caoguangcheng9-lgtm/begapunk-website/images/applications/laser-tube-cutting/laser-tube-rear-chuck-assembly-lineup.webp

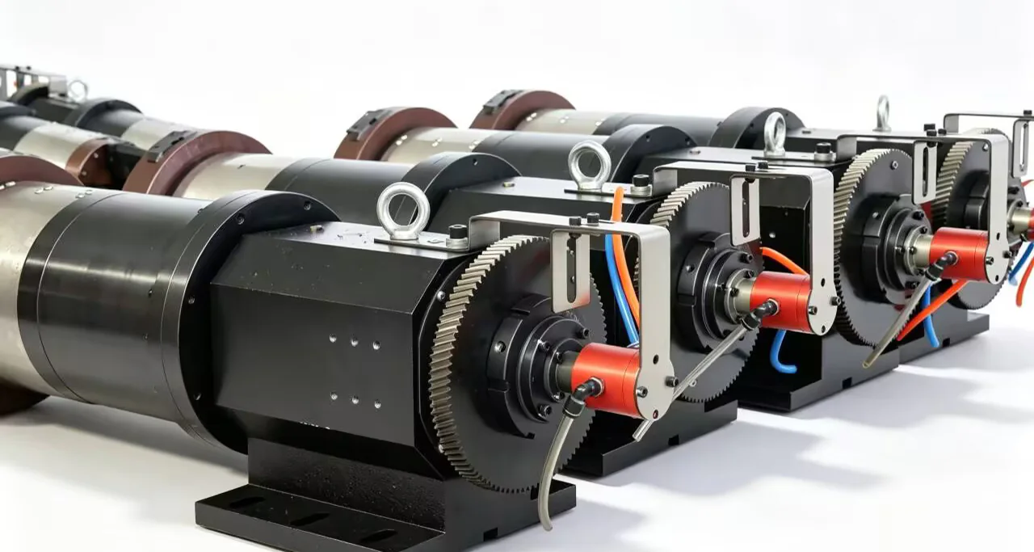
images/applications/laser-tube-cutting/laser-tube-rear-chuck-assembly-lineup.webp
