caoguangcheng9-lgtm/begapunk-website/README.md

# Project: Begapunk Website

Website: https://begapunk.com

Product: Air Rotary Union / Pneumatic Rotary Joint

Goal: Build Begapunk as an air rotary union specialist website for global B2B customers.

## Main Sections

- Home
- Products
- Applications
- Technology
- Knowledge Center
- About
- Contact
