caoguangcheng9-lgtm/begapunk-website/audit/geo-remediation/phase-1c-a2/phase-1c-a2-report.md

# Begapunk GEO Phase 1C-A.2 Report

## Scope

- Starting commit: `10370306e879dcfa0ff9d7f8911efcd6d111674c`
- Branch: `geo-phase-1c-a2-contextual-guidance`
- Formal website pages changed: 5
- Semantic records corrected: 16
- Pages or assets deleted: 0
- Push/deployment: none

## P1B-037 Selection Boundary

**Before:** An integrated pneumatic and electrical solution may be considered when the required air passages and electrical circuits exceed the capacity of a pneumatic-only rotary union.

**After:** A separate pneumatic rotary union and slip ring may be suitable when the pneumatic and electrical functions can be packaged independently and the available installation space supports two components. An integrated pneumatic-electrical solution may be considered when a single compact assembly, coordinated mounting, or a higher combined channel density is required. Final selection depends on the pneumatic passage count, bore requirements, electrical circuits, signal type, speed, installation envelope, and service access.

Result: the independent and integrated solution boundaries are both present without claiming that either is universally better or cheaper.

## Approved Record Changes

| # | Claim | Page | Before | After |
|---:|---|---|---|---|
| 1 | `P1B-037` | `application-automation-rotary-tables.html` | An integrated pneumatic and electrical solution may be considered when the required air passages and electrical circuits exceed the capacity of a pneumatic-only rotary union. | A separate pneumatic rotary union and slip ring may be suitable when the pneumatic and electrical functions can be packaged independently and the available installation space supports two components. An integrated pneumatic-electrical solution may be considered when a single compact assembly, coordinated mounting, or a higher combined channel density is required. Final selection depends on the pneumatic passage count, bore requirements, electrical circuits, signal type, speed, installation envelope, and service access. |
| 2 | `P1B-015` | `application-automation-rotary-tables.html` | <strong>Continuous rotation (PTFE seals):</strong> Set the inspection and replacement interval from actual duty cycle, medium, filtration, temperature, pressure, speed, observed wear, and inspection records. | <strong>Continuous rotation (PTFE seals):</strong> For continuous rotation, establish the inspection and replacement interval from accumulated runtime, operating speed, temperature, medium, leakage trend, operating torque, and seal condition recorded during planned stops. |
| 3 | `P1B-016` | `application-automation-rotary-tables.html` | <strong>Indexing tables (FKM seals):</strong> Set the inspection and replacement interval from actual duty cycle, medium, filtration, temperature, pressure, speed, observed wear, and inspection records. | <strong>Indexing tables (FKM seals):</strong> For indexing service, establish the interval from stop-start cycle count, pressure variation, alignment, temperature, leakage trend, and observed seal wear. |
| 4 | `P1B-017` | `application-automation-rotary-tables.html` | <strong>High-cycle lines (>200 RPM, 24/7):</strong> Set the inspection and replacement interval from actual duty cycle, medium, filtration, temperature, pressure, speed, observed wear, and inspection records. | <strong>High-cycle lines (>200 RPM, 24/7):</strong> For high-speed continuous service, determine inspection frequency from accumulated runtime, actual speed, temperature, leakage trend, torque trend, and planned maintenance records. |
| 5 | `P1B-015` | `application-bottle-filling-capping.html` | <strong>Food-grade PTFE seals:</strong> Set the inspection and replacement interval from actual duty cycle, medium, filtration, temperature, pressure, speed, observed wear, and inspection records. | <strong>Food-grade PTFE seals:</strong> For food-grade PTFE sealing configurations, set the inspection interval from sanitation procedures, medium compatibility, cleaning temperature, operating duty, leakage observations, and documented inspection results. |
| 6 | `P1B-016` | `application-bottle-filling-capping.html` | <strong>Food-grade FKM seals:</strong> Set the inspection and replacement interval from actual duty cycle, medium, filtration, temperature, pressure, speed, observed wear, and inspection records. | <strong>Food-grade FKM seals:</strong> For food-grade FKM sealing configurations, set the interval from the cleaning process, medium, temperature exposure, operating cycles, leakage observations, and documented seal condition. |
| 7 | `P1B-016` | `application-bottle-filling-capping.html` | <strong>Steam sterilization lines:</strong> Set the inspection and replacement interval from actual duty cycle, medium, filtration, temperature, pressure, speed, observed wear, and inspection records. | <strong>Steam sterilization lines:</strong> For steam-sterilized applications, review seal condition in relation to sterilization-cycle count, temperature exposure, medium, pressure, and documented inspection results. |
| 8 | `P1B-015` | `application-packaging-machinery.html` | <strong>PTFE seals:</strong> Set the inspection and replacement interval from actual duty cycle, medium, filtration, temperature, pressure, speed, observed wear, and inspection records. | <strong>PTFE seals:</strong> For PTFE sealing configurations in packaging machinery, determine the interval from machine cycle count, medium, pressure, speed, temperature, leakage trend, and inspection history. |
| 9 | `P1B-016` | `application-packaging-machinery.html` | <strong>FKM seals:</strong> Set the inspection and replacement interval from actual duty cycle, medium, filtration, temperature, pressure, speed, observed wear, and inspection records. | <strong>FKM seals:</strong> For FKM sealing configurations, determine the interval from operating cycles, medium compatibility, temperature, pressure variation, leakage observations, and recorded seal condition. |
| 10 | `P1B-016` | `application-packaging-machinery.html` | <strong>Food-grade lines:</strong> Set the inspection and replacement interval from actual duty cycle, medium, filtration, temperature, pressure, speed, observed wear, and inspection records. | <strong>Food-grade lines:</strong> For food-grade lines, align inspection and replacement decisions with the site's sanitation procedure, operating conditions, contamination-control requirements, and documented inspection results. |
| 11 | `P1B-017` | `application-pneumatic-tools-hose-anti-twist.html` | <strong>High-frequency line (2 shifts, 1,000+ cycles/day):</strong> Set the inspection and replacement interval from actual duty cycle, medium, filtration, temperature, pressure, speed, observed wear, and inspection records. | <strong>High-frequency line (2 shifts, 1,000+ cycles/day):</strong> For high-frequency tool use, base the inspection interval on cycle count, hose movement, side load, swivel torque, contamination, leakage observations, and maintenance records. |
| 12 | `P1B-025` | `application-pneumatic-tools-hose-anti-twist.html` | <strong>8-hour shift, 400–600 cycles/day:</strong> Set the inspection and replacement interval from actual duty cycle, medium, filtration, temperature, pressure, speed, observed wear, and inspection records. | <strong>8-hour shift, 400–600 cycles/day:</strong> For regular shift operation, determine the interval from actual cycle count, task duration, hose routing, side load, swivel movement, leakage observations, and recorded condition. |
| 13 | `P1B-048` | `application-pneumatic-tools-hose-anti-twist.html` | <strong>Maintenance or occasional use:</strong> Set the inspection and replacement interval from actual duty cycle, medium, filtration, temperature, pressure, speed, observed wear, and inspection records. | <strong>Maintenance or occasional use:</strong> For occasional-use tools, inspect the swivel before return to service and determine replacement from storage conditions, contamination, hose load, movement quality, leakage observations, and seal condition. |
| 14 | `P1B-017` | `application-robot-end-of-arm-tooling.html` | <strong>Standard duty (8-hour shift, 30 cycles/min):</strong> Set the inspection and replacement interval from actual duty cycle, medium, filtration, temperature, pressure, speed, observed wear, and inspection records. | <strong>Standard duty (8-hour shift, 30 cycles/min):</strong> For standard robot duty, determine the interval from actual cycle count, wrist motion, hose routing, payload effects, swivel torque, leakage observations, and inspection records. |
| 15 | `P1B-017` | `application-robot-end-of-arm-tooling.html` | <strong>High-cycle lines (24/7, 60 cycles/min):</strong> Set the inspection and replacement interval from actual duty cycle, medium, filtration, temperature, pressure, speed, observed wear, and inspection records. | <strong>High-cycle lines (24/7, 60 cycles/min):</strong> For high-cycle robot duty, determine inspection frequency from accumulated cycles, continuous runtime, wrist motion, temperature, torque trend, leakage trend, and planned maintenance records. |
| 16 | `P1B-039` | `application-robot-end-of-arm-tooling.html` | <strong>Clean assembly (electronics, medical):</strong> Set the inspection and replacement interval from actual duty cycle, medium, filtration, temperature, pressure, speed, observed wear, and inspection records. | <strong>Clean assembly (electronics, medical):</strong> For clean-assembly applications, set the interval from contamination-control procedures, process requirements, operating cycles, leakage observations, and documented inspection results. |

All 15 maintenance entries now retain their application context. No fixed month, hour, service-life guarantee, replacement cycle, or new numeric claim was added. The 15 approved maintenance sentences are unique.

## Browser Rendering Acceptance

- Pages rendered from a server bound only to `127.0.0.1`: 5 / 5.
- Approved changed texts visible: 16 / 16.
- Maintenance lists: three complete and unique entries on each page.
- Horizontal overflow, raw HTML text, and broken images: none.
- FAQ visible/schema mismatches: none.
- Titles, H1 headings, and maintenance sections remained coherent and visible.
- Full-page screenshots rendered successfully for all five pages.

## Unverified Context Labels

- Labels retained but not validated by this phase: 5.
- Numeric fragments include `>200 RPM`, `24/7`, shift counts, cycles/day, and cycles/minute.
- Their retention does not establish accuracy. Each requires engineering records or authoritative industry evidence.
- Details: `unverified-context-labels.csv`.

## Pre-existing JavaScript Errors

- Affected unchanged blog pages: 4.
- Exact error: `SyntaxError: Unexpected token ','` at an orphaned `, 2000);` line in each page's final inline script.
- Visible article content renders, but the affected inline block does not execute; mobile menu and copy-link behavior are impacted, with header scroll styling additionally impacted on three pages.
- These four pages were diagnosed only and were not modified.
- Details: `pre-existing-js-errors.csv`.

## Full-site Protection Validation

- HTML: pass (51 pages).
- JSON-LD: pass (57 blocks).
- Local links, images, and downloads: pass (0 broken).
- FAQ visible content and FAQPage JSON-LD: pass.
- Product Schema: unchanged across all pages.
- Product pressure, speed, temperature, weight, material, and dimensional parameters: unchanged; exact reverse-replacement comparison passed for all five modified pages.
- Company, certification, delivery, and shipment data: unchanged.
- Sitemap: unchanged; 48 URLs.
- Existing fact conflicts: 17, unchanged.
- Formal website files changed outside the approved five pages: 0.
- Deleted pre-task files: 0.

No HTML page, image, PDF, or download file was deleted.
