caoguangcheng9-lgtm/begapunk-website/audit/geo-remediation/phase-1c-a1/phase-1c-a1-report.md

# Begapunk GEO Phase 1C-A.1 Report

## Scope

- Starting commit: `4eaa1e96ea98e54519b1f44b6525b97bcac363bb`
- Branch: `geo-phase-1c-a1-semantic-qa`
- Formal website pages changed: 3
- Pages deleted: 0
- Push/deployment: none

## Three Semantic Corrections

### `BP-2P-30-0001.html` — Product overview

**Phase 1C-A wording:** Pressure and leakage checks are specified by model. Confirm the applicable test pressure, duration, and acceptance criteria with Begapunk before ordering.

**Phase 1C-A.1 wording:** The sealing configuration may be suitable for selected air, water, or coolant applications, subject to medium compatibility, temperature, pressure, speed, and the approved specification for the selected version. Pressure and leakage test conditions should be confirmed before ordering.

Result: restores the medium-compatibility and sealing topic without claiming universal compatibility, zero leakage, or a guarantee.

### `applications.html` — Application guidance

**Phase 1C-A wording:** Pressure and leakage checks are specified by model. Confirm the applicable test pressure, duration, and acceptance criteria with Begapunk before ordering.

**Phase 1C-A.1 wording:** Each channel should be specified with an application-appropriate isolation and allowable cross-port leakage criterion. Confirm the channel-isolation test conditions and acceptance limits for the selected model.

Result: restores channel isolation and cross-port leakage as the engineering topic without inventing a leakage rate.

### `BP-8P-0001.html` — Material FAQ

**Phase 1C-A wording:** Pressure and leakage checks are specified by model. Confirm the applicable test pressure, duration, and acceptance criteria with Begapunk before ordering.

**Phase 1C-A.1 wording:** Seal material, sealing configuration, and pressure-test criteria should be confirmed for the selected version. Test pressure, duration, and acceptance limits may differ by configuration.

Result: restores the version-specific seal/test distinction without reinstating the unsupported common seal, 1.0 MPa, 60-second, or 100% test assertions.

## Real Rendering Acceptance

- Local server binding: `127.0.0.1` only.
- Target pages rendered in the in-app browser: 30 / 30.
- Phase 1C-A records checked in rendered content: 99 / 99.
- Product pages tested through their normal tabs: 16; all expected text became visible and each page retained one active/visible panel.
- FAQ interaction tested: the repair FAQ expanded and its answer was visible.
- Layout/entity/table failures: 0.
- Tab-state failures: 0.
- Lazy-loaded case-study images initially had incomplete state before scrolling; a full-page render loaded all four successfully. No missing image file was found by the source/resource validator.
- Four unchanged blog pages emitted a pre-existing inline JavaScript `SyntaxError: Unexpected token ','` warning during browser QA. Their page content still rendered, and these files are byte-unchanged in this branch; this is recorded for a later JavaScript repair task and was not changed outside scope.

## Visible Content Flag Review

- Phase 1C-A rows marked `visible_content_updated=no`: 12.
- Incorrect flags corrected by this audit: 11.
- Correct schema-only `no` flag retained: 1 (`P1B-059`, FAQPage JSON-LD).
- Detailed evidence: `visible-content-flag-review.csv`.

## Semantic Loss Review

- Records reviewed: 99.
- Approved semantic corrections completed: 3.
- New issue patterns recorded but not modified: 2, affecting 16 records.
- Pattern 1: one combined-utilities record weakens the separate-versus-integrated selection boundary.
- Pattern 2: 15 preventive-maintenance records repeat one generic condition-based sentence and lose entry-specific detail.
- Detailed review: `semantic-loss-review.csv`.

## Source Validation

- HTML: pass (51 pages).
- JSON-LD: pass (57 blocks).
- Local links, images, and downloadable resources: pass (0 broken).
- Product Schema: unchanged on 2 applicable changed product pages.
- Product specification tables: unchanged.
- Sitemap: unchanged; 48 URLs.
- Snapshot deletions: 0.
- Formal page changes outside the three approved pages: 0.

## Protected Facts and Remaining Conflicts

- Product engineering parameters were not changed.
- Certification, company, and delivery-time content was not changed.
- Unsupported absolute zero-leakage/testing promises were not restored.
- The existing 17 fact conflicts remain unresolved and unchanged.
- No HTML page, image, PDF, or download file was deleted.
