caoguangcheng9-lgtm/begapunk-website/audit/geo-remediation/phase-1c-a/phase-1c-a-report.md

# Begapunk GEO Phase 1C-A Report

## Scope Summary

- Modified HTML pages: 30
- Modified allowed claim IDs: 30
- Skipped allowed claim IDs: 0
- Deleted pages: 0
- Detailed replacement records: 99
- Product engineering parameters changed: no
- Certification or company data changed: no
- Delivery-time, return-policy, warranty, sitemap, robots.txt, llms.txt, CSS, JavaScript, PHP, and server configuration changes: none

## Claim-by-Claim Changes

### P1B-004

- Page: `about.html`
- Section: RFQ call to action
- Before: Tell us your requirements and we'll provide a quote within 24 hours.
- After: Begapunk aims to respond promptly to complete technical inquiries. Response time depends on the application complexity and the information provided.
- Visible content updated: yes; FAQ/JSON-LD updated: no

- Page: `case-studies.html`
- Section: RFQ call to action
- Before: Tell us your requirements and we'll provide a quote within 24 hours.
- After: Begapunk aims to respond promptly to complete technical inquiries. Response time depends on the application complexity and the information provided.
- Visible content updated: yes; FAQ/JSON-LD updated: no

- Page: `contact.html`
- Section: RFQ introduction
- Before: Begapunk engineers will check pressure, RPM, media, mounting, passage layout, and reply within 24 hours.
- After: Begapunk aims to respond promptly to complete technical inquiries. Response time depends on the application complexity and the information provided.
- Visible content updated: yes; FAQ/JSON-LD updated: no

- Page: `contact.html`
- Section: Contact method
- Before: Fastest response &mdash; we reply within 24 hours
- After: Begapunk aims to respond promptly to complete technical inquiries. Response time depends on the application complexity and the information provided.
- Visible content updated: no; FAQ/JSON-LD updated: no

- Page: `contact.html`
- Section: RFQ form note
- Before: Typical response time: 24 hours.
- After: Response time depends on the application complexity and the information provided.
- Visible content updated: yes; FAQ/JSON-LD updated: no

- Page: `faq.html`
- Section: Quotation FAQ
- Before: Most quotes are returned within 24 hours.
- After: Begapunk aims to respond promptly to complete technical inquiries. Response time depends on the application complexity and the information provided.
- Visible content updated: yes; FAQ/JSON-LD updated: no

- Page: `faq.html`
- Section: Quotation process
- Before: You send requirements &rarr; We provide a detailed quote within 24 hours
- After: You send complete requirements &rarr; Begapunk reviews the application and responds based on its complexity and the information provided.
- Visible content updated: no; FAQ/JSON-LD updated: no

- Page: `blog-rotary-joint-selection.html`
- Section: Selection guide call to action
- Before: Send us your operating conditions — pressure, RPM, media type, and channel count — and our engineers will return a spec recommendation within 24 hours.
- After: Send us your operating conditions — pressure, RPM, media type, and channel count — for engineering review. Response time depends on the application complexity and the information provided.
- Visible content updated: yes; FAQ/JSON-LD updated: no

### P1B-006

- Page: `BP-1P-0003.html`
- Section: Application fit introduction
- Before: Below are the machine types where this model performs best — and the conditions where you should consider upgrading to a multi-passage joint.
- After: This model may be suitable for the listed applications when its passage count, mounting, medium, pressure, speed, and temperature limits match the machine requirements.
- Visible content updated: yes; FAQ/JSON-LD updated: no

- Page: `BP-1P-0006.html`
- Section: Application fit introduction
- Before: Below are the machine types where this model performs best — and the conditions where you should consider a multi-inlet design.
- After: This model may be suitable for the listed applications when its passage count, mounting, medium, pressure, speed, and temperature limits match the machine requirements.
- Visible content updated: yes; FAQ/JSON-LD updated: no

- Page: `BP-2P-0001.html`
- Section: Application fit introduction
- Before: Below are the machine types where this model performs best — and the conditions where you should consider upgrading to a multi-passage or higher-pressure joint.
- After: This model may be suitable for the listed applications when its passage count, mounting, medium, pressure, speed, and temperature limits match the machine requirements.
- Visible content updated: yes; FAQ/JSON-LD updated: no

- Page: `BP-2P-0002.html`
- Section: Application fit introduction
- Before: Below are the machine types where this model performs best.
- After: This model may be suitable for the listed applications when its passage count, mounting, medium, pressure, speed, and temperature limits match the machine requirements.
- Visible content updated: yes; FAQ/JSON-LD updated: no

- Page: `BP-2P-08-0001.html`
- Section: Application fit introduction
- Before: Below are the machine types where this model performs best.
- After: This model may be suitable for the listed applications when its passage count, mounting, medium, pressure, speed, and temperature limits match the machine requirements.
- Visible content updated: yes; FAQ/JSON-LD updated: no

- Page: `BP-2P-130-0001.html`
- Section: Application fit introduction
- Before: Below are the machine types where this model performs best — and the conditions where you should consider upgrading to a higher-pressure or dust-proof joint.
- After: This model may be suitable for the listed applications when its passage count, mounting, medium, pressure, speed, and temperature limits match the machine requirements.
- Visible content updated: yes; FAQ/JSON-LD updated: no

- Page: `BP-2P-16-0001.html`
- Section: Application fit introduction
- Before: Below are the machine types where this model performs best &mdash; and the conditions where you should consider upgrading to a larger-bore or higher-speed joint.
- After: This model may be suitable for the listed applications when its passage count, mounting, medium, pressure, speed, and temperature limits match the machine requirements.
- Visible content updated: no; FAQ/JSON-LD updated: no

- Page: `BP-2P-30-0001.html`
- Section: Application fit introduction
- Before: Below are the machine types where this model performs best &mdash; and the conditions where you should consider upgrading to a higher-capacity joint.
- After: This model may be suitable for the listed applications when its passage count, mounting, medium, pressure, speed, and temperature limits match the machine requirements.
- Visible content updated: no; FAQ/JSON-LD updated: no

- Page: `BP-2P-50-0001.html`
- Section: Application fit introduction
- Before: Below are the machine types where this model performs best &mdash; and the conditions where you should consider upgrading to a higher-pressure or stainless-steel joint.
- After: This model may be suitable for the listed applications when its passage count, mounting, medium, pressure, speed, and temperature limits match the machine requirements.
- Visible content updated: no; FAQ/JSON-LD updated: no

- Page: `BP-2P-95-0001.html`
- Section: Application fit introduction
- Before: Below are the machine types where this model performs best &mdash; and the conditions where you should consider a custom design.
- After: This model may be suitable for the listed applications when its passage count, mounting, medium, pressure, speed, and temperature limits match the machine requirements.
- Visible content updated: no; FAQ/JSON-LD updated: no

- Page: `BP-3P-0004.html`
- Section: Application fit introduction
- Before: Below are the machine types where this model performs best — and the conditions where you should consider upgrading to a higher-passage or dust-proof joint.
- After: This model may be suitable for the listed applications when its passage count, mounting, medium, pressure, speed, and temperature limits match the machine requirements.
- Visible content updated: yes; FAQ/JSON-LD updated: no

- Page: `BP-3P-0006.html`
- Section: Application fit introduction
- Before: Below are the machine types where this model performs best.
- After: This model may be suitable for the listed applications when its passage count, mounting, medium, pressure, speed, and temperature limits match the machine requirements.
- Visible content updated: yes; FAQ/JSON-LD updated: no

- Page: `BP-3P-0007.html`
- Section: Application fit introduction
- Before: Below are the machine types where this model performs best.
- After: This model may be suitable for the listed applications when its passage count, mounting, medium, pressure, speed, and temperature limits match the machine requirements.
- Visible content updated: yes; FAQ/JSON-LD updated: no

- Page: `BP-4P-30-0001.html`
- Section: Application fit introduction
- Before: Below are the machine types where this model performs best.
- After: This model may be suitable for the listed applications when its passage count, mounting, medium, pressure, speed, and temperature limits match the machine requirements.
- Visible content updated: yes; FAQ/JSON-LD updated: no

- Page: `BP-8P-0001.html`
- Section: Application fit introduction
- Before: Below are the machine types where this model performs best.
- After: This model may be suitable for the listed applications when its passage count, mounting, medium, pressure, speed, and temperature limits match the machine requirements.
- Visible content updated: yes; FAQ/JSON-LD updated: no

### P1B-008

- Page: `BP-1P-0006.html`
- Section: Visible technical specifications
- Before: <tr><th>Leakage</th><td>Zero (100% pressure tested)</td></tr>
- After: <tr><th>Leakage acceptance</th><td>Specified by model; confirm test criteria before ordering.</td></tr>
- Visible content updated: yes; FAQ/JSON-LD updated: no

- Page: `BP-2P-0002.html`
- Section: Visible technical specifications
- Before: <tr><th>Leakage</th><td>Zero (100% pressure tested)</td></tr>
- After: <tr><th>Leakage acceptance</th><td>Specified by model; confirm test criteria before ordering.</td></tr>
- Visible content updated: yes; FAQ/JSON-LD updated: no

- Page: `BP-2P-30-0001.html`
- Section: Visible technical specifications
- Before: <tr><th>Leakage</th><td>Zero (100% pressure tested)</td></tr>
- After: <tr><th>Leakage acceptance</th><td>Specified by model; confirm test criteria before ordering.</td></tr>
- Visible content updated: yes; FAQ/JSON-LD updated: no

- Page: `BP-3P-0007.html`
- Section: Visible technical specifications
- Before: <tr><th>Leakage</th><td>Zero (100% pressure tested)</td></tr>
- After: <tr><th>Leakage acceptance</th><td>Specified by model; confirm test criteria before ordering.</td></tr>
- Visible content updated: yes; FAQ/JSON-LD updated: no

- Page: `BP-3P-S06-0001.html`
- Section: Visible technical specifications
- Before: <tr><th>Leakage</th><td>Zero leakage (100% pressure tested)</td></tr>
- After: <tr><th>Leakage acceptance</th><td>Specified by model; confirm test criteria before ordering.</td></tr>
- Visible content updated: yes; FAQ/JSON-LD updated: no

- Page: `BP-2P-30-0001.html`
- Section: Product overview
- Before: The PTFE composite seal provides chemical resistance across air, water, and coolant media with zero leakage guaranteed from 100% pressure testing.
- After: Pressure and leakage checks are specified by model. Confirm the applicable test pressure, duration, and acceptance criteria with Begapunk before ordering.
- Visible content updated: yes; FAQ/JSON-LD updated: no

- Page: `BP-3P-0007.html`
- Section: Key benefits
- Before: Each unit is 100% pressure tested to zero leakage before shipment, ensuring reliable operation in critical automation cells
- After: Pressure and leakage checks are specified by model. Confirm the applicable test pressure, duration, and acceptance criteria with Begapunk before ordering.
- Visible content updated: yes; FAQ/JSON-LD updated: no

- Page: `BP-3P-0007.html`
- Section: Material FAQ
- Before: Each unit is 100% pressure tested to zero leakage before shipment as part of the custom order process.
- After: Pressure and leakage checks are specified by model. Confirm the applicable test pressure, duration, and acceptance criteria with Begapunk before ordering.
- Visible content updated: yes; FAQ/JSON-LD updated: no

- Page: `applications.html`
- Section: Application guidance
- Before: Each channel must be mechanically isolated with zero leakage tolerance.
- After: Pressure and leakage checks are specified by model. Confirm the applicable test pressure, duration, and acceptance criteria with Begapunk before ordering.
- Visible content updated: yes; FAQ/JSON-LD updated: no

### P1B-009

- Page: `BP-2P-30-0001.html`
- Section: Key benefits
- Before: <strong>Zero leakage from 100% pressure testing:</strong> Every unit is tested at 1.0 MPa before shipment &mdash; no drip, no bubble, no pressure decay
- After: <strong>Model-specific pressure and leakage checks:</strong> Pressure and leakage checks are specified by model. Confirm the applicable test pressure, duration, and acceptance criteria with Begapunk before ordering.
- Visible content updated: no; FAQ/JSON-LD updated: no

- Page: `BP-3P-S06-0001.html`
- Section: Key benefits
- Before: <strong>Zero leakage guarantee:</strong> Every unit is 100% pressure tested before shipment at 1.0 MPa for 60 seconds &mdash; no leaks, no exceptions
- After: <strong>Model-specific pressure and leakage checks:</strong> Pressure and leakage checks are specified by model. Confirm the applicable test pressure, duration, and acceptance criteria with Begapunk before ordering.
- Visible content updated: no; FAQ/JSON-LD updated: no

- Page: `BP-8P-0001.html`
- Section: Material FAQ
- Before: Both versions use the same PTFE composite seal and are 100% pressure tested at 1.0 MPa for 60 seconds before shipment.
- After: Pressure and leakage checks are specified by model. Confirm the applicable test pressure, duration, and acceptance criteria with Begapunk before ordering.
- Visible content updated: yes; FAQ/JSON-LD updated: no

### P1B-011

- Page: `BP-1P-0006.html`
- Section: Installation or misuse example
- Before: Within 48 hours, air leaks at 0.3 MPa from the seal interface.
- After: Incorrect installation or operation outside the specified limits can cause premature leakage. Failure timing depends on alignment, medium, pressure, speed, temperature, and duty cycle.
- Visible content updated: yes; FAQ/JSON-LD updated: no

- Page: `BP-2P-0002.html`
- Section: Installation or misuse example
- Before: Within 48 hours, air leaks at 0.3 MPa from the seal interface.
- After: Incorrect installation or operation outside the specified limits can cause premature leakage. Failure timing depends on alignment, medium, pressure, speed, temperature, and duty cycle.
- Visible content updated: yes; FAQ/JSON-LD updated: no

- Page: `BP-1P-0003.html`
- Section: Installation or misuse example
- Before: Within 48 hours, air leaks at 0.3 MPa.
- After: Incorrect installation or operation outside the specified limits can cause premature leakage. Failure timing depends on alignment, medium, pressure, speed, temperature, and duty cycle.
- Visible content updated: yes; FAQ/JSON-LD updated: no

- Page: `BP-3P-0006.html`
- Section: Installation or misuse example
- Before: Within 48 hours, air leaks at 0.3 MPa.
- After: Incorrect installation or operation outside the specified limits can cause premature leakage. Failure timing depends on alignment, medium, pressure, speed, temperature, and duty cycle.
- Visible content updated: yes; FAQ/JSON-LD updated: no

- Page: `BP-3P-0004.html`
- Section: Installation or misuse example
- Before: The AL6061 flange face warps by 0.08 mm, creating a leak path that sprays air at 0.8 MPa within 48 hours.
- After: Incorrect installation or operation outside the specified limits can cause premature leakage. Failure timing depends on alignment, medium, pressure, speed, temperature, and duty cycle.
- Visible content updated: yes; FAQ/JSON-LD updated: no

- Page: `BP-8P-0001.html`
- Section: Installation or misuse example
- Before: Within 48 hours, air bleeds from passage 3 into passage 5, causing pressure interference and dropped workpieces.
- After: Incorrect installation or operation outside the specified limits can cause premature leakage. Failure timing depends on alignment, medium, pressure, speed, temperature, and duty cycle.
- Visible content updated: yes; FAQ/JSON-LD updated: no

- Page: `BP-4P-30-0001.html`
- Section: Installation or misuse example
- Before: Within 48 hours, air leaks at 0.4 MPa.
- After: Incorrect installation or operation outside the specified limits can cause premature leakage. Failure timing depends on alignment, medium, pressure, speed, temperature, and duty cycle.
- Visible content updated: yes; FAQ/JSON-LD updated: no

- Page: `BP-2P-95-0001.html`
- Section: Installation or misuse example
- Before: Within 48 hours, the seal leaks at 6 MPa.
- After: Incorrect installation or operation outside the specified limits can cause premature leakage. Failure timing depends on alignment, medium, pressure, speed, temperature, and duty cycle.
- Visible content updated: yes; FAQ/JSON-LD updated: no

### P1B-015

- Page: `application-automation-rotary-tables.html`
- Section: Preventive replacement schedule
- Before: <li><strong>Continuous rotation (PTFE seals):</strong> Replace every 10–12 months</li>
- After: <li><strong>Continuous rotation (PTFE seals):</strong> Set the inspection and replacement interval from actual duty cycle, medium, filtration, temperature, pressure, speed, observed wear, and inspection records.</li>
- Visible content updated: yes; FAQ/JSON-LD updated: no

- Page: `application-bottle-filling-capping.html`
- Section: Preventive replacement schedule
- Before: <li><strong>Food-grade PTFE seals:</strong> Replace every 10–12 months on continuous-duty lines</li>
- After: <li><strong>Food-grade PTFE seals:</strong> Set the inspection and replacement interval from actual duty cycle, medium, filtration, temperature, pressure, speed, observed wear, and inspection records.</li>
- Visible content updated: yes; FAQ/JSON-LD updated: no

- Page: `application-packaging-machinery.html`
- Section: Preventive replacement schedule
- Before: <li><strong>PTFE seals:</strong> Replace every 10–12 months on continuous-duty lines</li>
- After: <li><strong>PTFE seals:</strong> Set the inspection and replacement interval from actual duty cycle, medium, filtration, temperature, pressure, speed, observed wear, and inspection records.</li>
- Visible content updated: yes; FAQ/JSON-LD updated: no

### P1B-016

- Page: `application-automation-rotary-tables.html`
- Section: Preventive replacement schedule
- Before: <li><strong>Indexing tables (FKM seals):</strong> Replace every 8–10 months on continuous-duty lines</li>
- After: <li><strong>Indexing tables (FKM seals):</strong> Set the inspection and replacement interval from actual duty cycle, medium, filtration, temperature, pressure, speed, observed wear, and inspection records.</li>
- Visible content updated: yes; FAQ/JSON-LD updated: no

- Page: `application-bottle-filling-capping.html`
- Section: Preventive replacement schedule
- Before: <li><strong>Food-grade FKM seals:</strong> Replace every 6 months (audit requirement)</li>
- After: <li><strong>Food-grade FKM seals:</strong> Set the inspection and replacement interval from actual duty cycle, medium, filtration, temperature, pressure, speed, observed wear, and inspection records.</li>
- Visible content updated: yes; FAQ/JSON-LD updated: no

- Page: `application-bottle-filling-capping.html`
- Section: Preventive replacement schedule
- Before: <li><strong>Steam sterilization lines:</strong> Replace every 6 months regardless of visible wear (thermal fatigue)</li>
- After: <li><strong>Steam sterilization lines:</strong> Set the inspection and replacement interval from actual duty cycle, medium, filtration, temperature, pressure, speed, observed wear, and inspection records.</li>
- Visible content updated: yes; FAQ/JSON-LD updated: no

- Page: `application-packaging-machinery.html`
- Section: Preventive replacement schedule
- Before: <li><strong>FKM seals:</strong> Replace every 6–8 months on continuous-duty lines</li>
- After: <li><strong>FKM seals:</strong> Set the inspection and replacement interval from actual duty cycle, medium, filtration, temperature, pressure, speed, observed wear, and inspection records.</li>
- Visible content updated: yes; FAQ/JSON-LD updated: no

- Page: `application-packaging-machinery.html`
- Section: Preventive replacement schedule
- Before: <li><strong>Food-grade lines:</strong> Replace every 6 months regardless of visible wear (audit requirement)</li>
- After: <li><strong>Food-grade lines:</strong> Set the inspection and replacement interval from actual duty cycle, medium, filtration, temperature, pressure, speed, observed wear, and inspection records.</li>
- Visible content updated: yes; FAQ/JSON-LD updated: no

### P1B-017

- Page: `application-automation-rotary-tables.html`
- Section: Preventive replacement schedule
- Before: <li><strong>High-cycle lines (>200 RPM, 24/7):</strong> Replace every 6–8 months</li>
- After: <li><strong>High-cycle lines (>200 RPM, 24/7):</strong> Set the inspection and replacement interval from actual duty cycle, medium, filtration, temperature, pressure, speed, observed wear, and inspection records.</li>
- Visible content updated: no; FAQ/JSON-LD updated: no

- Page: `application-pneumatic-tools-hose-anti-twist.html`
- Section: Preventive replacement schedule
- Before: <li><strong>High-frequency line (2 shifts, 1,000+ cycles/day):</strong> Replace every 5–6 months</li>
- After: <li><strong>High-frequency line (2 shifts, 1,000+ cycles/day):</strong> Set the inspection and replacement interval from actual duty cycle, medium, filtration, temperature, pressure, speed, observed wear, and inspection records.</li>
- Visible content updated: yes; FAQ/JSON-LD updated: no

- Page: `application-robot-end-of-arm-tooling.html`
- Section: Preventive replacement schedule
- Before: <li><strong>Standard duty (8-hour shift, 30 cycles/min):</strong> Replace every 10–12 months</li>
- After: <li><strong>Standard duty (8-hour shift, 30 cycles/min):</strong> Set the inspection and replacement interval from actual duty cycle, medium, filtration, temperature, pressure, speed, observed wear, and inspection records.</li>
- Visible content updated: yes; FAQ/JSON-LD updated: no

- Page: `application-robot-end-of-arm-tooling.html`
- Section: Preventive replacement schedule
- Before: <li><strong>High-cycle lines (24/7, 60 cycles/min):</strong> Replace every 6–8 months</li>
- After: <li><strong>High-cycle lines (24/7, 60 cycles/min):</strong> Set the inspection and replacement interval from actual duty cycle, medium, filtration, temperature, pressure, speed, observed wear, and inspection records.</li>
- Visible content updated: yes; FAQ/JSON-LD updated: no

### P1B-018

- Page: `application-packaging-machinery.html`
- Section: Cycle-life guidance and FAQ
- Before: Standard duty seals rated for 5,000 hours will fail in 6–8 weeks under this load.
- After: Operating beyond the seal's approved duty conditions can accelerate wear and lead to premature leakage. Actual service life depends on the medium, pressure, speed, temperature, alignment, filtration, and duty cycle.
- Visible content updated: yes; FAQ/JSON-LD updated: yes

- Page: `application-packaging-machinery.html`
- Section: Cycle-life guidance and FAQ
- Before: Standard seals rated for 5,000 hours fail in 6–8 weeks under this load.
- After: Operating beyond the seal's approved duty conditions can accelerate wear and lead to premature leakage. Actual service life depends on the medium, pressure, speed, temperature, alignment, filtration, and duty cycle.
- Visible content updated: yes; FAQ/JSON-LD updated: no

- Page: `application-packaging-machinery.html`
- Section: Cycle-life guidance and FAQ
- Before: Standard FKM seals rated for 5,000 hours will fail in 6–8 weeks.
- After: Operating beyond the seal's approved duty conditions can accelerate wear and lead to premature leakage. Actual service life depends on the medium, pressure, speed, temperature, alignment, filtration, and duty cycle.
- Visible content updated: yes; FAQ/JSON-LD updated: no

- Page: `application-packaging-machinery.html`
- Section: Cycle-life guidance and FAQ
- Before: Standard FKM seals rated for 5,000 hours fail in 6–8 weeks.
- After: Operating beyond the seal's approved duty conditions can accelerate wear and lead to premature leakage. Actual service life depends on the medium, pressure, speed, temperature, alignment, filtration, and duty cycle.
- Visible content updated: yes; FAQ/JSON-LD updated: no

### P1B-020

- Page: `BP-1P-0003.html`
- Section: 3D file FAQ
- Before: We do not post 3D files publicly to protect our designs, but every qualified inquiry receives the file within 24 hours.
- After: 3D files may be provided for qualified projects after the application requirements are reviewed. File availability and response time depend on the model and the project information provided.
- Visible content updated: yes; FAQ/JSON-LD updated: no

- Page: `BP-1P-0006.html`
- Section: 3D file FAQ
- Before: We do not post 3D files publicly to protect our designs, but every qualified inquiry receives the file within 24 hours.
- After: 3D files may be provided for qualified projects after the application requirements are reviewed. File availability and response time depend on the model and the project information provided.
- Visible content updated: yes; FAQ/JSON-LD updated: no

- Page: `BP-2P-0001.html`
- Section: 3D file FAQ
- Before: We do not post 3D files publicly to protect our designs, but every qualified inquiry receives the file within 24 hours.
- After: 3D files may be provided for qualified projects after the application requirements are reviewed. File availability and response time depend on the model and the project information provided.
- Visible content updated: yes; FAQ/JSON-LD updated: no

- Page: `BP-2P-0002.html`
- Section: 3D file FAQ
- Before: We do not post 3D files publicly to protect our designs, but every qualified inquiry receives the file within 24 hours.
- After: 3D files may be provided for qualified projects after the application requirements are reviewed. File availability and response time depend on the model and the project information provided.
- Visible content updated: yes; FAQ/JSON-LD updated: no

- Page: `BP-2P-08-0001.html`
- Section: 3D file FAQ
- Before: We do not post 3D files publicly to protect our designs, but every qualified inquiry receives the file within 24 hours.
- After: 3D files may be provided for qualified projects after the application requirements are reviewed. File availability and response time depend on the model and the project information provided.
- Visible content updated: yes; FAQ/JSON-LD updated: no

- Page: `BP-2P-130-0001.html`
- Section: 3D file FAQ
- Before: We do not post 3D files publicly to protect our designs, but every qualified inquiry receives the file within 24 hours.
- After: 3D files may be provided for qualified projects after the application requirements are reviewed. File availability and response time depend on the model and the project information provided.
- Visible content updated: yes; FAQ/JSON-LD updated: no

- Page: `BP-2P-16-0001.html`
- Section: 3D file FAQ
- Before: We do not post 3D files publicly to protect our designs, but every qualified inquiry receives the file within 24 hours.
- After: 3D files may be provided for qualified projects after the application requirements are reviewed. File availability and response time depend on the model and the project information provided.
- Visible content updated: yes; FAQ/JSON-LD updated: no

- Page: `BP-2P-30-0001.html`
- Section: 3D file FAQ
- Before: We do not post 3D files publicly to protect our designs, but every qualified inquiry receives the file within 24 hours.
- After: 3D files may be provided for qualified projects after the application requirements are reviewed. File availability and response time depend on the model and the project information provided.
- Visible content updated: yes; FAQ/JSON-LD updated: no

- Page: `BP-2P-50-0001.html`
- Section: 3D file FAQ
- Before: We do not post 3D files publicly to protect our designs, but every qualified inquiry receives the file within 24 hours.
- After: 3D files may be provided for qualified projects after the application requirements are reviewed. File availability and response time depend on the model and the project information provided.
- Visible content updated: yes; FAQ/JSON-LD updated: no

- Page: `BP-2P-95-0001.html`
- Section: 3D file FAQ
- Before: We do not post 3D files publicly to protect our designs, but every qualified inquiry receives the file within 24 hours.
- After: 3D files may be provided for qualified projects after the application requirements are reviewed. File availability and response time depend on the model and the project information provided.
- Visible content updated: yes; FAQ/JSON-LD updated: no

- Page: `BP-3P-0004.html`
- Section: 3D file FAQ
- Before: We do not post 3D files publicly to protect our designs, but every qualified inquiry receives the file within 24 hours.
- After: 3D files may be provided for qualified projects after the application requirements are reviewed. File availability and response time depend on the model and the project information provided.
- Visible content updated: yes; FAQ/JSON-LD updated: no

- Page: `BP-3P-0006.html`
- Section: 3D file FAQ
- Before: We do not post 3D files publicly to protect our designs, but every qualified inquiry receives the file within 24 hours.
- After: 3D files may be provided for qualified projects after the application requirements are reviewed. File availability and response time depend on the model and the project information provided.
- Visible content updated: yes; FAQ/JSON-LD updated: no

- Page: `BP-3P-0007.html`
- Section: 3D file FAQ
- Before: We do not post 3D files publicly to protect our designs, but every qualified inquiry receives the file within 24 hours.
- After: 3D files may be provided for qualified projects after the application requirements are reviewed. File availability and response time depend on the model and the project information provided.
- Visible content updated: yes; FAQ/JSON-LD updated: no

- Page: `BP-3P-S06-0001.html`
- Section: 3D file FAQ
- Before: We do not post 3D files publicly to protect our designs, but every qualified inquiry receives the file within 24 hours.
- After: 3D files may be provided for qualified projects after the application requirements are reviewed. File availability and response time depend on the model and the project information provided.
- Visible content updated: yes; FAQ/JSON-LD updated: no

- Page: `BP-4P-30-0001.html`
- Section: 3D file FAQ
- Before: We do not post 3D files publicly to protect our designs, but every qualified inquiry receives the file within 24 hours.
- After: 3D files may be provided for qualified projects after the application requirements are reviewed. File availability and response time depend on the model and the project information provided.
- Visible content updated: yes; FAQ/JSON-LD updated: no

- Page: `BP-8P-0001.html`
- Section: 3D file FAQ
- Before: We do not post 3D files publicly to protect our designs, but every qualified inquiry receives the file within 24 hours.
- After: 3D files may be provided for qualified projects after the application requirements are reviewed. File availability and response time depend on the model and the project information provided.
- Visible content updated: yes; FAQ/JSON-LD updated: no

- Page: `BP-2P-130-0001.html`
- Section: 3D file FAQ
- Before: Custom configurations are modeled on request with the same 24-hour turnaround.
- After: Custom configuration file timing depends on the project review.
- Visible content updated: yes; FAQ/JSON-LD updated: no

- Page: `BP-3P-0004.html`
- Section: 3D file FAQ
- Before: Custom configurations are modeled on request with the same 24-hour turnaround.
- After: Custom configuration file timing depends on the project review.
- Visible content updated: yes; FAQ/JSON-LD updated: no

### P1B-023

- Page: `about.html`
- Section: Quality control
- Before: 1.5× rated pressure, 30 minutes, zero leakage pass.
- After: Pressure and leakage checks are specified by model. Confirm the applicable test pressure, duration, and acceptance criteria with Begapunk before ordering.
- Visible content updated: yes; FAQ/JSON-LD updated: no

### P1B-025

- Page: `application-pneumatic-tools-hose-anti-twist.html`
- Section: Preventive replacement schedule
- Before: <li><strong>8-hour shift, 400–600 cycles/day:</strong> Replace every 8–10 months</li>
- After: <li><strong>8-hour shift, 400–600 cycles/day:</strong> Set the inspection and replacement interval from actual duty cycle, medium, filtration, temperature, pressure, speed, observed wear, and inspection records.</li>
- Visible content updated: yes; FAQ/JSON-LD updated: no

### P1B-026

- Page: `BP-2P-30-0001.html`
- Section: Anti-rotation guidance
- Before: A rigid anti-rotation bracket that clamps the body tightly will transfer vibration to the bearing, reducing bearing life from 8,000 hours to 4,000 hours.
- After: A rigid anti-rotation arrangement that transfers vibration or side load into the housing can increase bearing load and may shorten service life.
- Visible content updated: yes; FAQ/JSON-LD updated: no

### P1B-035

- Page: `application-robot-end-of-arm-tooling.html`
- Section: Compact mounting and cable management
- Before: <strong>Best practice:</strong> Use a flange mount with the air ports facing away from the wrist servo.
- After: A flange mount with ports oriented away from the wrist servo may simplify hose routing and reduce interference. Confirm the final orientation against the robot wrist envelope and motion path.
- Visible content updated: yes; FAQ/JSON-LD updated: no

### P1B-036

- Page: `application-pneumatic-tools-hose-anti-twist.html`
- Section: Tool inlet mounting position
- Before: Mount the swivel as close to the tool body as possible — within 20–30 mm of the grip.
- After: Mount the swivel as close to the tool body as the fitting geometry and operating motion allow.
- Visible content updated: yes; FAQ/JSON-LD updated: no

- Page: `application-pneumatic-tools-hose-anti-twist.html`
- Section: Tool inlet mounting position
- Before: <strong>Best practice:</strong> Use a short, rigid nipple (20–30 mm) between the tool inlet and the swivel.
- After: Use the shortest suitable connection that avoids side load and hose interference. The required nipple length depends on the tool inlet, fitting geometry, and operating motion.
- Visible content updated: yes; FAQ/JSON-LD updated: no

### P1B-037

- Page: `application-automation-rotary-tables.html`
- Section: Combined utilities
- Before: Best when high channel counts (8+ air + 12+ electrical) are needed.
- After: An integrated pneumatic and electrical solution may be considered when the required air passages and electrical circuits exceed the capacity of a pneumatic-only rotary union.
- Visible content updated: yes; FAQ/JSON-LD updated: no

### P1B-038

- Page: `application-automation-rotary-tables.html`
- Section: Combined utilities
- Before: Best when space is limited and channel count is moderate.
- After: A compact integrated design may be suitable where installation space is limited and the required channel count fits the available configuration.
- Visible content updated: yes; FAQ/JSON-LD updated: no

### P1B-039

- Page: `application-robot-end-of-arm-tooling.html`
- Section: Preventive replacement schedule
- Before: <li><strong>Clean assembly (electronics, medical):</strong> Replace every 8–10 months regardless of visible wear</li>
- After: <li><strong>Clean assembly (electronics, medical):</strong> Set the inspection and replacement interval from actual duty cycle, medium, filtration, temperature, pressure, speed, observed wear, and inspection records.</li>
- Visible content updated: yes; FAQ/JSON-LD updated: no

### P1B-040

- Page: `BP-3P-0007.html`
- Section: Product overview
- Before: Designed for compact automation and robot EOAT applications where low idle torque and zero leakage are critical.
- After: Intended for compact automation and robot EOAT applications where low idle torque and leakage control are important.
- Visible content updated: yes; FAQ/JSON-LD updated: no

### P1B-042

- Page: `blog-rotary-joint-materials.html`
- Section: Material selection summary
- Before: <li><strong>Dry air, clean coolant, normal factory</strong> → AL6061, lowest cost, best performance</li>
- After: <li><strong>Dry air, clean non-corrosive media, normal factory:</strong> AL6061 can be a practical body material when pressure, temperature, and corrosion requirements are within the approved limits.</li>
- Visible content updated: yes; FAQ/JSON-LD updated: no

### P1B-043

- Page: `BP-4P-30-0001.html`
- Section: Flange alignment guidance
- Before: <strong>Eccentric mounting &gt;0.2 mm</strong> creates cyclic side load on the seal, causing leak paths within 200 hours of operation.
- After: Excessive eccentricity can create cyclic side load on the seal and increase leakage risk. Confirm the allowable alignment tolerance for the selected model.
- Visible content updated: yes; FAQ/JSON-LD updated: no

### P1B-044

- Page: `blog-threaded-vs-flange.html`
- Section: Common installation errors table
- Before: <tr>
<td>Flange bolt sequence wrong</td>
<td>O-ring extruded on one side, dry on other</td>
<td>1–48 hours</td>
</tr>
- After: <tr>
<td>Incorrect or uneven flange bolt tightening</td>
<td>Seal distortion and uneven sealing load</td>
<td>Premature leakage risk; timing depends on operating conditions</td>
</tr>
- Visible content updated: no; FAQ/JSON-LD updated: no

### P1B-045

- Page: `application-pneumatic-tools-hose-anti-twist.html`
- Section: Handheld tool weight FAQ
- Before: For handheld tools used 8 hours per shift, the swivel should weigh under 0.15 kg to minimize operator fatigue and repetitive strain.
- After: For handheld tools, lower swivel mass can help reduce operator fatigue, but acceptable weight depends on tool balance, hose routing, task duration, and ergonomic assessment.
- Visible content updated: yes; FAQ/JSON-LD updated: yes

### P1B-048

- Page: `application-pneumatic-tools-hose-anti-twist.html`
- Section: Preventive replacement schedule
- Before: <li><strong>Maintenance or occasional use:</strong> Inspect every 12 months, replace every 18–24 months</li>
- After: <li><strong>Maintenance or occasional use:</strong> Set the inspection and replacement interval from actual duty cycle, medium, filtration, temperature, pressure, speed, observed wear, and inspection records.</li>
- Visible content updated: yes; FAQ/JSON-LD updated: no

### P1B-050

- Page: `application-packaging-machinery.html`
- Section: Application fit
- Before: Packaging machinery runs at 60–200 RPM for 16–24 hours per shift.
- After: Packaging machinery duty cycles vary widely. Confirm the actual continuous and intermittent speed, operating hours, and stop-start profile before selecting a rotary union.
- Visible content updated: yes; FAQ/JSON-LD updated: no

### P1B-054

- Page: `BP-2P-95-0001.html`
- Section: Filtration guidance
- Before: The cost of a $40 filter element is negligible compared to a $200 seal kit and 4 hours of downtime.
- After: Appropriate filtration can reduce contamination-related seal wear and help avoid unplanned maintenance. Actual cost impact depends on the application.
- Visible content updated: yes; FAQ/JSON-LD updated: no

### P1B-055

- Page: `BP-3P-0004.html`
- Section: Leakage consequence example
- Before: The oil contaminates the work area and the machine stops for 4 hours.
- After: Oil leakage can contaminate the work area and cause unplanned downtime. The actual impact depends on the machine layout, leak rate, and maintenance response.
- Visible content updated: yes; FAQ/JSON-LD updated: no

### P1B-056

- Page: `BP-3P-0004.html`
- Section: Over-pressure example
- Before: The PTFE seal extrudes under the over-pressure within 72 hours, causing catastrophic leakage across all three passages.
- After: Over-pressure can damage or extrude the seal and may cause cross-port or external leakage. Failure timing depends on the actual pressure, medium, temperature, speed, and duty cycle.
- Visible content updated: yes; FAQ/JSON-LD updated: no

### P1B-058

- Page: `blog-rotary-union-seal-types.html`
- Section: Seal selection conclusion
- Before: The right seal makes the joint disappear into the background of the machine — reliable, quiet, and maintenance-free for years.
- After: An appropriate seal design can support reliable, quiet operation and reduce routine maintenance when used within the specified operating limits.
- Visible content updated: yes; FAQ/JSON-LD updated: no

### P1B-059

- Page: `faq.html`
- Section: Seal replacement FAQPage JSON-LD
- Before: We recommend using only Begapunk seals &mdash; third-party seals may have incorrect material or hardness.
- After: Use replacement seals that match the specified material, hardness, geometry, and surface requirements. Non-equivalent seals may cause premature wear or leakage.
- Visible content updated: no; FAQ/JSON-LD updated: yes

- Page: `faq.html`
- Section: Seal replacement FAQ
- Before: We strongly recommend using only Begapunk seals &mdash; third-party seals may have incorrect durometer (hardness) or material, leading to premature leakage.
- After: Use replacement seals that match the specified material, hardness, geometry, and surface requirements. Non-equivalent seals may cause premature wear or leakage.
- Visible content updated: no; FAQ/JSON-LD updated: no

## Rejected Phase 1B Drafts

### P1B-035

- Original claim: Best practice: Use a flange mount with the air ports facing away from the wrist servo.
- Rejected Phase 1B draft: Draft: This model is a potential starting point for the listed applications when its passage count, mounting, medium, pressure, speed, and temperature limits match the machine requirements.
- Reason: The Phase 1B model-fit template was unrelated to robot wrist port orientation and removed the routing and interference meaning.
- Phase 1C-A disposition: A flange mount with ports oriented away from the wrist servo may simplify hose routing and reduce interference. Confirm the final orientation against the robot wrist envelope and motion path.

### P1B-036

- Original claim: Best practice: Use a short, rigid nipple (20–30 mm) between the tool inlet and the swivel.
- Rejected Phase 1B draft: Draft: This model is a potential starting point for the listed applications when its passage count, mounting, medium, pressure, speed, and temperature limits match the machine requirements.
- Reason: The Phase 1B model-fit template was unrelated to connection length and did not remove the unsupported fixed 20-30 mm rule.
- Phase 1C-A disposition: Use the shortest suitable connection that avoids side load and hose interference. The required nipple length depends on the tool inlet, fitting geometry, and operating motion.

### P1B-040

- Original claim: Designed for compact automation and robot EOAT applications where low idle torque and zero leakage are critical.
- Rejected Phase 1B draft: Draft: Each unit is checked before shipment using Begapunk's documented test procedure. Acceptance criteria and test conditions are available for the applicable model on request.
- Reason: The Phase 1B test-procedure template removed the compact automation, robot EOAT, and low-idle-torque engineering meaning.
- Phase 1C-A disposition: Intended for compact automation and robot EOAT applications where low idle torque and leakage control are important.

### P1B-042

- Original claim: Dry air, clean coolant, normal factory → AL6061, lowest cost, best performance
- Rejected Phase 1B draft: Draft: This model is a potential starting point for the listed applications when its passage count, mounting, medium, pressure, speed, and temperature limits match the machine requirements.
- Reason: The Phase 1B model-fit template was unrelated to material selection and operating-media limits.
- Phase 1C-A disposition: AL6061 can be a practical body material for dry air and some clean, non-corrosive media when pressure, temperature, and corrosion requirements are within the approved limits.

### P1B-046

- Original claim: High-pressure coolant delivery 0.5–2.0 MPa BP-2P-130-0001 (5.0 MPa rated)
- Rejected Phase 1B draft: Draft: Lead time is confirmed with each quotation and depends on model, quantity, customization, and destination.
- Reason: The Phase 1B lead-time template was unrelated to high-pressure coolant suitability. This K4 claim is outside Phase 1C-A.
- Phase 1C-A disposition: Not modified in Phase 1C-A; requires separate engineering evidence and approval.

### P1B-050

- Original claim: Packaging machinery runs at 60–200 RPM for 16–24 hours per shift.
- Rejected Phase 1B draft: Draft: Begapunk aims to respond to complete technical inquiries promptly; response time depends on application complexity and the information provided.
- Reason: The Phase 1B inquiry-response template was unrelated to packaging-machine duty cycle.
- Phase 1C-A disposition: Packaging machinery duty cycles vary widely. Confirm the actual continuous and intermittent speed, operating hours, and stop-start profile before selecting a rotary union.

### P1B-052

- Original claim: Standard models: Return within 30 days of delivery for a full refund, provided the product is unused and in original packaging.
- Rejected Phase 1B draft: Draft: Lead time is confirmed with each quotation and depends on model, quantity, customization, and destination.
- Reason: The Phase 1B lead-time template was unrelated to the returns policy. This K4 claim is outside Phase 1C-A.
- Phase 1C-A disposition: Not modified in Phase 1C-A; requires a separate returns-policy decision.

### P1B-054

- Original claim: The cost of a $40 filter element is negligible compared to a $200 seal kit and 4 hours of downtime.
- Rejected Phase 1B draft: Draft: Remove the exact loss, percentage, or guaranteed outcome until a dated and reviewable case record supports it.
- Reason: The Phase 1B draft was an internal removal instruction rather than publication-ready engineering copy.
- Phase 1C-A disposition: Appropriate filtration can reduce contamination-related seal wear and help avoid unplanned maintenance. Actual cost impact depends on the application.

### P1B-059

- Original claim: We strongly recommend using only Begapunk seals — third-party seals may have incorrect durometer (hardness) or material, leading to premature leakage.
- Rejected Phase 1B draft: Draft: This outcome may occur under the stated conditions, but actual performance depends on the model, installation, medium, pressure, speed, temperature, and duty cycle.
- Reason: The Phase 1B generic outcome template omitted the material, hardness, geometry, and surface-equivalence criteria.
- Phase 1C-A disposition: Use replacement seals that match the specified material, hardness, geometry, and surface requirements. Non-equivalent seals may cause premature wear or leakage.

## Unresolved Protected Claims

- K4 claims left unchanged: 25 (P1B-001, P1B-002, P1B-003, P1B-005, P1B-007, P1B-010, P1B-012, P1B-013, P1B-014, P1B-021, P1B-022, P1B-024, P1B-027, P1B-028, P1B-029, P1B-030, P1B-031, P1B-032, P1B-033, P1B-034, P1B-046, P1B-049, P1B-051, P1B-052, P1B-057)
- K6 claims left unchanged: 4 (P1B-019, P1B-041, P1B-047, P1B-053)
- Exact K4/K6 source-variant counts were compared before and after; no changes were detected.

## Unresolved Cross-Page Fact Conflicts

All 17 Phase 1B conflicts remain unresolved and unchanged:

1. company_name — Company/brand identity: Ningbo Begapunk Pneumatic Components Co., Ltd. vs. Begapunk Precision Machinery
2. certification_scope — ISO 9001: Company quality-management system certified vs. All versions/products are ISO9001 certified
3. certification_scope — CE and RoHS: Blanket CE and RoHS certification vs. No declaration/report file found
4. delivery_time — Standard models: Ships in 7 days vs. 7-14 day delivery worldwide
5. delivery_time — Custom designs: Typical custom lead time 10-14 days vs. 14-21 days or 3 weeks plus shipping
6. test_method — General pre-shipment pressure test: 1.5x rated pressure; one page states 30 minutes vs. 1.0 MPa for 60 seconds
7. test_pressure — BP-2P-95-0001: 12 MPa pre-shipment test; rated 10 MPa vs. 1.5x rated pressure would equal 15 MPa
8. temperature — BP-1P-0003: -20°C to +120°C vs. -20°C to +80°C
9. weight — BP-2P-0001: 0.85 kg vs. 390 g = 0.39 kg
10. model_identity — BP-2P-30-0001: Model BP-2P-30-0001 vs. Internal title BP-3P-30-0001
11. model_identity — BP-2P-95-0001: Model BP-2P-95-0001 vs. Internal title BP-2P-95-0005
12. pressure — BP-2P-95 family: 10 MPa vs. 1 MPa for internally titled BP-2P-95-0005
13. speed — BP-4P-30-0001: 80 RPM vs. 200 RPM
14. weight — BP-2P-50-0001: 4.26 kg vs. 2300 g = 2.30 kg
15. weight — BP-3P-0004: 0.45 kg vs. 490 g = 0.49 kg
16. material — BP-2P-0001: AL6061 body plus 45# steel shaft vs. Material field lists Aluminum Alloy 6061
17. surface_treatment — BP-1P-0003: 45# steel standard; nickel plating recommended/optional vs. Material 45# steel but surface treatment says Anodized (Aluminum)

## Validation

- HTML parse: pass (51 pages)
- JSON-LD parse: pass (57 blocks)
- Product JSON-LD unchanged: true (16 product pages checked)
- FAQ visible content and FAQPage JSON-LD synchronized: true
- Broken local links: 0
- Sitemap unchanged: true; URL count: 48
- K4/K6 unchanged: true
- Targeted unsupported 48-hour, 72-hour, 6-8-week, fixed-maintenance, zero-leakage, and unconditional-response wording was removed from the approved locations.
- No HTML page, product page, image, PDF, or download file was deleted.

## Deployment Status

This phase creates local source changes and audit records only. It has not been pushed, deployed, merged to main, or applied to any server.
