caoguangcheng9-lgtm/begapunk-website/audit/localization/2026-11-08-final-consolidated-editorial-review.md

# Final consolidated localized-content review

reviewedAt: 2026-11-08T08:20:15.055Z
reviewedByRole: AI-assisted technical and target-market semantic reviewer
reviewMethod: Read the complete trusted-baseline-to-final-candidate semantic and LF-normalized diff across DE, FR, JA and RU. The review covers product-fact corrections, installation and lead-time wording, company-identity and registered-address updates, removal of comparative marketing claims, customer-application boundaries, and the final LinkedIn and Facebook company-profile references. Shared footer and structured-data changes were checked once per language and then verified across every affected page. This remains AI-assisted review and does not claim native-speaker or human sign-off.
reviewType: ai-assisted-target-market-semantic-review
semanticReviewPerformed: true
nativeSpeakerReviewPerformed: false
page: all 59 localized pages in each of DE, FR, JA and RU
language: de, fr, ja, ru
referenceUrls: ["https://www.linkedin.com/company/144021127/","https://www.facebook.com/profile.php?id=61595481363231"]
referenceAccessDates: ["2026-11-08","2026-11-08"]
terminologyDecisions: ["Technical product terminology remains aligned with the English source and drawing-backed facts; no unsupported certification, rating, price, availability or service-life claim was introduced.","Company identity, registered address, USCC and registration number remain consistent across all five languages and are presented as legal identity rather than factory-location evidence.","Footer company profiles use the Begapunk LinkedIn company page and Facebook company profile in every language; the founder Person schema retains the founder personal LinkedIn profile.","Lead-time and commercial wording keeps production timing separate from shipping and leaves deposit, balance and payment timing to the formal quotation and accepted order."]
searchIntentDecisions: ["Product, application and technical-support terminology targets the buyer intent represented by each page without adding keyword stuffing or competitor claims.","Social navigation now identifies the company accounts, while page titles and structured data continue to describe the actual products and applications shown."]
unresolvedIssues: []
blockingIssues: []
reviewedArtifactPaths: ["de/index.html","de/about.html","de/manufacturing-quality.html","de/production-inspection-testing.html","de/products.html","de/product-comparison.html","de/BP-1P-0003.html","de/BP-1P-0006.html","de/BP-2P-0001.html","de/BP-2P-0002.html","de/BP-2P-08-0001.html","de/BP-2P-130-0001.html","de/BP-2P-16-0001.html","de/BP-2P-30-0001.html","de/BP-2P-50-0001.html","de/BP-2P-95-0005.html","de/BP-3P-0004.html","de/BP-3P-0006.html","de/BP-3P-0007.html","de/BP-3P-S06-0001.html","de/BP-4P-30-0001.html","de/BP-8P-0001.html","de/applications.html","de/application-automation-rotary-tables.html","de/application-bottle-filling-capping.html","de/application-cnc-pneumatic-clamping.html","de/application-electronics-battery-test-fixtures.html","de/application-laser-tube-cutting.html","de/application-packaging-machinery.html","de/application-pneumatic-tools-hose-anti-twist.html","de/application-robot-end-of-arm-tooling.html","de/application-steel-dusty-environments.html","de/application-textile-printing-converting.html","de/application-vacuum-packaging-machines.html","de/application-welding-positioners.html","de/custom-hydraulic-rotary-unions.html","de/installation.html","de/blog.html","de/blog-ptfe-coated-o-rings.html","de/blog-non-contact-clearance-seal-rotary-union.html","de/blog-rotary-joint-installation-mistakes.html","de/blog-rotary-joint-leaking.html","de/blog-rotary-joint-materials.html","de/blog-rotary-joint-selection.html","de/blog-rotary-union-seal-types.html","de/blog-seal-replacement.html","de/blog-threaded-vs-flange.html","de/case-studies.html","de/case-bp-2p-95-pneumatic-chuck-integration.html","de/case-bp-3p-s06-sensor-monitored-chuck.html","de/faq.html","de/contact.html","de/search.html","de/privacy.html","de/terms.html","de/thank-you.html","de/404.html","de/BP-10P-0001.html","de/blog-prevent-air-hose-twisting.html","fr/index.html","fr/about.html","fr/manufacturing-quality.html","fr/production-inspection-testing.html","fr/products.html","fr/product-comparison.html","fr/BP-1P-0003.html","fr/BP-1P-0006.html","fr/BP-2P-0001.html","fr/BP-2P-0002.html","fr/BP-2P-08-0001.html","fr/BP-2P-130-0001.html","fr/BP-2P-16-0001.html","fr/BP-2P-30-0001.html","fr/BP-2P-50-0001.html","fr/BP-2P-95-0005.html","fr/BP-3P-0004.html","fr/BP-3P-0006.html","fr/BP-3P-0007.html","fr/BP-3P-S06-0001.html","fr/BP-4P-30-0001.html","fr/BP-8P-0001.html","fr/applications.html","fr/application-automation-rotary-tables.html","fr/application-bottle-filling-capping.html","fr/application-cnc-pneumatic-clamping.html","fr/application-electronics-battery-test-fixtures.html","fr/application-laser-tube-cutting.html","fr/application-packaging-machinery.html","fr/application-pneumatic-tools-hose-anti-twist.html","fr/application-robot-end-of-arm-tooling.html","fr/application-steel-dusty-environments.html","fr/application-textile-printing-converting.html","fr/application-vacuum-packaging-machines.html","fr/application-welding-positioners.html","fr/custom-hydraulic-rotary-unions.html","fr/installation.html","fr/blog.html","fr/blog-ptfe-coated-o-rings.html","fr/blog-non-contact-clearance-seal-rotary-union.html","fr/blog-rotary-joint-installation-mistakes.html","fr/blog-rotary-joint-leaking.html","fr/blog-rotary-joint-materials.html","fr/blog-rotary-joint-selection.html","fr/blog-rotary-union-seal-types.html","fr/blog-seal-replacement.html","fr/blog-threaded-vs-flange.html","fr/case-studies.html","fr/case-bp-2p-95-pneumatic-chuck-integration.html","fr/case-bp-3p-s06-sensor-monitored-chuck.html","fr/faq.html","fr/contact.html","fr/search.html","fr/privacy.html","fr/terms.html","fr/thank-you.html","fr/404.html","fr/BP-10P-0001.html","fr/blog-prevent-air-hose-twisting.html","ja/index.html","ja/about.html","ja/manufacturing-quality.html","ja/production-inspection-testing.html","ja/products.html","ja/product-comparison.html","ja/BP-1P-0003.html","ja/BP-1P-0006.html","ja/BP-2P-0001.html","ja/BP-2P-0002.html","ja/BP-2P-08-0001.html","ja/BP-2P-130-0001.html","ja/BP-2P-16-0001.html","ja/BP-2P-30-0001.html","ja/BP-2P-50-0001.html","ja/BP-2P-95-0005.html","ja/BP-3P-0004.html","ja/BP-3P-0006.html","ja/BP-3P-0007.html","ja/BP-3P-S06-0001.html","ja/BP-4P-30-0001.html","ja/BP-8P-0001.html","ja/applications.html","ja/application-automation-rotary-tables.html","ja/application-bottle-filling-capping.html","ja/application-cnc-pneumatic-clamping.html","ja/application-electronics-battery-test-fixtures.html","ja/application-laser-tube-cutting.html","ja/application-packaging-machinery.html","ja/application-pneumatic-tools-hose-anti-twist.html","ja/application-robot-end-of-arm-tooling.html","ja/application-steel-dusty-environments.html","ja/application-textile-printing-converting.html","ja/application-vacuum-packaging-machines.html","ja/application-welding-positioners.html","ja/custom-hydraulic-rotary-unions.html","ja/installation.html","ja/blog.html","ja/blog-ptfe-coated-o-rings.html","ja/blog-non-contact-clearance-seal-rotary-union.html","ja/blog-rotary-joint-installation-mistakes.html","ja/blog-rotary-joint-leaking.html","ja/blog-rotary-joint-materials.html","ja/blog-rotary-joint-selection.html","ja/blog-rotary-union-seal-types.html","ja/blog-seal-replacement.html","ja/blog-threaded-vs-flange.html","ja/case-studies.html","ja/case-bp-2p-95-pneumatic-chuck-integration.html","ja/case-bp-3p-s06-sensor-monitored-chuck.html","ja/faq.html","ja/contact.html","ja/search.html","ja/privacy.html","ja/terms.html","ja/thank-you.html","ja/404.html","ja/BP-10P-0001.html","ja/blog-prevent-air-hose-twisting.html","ru/index.html","ru/about.html","ru/manufacturing-quality.html","ru/production-inspection-testing.html","ru/products.html","ru/product-comparison.html","ru/BP-1P-0003.html","ru/BP-1P-0006.html","ru/BP-2P-0001.html","ru/BP-2P-0002.html","ru/BP-2P-08-0001.html","ru/BP-2P-130-0001.html","ru/BP-2P-16-0001.html","ru/BP-2P-30-0001.html","ru/BP-2P-50-0001.html","ru/BP-2P-95-0005.html","ru/BP-3P-0004.html","ru/BP-3P-0006.html","ru/BP-3P-0007.html","ru/BP-3P-S06-0001.html","ru/BP-4P-30-0001.html","ru/BP-8P-0001.html","ru/applications.html","ru/application-automation-rotary-tables.html","ru/application-bottle-filling-capping.html","ru/application-cnc-pneumatic-clamping.html","ru/application-electronics-battery-test-fixtures.html","ru/application-laser-tube-cutting.html","ru/application-packaging-machinery.html","ru/application-pneumatic-tools-hose-anti-twist.html","ru/application-robot-end-of-arm-tooling.html","ru/application-steel-dusty-environments.html","ru/application-textile-printing-converting.html","ru/application-vacuum-packaging-machines.html","ru/application-welding-positioners.html","ru/custom-hydraulic-rotary-unions.html","ru/installation.html","ru/blog.html","ru/blog-ptfe-coated-o-rings.html","ru/blog-non-contact-clearance-seal-rotary-union.html","ru/blog-rotary-joint-installation-mistakes.html","ru/blog-rotary-joint-leaking.html","ru/blog-rotary-joint-materials.html","ru/blog-rotary-joint-selection.html","ru/blog-rotary-union-seal-types.html","ru/blog-seal-replacement.html","ru/blog-threaded-vs-flange.html","ru/case-studies.html","ru/case-bp-2p-95-pneumatic-chuck-integration.html","ru/case-bp-3p-s06-sensor-monitored-chuck.html","ru/faq.html","ru/contact.html","ru/search.html","ru/privacy.html","ru/terms.html","ru/thank-you.html","ru/404.html","ru/BP-10P-0001.html","ru/blog-prevent-air-hose-twisting.html"]
reviewedArtifactTransitions: [{"path":"de/index.html","beforeSemanticSha256":"27aaa9a245feee6e021f0a3c20d10721e4ad55019002f97c95a87a665fbbc54b","afterSemanticSha256":"473cede81d1f6b8aa86ee1ee5b3e9ad47b5de48c4297bd46452a3bc311f92a96","beforeMechanicalSha256":"6f8c7864a42205af4b19e8e3492fbb5a27d15fb703d74716c421da2a861593f9","afterMechanicalSha256":"6a48335ebfd10a2c06bfb9a28744ec16366eeb66b2dec664f993f00fc69a5c47"},{"path":"de/about.html","beforeSemanticSha256":"0a515cd6fff08930bb1afe3b81729de4b798b5abd2fd6e8d8ec7ec3374dd9651","afterSemanticSha256":"e84190293cecc22ac9c7bca9525d35d975a39bf1e2d6c02dd58ed9dfe65cb309","beforeMechanicalSha256":"56915e662a30789f310dfe1634f308b0c3ba107a72f986207ed3d6c0116b1a82","afterMechanicalSha256":"5f3fc7492a058b1fd2b0bc330e74653c61dcadcfc0c350e9b6d169d08765fbee"},{"path":"de/manufacturing-quality.html","beforeSemanticSha256":"5d4aac9e9de5ef09b724beb869b1accc790c0967a080e4897da44f26cf1915b3","afterSemanticSha256":"f71bdd6e043aef83808255f63336e76b8c7cf349bd214d4d057ae03975e60a64","beforeMechanicalSha256":"8d68eec7d0ee975d86076d9be32a62accc398c61681c805ae0dc0f52255989b2","afterMechanicalSha256":"818c9b619bd4cf632ba5405221e70c22de280b1a57b16d3e46314af908949378"},{"path":"de/production-inspection-testing.html","beforeSemanticSha256":"2bfec4440c07e523150bc3190525e4f33a27bb3593cfbe5f17f4a6b803603619","afterSemanticSha256":"ffa1987e92f47704cb9428fcc188c970c72d023810a8978afb885b07a2265c62","beforeMechanicalSha256":"cd78aeb160301cbed8f36274082ad6b71c7f99b3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

## Result

No blocking semantic issue was identified. Known product-fact items explicitly deferred by the site owner remain unchanged and are not represented as resolved by this review.
