caoguangcheng9-lgtm/begapunk-website/audit/localization/2026-11-08-sitewide-consistency-release-review.md

# Sitewide consistency and release-copy semantic review

reviewedAt: 2026-11-08T06:48:52.734Z
reviewedByRole: AI-assisted technical and target-market semantic reviewer
reviewMethod: Compared the complete governed baseline-to-candidate semantic and LF-normalized diff for every changed DE/FR/JA/RU page. Read every changed title, metadata field, visible heading, body sentence, button, footer/address/company-identity statement, FAQ answer, technical summary and structured-data text; checked the corresponding English source and drawing-backed facts; preserved review of untouched content. The review is AI-assisted and does not claim native-speaker or human sign-off.
reviewType: ai-assisted-target-market-semantic-review
semanticReviewPerformed: true
nativeSpeakerReviewPerformed: false
reviewBaselineRef: 0d3cbe35bdff2d10c8096a456fabd70c006f5872
referenceUrls: ["https://schunk.com/de/de/automatisierungstechnik/drehdurchfuehrungen/ddf-2/ddf-2-125-p4-e10/p/000000000000323137","https://www.festo.com/de/de/c/produkte/druckluftaufbereitung-id_pim31/","https://schunk.com/fr/fr/technologie-d-automatisation/joint-tournant/c/PUB_8326","https://www.festo.com/fr/fr/e/blog/in-practice/comment-fonctionne-une-unite-de-traitement-d-air-id_4074291","https://www.iso.org/fr/standard/67985.html","https://www.ckd.co.jp/kiki/jp/product/detail/424/RJF","https://www.smcworld.com/webcatalog/ja-jp/air-preparation-equipment/","https://www.iso.org/ru/standard/67985.html"]
referenceAccessDates: ["2026-11-04","2026-11-04","2026-11-04","2026-11-04","2026-11-04","2026-11-04","2026-11-04","2026-11-04"]
terminologyDecisions: ["DE retains Drehdurchführung, Fertigungszeit, Eingetragene Geschäftsadresse and localized legal labels consistently across all affected pages.","FR retains raccord tournant, délai de production, Adresse du siège social, and natural commercial terminology; product and interface terms remain explicit.","JA retains ロータリージョイント, 製作期間, 登記上の所在地, 流路 and 取付 terminology consistently without adding capability claims.","RU retains вращающееся соединение, срок производства, Юридический адрес, каналы and проходы terminology consistently.","Shared port-thread, mounting-interface, pressure, speed, temperature, material, seal, weight and ordering language remains aligned with the existing product pages and drawing-backed facts; no unsupported certification, rating or service-life claim was added.","Company identity, registered address, USCC and registration number were reviewed as legal identity text only; the address is not described as a factory location."]
searchIntentDecisions: ["Homepage application cards now describe customer installation and use instead of a vague verified-photo claim, while retaining the requirement to confirm circuit count and interfaces.","Product comparison and product-detail copy distinguishes media-port threads from mounting interfaces so buyers can evaluate both independently.","Lead-time and payment wording retains the same 20/30-day policy and shifts final commercial terms to the quotation and accepted order.","The catalog count is consistently 17, while drawing-backed statements about 16 reviewed drawings remain scoped to drawing coverage rather than total catalog size.","No keyword stuffing, competitor comparison, ranking claim or unverified buyer outcome was introduced."]
unresolvedIssues: []
blockingIssues: []
reviewedArtifactPaths: ["de/index.html","de/about.html","de/manufacturing-quality.html","de/production-inspection-testing.html","de/products.html","de/product-comparison.html","de/BP-1P-0003.html","de/BP-1P-0006.html","de/BP-2P-0001.html","de/BP-2P-0002.html","de/BP-2P-08-0001.html","de/BP-2P-130-0001.html","de/BP-2P-16-0001.html","de/BP-2P-30-0001.html","de/BP-2P-50-0001.html","de/BP-2P-95-0005.html","de/BP-3P-0004.html","de/BP-3P-0006.html","de/BP-3P-0007.html","de/BP-3P-S06-0001.html","de/BP-4P-30-0001.html","de/BP-8P-0001.html","de/applications.html","de/application-automation-rotary-tables.html","de/application-bottle-filling-capping.html","de/application-cnc-pneumatic-clamping.html","de/application-electronics-battery-test-fixtures.html","de/application-laser-tube-cutting.html","de/application-packaging-machinery.html","de/application-pneumatic-tools-hose-anti-twist.html","de/application-robot-end-of-arm-tooling.html","de/application-steel-dusty-environments.html","de/application-textile-printing-converting.html","de/application-vacuum-packaging-machines.html","de/application-welding-positioners.html","de/custom-hydraulic-rotary-unions.html","de/installation.html","de/blog.html","de/blog-ptfe-coated-o-rings.html","de/blog-non-contact-clearance-seal-rotary-union.html","de/blog-rotary-joint-installation-mistakes.html","de/blog-rotary-joint-leaking.html","de/blog-rotary-joint-materials.html","de/blog-rotary-joint-selection.html","de/blog-rotary-union-seal-types.html","de/blog-seal-replacement.html","de/blog-threaded-vs-flange.html","de/case-studies.html","de/case-bp-2p-95-pneumatic-chuck-integration.html","de/case-bp-3p-s06-sensor-monitored-chuck.html","de/faq.html","de/contact.html","de/search.html","de/privacy.html","de/terms.html","de/thank-you.html","de/404.html","de/BP-10P-0001.html","de/blog-prevent-air-hose-twisting.html","fr/index.html","fr/about.html","fr/manufacturing-quality.html","fr/production-inspection-testing.html","fr/products.html","fr/product-comparison.html","fr/BP-1P-0003.html","fr/BP-1P-0006.html","fr/BP-2P-0001.html","fr/BP-2P-0002.html","fr/BP-2P-08-0001.html","fr/BP-2P-130-0001.html","fr/BP-2P-16-0001.html","fr/BP-2P-30-0001.html","fr/BP-2P-50-0001.html","fr/BP-2P-95-0005.html","fr/BP-3P-0004.html","fr/BP-3P-0006.html","fr/BP-3P-0007.html","fr/BP-3P-S06-0001.html","fr/BP-4P-30-0001.html","fr/BP-8P-0001.html","fr/applications.html","fr/application-automation-rotary-tables.html","fr/application-bottle-filling-capping.html","fr/application-cnc-pneumatic-clamping.html","fr/application-electronics-battery-test-fixtures.html","fr/application-laser-tube-cutting.html","fr/application-packaging-machinery.html","fr/application-pneumatic-tools-hose-anti-twist.html","fr/application-robot-end-of-arm-tooling.html","fr/application-steel-dusty-environments.html","fr/application-textile-printing-converting.html","fr/application-vacuum-packaging-machines.html","fr/application-welding-positioners.html","fr/custom-hydraulic-rotary-unions.html","fr/installation.html","fr/blog.html","fr/blog-ptfe-coated-o-rings.html","fr/blog-non-contact-clearance-seal-rotary-union.html","fr/blog-rotary-joint-installation-mistakes.html","fr/blog-rotary-joint-leaking.html","fr/blog-rotary-joint-materials.html","fr/blog-rotary-joint-selection.html","fr/blog-rotary-union-seal-types.html","fr/blog-seal-replacement.html","fr/blog-threaded-vs-flange.html","fr/case-studies.html","fr/case-bp-2p-95-pneumatic-chuck-integration.html","fr/case-bp-3p-s06-sensor-monitored-chuck.html","fr/faq.html","fr/contact.html","fr/search.html","fr/privacy.html","fr/terms.html","fr/thank-you.html","fr/404.html","fr/BP-10P-0001.html","fr/blog-prevent-air-hose-twisting.html","ja/index.html","ja/about.html","ja/manufacturing-quality.html","ja/production-inspection-testing.html","ja/products.html","ja/product-comparison.html","ja/BP-1P-0003.html","ja/BP-1P-0006.html","ja/BP-2P-0001.html","ja/BP-2P-0002.html","ja/BP-2P-08-0001.html","ja/BP-2P-130-0001.html","ja/BP-2P-16-0001.html","ja/BP-2P-30-0001.html","ja/BP-2P-50-0001.html","ja/BP-2P-95-0005.html","ja/BP-3P-0004.html","ja/BP-3P-0006.html","ja/BP-3P-0007.html","ja/BP-3P-S06-0001.html","ja/BP-4P-30-0001.html","ja/BP-8P-0001.html","ja/applications.html","ja/application-automation-rotary-tables.html","ja/application-bottle-filling-capping.html","ja/application-cnc-pneumatic-clamping.html","ja/application-electronics-battery-test-fixtures.html","ja/application-laser-tube-cutting.html","ja/application-packaging-machinery.html","ja/application-pneumatic-tools-hose-anti-twist.html","ja/application-robot-end-of-arm-tooling.html","ja/application-steel-dusty-environments.html","ja/application-textile-printing-converting.html","ja/application-vacuum-packaging-machines.html","ja/application-welding-positioners.html","ja/custom-hydraulic-rotary-unions.html","ja/installation.html","ja/blog.html","ja/blog-ptfe-coated-o-rings.html","ja/blog-non-contact-clearance-seal-rotary-union.html","ja/blog-rotary-joint-installation-mistakes.html","ja/blog-rotary-joint-leaking.html","ja/blog-rotary-joint-materials.html","ja/blog-rotary-joint-selection.html","ja/blog-rotary-union-seal-types.html","ja/blog-seal-replacement.html","ja/blog-threaded-vs-flange.html","ja/case-studies.html","ja/case-bp-2p-95-pneumatic-chuck-integration.html","ja/case-bp-3p-s06-sensor-monitored-chuck.html","ja/faq.html","ja/contact.html","ja/search.html","ja/privacy.html","ja/terms.html","ja/thank-you.html","ja/404.html","ja/BP-10P-0001.html","ja/blog-prevent-air-hose-twisting.html","ru/index.html","ru/about.html","ru/manufacturing-quality.html","ru/production-inspection-testing.html","ru/products.html","ru/product-comparison.html","ru/BP-1P-0003.html","ru/BP-1P-0006.html","ru/BP-2P-0001.html","ru/BP-2P-0002.html","ru/BP-2P-08-0001.html","ru/BP-2P-130-0001.html","ru/BP-2P-16-0001.html","ru/BP-2P-30-0001.html","ru/BP-2P-50-0001.html","ru/BP-2P-95-0005.html","ru/BP-3P-0004.html","ru/BP-3P-0006.html","ru/BP-3P-0007.html","ru/BP-3P-S06-0001.html","ru/BP-4P-30-0001.html","ru/BP-8P-0001.html","ru/applications.html","ru/application-automation-rotary-tables.html","ru/application-bottle-filling-capping.html","ru/application-cnc-pneumatic-clamping.html","ru/application-electronics-battery-test-fixtures.html","ru/application-laser-tube-cutting.html","ru/application-packaging-machinery.html","ru/application-pneumatic-tools-hose-anti-twist.html","ru/application-robot-end-of-arm-tooling.html","ru/application-steel-dusty-environments.html","ru/application-textile-printing-converting.html","ru/application-vacuum-packaging-machines.html","ru/application-welding-positioners.html","ru/custom-hydraulic-rotary-unions.html","ru/installation.html","ru/blog.html","ru/blog-ptfe-coated-o-rings.html","ru/blog-non-contact-clearance-seal-rotary-union.html","ru/blog-rotary-joint-installation-mistakes.html","ru/blog-rotary-joint-leaking.html","ru/blog-rotary-joint-materials.html","ru/blog-rotary-joint-selection.html","ru/blog-rotary-union-seal-types.html","ru/blog-seal-replacement.html","ru/blog-threaded-vs-flange.html","ru/case-studies.html","ru/case-bp-2p-95-pneumatic-chuck-integration.html","ru/case-bp-3p-s06-sensor-monitored-chuck.html","ru/faq.html","ru/contact.html","ru/search.html","ru/privacy.html","ru/terms.html","ru/thank-you.html","ru/404.html","ru/BP-10P-0001.html","ru/blog-prevent-air-hose-twisting.html"]
reviewedArtifactTransitions: [{"path":"de/index.html","beforeSemanticSha256":"27aaa9a245feee6e021f0a3c20d10721e4ad55019002f97c95a87a665fbbc54b","beforeMechanicalSha256":"6f8c7864a42205af4b19e8e3492fbb5a27d15fb703d74716c421da2a861593f9","afterSemanticSha256":"ec7a1e17e2d7dd9482dd4b89e1e386aa68c69dd2200323b54b33fb0e1b770ffd","afterMechanicalSha256":"84c45533ab386f0bd08a773058eef3fa7d3ae530d655c884cb5aa378f1738030"},{"path":"de/about.html","beforeSemanticSha256":"0a515cd6fff08930bb1afe3b81729de4b798b5abd2fd6e8d8ec7ec3374dd9651","beforeMechanicalSha256":"56915e662a30789f310dfe1634f308b0c3ba107a72f986207ed3d6c0116b1a82","afterSemanticSha256":"740b2728593f3c6c103ddb6b9822c61f0560209695e412fd757d4b30d8e7b861","afterMechanicalSha256":"83eb3ae0a9eadd873f3bca4d12796cc0d17eeb9a87da283ad03b22bd12d9ec50"},{"path":"de/manufacturing-quality.html","beforeSemanticSha256":"5d4aac9e9de5ef09b724beb869b1accc790c0967a080e4897da44f26cf1915b3","beforeMechanicalSha256":"8d68eec7d0ee975d86076d9be32a62accc398c61681c805ae0dc0f52255989b2","afterSemanticSha256":"30bd6ea8f4bd5727d1fc8117caa35616b93ed1bad8f2ce8239bdadbbe2dc069d","afterMechanicalSha256":"a42277c6cfc093d6f73cf18b3ff61b8e9f89fc52889e7a927b4f30c89a327344"},{"path":"de/production-inspection-testing.html","beforeSemanticSha256":"2bfec4440c07e523150bc3190525e4f33a27bb3593cfbe5f17f4a6b803603619","beforeMechanicalSha256":"cd78aeb160301cbed8f36274082ad6b71c7f99b3ecefd2dcabe734ef6fb2fc3b","afterSemanticSha256":"587043d514cae2942943414d9ead5f2964310f7e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

## Result

No blocking semantic issue was identified in the reviewed changes. Known product fact items explicitly deferred by the site owner remain separately documented and are not reclassified as resolved by this review.
