caoguangcheng9-lgtm/begapunk-website/audit/localization/2026-09-18-consolidated-footer-selection-review.md

# Consolidated localized delta review - 2026-09-18

reviewedAt: 2026-09-18T12:04:13+00:00
reviewedByRole: Codex AI technical-localization reviewer
reviewMethod: Bounded semantic-delta review against deployed Git baseline, footer variants and existing scoped title/catalog evidence; exact per-artifact transitions
reviewType: ai-assisted-target-market-semantic-review
semanticReviewPerformed: true
nativeSpeakerReviewPerformed: false
referenceUrls: ["https://rotarysystems.com/rotary-unionsmultiple-passage/","https://www.deublin.eu/tl_files/pdf/catalog/multipassage_union/D.pdf","https://www.deublin.com/fr/produits/unions-rotatives/multimedia","https://www.smcworld.com/assets/manual/ja-jp/files/MQR-OML0001.pdf","https://www.precise-rotation.ru/Deublin/obshhij_obzor-rotacionnye_soedinenija_deublin-rus.pdf","https://www.moog.com/products/fluid-rotary-union/","https://developers.google.com/search/docs/fundamentals/creating-helpful-content"]
referenceAccessDates: ["2026-09-18","2026-09-18","2026-09-18","2026-09-18","2026-09-18","2026-09-18","2026-09-18"]
terminologyDecisions: ["Retain industrial DE Drehdurchfuehrungen, FR raccords tournants, JA rotary-joint terminology and RU rotating-connection terminology in unified footer.","Catalog terminology decisions and 14 reviewed strings per locale are documented in 2026-09-18-catalog-selection-review.md; terminology references do not establish Begapunk product ratings.","Keep legal company name and contact destinations unchanged; contact-page footer intentionally omits redundant quote CTA."]
searchIntentDecisions: ["Use catalog selection paths for multi-passage, through-bore and pneumatic-electric requirements; link to existing matching product and application pages.","Five-step leaking-guide title matches actual article structure; related-link labels match corrected title.","Four footer groups expose products, applications, production quality and support consistently; no keyword stuffing or invented specifications."]
unresolvedIssues: []
blockingIssues: []
reviewedArtifactPaths: ["de/index.html","de/about.html","de/manufacturing-quality.html","de/production-inspection-testing.html","de/products.html","de/product-comparison.html","de/BP-1P-0003.html","de/BP-1P-0006.html","de/BP-2P-0001.html","de/BP-2P-0002.html","de/BP-2P-08-0001.html","de/BP-2P-130-0001.html","de/BP-2P-16-0001.html","de/BP-2P-30-0001.html","de/BP-2P-50-0001.html","de/BP-2P-95-0005.html","de/BP-3P-0004.html","de/BP-3P-0006.html","de/BP-3P-0007.html","de/BP-3P-S06-0001.html","de/BP-4P-30-0001.html","de/BP-8P-0001.html","de/applications.html","de/application-automation-rotary-tables.html","de/application-bottle-filling-capping.html","de/application-cnc-pneumatic-clamping.html","de/application-electronics-battery-test-fixtures.html","de/application-laser-tube-cutting.html","de/application-packaging-machinery.html","de/application-pneumatic-tools-hose-anti-twist.html","de/application-robot-end-of-arm-tooling.html","de/application-steel-dusty-environments.html","de/application-textile-printing-converting.html","de/application-vacuum-packaging-machines.html","de/application-welding-positioners.html","de/custom-hydraulic-rotary-unions.html","de/installation.html","de/blog.html","de/blog-ptfe-coated-o-rings.html","de/blog-non-contact-clearance-seal-rotary-union.html","de/blog-rotary-joint-installation-mistakes.html","de/blog-rotary-joint-leaking.html","de/blog-rotary-joint-materials.html","de/blog-rotary-joint-selection.html","de/blog-rotary-union-seal-types.html","de/blog-seal-replacement.html","de/blog-threaded-vs-flange.html","de/case-studies.html","de/case-bp-2p-95-pneumatic-chuck-integration.html","de/case-bp-3p-s06-sensor-monitored-chuck.html","de/faq.html","de/contact.html","de/search.html","de/privacy.html","de/terms.html","de/thank-you.html","de/404.html","fr/index.html","fr/about.html","fr/manufacturing-quality.html","fr/production-inspection-testing.html","fr/products.html","fr/product-comparison.html","fr/BP-1P-0003.html","fr/BP-1P-0006.html","fr/BP-2P-0001.html","fr/BP-2P-0002.html","fr/BP-2P-08-0001.html","fr/BP-2P-130-0001.html","fr/BP-2P-16-0001.html","fr/BP-2P-30-0001.html","fr/BP-2P-50-0001.html","fr/BP-2P-95-0005.html","fr/BP-3P-0004.html","fr/BP-3P-0006.html","fr/BP-3P-0007.html","fr/BP-3P-S06-0001.html","fr/BP-4P-30-0001.html","fr/BP-8P-0001.html","fr/applications.html","fr/application-automation-rotary-tables.html","fr/application-bottle-filling-capping.html","fr/application-cnc-pneumatic-clamping.html","fr/application-electronics-battery-test-fixtures.html","fr/application-laser-tube-cutting.html","fr/application-packaging-machinery.html","fr/application-pneumatic-tools-hose-anti-twist.html","fr/application-robot-end-of-arm-tooling.html","fr/application-steel-dusty-environments.html","fr/application-textile-printing-converting.html","fr/application-vacuum-packaging-machines.html","fr/application-welding-positioners.html","fr/custom-hydraulic-rotary-unions.html","fr/installation.html","fr/blog.html","fr/blog-ptfe-coated-o-rings.html","fr/blog-non-contact-clearance-seal-rotary-union.html","fr/blog-rotary-joint-installation-mistakes.html","fr/blog-rotary-joint-leaking.html","fr/blog-rotary-joint-materials.html","fr/blog-rotary-joint-selection.html","fr/blog-rotary-union-seal-types.html","fr/blog-seal-replacement.html","fr/blog-threaded-vs-flange.html","fr/case-studies.html","fr/case-bp-2p-95-pneumatic-chuck-integration.html","fr/case-bp-3p-s06-sensor-monitored-chuck.html","fr/faq.html","fr/contact.html","fr/search.html","fr/privacy.html","fr/terms.html","fr/thank-you.html","fr/404.html","ja/index.html","ja/about.html","ja/manufacturing-quality.html","ja/production-inspection-testing.html","ja/products.html","ja/product-comparison.html","ja/BP-1P-0003.html","ja/BP-1P-0006.html","ja/BP-2P-0001.html","ja/BP-2P-0002.html","ja/BP-2P-08-0001.html","ja/BP-2P-130-0001.html","ja/BP-2P-16-0001.html","ja/BP-2P-30-0001.html","ja/BP-2P-50-0001.html","ja/BP-2P-95-0005.html","ja/BP-3P-0004.html","ja/BP-3P-0006.html","ja/BP-3P-0007.html","ja/BP-3P-S06-0001.html","ja/BP-4P-30-0001.html","ja/BP-8P-0001.html","ja/applications.html","ja/application-automation-rotary-tables.html","ja/application-bottle-filling-capping.html","ja/application-cnc-pneumatic-clamping.html","ja/application-electronics-battery-test-fixtures.html","ja/application-laser-tube-cutting.html","ja/application-packaging-machinery.html","ja/application-pneumatic-tools-hose-anti-twist.html","ja/application-robot-end-of-arm-tooling.html","ja/application-steel-dusty-environments.html","ja/application-textile-printing-converting.html","ja/application-vacuum-packaging-machines.html","ja/application-welding-positioners.html","ja/custom-hydraulic-rotary-unions.html","ja/installation.html","ja/blog.html","ja/blog-ptfe-coated-o-rings.html","ja/blog-non-contact-clearance-seal-rotary-union.html","ja/blog-rotary-joint-installation-mistakes.html","ja/blog-rotary-joint-leaking.html","ja/blog-rotary-joint-materials.html","ja/blog-rotary-joint-selection.html","ja/blog-rotary-union-seal-types.html","ja/blog-seal-replacement.html","ja/blog-threaded-vs-flange.html","ja/case-studies.html","ja/case-bp-2p-95-pneumatic-chuck-integration.html","ja/case-bp-3p-s06-sensor-monitored-chuck.html","ja/faq.html","ja/contact.html","ja/search.html","ja/privacy.html","ja/terms.html","ja/thank-you.html","ja/404.html","ru/index.html","ru/about.html","ru/manufacturing-quality.html","ru/production-inspection-testing.html","ru/products.html","ru/product-comparison.html","ru/BP-1P-0003.html","ru/BP-1P-0006.html","ru/BP-2P-0001.html","ru/BP-2P-0002.html","ru/BP-2P-08-0001.html","ru/BP-2P-130-0001.html","ru/BP-2P-16-0001.html","ru/BP-2P-30-0001.html","ru/BP-2P-50-0001.html","ru/BP-2P-95-0005.html","ru/BP-3P-0004.html","ru/BP-3P-0006.html","ru/BP-3P-0007.html","ru/BP-3P-S06-0001.html","ru/BP-4P-30-0001.html","ru/BP-8P-0001.html","ru/applications.html","ru/application-automation-rotary-tables.html","ru/application-bottle-filling-capping.html","ru/application-cnc-pneumatic-clamping.html","ru/application-electronics-battery-test-fixtures.html","ru/application-laser-tube-cutting.html","ru/application-packaging-machinery.html","ru/application-pneumatic-tools-hose-anti-twist.html","ru/application-robot-end-of-arm-tooling.html","ru/application-steel-dusty-environments.html","ru/application-textile-printing-converting.html","ru/application-vacuum-packaging-machines.html","ru/application-welding-positioners.html","ru/custom-hydraulic-rotary-unions.html","ru/installation.html","ru/blog.html","ru/blog-ptfe-coated-o-rings.html","ru/blog-non-contact-clearance-seal-rotary-union.html","ru/blog-rotary-joint-installation-mistakes.html","ru/blog-rotary-joint-leaking.html","ru/blog-rotary-joint-materials.html","ru/blog-rotary-joint-selection.html","ru/blog-rotary-union-seal-types.html","ru/blog-seal-replacement.html","ru/blog-threaded-vs-flange.html","ru/case-studies.html","ru/case-bp-2p-95-pneumatic-chuck-integration.html","ru/case-bp-3p-s06-sensor-monitored-chuck.html","ru/faq.html","ru/contact.html","ru/search.html","ru/privacy.html","ru/terms.html","ru/thank-you.html","ru/404.html"]
reviewedArtifactTransitions: [{"path":"de/index.html","beforeSemanticSha256":"f45fc6bd1b8f9be2c50ca9770ef4dccdd3b1b1860df1a9cbaba0457cdd76b811","beforeMechanicalSha256":"fdc8ada37ef9b86fbdac54d67337598ab43f04e9059fedc56d82bccfc9d22abc","afterSemanticSha256":"755d3b5fc56665079650383b55213a6ce98fb709f567a72895b1a6cc98e5f18a","afterMechanicalSha256":"2389deec61ee7ed87f3949898723daf3a960da7f0d36e6c8cd498975382b1631"},{"path":"de/about.html","beforeSemanticSha256":"3a22f652efce56c3a07286f8c46b7f8050fcf412a2e1cf3ef570dee113f155bd","beforeMechanicalSha256":"a45ef69c2d7bfcdc3a49a7992c312f062312ea646b5ca68db941245e89edf282","afterSemanticSha256":"4717e5b6fd7b7f231bf3bb3799934bb674802cf6d13c9e58b701476043335e9b","afterMechanicalSha256":"88ef7836dcae30581f6472807c48deb818b0160ee1746e680fa1009ffd8e4153"},{"path":"de/manufacturing-quality.html","beforeSemanticSha256":"208a20b0c7eaaa96bf4c5f2795d0d9f6cdadd89cdfef100c8c34015e2b4bedd2","beforeMechanicalSha256":"3d9cf316819c0a0acf721f881d520bcd3bb347a24acdeab596825c33420784cd","afterSemanticSha256":"5d4aac9e9de5ef09b724beb869b1accc790c0967a080e4897da44f26cf1915b3","afterMechanicalSha256":"8d68eec7d0ee975d86076d9be32a62accc398c61681c805ae0dc0f52255989b2"},{"path":"de/production-inspection-testing.html","beforeSemanticSha256":"f779911689957e833bf70e7f96c353f124d6913d2a706f8ae139f67dbf78ef49","beforeMechanicalSha256":"40ac04a0c2bf88269f668bf043789ad4cafff3da635a272e5b7b6f47aa8ccf34","afterSemanticSha256":"2bfec4440c07e523150bc3190525e4f33a27bb35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
emanticSha256":"f28a3a90f112ea5ce21ea5df2cb960db649010b72f78890f26ac243a89579ecd","afterMechanicalSha256":"c34c68110a554373d0197a72019b4f44c25b05357b6caa4ff8af41cace05f466"},{"path":"ru/privacy.html","beforeSemanticSha256":"c855924b74a8e9cd89fc5a0621ffd0ab8d3d28837839a77c79cb5c947b718c0f","beforeMechanicalSha256":"532ef89c6a058cb182d926b4bb7ad2aca559b677ed7a2196185a2e5f11a5d4af","afterSemanticSha256":"ff641b4a42cf13d8e3922dacc08285251994c7f200bf4e48f13f08af343c7d7c","afterMechanicalSha256":"b3c690903325c970f521a24cf0432dc0ea072619b2c72c04d31832a6ef559ca1"},{"path":"ru/terms.html","beforeSemanticSha256":"cf0c0a73f3754e463a6c42b8954c43909fb1a10eca2e57572baebfe095a13299","beforeMechanicalSha256":"0a287a64cfe15989aaba7720f7e23a09ea8b3749d31498a8003dcb44bb8a477a","afterSemanticSha256":"9b8b8a3b19552c162e97fa5f615a393f7d6cee070889d9a83c3741012e1e64a2","afterMechanicalSha256":"f5e1ab8188af06f981b4a3f9bd06bbe1c1a204f44eac3dc6e95a2d79042d9605"},{"path":"ru/thank-you.html","beforeSemanticSha256":"2f04dfd7cdf4bfc2a5155490abe26e358999a6ac15da8eb0272b58d87abf080c","beforeMechanicalSha256":"fcefabc56b49206dfc5693924b23fbd8411517dc38dc290d2b4ed8aa2b6c6863","afterSemanticSha256":"e9a39b25f572534e112a638fbc0f0b4373d6c41a091cfbc1eb3d9e8218d4fe7b","afterMechanicalSha256":"f19014f1d02617971c6aeca59b5f57ba2d4aff6f2986a1b6d26fa4e0170b7e22"},{"path":"ru/404.html","beforeSemanticSha256":"896e37f596ef1e8a7f5884b1bb55faac0743e932eef38652bfd11508107894b7","beforeMechanicalSha256":"9e060e04da68b735c9ce574b5a673217a60dc7ecceee129a4716924dd4247ef4","afterSemanticSha256":"11d3c7f1de7e89706c23c6b1924229e2532dd3bbb4b0cca15ba1be896f3a5228","afterMechanicalSha256":"de415ce6d39b7f5c4b2bc3ba0f6451651e993c2b7abf05c3b7c28d9459d735b5"}]

## Scope and baseline

Trusted baseline: 75f86dc7b7e2faea78f6814496208e67fc00ee85, matching origin/main after fetch and the latest successful production workflow observed on 2026-09-18. Main source is E:/begapunk-site-v2. No new commit, push or deployment is authorized by this record.

This is an AI-assisted review of changed content, not a claim of fresh native-speaker review of every complete page. All 228 localized artifacts changed through the shared footer. There are two intentional footer variants per locale: normal and contact-page without a duplicate quote CTA. Footer text, link meaning, legal identity and mobile disclosure labels were reviewed. Removing the footer and normalizing only approved navigation/style cache versions reproduces the baseline semantic projection for 212 pages. The remaining 16 pages are the four named page types per locale below. Existing production facts outside these deltas remain covered by baseline evidence.

## Non-footer changes

- index.html: related leaking-guide link label.
- blog-rotary-joint-installation-mistakes.html: related leaking-guide link label.
- blog-rotary-joint-leaking.html: title, metadata, H1 and JSON-LD five-step alignment.
- products.html: three selection cards, same-language navigation and scoped presentation styles.

Exact delta classification and before/after semantic/mechanical digests were computed against the trusted manifest. All 228 before-semantic hashes match the baseline manifest. No parameter changes were inferred from terminology sources.

## Supporting review evidence

- audit/footer/2026-09-16-mobile/README.md: original 40-case responsive/footer review.
- audit/localization/2026-09-15-leak-guide-title-review.md: five-step title and link correction.
- audit/localization/2026-09-18-catalog-selection-review.md: terminology references accessed September 18, all five catalogs at mobile/desktop sizes and selection-link checks.
- audit/seo/2026-09-18-exposure-repair.md: English source improvements and discovery work.

The 56/57 historical registration mismatch described by the earlier catalog report is now resolved through baseline reconciliation, not by manually increasing a count. Five-language verification (285 pages) and metadata verification pass after deduplicating the merged PTFE search/AI-index records. English mobile footer starts collapsed, expands only the clicked group, and the mobile menu opens and closes after the navigation merge. Remaining complete release gates are tracked separately.

## Release boundaries

Semantic unresolved/blocking arrays describe this bounded review only. They do not certify server configuration, real email delivery or production release readiness. Existing unrelated legacy-PDF redirect edits in .htaccess and two ops scripts are preserved locally and must be kept out of this SEO/footer candidate unless separately reviewed and authorized. No emails or inquiry forms were sent.
