caoguangcheng9-lgtm/begapunk-website/audit/localization/2026-09-12-cls-consolidated-review.md

# Consolidated production-to-CLS-release semantic review

reviewedAt: 2026-09-12T03:20:41Z
reviewedByRole: Codex AI technical-localization reviewer
reviewMethod: AI-assisted scoped review of navigation wording, behavior and consolidated prior title/share changes; exact sealed production-to-candidate transition
reviewType: ai-assisted-target-market-semantic-review
semanticReviewPerformed: true
nativeSpeakerReviewPerformed: false
referenceUrls: ["https://www.w3.org/WAI/ARIA/apg/patterns/disclosure/","https://developer.mozilla.org/en-US/docs/Web/CSS/Reference/Selectors/:target"]
referenceAccessDates: ["2026-09-12","2026-09-12"]
terminologyDecisions: ["Close-menu labels reviewed: Menü schließen; Fermer le menu; メニューを閉じる; Закрыть меню. Each refers only to closing navigation, not submitting an inquiry.","Retain product models, passage counts, pressure qualifiers and pneumatic/electrical distinctions in the previously reviewed Bing title and Japanese sharing changes. See 2026-09-09-bing-final-combined-review.md."]
searchIntentDecisions: ["Preserve all article/product body content, H1, descriptions and canonical URLs from the reviewed September 9 content commit; the read-only diff check passed all 224 localized pages.","Use an actual fragment link without scripting and enhance it to a keyboard-operable disclosure with accurate expanded state when scripting is available.","Do not add AI-specific features or alter facts for Lighthouse scoring."]
unresolvedIssues: []
blockingIssues: []
reviewedArtifactPaths: ["de/index.html","de/about.html","de/manufacturing-quality.html","de/production-inspection-testing.html","de/products.html","de/product-comparison.html","de/BP-1P-0003.html","de/BP-1P-0006.html","de/BP-2P-0001.html","de/BP-2P-0002.html","de/BP-2P-08-0001.html","de/BP-2P-130-0001.html","de/BP-2P-16-0001.html","de/BP-2P-30-0001.html","de/BP-2P-50-0001.html","de/BP-2P-95-0005.html","de/BP-3P-0004.html","de/BP-3P-0006.html","de/BP-3P-0007.html","de/BP-3P-S06-0001.html","de/BP-4P-30-0001.html","de/BP-8P-0001.html","de/applications.html","de/application-automation-rotary-tables.html","de/application-bottle-filling-capping.html","de/application-cnc-pneumatic-clamping.html","de/application-electronics-battery-test-fixtures.html","de/application-laser-tube-cutting.html","de/application-packaging-machinery.html","de/application-pneumatic-tools-hose-anti-twist.html","de/application-robot-end-of-arm-tooling.html","de/application-steel-dusty-environments.html","de/application-textile-printing-converting.html","de/application-vacuum-packaging-machines.html","de/application-welding-positioners.html","de/custom-hydraulic-rotary-unions.html","de/installation.html","de/blog.html","de/blog-non-contact-clearance-seal-rotary-union.html","de/blog-rotary-joint-installation-mistakes.html","de/blog-rotary-joint-leaking.html","de/blog-rotary-joint-materials.html","de/blog-rotary-joint-selection.html","de/blog-rotary-union-seal-types.html","de/blog-seal-replacement.html","de/blog-threaded-vs-flange.html","de/case-studies.html","de/case-bp-2p-95-pneumatic-chuck-integration.html","de/case-bp-3p-s06-sensor-monitored-chuck.html","de/faq.html","de/contact.html","de/search.html","de/privacy.html","de/terms.html","de/thank-you.html","de/404.html","fr/index.html","fr/about.html","fr/manufacturing-quality.html","fr/production-inspection-testing.html","fr/products.html","fr/product-comparison.html","fr/BP-1P-0003.html","fr/BP-1P-0006.html","fr/BP-2P-0001.html","fr/BP-2P-0002.html","fr/BP-2P-08-0001.html","fr/BP-2P-130-0001.html","fr/BP-2P-16-0001.html","fr/BP-2P-30-0001.html","fr/BP-2P-50-0001.html","fr/BP-2P-95-0005.html","fr/BP-3P-0004.html","fr/BP-3P-0006.html","fr/BP-3P-0007.html","fr/BP-3P-S06-0001.html","fr/BP-4P-30-0001.html","fr/BP-8P-0001.html","fr/applications.html","fr/application-automation-rotary-tables.html","fr/application-bottle-filling-capping.html","fr/application-cnc-pneumatic-clamping.html","fr/application-electronics-battery-test-fixtures.html","fr/application-laser-tube-cutting.html","fr/application-packaging-machinery.html","fr/application-pneumatic-tools-hose-anti-twist.html","fr/application-robot-end-of-arm-tooling.html","fr/application-steel-dusty-environments.html","fr/application-textile-printing-converting.html","fr/application-vacuum-packaging-machines.html","fr/application-welding-positioners.html","fr/custom-hydraulic-rotary-unions.html","fr/installation.html","fr/blog.html","fr/blog-non-contact-clearance-seal-rotary-union.html","fr/blog-rotary-joint-installation-mistakes.html","fr/blog-rotary-joint-leaking.html","fr/blog-rotary-joint-materials.html","fr/blog-rotary-joint-selection.html","fr/blog-rotary-union-seal-types.html","fr/blog-seal-replacement.html","fr/blog-threaded-vs-flange.html","fr/case-studies.html","fr/case-bp-2p-95-pneumatic-chuck-integration.html","fr/case-bp-3p-s06-sensor-monitored-chuck.html","fr/faq.html","fr/contact.html","fr/search.html","fr/privacy.html","fr/terms.html","fr/thank-you.html","fr/404.html","ja/index.html","ja/about.html","ja/manufacturing-quality.html","ja/production-inspection-testing.html","ja/products.html","ja/product-comparison.html","ja/BP-1P-0003.html","ja/BP-1P-0006.html","ja/BP-2P-0001.html","ja/BP-2P-0002.html","ja/BP-2P-08-0001.html","ja/BP-2P-130-0001.html","ja/BP-2P-16-0001.html","ja/BP-2P-30-0001.html","ja/BP-2P-50-0001.html","ja/BP-2P-95-0005.html","ja/BP-3P-0004.html","ja/BP-3P-0006.html","ja/BP-3P-0007.html","ja/BP-3P-S06-0001.html","ja/BP-4P-30-0001.html","ja/BP-8P-0001.html","ja/applications.html","ja/application-automation-rotary-tables.html","ja/application-bottle-filling-capping.html","ja/application-cnc-pneumatic-clamping.html","ja/application-electronics-battery-test-fixtures.html","ja/application-laser-tube-cutting.html","ja/application-packaging-machinery.html","ja/application-pneumatic-tools-hose-anti-twist.html","ja/application-robot-end-of-arm-tooling.html","ja/application-steel-dusty-environments.html","ja/application-textile-printing-converting.html","ja/application-vacuum-packaging-machines.html","ja/application-welding-positioners.html","ja/custom-hydraulic-rotary-unions.html","ja/installation.html","ja/blog.html","ja/blog-non-contact-clearance-seal-rotary-union.html","ja/blog-rotary-joint-installation-mistakes.html","ja/blog-rotary-joint-leaking.html","ja/blog-rotary-joint-materials.html","ja/blog-rotary-joint-selection.html","ja/blog-rotary-union-seal-types.html","ja/blog-seal-replacement.html","ja/blog-threaded-vs-flange.html","ja/case-studies.html","ja/case-bp-2p-95-pneumatic-chuck-integration.html","ja/case-bp-3p-s06-sensor-monitored-chuck.html","ja/faq.html","ja/contact.html","ja/search.html","ja/privacy.html","ja/terms.html","ja/thank-you.html","ja/404.html","ru/index.html","ru/about.html","ru/manufacturing-quality.html","ru/production-inspection-testing.html","ru/products.html","ru/product-comparison.html","ru/BP-1P-0003.html","ru/BP-1P-0006.html","ru/BP-2P-0001.html","ru/BP-2P-0002.html","ru/BP-2P-08-0001.html","ru/BP-2P-130-0001.html","ru/BP-2P-16-0001.html","ru/BP-2P-30-0001.html","ru/BP-2P-50-0001.html","ru/BP-2P-95-0005.html","ru/BP-3P-0004.html","ru/BP-3P-0006.html","ru/BP-3P-0007.html","ru/BP-3P-S06-0001.html","ru/BP-4P-30-0001.html","ru/BP-8P-0001.html","ru/applications.html","ru/application-automation-rotary-tables.html","ru/application-bottle-filling-capping.html","ru/application-cnc-pneumatic-clamping.html","ru/application-electronics-battery-test-fixtures.html","ru/application-laser-tube-cutting.html","ru/application-packaging-machinery.html","ru/application-pneumatic-tools-hose-anti-twist.html","ru/application-robot-end-of-arm-tooling.html","ru/application-steel-dusty-environments.html","ru/application-textile-printing-converting.html","ru/application-vacuum-packaging-machines.html","ru/application-welding-positioners.html","ru/custom-hydraulic-rotary-unions.html","ru/installation.html","ru/blog.html","ru/blog-non-contact-clearance-seal-rotary-union.html","ru/blog-rotary-joint-installation-mistakes.html","ru/blog-rotary-joint-leaking.html","ru/blog-rotary-joint-materials.html","ru/blog-rotary-joint-selection.html","ru/blog-rotary-union-seal-types.html","ru/blog-seal-replacement.html","ru/blog-threaded-vs-flange.html","ru/case-studies.html","ru/case-bp-2p-95-pneumatic-chuck-integration.html","ru/case-bp-3p-s06-sensor-monitored-chuck.html","ru/faq.html","ru/contact.html","ru/search.html","ru/privacy.html","ru/terms.html","ru/thank-you.html","ru/404.html"]
reviewedArtifactTransitions: [{"path":"de/index.html","beforeSemanticSha256":"0883a7492935e7d31e305b48b6e838ac7a027100095e5afd645d9b952d1ab79b","afterSemanticSha256":"f45fc6bd1b8f9be2c50ca9770ef4dccdd3b1b1860df1a9cbaba0457cdd76b811","beforeMechanicalSha256":"be5cd99eed5af725c863f074ccfc7f3563a8d2ba3338cf1a31134caf0c4be2ac","afterMechanicalSha256":"fdc8ada37ef9b86fbdac54d67337598ab43f04e9059fedc56d82bccfc9d22abc"},{"path":"de/about.html","beforeSemanticSha256":"bc828c68cecdcfae16ccff719e97ada64834e03c772e40b26fe858cc6ecd010a","afterSemanticSha256":"3a22f652efce56c3a07286f8c46b7f8050fcf412a2e1cf3ef570dee113f155bd","beforeMechanicalSha256":"bbdf8b5ebddbb504a3d8918810fcbb3de68ad8414c1ae8a896064e54c968903b","afterMechanicalSha256":"a45ef69c2d7bfcdc3a49a7992c312f062312ea646b5ca68db941245e89edf282"},{"path":"de/manufacturing-quality.html","beforeSemanticSha256":"71ba87f0e1c5ef4fcba28db3789bc8ee5014c9935edefd5cb5799efc197c4988","afterSemanticSha256":"208a20b0c7eaaa96bf4c5f2795d0d9f6cdadd89cdfef100c8c34015e2b4bedd2","beforeMechanicalSha256":"158dd4df271dd64aa5b0024136e47c092d60d7aad3cb6195803ea38a48fb01f2","afterMechanicalSha256":"3d9cf316819c0a0acf721f881d520bcd3bb347a24acdeab596825c33420784cd"},{"path":"de/production-inspection-testing.html","beforeSemanticSha256":"c880c21485b4f088d54bf6783c8b9b2f9370c529010179559b634b8dceecb114","afterSemanticSha256":"f779911689957e833bf70e7f96c353f124d6913d2a706f8ae139f67dbf78ef49","beforeMechanicalSha256":"8c0f1f4c743a510cf19be165d391db2899a93144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
f703a9a3","afterMechanicalSha256":"9e060e04da68b735c9ce574b5a673217a60dc7ecceee129a4716924dd4247ef4"}]

## Scope and evidence

Production baseline: 1df9f815143055992dcdf32850206b080831069a. All legacy seals were first checked against actual Git bytes before deriving semantic snapshots. This is a scoped AI-assisted review, not native-speaker certification or a new full factual review of unchanged articles.

The September 9 consolidated title/share review is retained as content evidence. The current reviewer rechecked the before/after title list, unchanged H1 and descriptions, and all 224 localized main bodies against that reviewed commit. Added menu close labels and fragment targets were checked on every localized page. The prior 125-case isolated layout report and full original 1400-case report remain artifact-specific; CI must validate the final newly built artifact.

## Release boundary

This record approves the declared semantic delta only. It does not authorize bypassing CI, promote source HEAD to the production baseline, change editorial readiness debt, or claim mail/server health. The site owner's separate September 12 authorization covers committing, pushing, workflow integration repair and deployment after validation. Runtime and artifact checks remain mandatory.
