caoguangcheng9-lgtm/begapunk-website/audit/localization/2026-08-31-ai-assisted-marketing-and-legal-review.md

# Localized artifact snapshot review

reviewedAt: `2026-08-31T12:00:00+09:00`
reviewedByRole: `AI-assisted Codex review`
reviewMethod: `AI-assisted line-by-line comparison against the English master and current project standards`
unresolvedIssues: `none`

目标市场参考来源:

- 英文母版页面
- `data/product-drawing-facts.json`
- `i18n/manual/product-detail-ui.json`
- 德文、日文、俄文当前页面

术语决定:

- `BP-2P-95-0005` 保留“2-Passage / 2流路 / 2-канальное”，并增加“2-in / 4-out / 2入力4出力 / 2/4 выхода”的用途说明。
- 日语法律页中的“legal obligations”统一译为“義務”，不再使用“使用条件”。
- 产品页交期改为明确承诺口径：英文“20 calendar days after payment / within 30 calendar days after payment”，德日俄同步对应表达。
- 产品页质保改为“发货日起 1 年”，英文为“1 year from shipment”，德日俄同步对应表达。

搜索意图决定:

- 保留型号和“Pneumatic Rotary Union”等品类词。
- 增加“clamp / release”等具体用途信号，但不写入未证实的能力。
