caoguangcheng9-lgtm/begapunk-website/audit/localization/2026-08-28-laser-application-metadata-sync-review.md

# 2026-08-28 激光应用页三语元数据同步审核

日期：2026-08-28（Asia/Tokyo）

- reviewedAt: `2026-08-28T15:50:40+09:00`
- reviewedByRole: `Codex AI-assisted industrial buyer and technical-localization reviewer`
- reviewMethod: `line-by-line DE/JA/RU review against the already approved visible laser-application copy and governed SEO source`
- independentNativeSpeakerReview: `not performed`
- humanEditorialSignOff: `the site owner previously accepted the low-barrier inquiry direction; this record only synchronizes metadata and AI-index wording with that approved page meaning`
- unresolvedIssues: `no known factual, localization, or inquiry-meaning blocker in the synchronized metadata scope`

## 审核范围

- localized pages: `de/application-laser-tube-cutting.html`, `ja/application-laser-tube-cutting.html`, `ru/application-laser-tube-cutting.html`
- synchronized surfaces: Open Graph description, Twitter description, WebPage JSON-LD description
- AI indexes: `de/llms.txt`, `ja/llms.txt`, `ru/llms.txt`
- governed sources: `i18n/seo/de.json`, `i18n/seo/ja.json`, `i18n/seo/ru.json`

本次没有重写页面正文，也没有新增产品参数、性能、认证、测试或交期承诺。三语社交摘要和 JSON-LD 统一采用各自已经确认的页面描述；三份 AI 索引只同步当前受控 SEO 描述，不扩大产品适用范围。

## 目标市场参考来源

- 以项目内已经审核的英文激光后卡盘应用页、三语可见正文和既有三语 SEO 数据为唯一内容来源。
- 继续面向工业设备采购与工程人员，先说明可比较独立两流路和三流路的压缩空气方案，再说明型号、照片或图纸即可开始。
- 不把外部竞争对手文案或未经确认的技术事实写入 Begapunk 页面。

## 术语决定

- 德语保留 `Zwei- und Dreikanal-Drehdurchführungen` 与 `Druckluft am hinteren Spannfutter`，明确产品类别和介质。
- 日语保留 `レーザー管切断機の後方チャック`、`独立2流路・3流路` 和 `空圧ロータリジョイント`，不缩写为含义模糊的“仕様”。
- 俄语保留 `двух- и трёхканальные ротационные соединения` 与 `подачи сжатого воздуха к заднему патрону`，明确这是旋转接头而不是泛化结构。
- 三语均维持低门槛含义：型号、照片或图纸中的任一项即可开始，不要求客户先完成工况清单。

## 搜索意图决定

- Open Graph、Twitter 和 WebPage JSON-LD 使用与各语种 meta description 相同的核心信息，避免搜索、分享和 AI 读取不同版本。
- `llms.txt` 使用当前受控 SEO 描述，帮助搜索与 AI 正确识别后卡盘压缩空气用途及两流路/三流路选择方向。
- 本次同步不改变 canonical、hreflang、索引状态、页面标题或可见 CTA。

## 审核边界

本记录证明的是项目证据范围内的 AI 辅助逐句商业文案与本地化复核，不构成独立母语审校、第三方认证或产品测试。本轮未提交真实询盘，也未证明邮件送达；提交、推送和生产部署仍由单独授权控制。
