caoguangcheng9-lgtm/begapunk-website/audit/product-drawings/2026-08-20-drawing-conflict-register.md

# 产品图纸冲突与待补资料修订清单

日期：2026-08-20
用途：供产品负责人和制图人员核对、修订图纸。本文只记录已发现的问题，不推断任何未确认的技术值。

## 2026-08-20 复核结论

- `BP-1P-0006`：**原冲突已关闭**。产品负责人确认正确结构为 1 个 G1/8 入口、8 个 G1/8 出口；现有网站仓库 PDF 的视图和标注也显示 `G1/8 IN` 与 `8-G1/8 OUT`。网页可按 1 进 8 出同步。
- `BP-2P-30-0001`：**型号身份已改正，但新版 PDF 暂不发布**。桌面新版标题栏已为 `BP-2P-30-0001`，同时重量由旧图的 390 g 变为 1230 g、总长由 69.97 mm 变为 70 mm、文件控制号和日期也发生变化。新版 PDF 的页面边界错误，页眉和标题栏被裁切；需从 CAD 重新按完整图框导出后再替换网站下载文件并解除网页隔离。
- `BP-2P-95-0005`：**型号与压力冲突已关闭**。2026-08-20 新版文件名和图纸标题栏均为 `BP-2P-95-0005`，图纸参数表为 `1 MPa`。网站正式型号、下载文件和四语产品资料已迁移到 `0005`；旧 `0001` 地址仅保留无索引兼容跳转。PDF 文档属性中的 Title 仍为 `BP-2P-95-005`，属于非图面元数据残留，后续重导出时建议一并统一，但不覆盖标题栏事实。
- `BP-3P-0006`：**螺纹事实已改正，但新版 PDF 暂不发布**。桌面新版清楚标注 `3 × G1/4 (Ø6 THRU) - FLOW IN` 与 `3 × G1/4 (Ø6 THRU) - FLOW OUT`，原 `G4/1` 异常已解决；但新版 PDF 的页眉和标题栏仍被页面边界裁切，需完整重导出后再替换公开下载文件和解除网页端口隔离。
- `BP-3P-S06-0001`：按产品负责人决定继续保守发布，只说明图纸显示 6 根电引线，不推断回路分配或额定值。

### 参数表新增证据冲突

此前参数表包含图纸没有证明的强声明，包括多种液体介质、零泄漏、额定条件下至少 8,000 小时、CE/RoHS、扭矩等。新版 `BP-2P-95-0005` 图纸参数表已经统一为 `1 MPa`；网站继续执行“图纸优先”，未获图纸、测试记录、证书或正式批准规格支持的其他声明仍不进入网页、结构化数据、站内搜索或 AI 索引。

## 1. BP-1P-0006：出口数量冲突（重大）

**状态：已关闭。** 2026-08-20 产品负责人确认正确值为 1 进 8 出；网页事实合同已获准改为图纸值。

- **证据**：型号资料及原网页描述为“6 个出口”；对应图纸标注为 `8-G1/8 OUT`。
- **当前网页隔离处理**：暂不把“6 个”或“8 个”作为已确认参数发布；出口数量标记为待工程确认。
- **建议图纸修改**：先用实物、已批准的三维模型或正式产品规格核定出口数量，再修正错误的一方。若图纸错误，修订 `8-G1/8 OUT`；若型号或网页资料错误，则保留图纸标注并统一型号资料和产品命名体系。
- **用户需确认**：正确产品到底是 6 出口还是 8 出口？错误发生在型号/网页资料，还是图纸标注？
- **修订后验收点**：图纸视图中的实际孔位数、出口标注、BOM/规格表、型号名称及网页参数完全一致；修订栏注明变更原因、日期和版本。

> 不应根据型号名称或现有图形自行猜测正确数量，必须由产品负责人确认。
老曹回答：就是8个孔：E:\360MoveData\Users\cao19\Desktop\04_报告资料\制作网站\BP-1P-0006

## 2. BP-2P-30-0001：文件名与标题栏型号不一致（重大）

**状态：事实修订已确认，公开 PDF 仍待重新导出。** 不再需要确认型号；需要修复页面边界裁切，并以完整图框输出正式 PDF。

- **证据**：PDF 文件名为 `BP-2P-30-0001`，图纸标题栏为 `BP-3P-30-0001`。
- **当前网页隔离处理**：该页按“图纸身份待确认”处理，不引用这份图纸发布压力、转速、接口、材料、尺寸等技术参数。
- **建议图纸修改**：依据正式料号、BOM、三维模型和实际通道结构确认产品身份；随后统一文件名、标题栏、图号、修订记录及关联资料。
- **用户需确认**：正确型号是 `BP-2P-30-0001` 还是 `BP-3P-30-0001`？该图纸是否放入了错误的产品资料包？
- **修订后验收点**：文件名、标题栏型号、图号、通道数量、结构视图、BOM及网页 SKU 一致；新版本可唯一对应目标产品。
老曹回答：图纸已经修改：E:\360MoveData\Users\cao19\Desktop\04_报告资料\制作网站\BP-2P-30-0001

## 3. BP-2P-95-0005：文件名尾号与标题栏尾号不一致（重大）

**状态：已关闭。** 产品负责人确认正式型号为 `BP-2P-95-0005`；新版 PDF 文件名、图纸标题栏和图纸参数表已分别统一为 `BP-2P-95-0005`、`BP-2P-95-0005` 和 `1 MPa`。

- **证据**：新版源文件 `BP-2P-95-0005.pdf` 的图纸标题栏为 `BP-2P-95-0005`，文件控制号为 `QC-2025-0512-003`，图纸表列最大压力 `1 MPa`。
- **当前网页处理**：四语正式产品页、PDF 下载、站内搜索、LLMS/AI 摘要、站点地图和相关案例均使用 `BP-2P-95-0005`。旧 `BP-2P-95-0001` 页面不再发布产品参数，只做 `noindex,follow` 的同语言跳转；旧矛盾 PDF 已退出公开下载路径。
- **仍需注意**：PDF 文档属性 Title 仍写 `BP-2P-95-005`。该字段不改变图纸标题栏和网站正式型号，但下一次从 CAD 导出时建议改为 `BP-2P-95-0005`，避免文件管理系统按元数据产生第三种编号。
- **已发布的图纸事实边界**：空气、2 流路、`1 MPa`、`200 RPM`、6061 铝合金、`4260 g`、`−20～80°C`、PTFE + O 型圈、最大外径 `Ø162`、总长 `86 mm`、两处 `G1/8` 夹紧/松开功能口及图纸明确的安装孔组。
- **未采用的旧声明**：2 进 4 出、多种液体介质、45#钢转子、扭矩、零泄漏、8,000 小时寿命及 ISO/CE/RoHS 等没有获得本图纸支持的内容。

## 4. BP-3P-0006：接口螺纹标注异常（重大）

**状态：螺纹事实已关闭，公开 PDF 仍待重新导出。** 修订图已明确 G1/4，但页面边界仍裁切页眉和标题栏。

- **证据**：图纸出现 `3-G4/1 IN/OUT`，该写法异常，无法据此确认真实螺纹规格。
- **当前网页隔离处理**：不发布 `G4/1`，也不猜测为 `G1/4`；接口螺纹规格保持待工程确认，其他互不冲突且清晰的图纸参数可独立使用。
- **建议图纸修改**：使用实物测量、已批准三维模型或正式设计记录核定螺纹规格，再按统一制图规范重写数量、螺纹代号及 IN/OUT 功能标注。
- **用户需确认**：真实规格是否为 `G1/4`，或为其他规格？IN 与 OUT 是否采用相同螺纹和相同数量？
- **修订后验收点**：孔表、局部视图、尺寸标注和技术要求中的螺纹规格一致；数量、入口/出口含义明确；网页只采用修订后的正式值。
老曹答复：图纸已经修改：E:\360MoveData\Users\cao19\Desktop\04_报告资料\制作网站\BP-3P-0006

## 5. S06：电气资料缺失（非矛盾，但影响发布完整性）

- **证据**：现有图纸只能确认 6 根电引线；未给出回路分配、电压、电流、绝缘等级或其他电气额定值。
- **当前网页隔离处理**：仅说明图纸显示 6 根电引线；不发布回路用途、额定电压、电流、绝缘等级，也不根据引线数量推断电路数量。
- **建议图纸修改**：如该产品对外销售需要电气选型，应补充接线图或受控电气规格表，明确每根引线的编号/颜色、回路分配、额定电压与电流、绝缘要求及适用工况。
- **用户需确认**：6 根引线分别对应哪些回路？正式额定电压、电流和绝缘要求是什么？这些信息应写入机械图、电气附图，还是单独的规格书？
- **修订后验收点**：机械图、接线图、规格书与实物线色/端子标识一致；额定值具有明确测试或设计依据；网页不超出正式资料范围。
老曹答复：该型号不是主要销售对象，相关参数可以做模糊处理。

## 修订优先级与回传资料

下一步优先级：第一，重新导出未裁切的 `BP-2P-30-0001` 与 `BP-3P-0006` 正式 PDF；第二，按证据修订或降级参数表中的介质、零泄漏、寿命、认证和扭矩声明；第三，下次重导 `BP-2P-95-0005` 时同步修正 PDF 文档属性 Title。收到可完整显示图框的 PDF 后，再替换对应公开下载文件并解除仍存在的网页隔离。
