caoguangcheng9-lgtm/begapunk-website/audit/product-truth-decisions/BP-2P-50-0001-conservative-public-update.md

# BP-2P-50-0001 Conservative Public Update

Date: 2026-07-31

Issue: [#12 — Apply conservative public facts for BP-2P-50-0001](https://github.com/caoguangcheng9-lgtm/begapunk-website/issues/12)

Baseline: `81b50b8c3158297d1190830f4ff852667baec5da`

Decision owner: laocao

Decision type: `conservative-public-policy`
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
