caoguangcheng9-lgtm/begapunk-website/audit/fact-resolution/phase-1e-a/evidence-images/01-BP-1P-0003-temperature-pdf-page-1.png

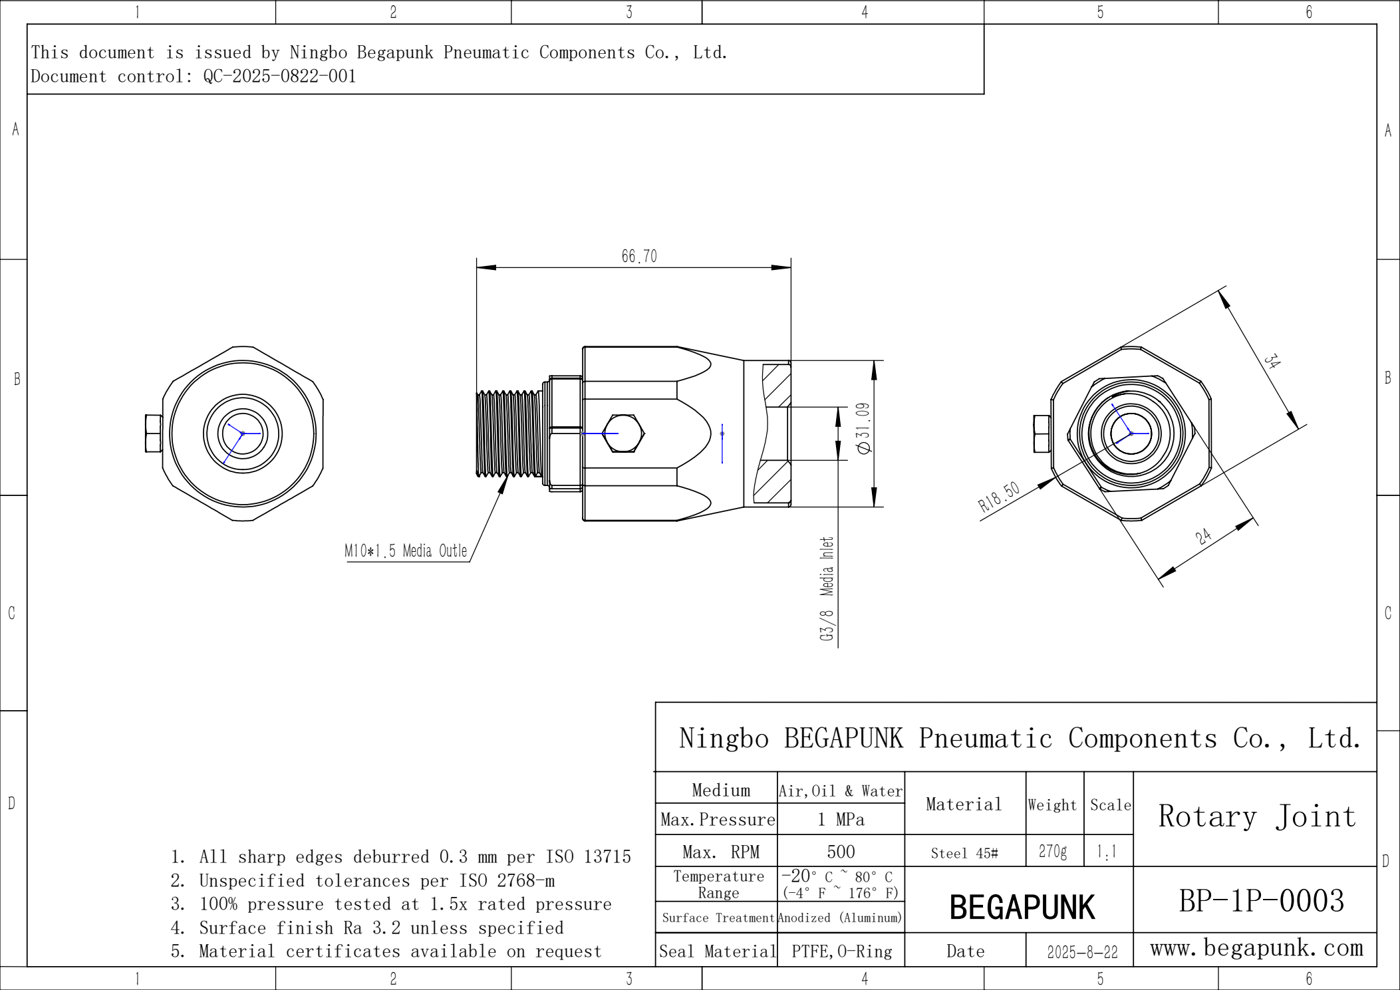
audit/fact-resolution/phase-1e-a/evidence-images/01-BP-1P-0003-temperature-pdf-page-1.png
