caoguangcheng9-lgtm/begapunk-website/audit/fact-resolution/phase-1e-a/evidence-images/06-BP-2P-95-0001-model-pdf-page-1.png

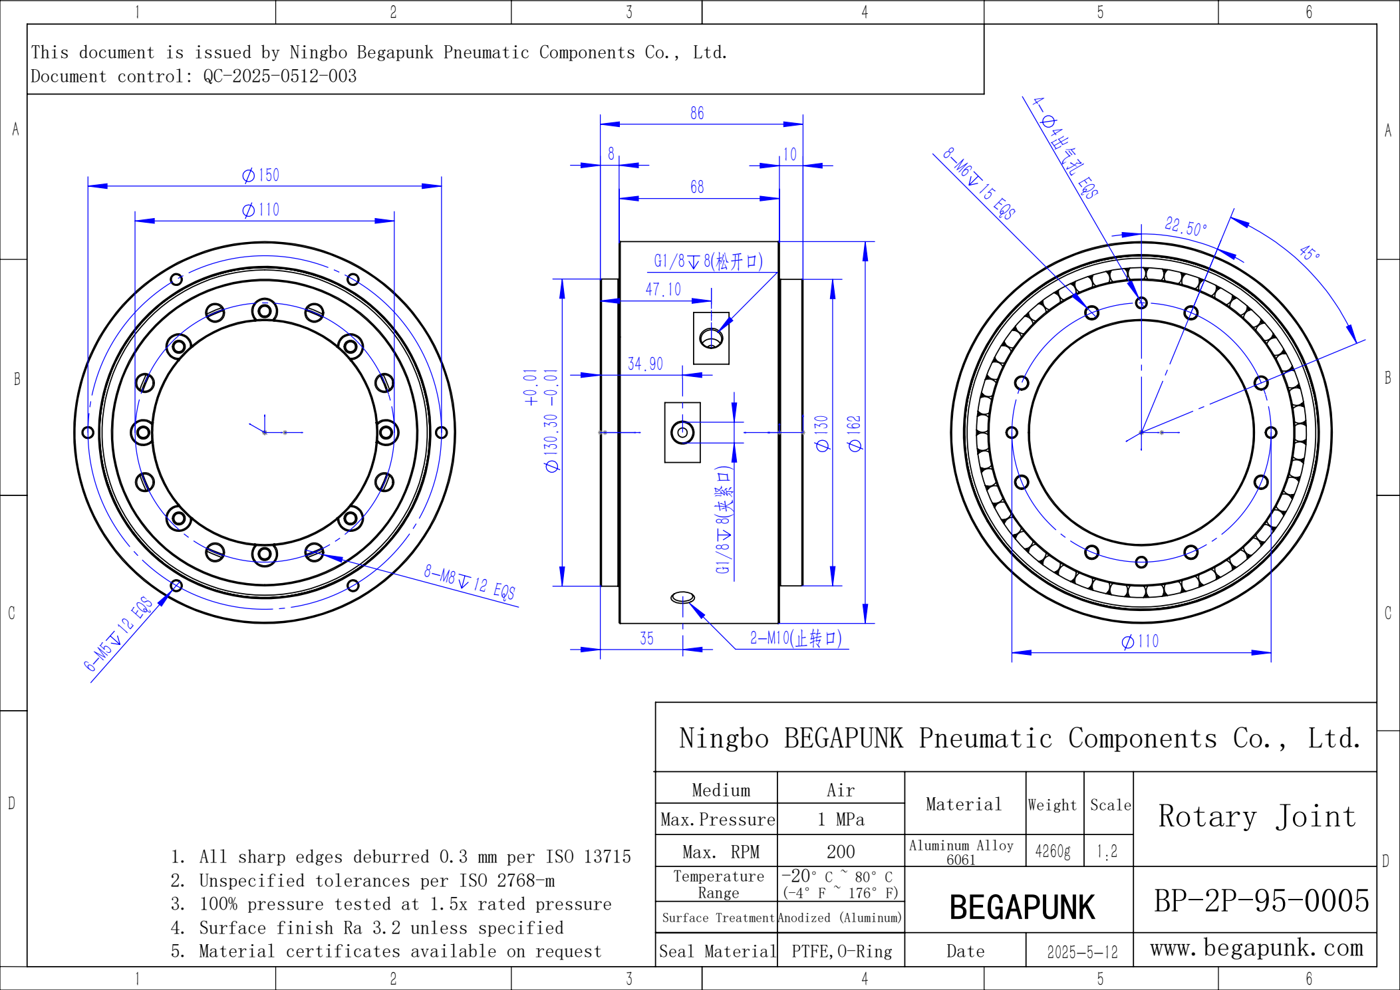
audit/fact-resolution/phase-1e-a/evidence-images/06-BP-2P-95-0001-model-pdf-page-1.png
