caoguangcheng9-lgtm/begapunk-website/audit/fact-resolution/phase-1e-a/evidence-images/08-BP-4P-30-0001-speed-pdf-page-1.png

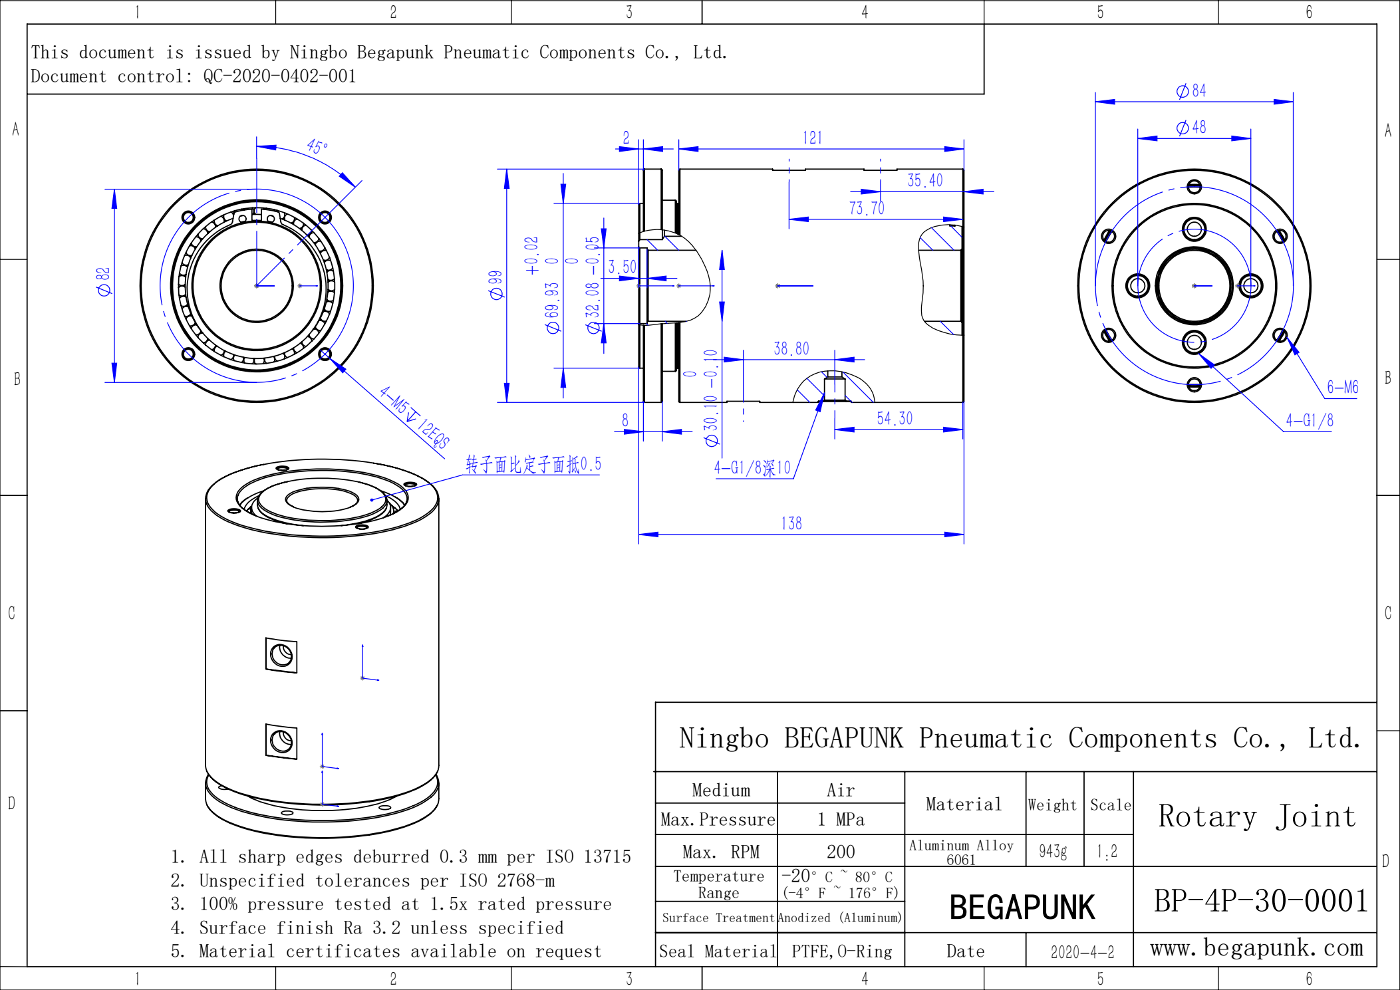
audit/fact-resolution/phase-1e-a/evidence-images/08-BP-4P-30-0001-speed-pdf-page-1.png
