caoguangcheng9-lgtm/begapunk-website/audit/fact-resolution/phase-1e-a/evidence-images/09-BP-2P-50-0001-weight-pdf-page-1.png

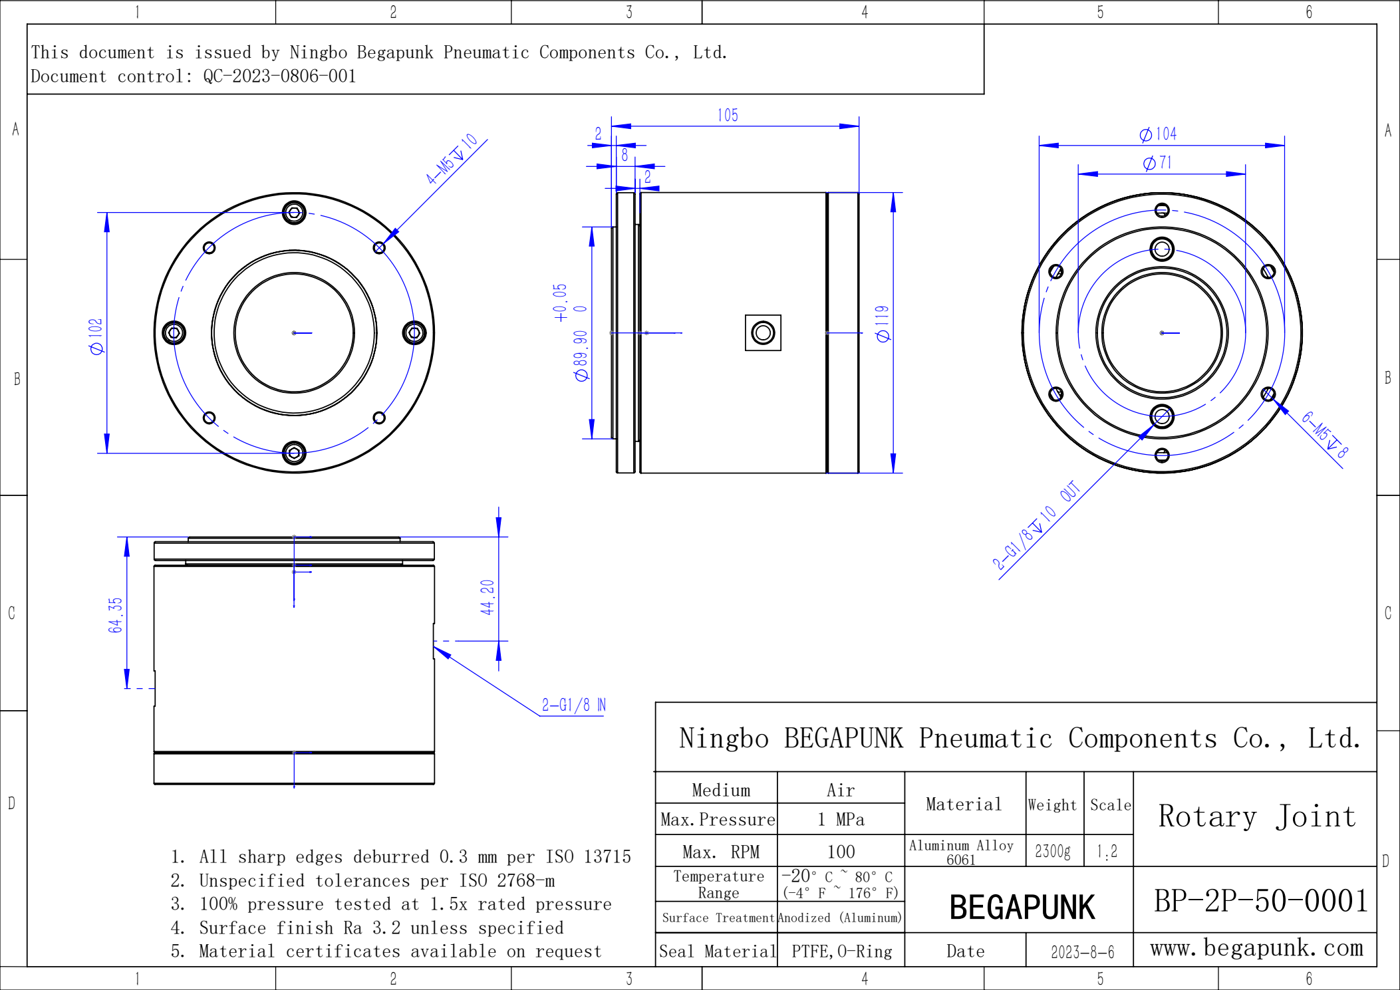
audit/fact-resolution/phase-1e-a/evidence-images/09-BP-2P-50-0001-weight-pdf-page-1.png
