caoguangcheng9-lgtm/begapunk-website/audit/fact-resolution/phase-1e-a/evidence-images/10-BP-3P-0004-weight-pdf-page-1.png

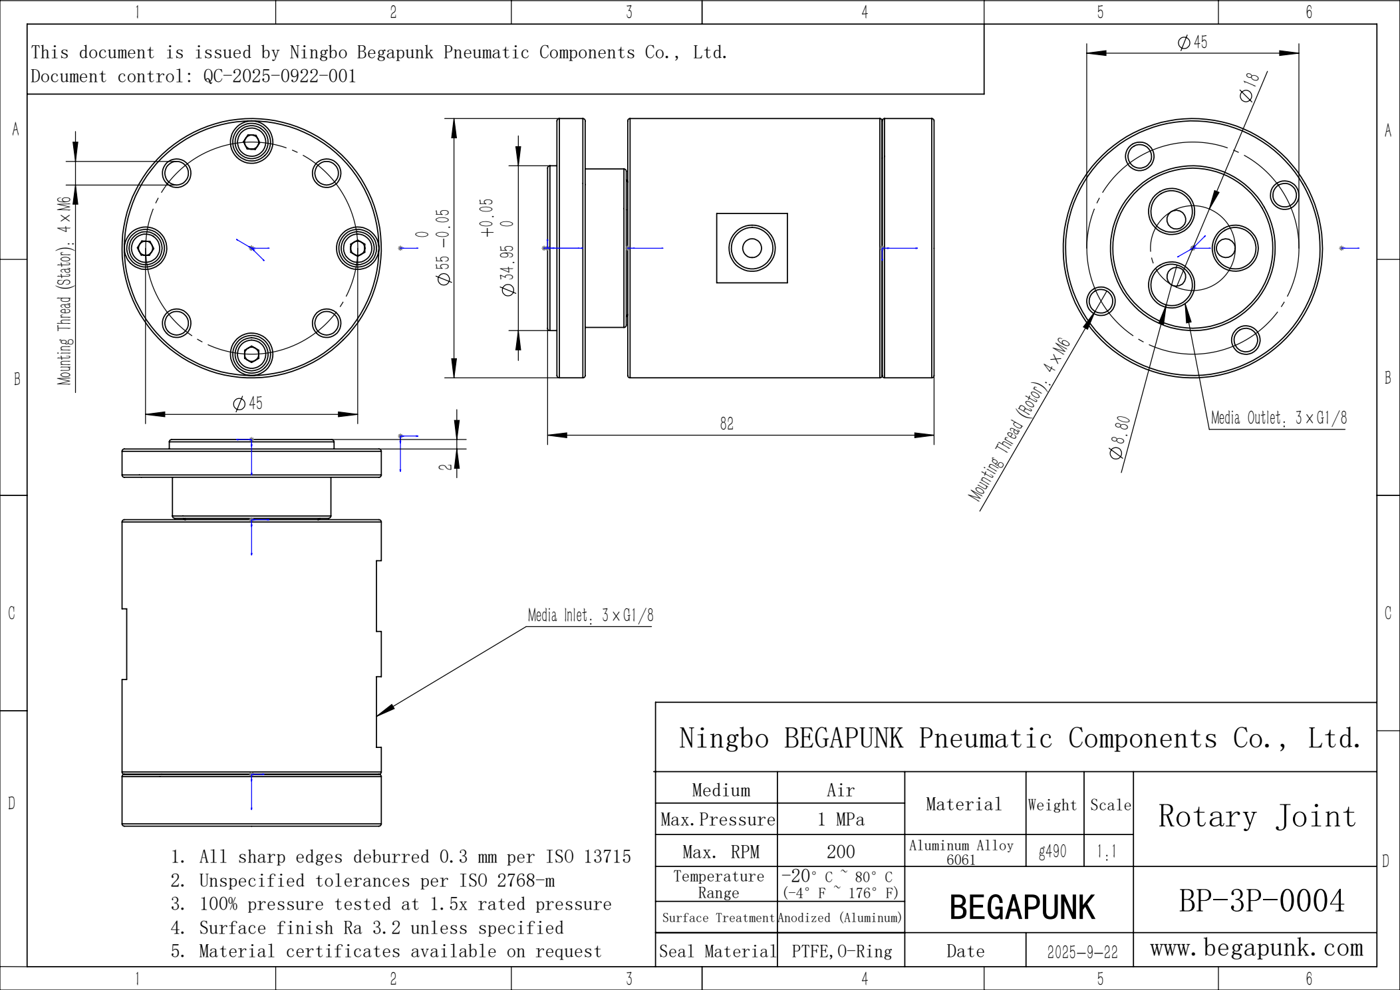
audit/fact-resolution/phase-1e-a/evidence-images/10-BP-3P-0004-weight-pdf-page-1.png
