caoguangcheng9-lgtm/begapunk-website/audit/footer/2026-09-16-mobile/en-390.png

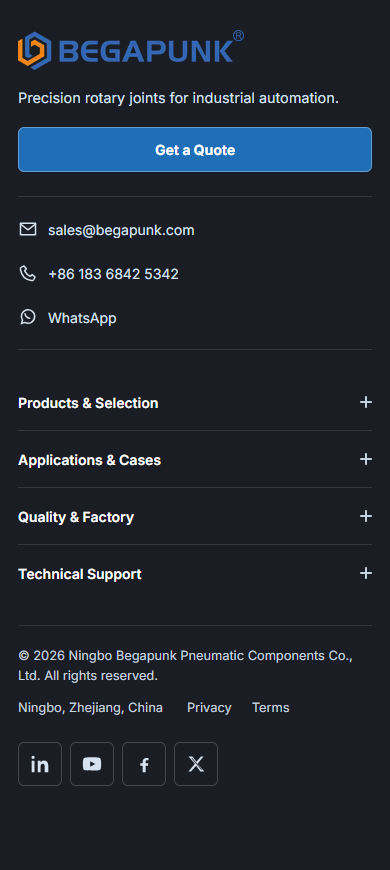
audit/footer/2026-09-16-mobile/en-390.png
