caoguangcheng9-lgtm/begapunk-website/audit/footer/screenshots-layout-r2/en-home-footer-768-top.png

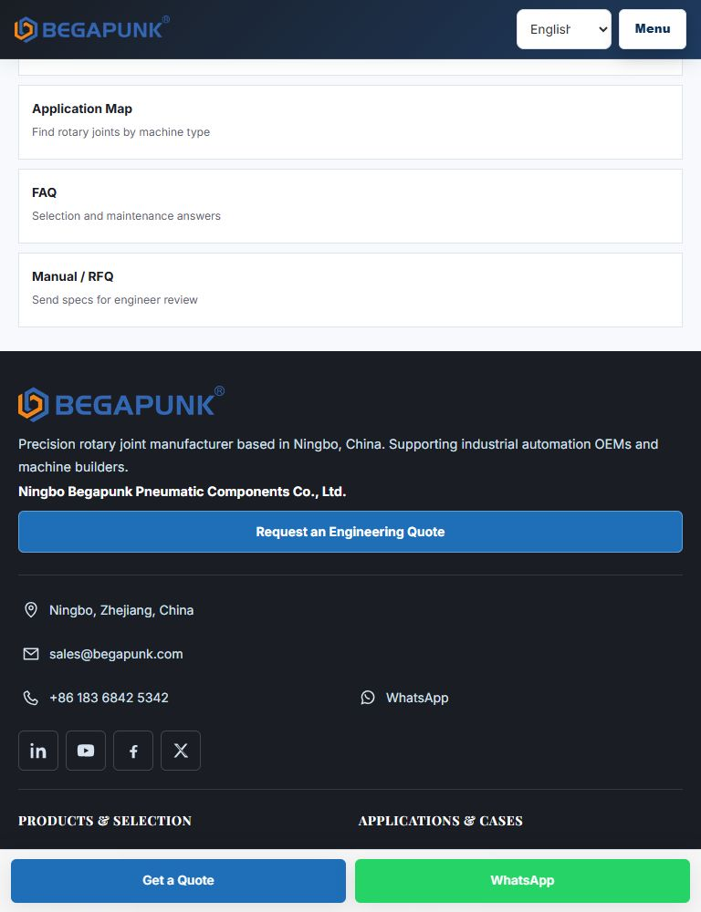
audit/footer/screenshots-layout-r2/en-home-footer-768-top.png
