caoguangcheng9-lgtm/begapunk-website/audit/footer/screenshots-layout-r2/en-home-footer-900-top.png

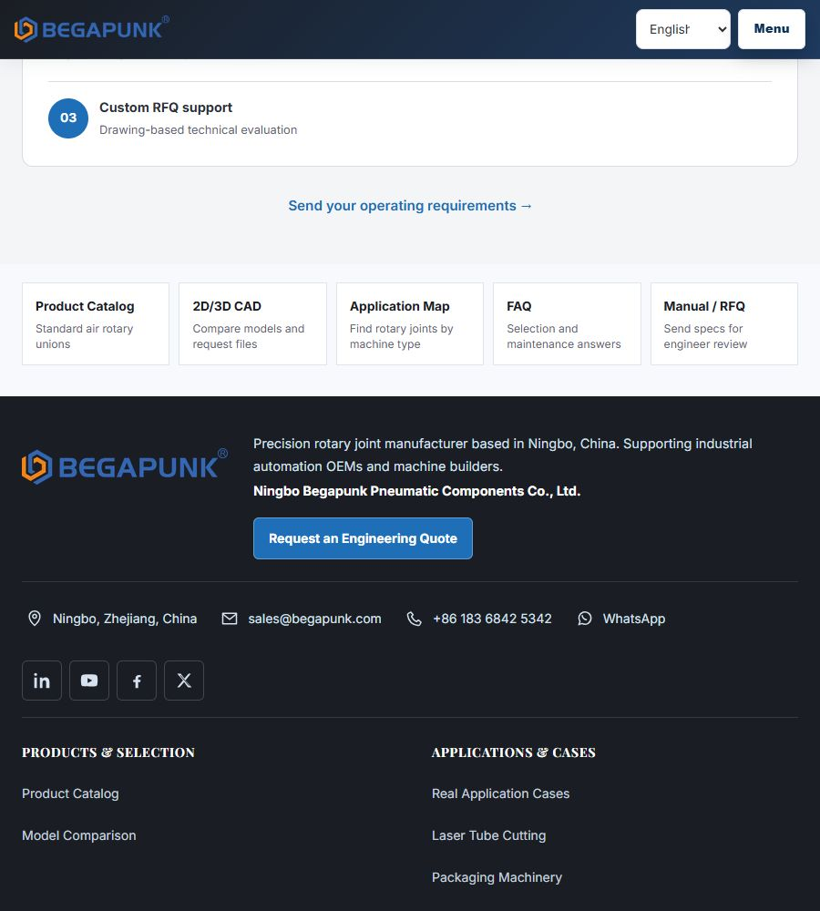
audit/footer/screenshots-layout-r2/en-home-footer-900-top.png
