caoguangcheng9-lgtm/begapunk-website/audit/footer/screenshots-layout-r2/en-search-footer-1440-top.png

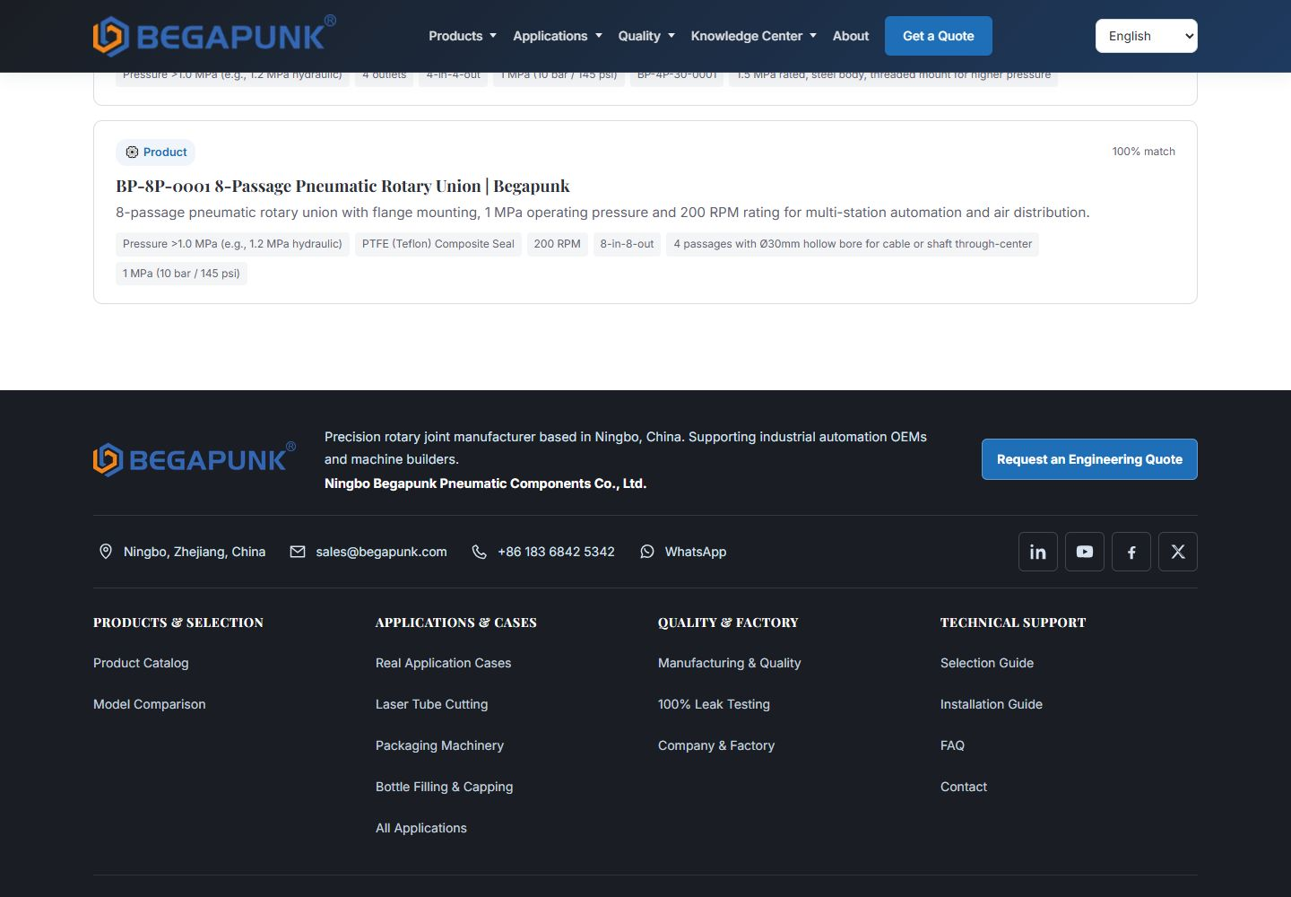
audit/footer/screenshots-layout-r2/en-search-footer-1440-top.png
