caoguangcheng9-lgtm/begapunk-website/audit/footer/screenshots-layout-r2/ja-home-footer-390-bottom.png

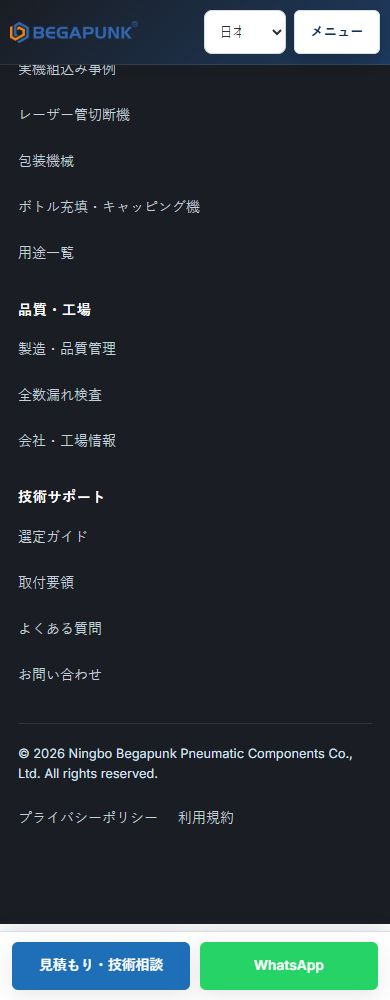
audit/footer/screenshots-layout-r2/ja-home-footer-390-bottom.png
