caoguangcheng9-lgtm/begapunk-website/audit/footer/screenshots-layout-r2/ru-home-footer-390-top.png

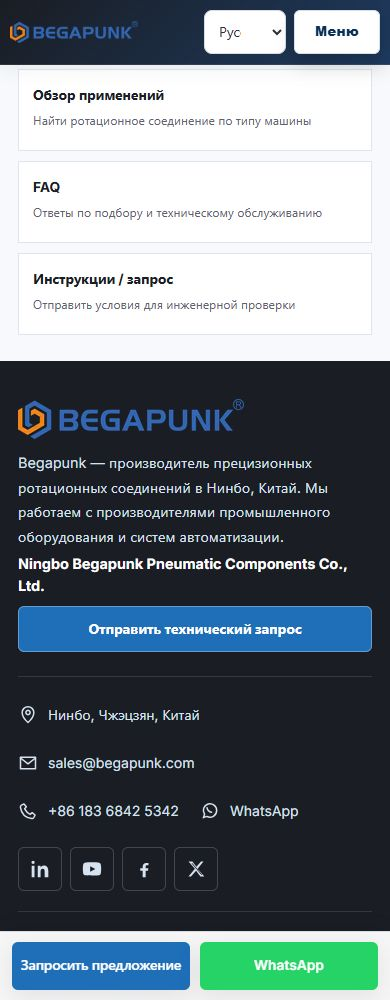
audit/footer/screenshots-layout-r2/ru-home-footer-390-top.png
