caoguangcheng9-lgtm/begapunk-website/images/applications/bottle-filling-capping/bp-2p-16-bottle-capping-three-jaw-gripper.jpg

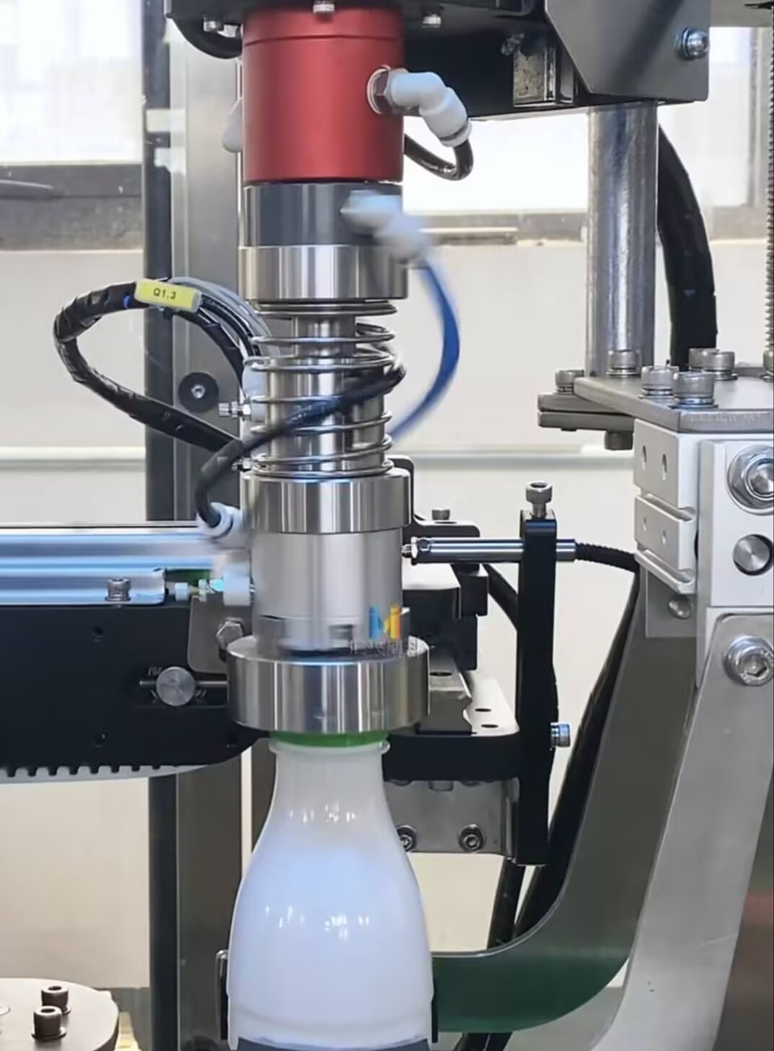
images/applications/bottle-filling-capping/bp-2p-16-bottle-capping-three-jaw-gripper.jpg
