caoguangcheng9-lgtm/begapunk-website/images/applications/cnc-pneumatic-clamping/bp-2p-130-custom-cnc-circular-saw-fixture-rear-view.jpg

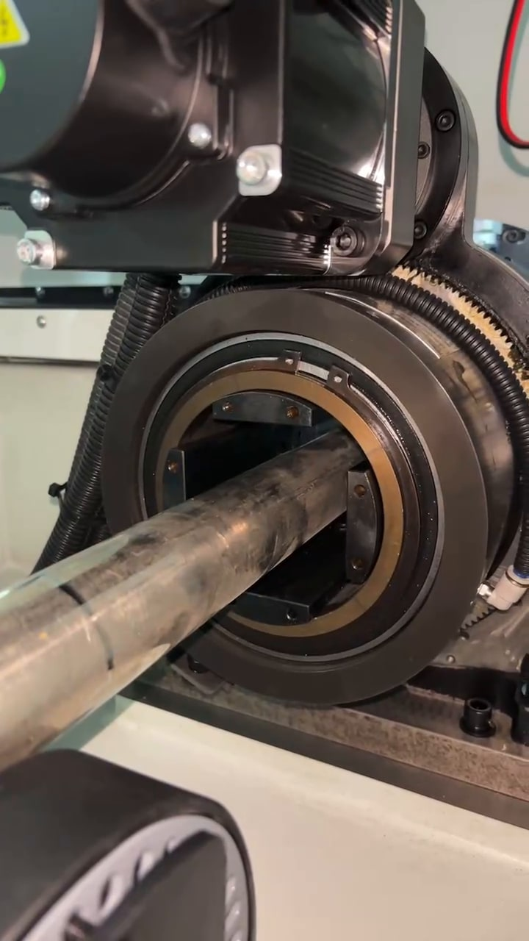
images/applications/cnc-pneumatic-clamping/bp-2p-130-custom-cnc-circular-saw-fixture-rear-view.jpg
