caoguangcheng9-lgtm/begapunk-website/images/cases/bp-2p-95-pneumatic-chuck/bp-2p-95-pneumatic-chuck-social.jpg

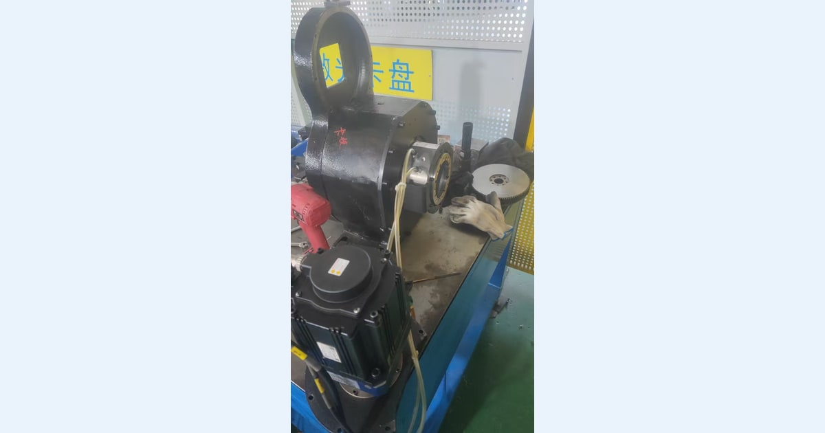
images/cases/bp-2p-95-pneumatic-chuck/bp-2p-95-pneumatic-chuck-social.jpg
