caoguangcheng9-lgtm/begapunk-website/images/cases/bp-2p-95-pneumatic-chuck/bp-2p-95-pneumatic-connection-detail.jpg

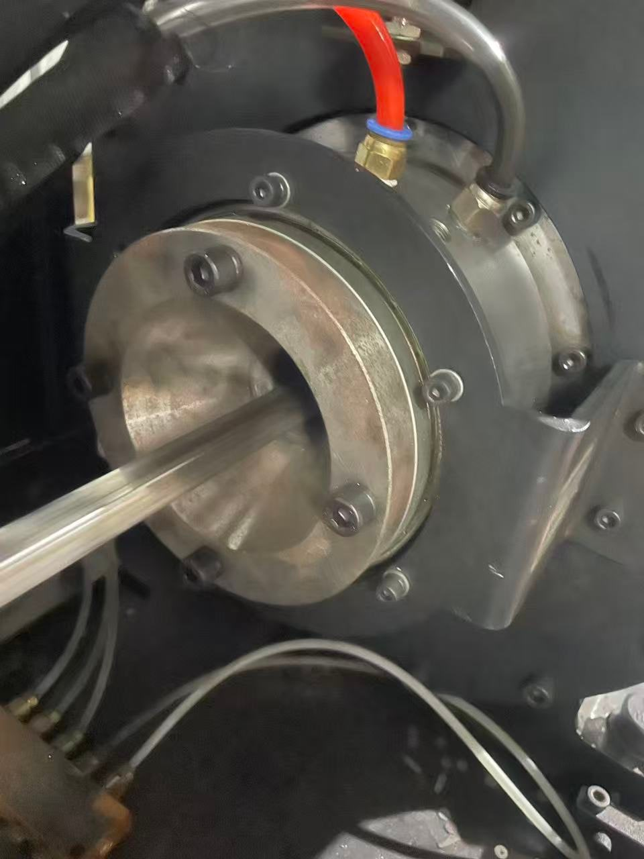
images/cases/bp-2p-95-pneumatic-chuck/bp-2p-95-pneumatic-connection-detail.jpg
