caoguangcheng9-lgtm/begapunk-website/images/cases/bp-3p-s06-sensor-monitored-chuck/bp-3p-s06-sensor-monitored-chuck-social.jpg

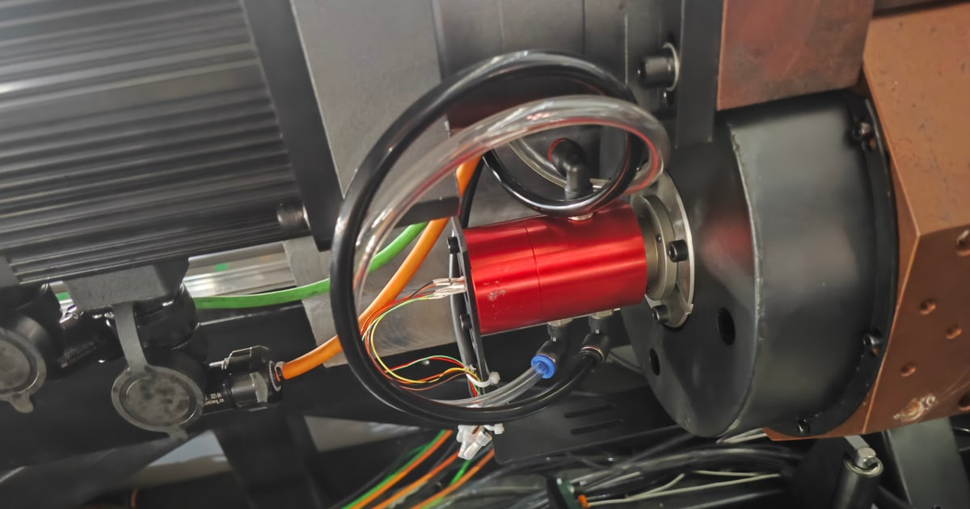
images/cases/bp-3p-s06-sensor-monitored-chuck/bp-3p-s06-sensor-monitored-chuck-social.jpg
