caoguangcheng9-lgtm/begapunk-website/images/cases/laser-tube-rear-chuck/laser-tube-rear-chuck-rotary-union-mounting-detail.webp

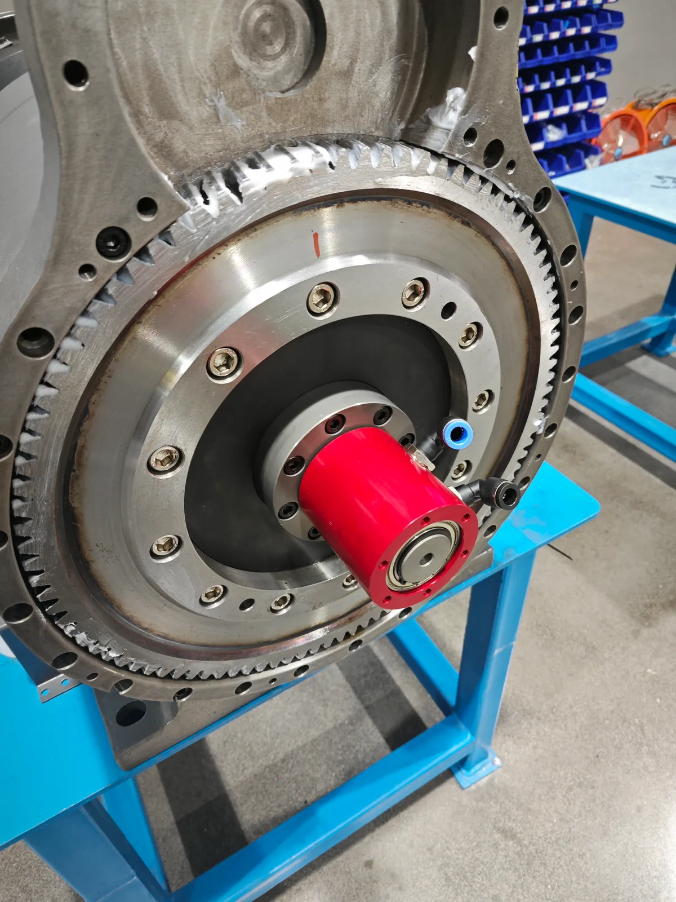
images/cases/laser-tube-rear-chuck/laser-tube-rear-chuck-rotary-union-mounting-detail.webp
