caoguangcheng9-lgtm/begapunk-website/images/cases/laser-tube-rear-chuck/laser-tube-rear-chuck-rotary-union-overview.webp

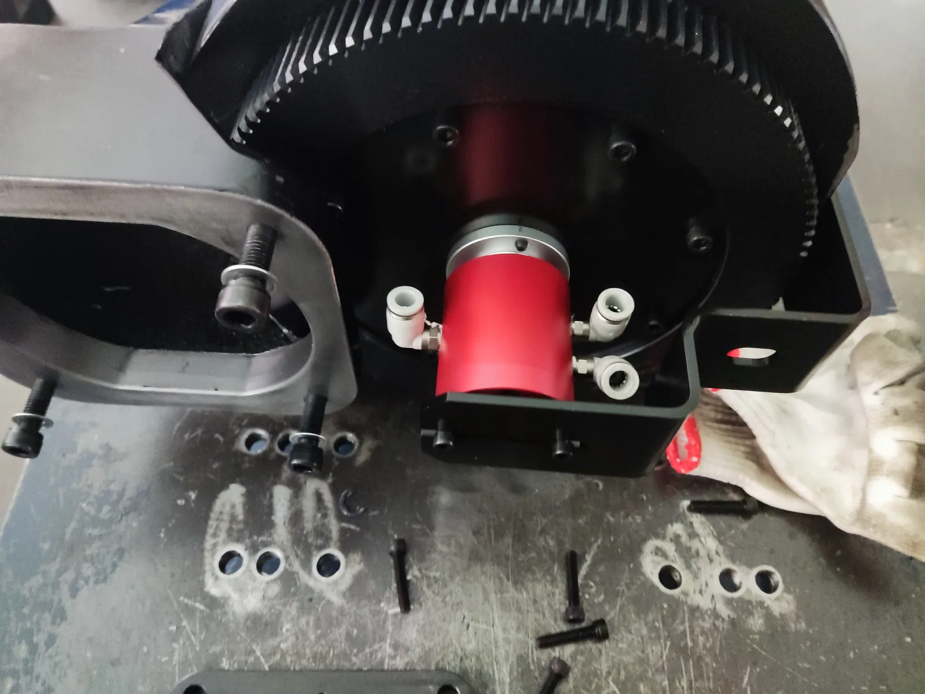
images/cases/laser-tube-rear-chuck/laser-tube-rear-chuck-rotary-union-overview.webp
