caoguangcheng9-lgtm/begapunk-website/images/knowledge/clearance-seal/rotary-union-clearance-seal-explainer-en.png

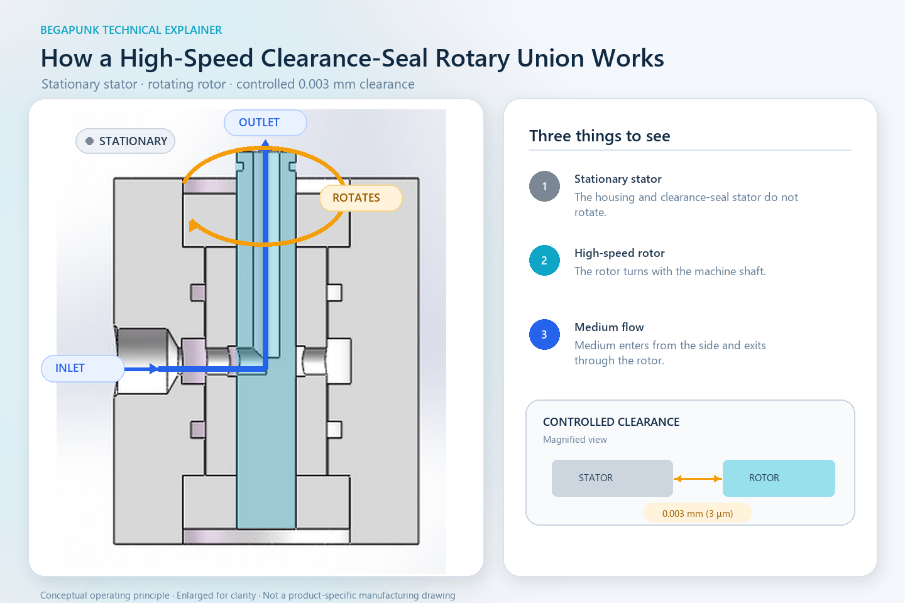
images/knowledge/clearance-seal/rotary-union-clearance-seal-explainer-en.png
