caoguangcheng9-lgtm/begapunk-website/images/knowledge/clearance-seal/rotary-union-clearance-seal-explainer-fr.png

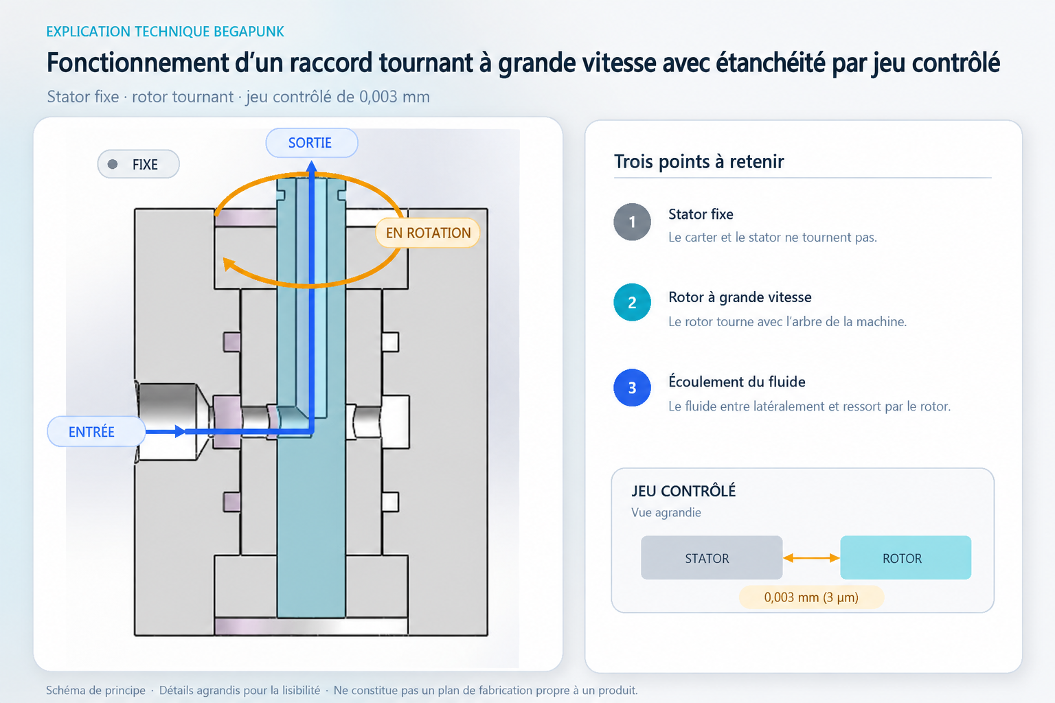
images/knowledge/clearance-seal/rotary-union-clearance-seal-explainer-fr.png
