caoguangcheng9-lgtm/begapunk-website/images/knowledge/ptfe-o-rings/coated-480.webp

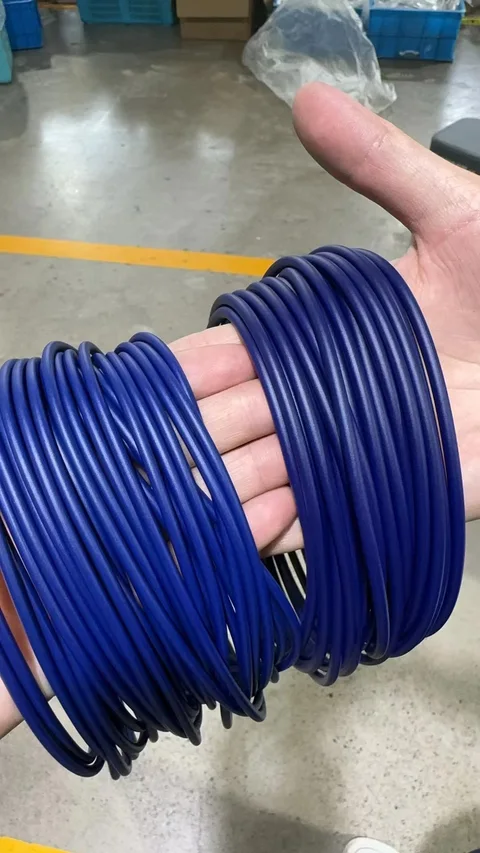
images/knowledge/ptfe-o-rings/coated-480.webp
