caoguangcheng9-lgtm/begapunk-website/images/knowledge/ptfe-o-rings/drying-480.webp

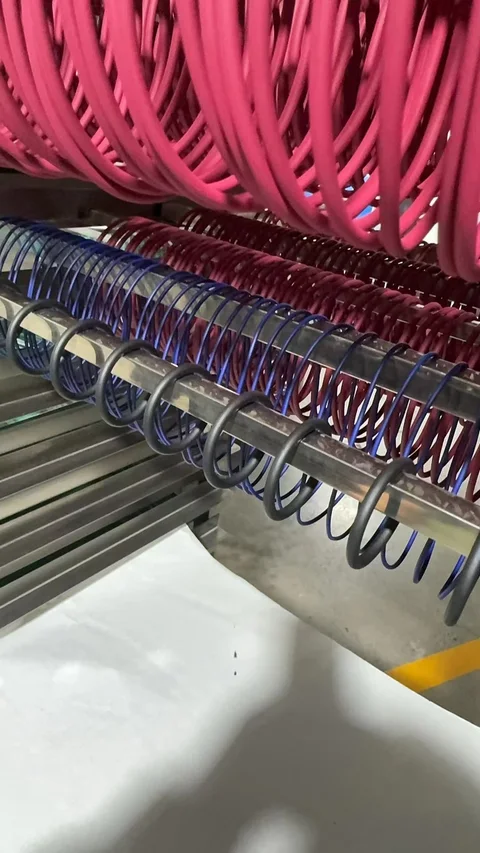
images/knowledge/ptfe-o-rings/drying-480.webp
