caoguangcheng9-lgtm/begapunk-website/images/knowledge/ptfe-o-rings/uncoated-480.webp

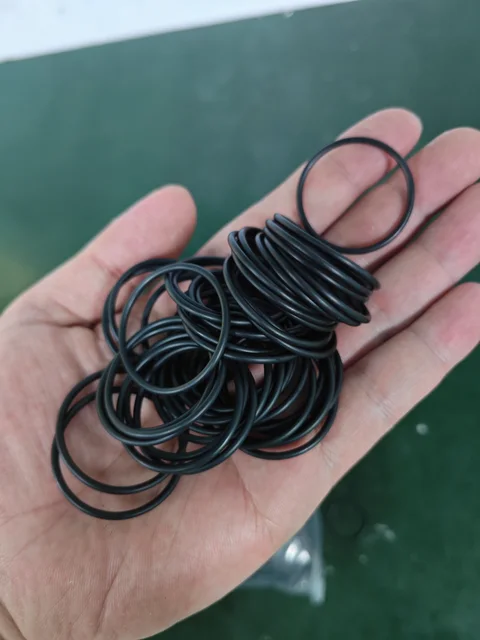
images/knowledge/ptfe-o-rings/uncoated-480.webp
