caoguangcheng9-lgtm/begapunk-website/images/optimized/2-in-2-out-Rotary-joint.webp

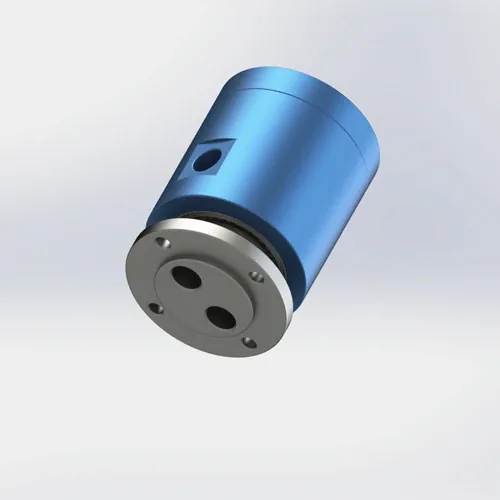
images/optimized/2-in-2-out-Rotary-joint.webp
