caoguangcheng9-lgtm/begapunk-website/images/optimized/3-in-3-out-M8-rotary-joint-3.webp

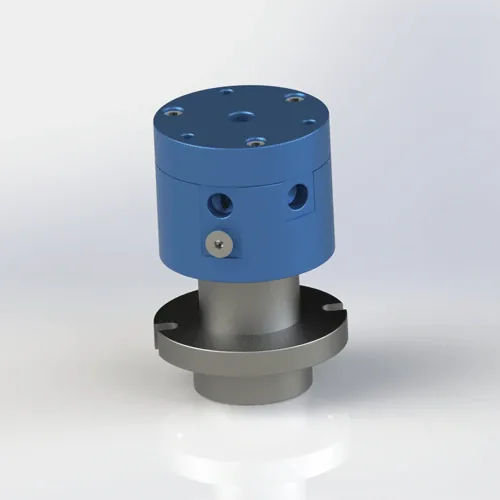
images/optimized/3-in-3-out-M8-rotary-joint-3.webp
