caoguangcheng9-lgtm/begapunk-website/images/optimized/4Jin-4Chu-1.webp

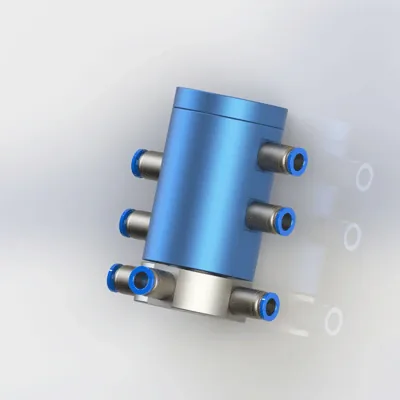
images/optimized/4Jin-4Chu-1.webp
