caoguangcheng9-lgtm/begapunk-website/images/optimized/Application-of-one-in-one-out-rotary-joint-packaging-machine.webp

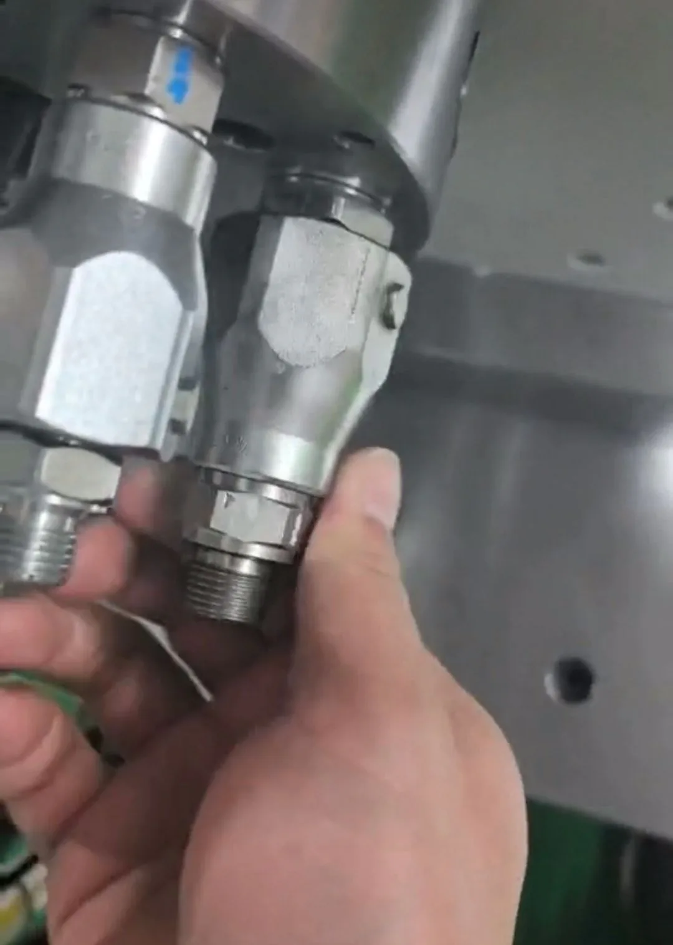
images/optimized/Application-of-one-in-one-out-rotary-joint-packaging-machine.webp
