caoguangcheng9-lgtm/begapunk-website/images/optimized/BEGAPUNK-factory-2.webp

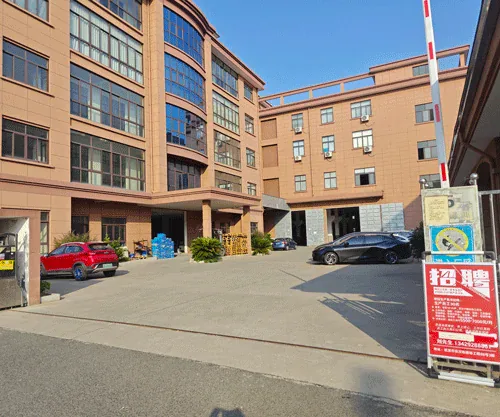
images/optimized/BEGAPUNK-factory-2.webp
