caoguangcheng9-lgtm/begapunk-website/images/optimized/BEGAPUNK-rotary-joint-employee-production-2.webp

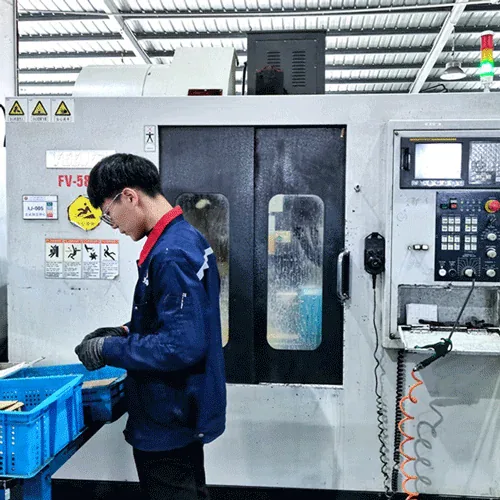
images/optimized/BEGAPUNK-rotary-joint-employee-production-2.webp
