caoguangcheng9-lgtm/begapunk-website/images/optimized/Dust-proof-rotary-joint-4.webp

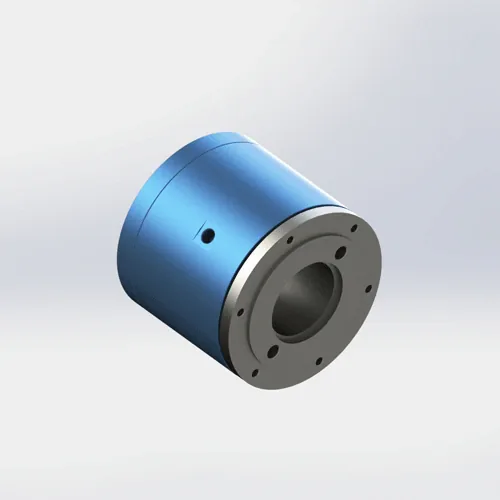
images/optimized/Dust-proof-rotary-joint-4.webp
