caoguangcheng9-lgtm/begapunk-website/images/optimized/hero-products-clean-640.webp

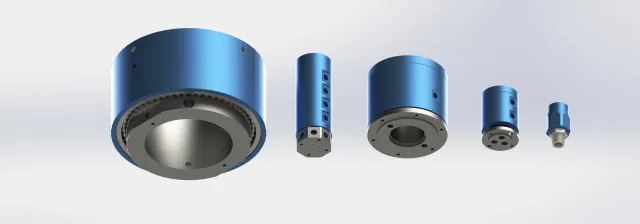
images/optimized/hero-products-clean-640.webp
