caoguangcheng9-lgtm/begapunk-website/images/optimized/products/BP-1P-0003-3.webp

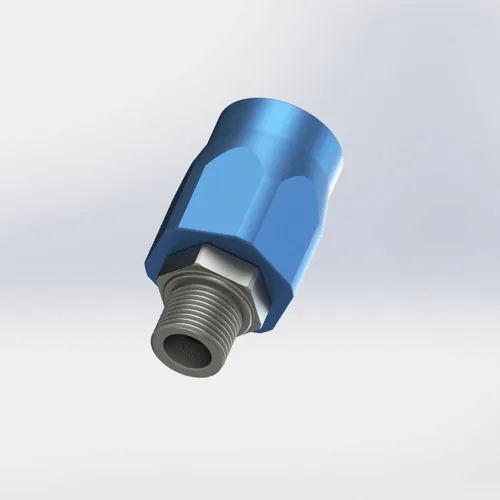
images/optimized/products/BP-1P-0003-3.webp
