caoguangcheng9-lgtm/begapunk-website/images/optimized/products/BP-1P-0006-1.webp

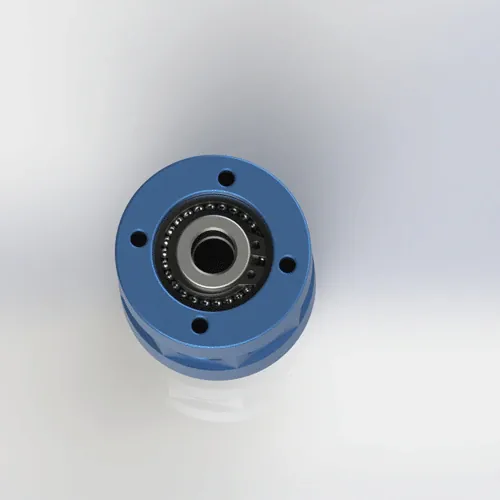
images/optimized/products/BP-1P-0006-1.webp
