caoguangcheng9-lgtm/begapunk-website/images/optimized/products/BP-1P-0006.webp

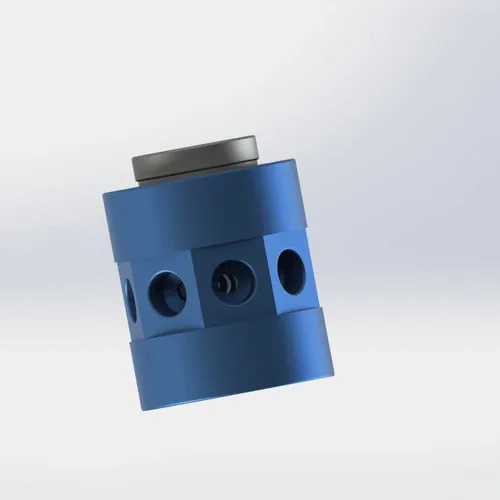
images/optimized/products/BP-1P-0006.webp
