caoguangcheng9-lgtm/begapunk-website/images/optimized/products/BP-2P-0001-2.webp

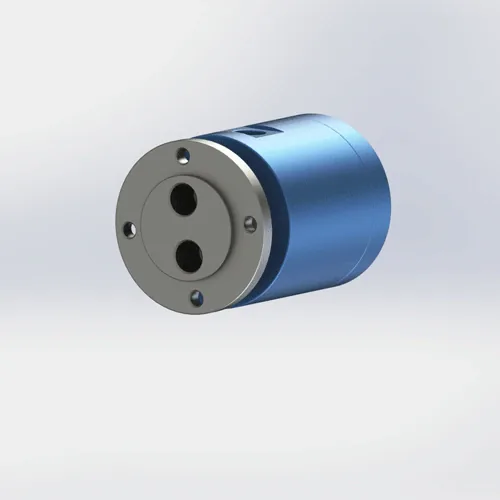
images/optimized/products/BP-2P-0001-2.webp
