caoguangcheng9-lgtm/begapunk-website/images/optimized/products/BP-2P-0002-1.webp

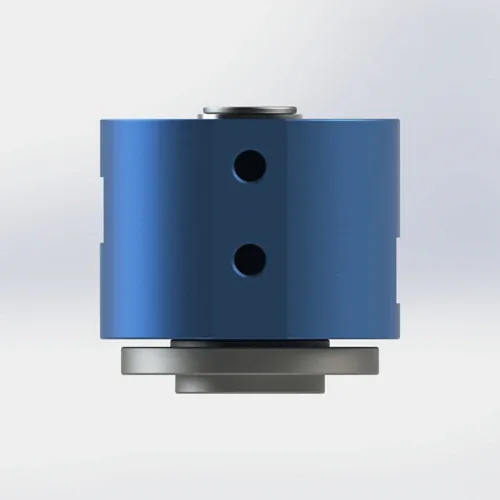
images/optimized/products/BP-2P-0002-1.webp
