caoguangcheng9-lgtm/begapunk-website/images/optimized/products/BP-2P-30-0001.webp

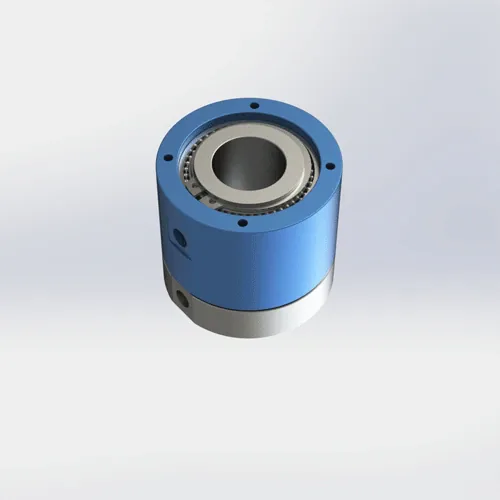
images/optimized/products/BP-2P-30-0001.webp
