caoguangcheng9-lgtm/begapunk-website/images/optimized/products/BP-2P-95-0005-3.webp

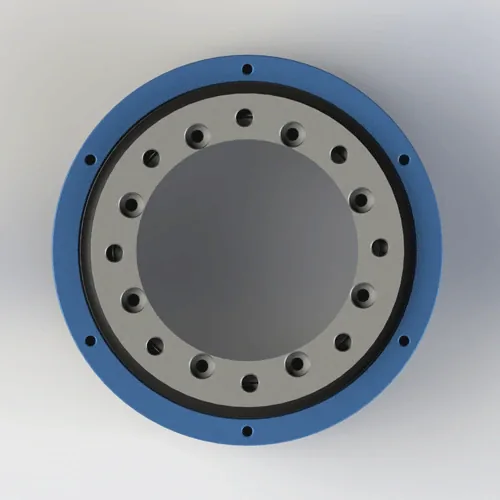
images/optimized/products/BP-2P-95-0005-3.webp
