caoguangcheng9-lgtm/begapunk-website/images/optimized/products/BP-2P-130-0001-1.webp

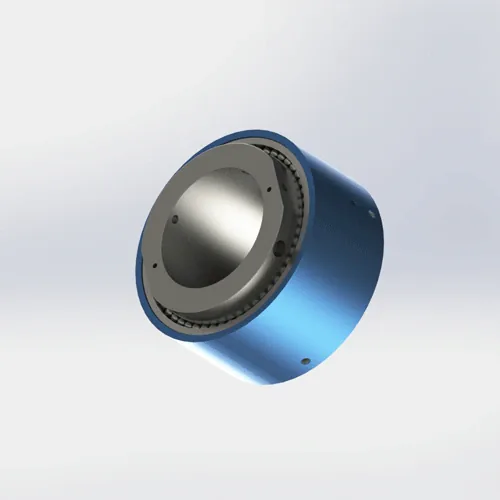
images/optimized/products/BP-2P-130-0001-1.webp
