caoguangcheng9-lgtm/begapunk-website/images/optimized/products/BP-3P-0004-3.webp

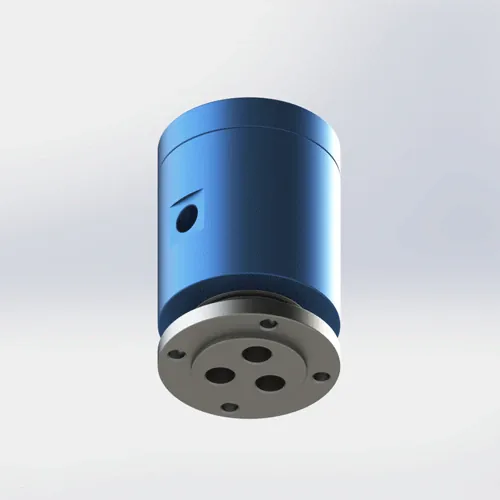
images/optimized/products/BP-3P-0004-3.webp
