caoguangcheng9-lgtm/begapunk-website/images/optimized/products/BP-3P-0006.webp

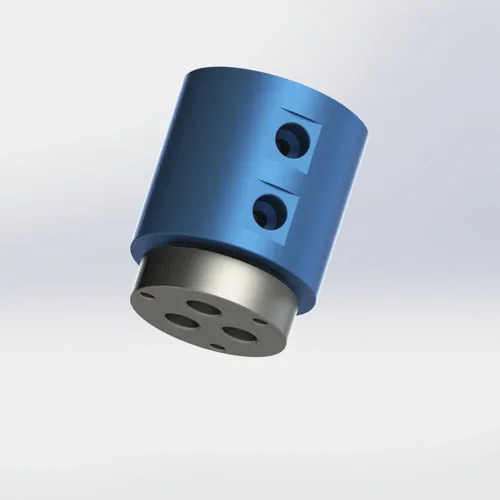
images/optimized/products/BP-3P-0006.webp
