caoguangcheng9-lgtm/begapunk-website/images/optimized/products/BP-3P-S06-0001/BP-3P-S06-0001-2.webp

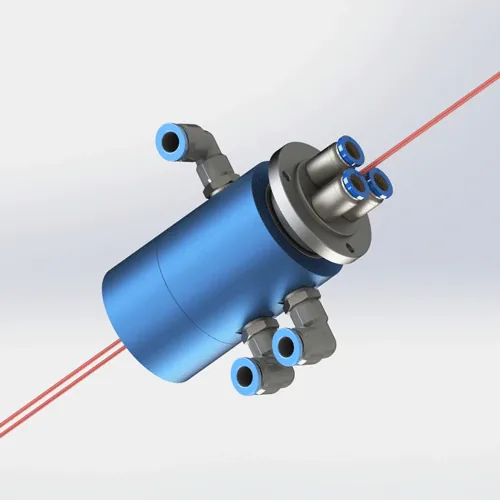
images/optimized/products/BP-3P-S06-0001/BP-3P-S06-0001-2.webp
