caoguangcheng9-lgtm/begapunk-website/images/optimized/products/BP-4P-30-0001/BP-4P-30-0001.webp

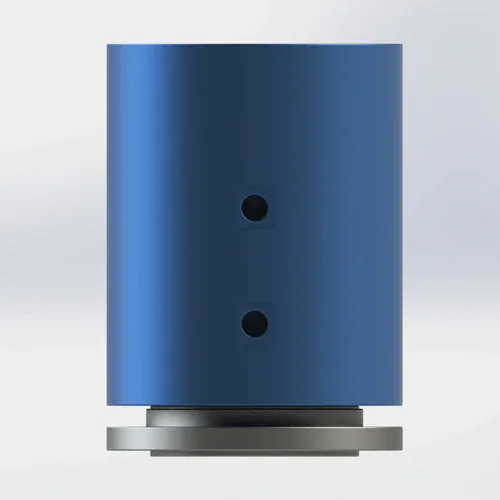
images/optimized/products/BP-4P-30-0001/BP-4P-30-0001.webp
