caoguangcheng9-lgtm/begapunk-website/images/optimized/products/BP-8P-0001-3.webp

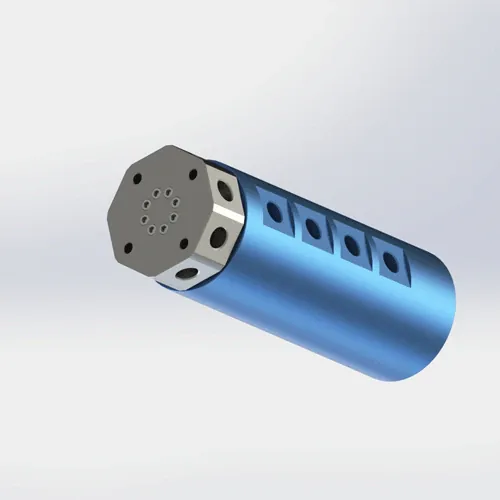
images/optimized/products/BP-8P-0001-3.webp
