caoguangcheng9-lgtm/begapunk-website/images/optimized/products/bp-10p-0001-detail.webp

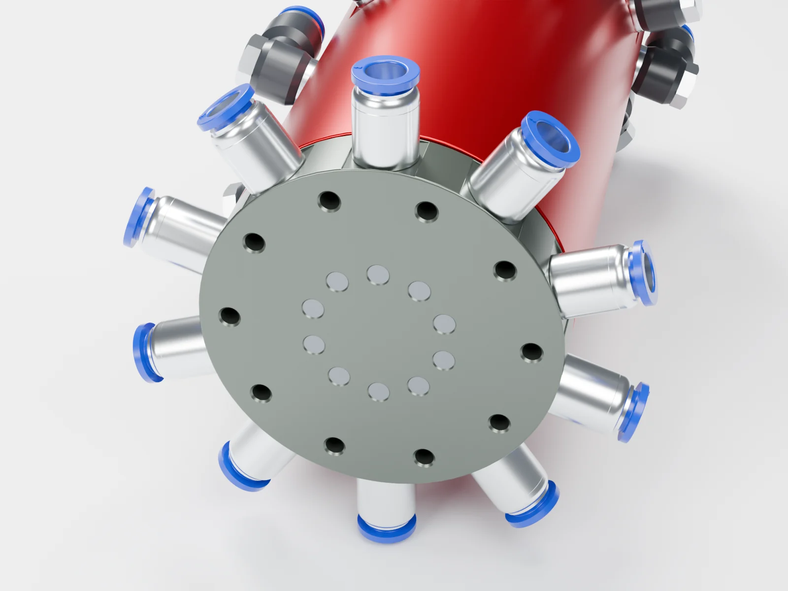
images/optimized/products/bp-10p-0001-detail.webp
