caoguangcheng9-lgtm/begapunk-website/images/optimized/products/BP-10P-0001-drawing.png

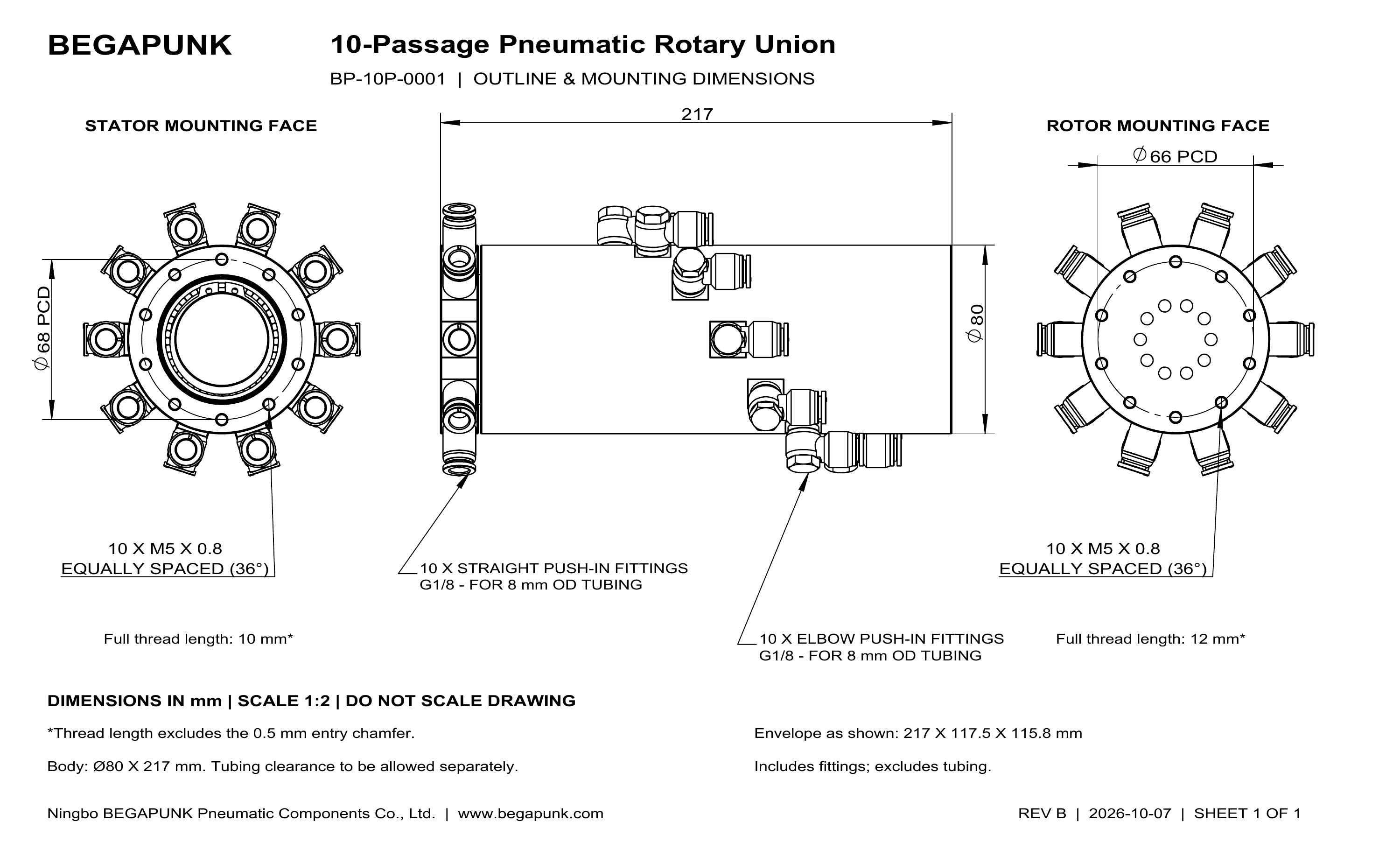
images/optimized/products/BP-10P-0001-drawing.png
