caoguangcheng9-lgtm/begapunk-website/images/optimized/products/bp-10p-0001-rear.webp

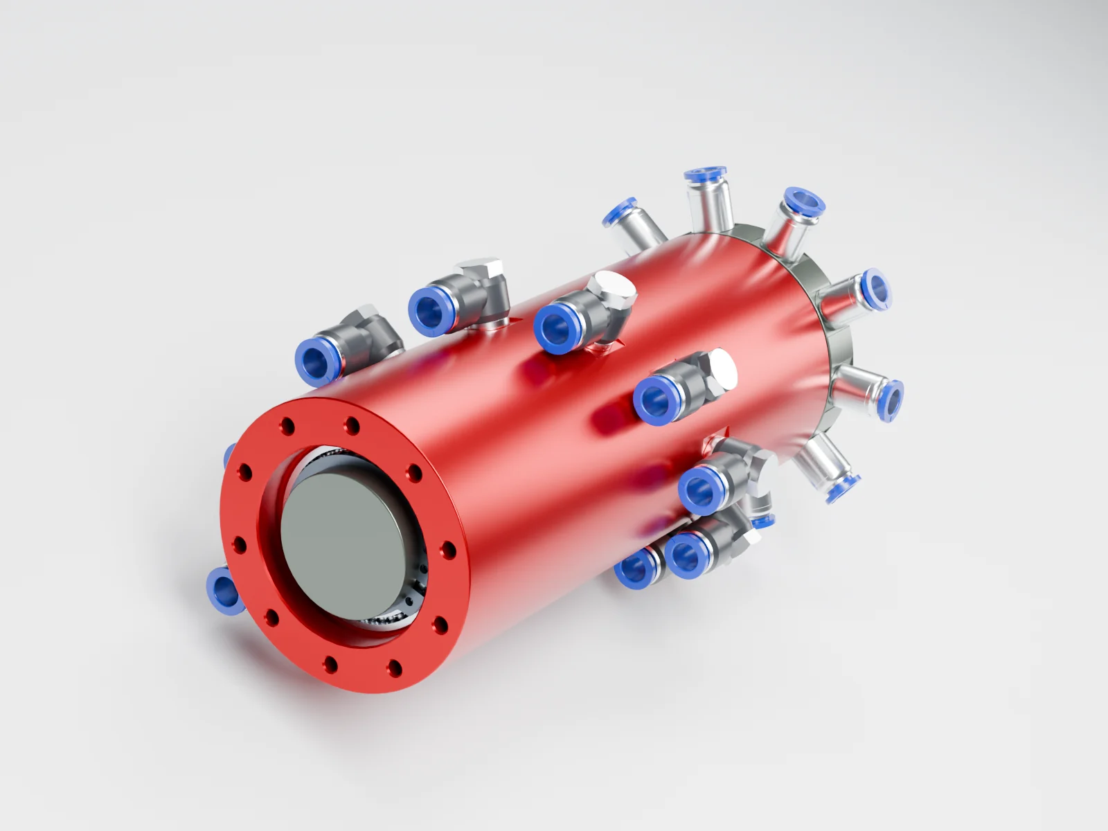
images/optimized/products/bp-10p-0001-rear.webp
