caoguangcheng9-lgtm/begapunk-website/images/optimized/products/BP-10P-0001-video-cover.jpg

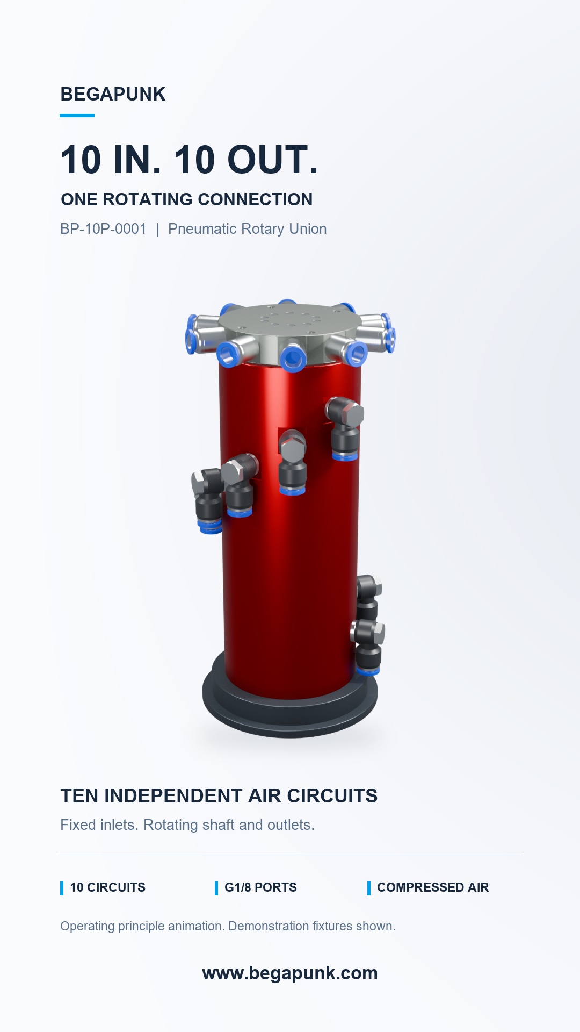
images/optimized/products/BP-10P-0001-video-cover.jpg
