caoguangcheng9-lgtm/begapunk-website/images/optimized/Rotary-joint-structure-diagram.webp

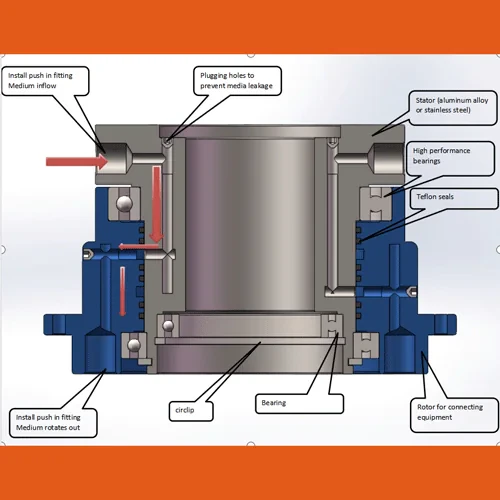
images/optimized/Rotary-joint-structure-diagram.webp
