caoguangcheng9-lgtm/begapunk-website/images/optimized/She-Bei-Zhao-Pian-2.webp

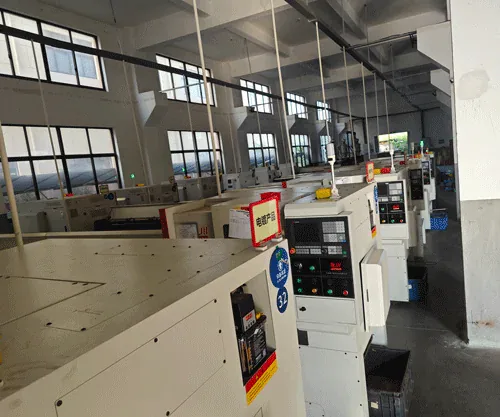
images/optimized/She-Bei-Zhao-Pian-2.webp
