caoguangcheng9-lgtm/begapunk-website/images/optimized/Working-principle-of-rotary-joint.webp

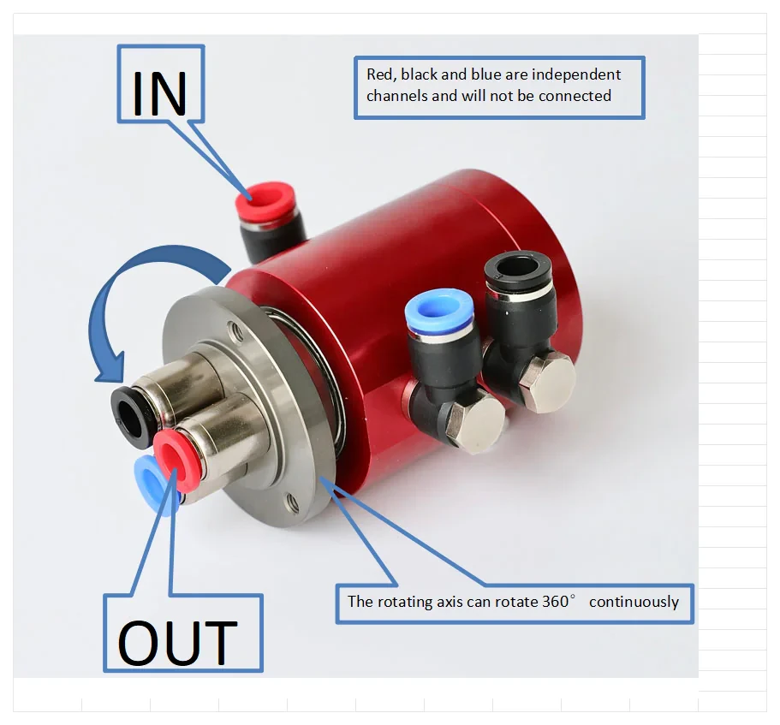
images/optimized/Working-principle-of-rotary-joint.webp
