caoguangcheng9-lgtm/begapunk-website/images/products/BP-1P-0003-2.png

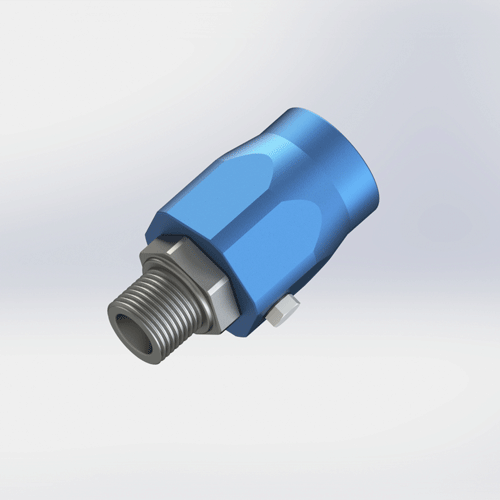
images/products/BP-1P-0003-2.png
