caoguangcheng9-lgtm/begapunk-website/images/products/BP-2P-08-0001-2.png

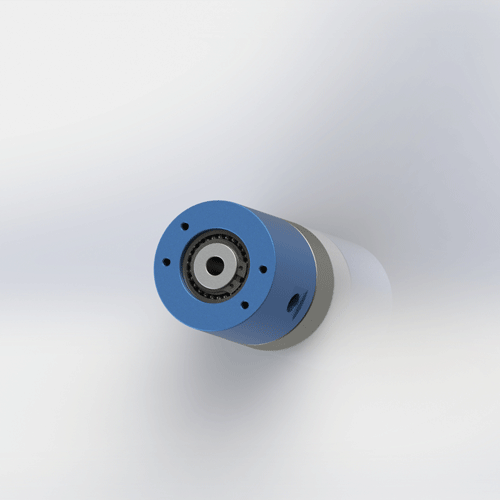
images/products/BP-2P-08-0001-2.png
