caoguangcheng9-lgtm/begapunk-website/images/products/BP-2P-16-0001-2.png

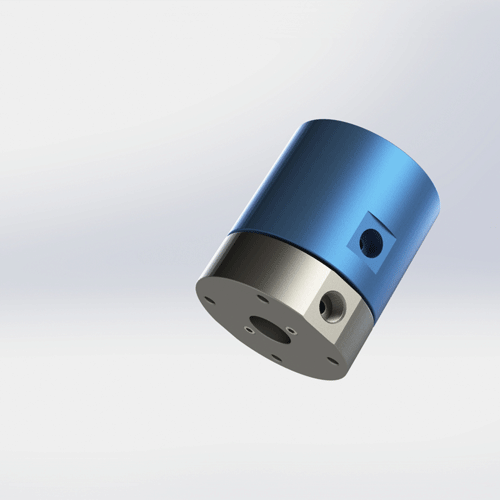
images/products/BP-2P-16-0001-2.png
