caoguangcheng9-lgtm/begapunk-website/images/products/BP-2P-95-0005-2.png

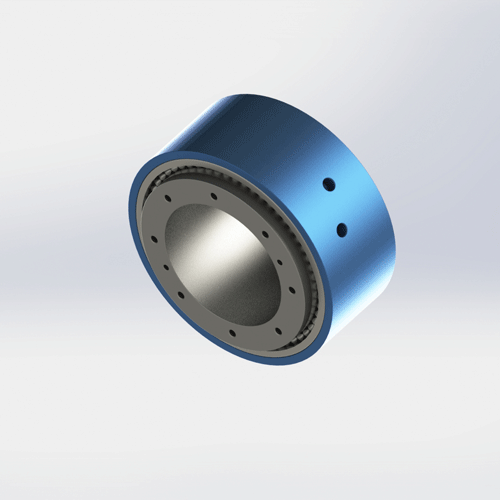
images/products/BP-2P-95-0005-2.png
