caoguangcheng9-lgtm/begapunk-website/images/products/BP-3P-0004-2.png

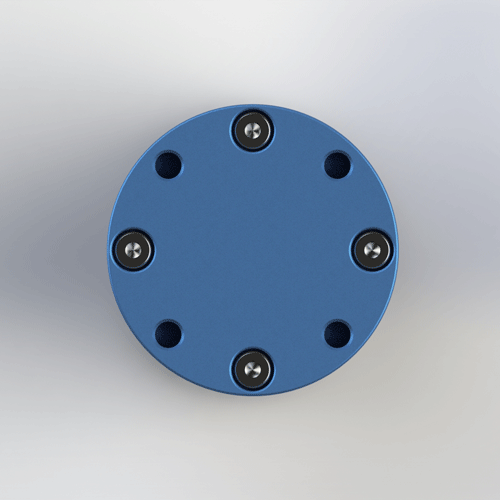
images/products/BP-3P-0004-2.png
