caoguangcheng9-lgtm/begapunk-website/images/products/BP-3P-0006-1.png

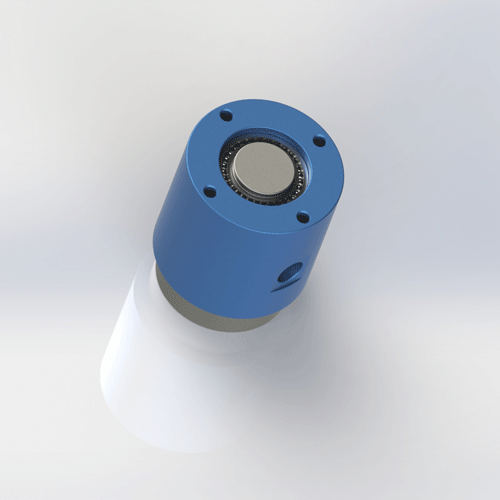
images/products/BP-3P-0006-1.png
