caoguangcheng9-lgtm/begapunk-website/images/products/BP-8P-0001-2.png

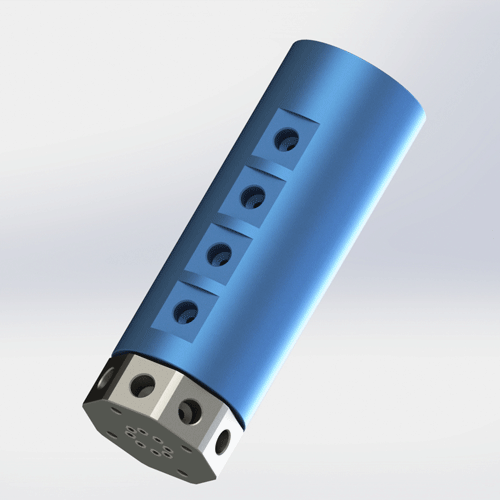
images/products/BP-8P-0001-2.png
