caoguangcheng9-lgtm/begapunk-website/images/social/BP-1P-0003-social.jpg

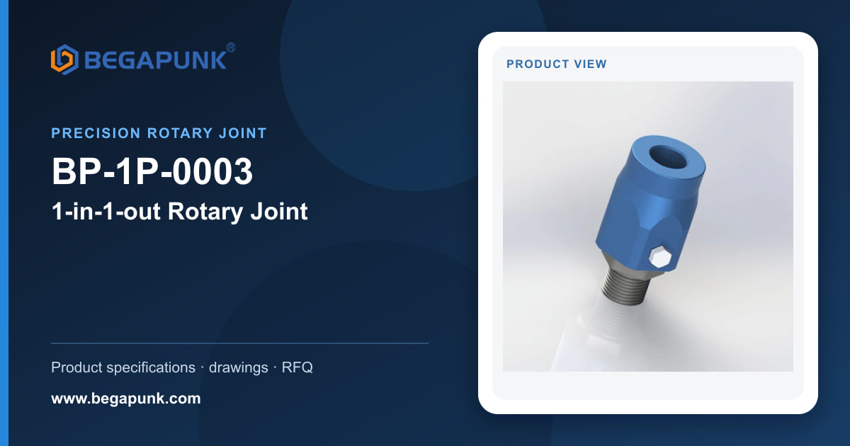
images/social/BP-1P-0003-social.jpg
