caoguangcheng9-lgtm/begapunk-website/images/social/BP-2P-0002-social.jpg

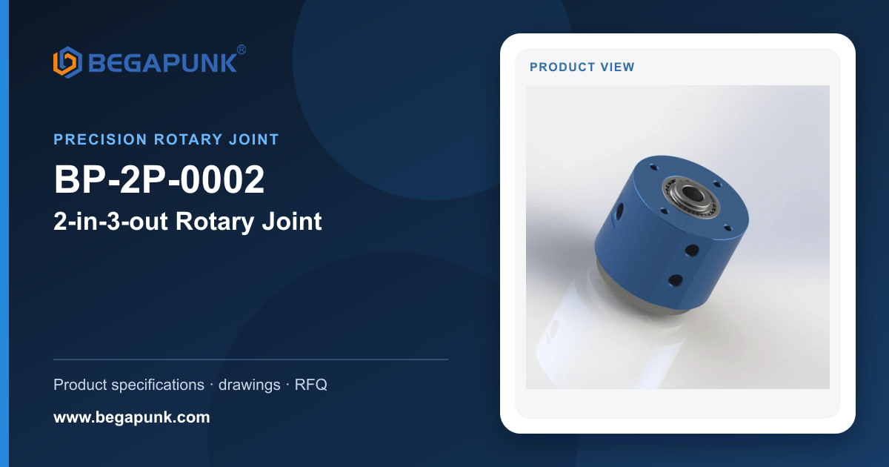
images/social/BP-2P-0002-social.jpg
