caoguangcheng9-lgtm/begapunk-website/images/social/BP-2P-30-0001-social.jpg

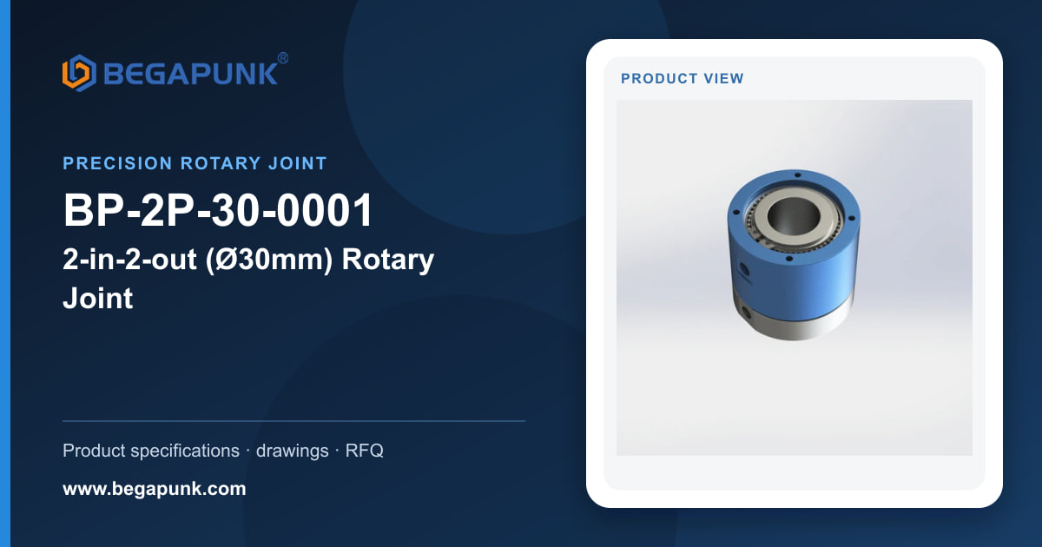
images/social/BP-2P-30-0001-social.jpg
