caoguangcheng9-lgtm/begapunk-website/images/social/BP-3P-0004-social.jpg

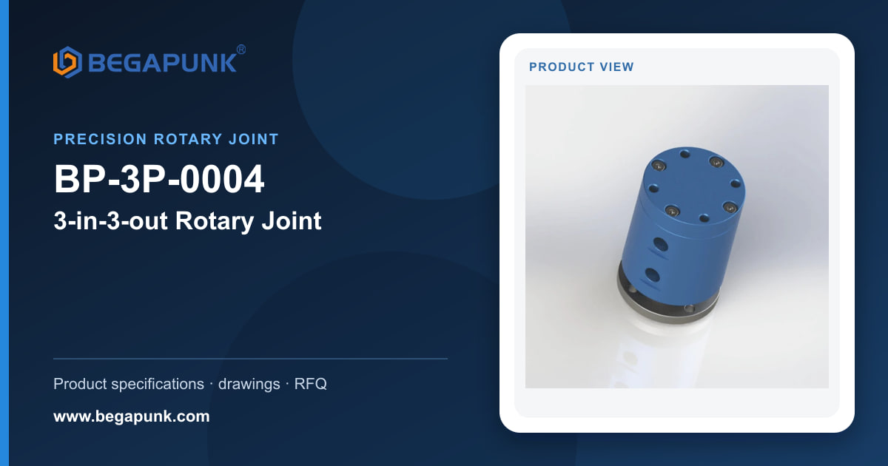
images/social/BP-3P-0004-social.jpg
