caoguangcheng9-lgtm/begapunk-website/images/social/BP-3P-S06-0001-social.jpg

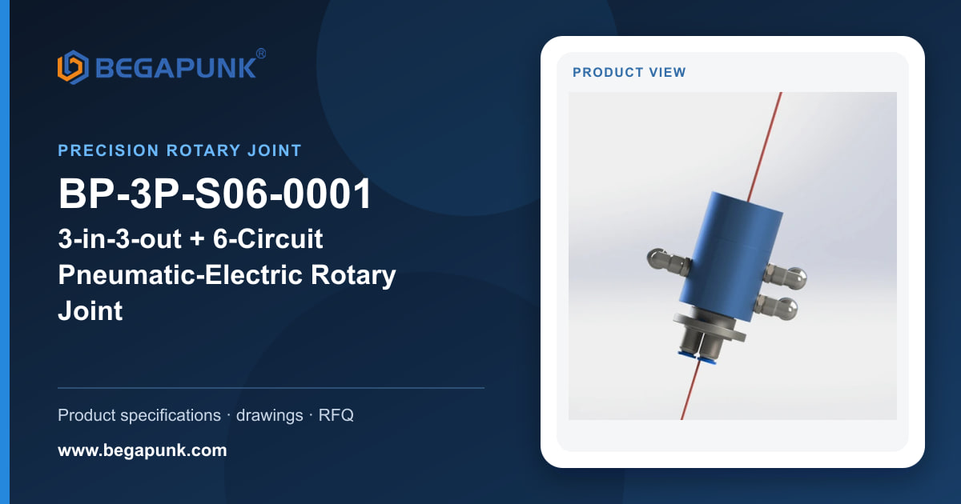
images/social/BP-3P-S06-0001-social.jpg
