caoguangcheng9-lgtm/begapunk-website/images/social/BP-8P-0001-social.jpg

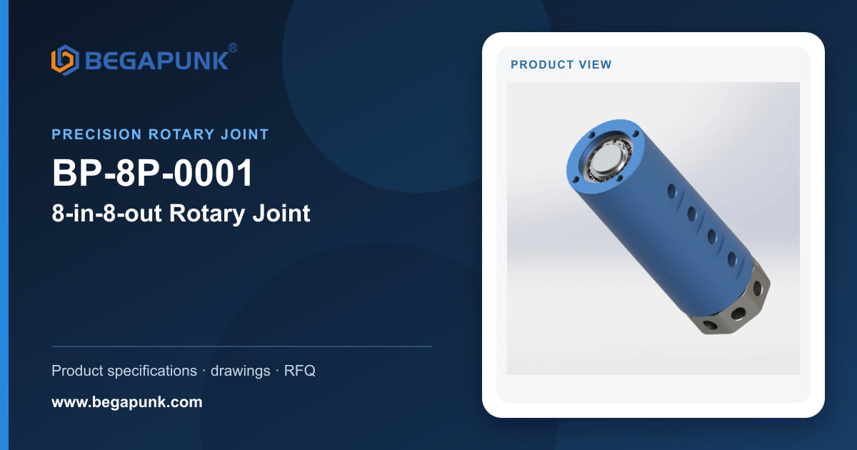
images/social/BP-8P-0001-social.jpg
