caoguangcheng9-lgtm/begapunk-website/audit/fact-resolution/phase-1e-a/evidence-cards/02-BP-1P-0003-material-surface.md

# 冲突名称

BP-1P-0003 材料与表面处理矛盾

## 涉及型号

BP-1P-0003

## 网页当前值

* 数值：45#钢为标准主体；6061-T6铝为轻量选项
* 页面：`BP-1P-0003.html`
* 具体章节：Product JSON-LD；Specifications / Body Material；Material & Seal Selection Notes
* 原文：`45# steel (domestic standard) / aluminum optional`；`45# steel (standard) / 6061-T6 aluminum (lightweight option)`
* 定位：HTML 第57行、第251行、第263行

## PDF当前值

* 数值：材料为 Steel 45#；表面处理为 Anodized (Aluminum)
* 文件路径：`downloads/BP-1P-0003.pdf`
* PDF内部标题：BP-1P-0003 Rotary Joint
* PDF页码：第1页
* 原文或参数表字段：`Material Steel 45#`；`Surface Treatment Anodized (Aluminum)`
* 图纸编号/文控号：QC-2025-0822-001
* 修订号：未标注
* 日期：2025-08-22（PDF元数据创建时间为2026-05-11）
* 可视证据：[02-BP-1P-0003-material-surface-pdf-page-1.png](../evidence-images/02-BP-1P-0003-material-surface-pdf-page-1.png)

## 参数表当前值

* 数值：壳体材料 45#钢；未列表面处理
* 文件路径：`downloads/BP-1P-0003_参数表.xlsx`
* 工作表名称：`Sheet1`
* 单元格：`A9`（字段“壳体材料”）、`B9`（值）
* 原始字段：`45#钢`

## 其他证据

产品图片未显示可清晰识别的铭牌材料或表面处理标识，不能用于裁决。既有 Phase 1B 冲突表认为PDF可能混入模板字段或不同选项。

## 冲突说明

同一PDF同时写45#钢和“铝阳极氧化”，材料与处理工艺无法直接对应。客户可能因此误判防腐能力、采购版本和材料证书范围。

## Codex不能确定的内容

不能确定哪个零件为铝材，也不能确定标准钢制版本采用镀镍、发黑、无处理或其他工艺。

## 需要Begapunk确认的问题

请按零件/版本确认主体、轴及外壳材料，并确认每个版本的标准表面处理；材料和表面处理应作为关联问题一并确认。

## 选择项

* [ ] 网页值正确
* [ ] PDF值正确
* [ ] 参数表值正确
* [ ] 各自适用于不同版本
* [ ] 全部不正确
* [ ] 暂时无法确认

## 正确值或说明

## 正确资料文件名

## 是否允许修改网站

* [ ] 允许
* [ ] 暂不允许
