caoguangcheng9-lgtm/begapunk-website/audit/fact-resolution/phase-1e-a/evidence-cards/04-BP-2P-0001-material.md

# 冲突名称

BP-2P-0001 材料范围冲突

## 涉及型号

BP-2P-0001

## 网页当前值

* 数值：AL6061铝壳体 + 45#钢轴
* 页面：`BP-2P-0001.html`
* 具体章节：Product JSON-LD；Specifications / Body Material；Material & Seal Selection Notes
* 原文：`AL6061 aluminum + 45# steel`；`AL6061 + 45# Steel`
* 定位：HTML 第62行、第186行、第254行、第262行、第273行

## PDF当前值

* 数值：Material = Aluminum Alloy 6061；未在材料栏列出45#钢轴
* 文件路径：`downloads/BP-2P-0001.pdf`
* PDF内部标题：BP-2P-0001 Rotary Joint
* PDF页码：第1页
* 原文或参数表字段：`Material Aluminum Alloy 6061`
* 图纸编号/文控号：QC-2025-0512-003
* 修订号：未标注
* 日期：2025-05-12（PDF元数据创建时间为2026-05-11）
* 可视证据：[04-BP-2P-0001-material-pdf-page-1.png](../evidence-images/04-BP-2P-0001-material-pdf-page-1.png)

## 参数表当前值

未找到该型号独立XLS/XLSX参数表。

## 其他证据

`downloads/BP-2P-0001_draft.pdf` 第1页同样仅写 Aluminum Alloy 6061。产品图片没有可清晰读取的材料铭牌。PDF材料栏也可能只描述主壳体，不能据此排除钢制零件。

## 冲突说明

网页按零件描述混合材料，PDF只给单一材料字段。客户可能无法判断45#钢是否真实存在、用于哪个零件，以及材料证书应覆盖哪些部件。

## Codex不能确定的内容

不能从总装图材料栏确认轴的实际材料，也不能确认网页所述45#钢是否来自当前BOM。

## 需要Begapunk确认的问题

请依据当前BOM确认壳体、轴、法兰等主要零件材料，并说明PDF材料栏是否仅代表壳体。

## 选择项

* [ ] 网页值正确
* [ ] PDF值正确
* [ ] 参数表值正确
* [ ] 各自适用于不同版本
* [ ] 全部不正确
* [ ] 暂时无法确认

## 正确值或说明

## 正确资料文件名

## 是否允许修改网站

* [ ] 允许
* [ ] 暂不允许
