caoguangcheng9-lgtm/begapunk-website/audit/technical-repairs/phase-1d/phase-1d-js-changes.csv

page | original_script_location | original_error | root_cause | reference_page | before | after | mobile_menu_test | copy_link_test | header_scroll_test | console_error_test | validation_status
blog-rotary-joint-selection.html | inline script at end of body, original lines 600-635; error line 619 | SyntaxError: Unexpected token ',' | A copy-link/copy-feedback block was partially removed, leaving the orphaned ', 2000);' callback tail, unmatched closings, and references to undefined btn/url variables. | blog-rotary-joint-leaking.html, inline script lines 595-636 | Valid menu/header prefix followed by an orphaned ', 2000);' and the incomplete tail of the copyLink fallback/feedback block. | Complete null-guarded menu handler; synchronized active/aria-expanded state; guarded header scroll where applicable; complete copyLink with Clipboard API, explicit fallback/error reporting, rapid-click-safe Copied feedback, and two-second restoration. | pass: three open/close cycles; final closed; button state synchronized | pass: function-level real-click harness copied current URL, survived rapid repeat, and restored feedback after about two seconds | pass | pass: zero new syntax or runtime errors | pass
blog-rotary-joint-materials.html | inline script at end of body, original lines 593-628; error line 612 | SyntaxError: Unexpected token ',' | A copy-link/copy-feedback block was partially removed, leaving the orphaned ', 2000);' callback tail, unmatched closings, and references to undefined btn/url variables. | blog-rotary-joint-leaking.html, inline script lines 595-636 | Valid menu/header prefix followed by an orphaned ', 2000);' and the incomplete tail of the copyLink fallback/feedback block. | Complete null-guarded menu handler; synchronized active/aria-expanded state; guarded header scroll where applicable; complete copyLink with Clipboard API, explicit fallback/error reporting, rapid-click-safe Copied feedback, and two-second restoration. | pass: three open/close cycles; final closed; button state synchronized | pass: function-level real-click harness copied current URL, survived rapid repeat, and restored feedback after about two seconds | pass | pass: zero new syntax or runtime errors | pass
blog-threaded-vs-flange.html | inline script at end of body, original lines 580-615; error line 599 | SyntaxError: Unexpected token ',' | A copy-link/copy-feedback block was partially removed, leaving the orphaned ', 2000);' callback tail, unmatched closings, and references to undefined btn/url variables. | blog-rotary-joint-leaking.html, inline script lines 595-636 | Valid menu/header prefix followed by an orphaned ', 2000);' and the incomplete tail of the copyLink fallback/feedback block. | Complete null-guarded menu handler; synchronized active/aria-expanded state; guarded header scroll where applicable; complete copyLink with Clipboard API, explicit fallback/error reporting, rapid-click-safe Copied feedback, and two-second restoration. | pass: three open/close cycles; final closed; button state synchronized | pass: function-level real-click harness copied current URL, survived rapid repeat, and restored feedback after about two seconds | pass | pass: zero new syntax or runtime errors | pass
blog-rotary-union-seal-types.html | inline script at end of body, original lines 661-683; error line 667 | SyntaxError: Unexpected token ',' | A copy-link/copy-feedback block was partially removed, leaving the orphaned ', 2000);' callback tail, unmatched closings, and references to undefined btn/url variables. | blog-rotary-joint-leaking.html, inline script lines 595-636 | Valid menu/header prefix followed by an orphaned ', 2000);' and the incomplete tail of the copyLink fallback/feedback block. | Complete null-guarded menu handler; synchronized active/aria-expanded state; guarded header scroll where applicable; complete copyLink with Clipboard API, explicit fallback/error reporting, rapid-click-safe Copied feedback, and two-second restoration. | pass: three open/close cycles; final closed; button state synchronized | pass: function-level real-click harness copied current URL, survived rapid repeat, and restored feedback after about two seconds | not applicable: no header-scroll handler existed in the original page script | pass: zero new syntax or runtime errors | pass
