caoguangcheng9-lgtm/begapunk-website/audit/localization/i18n-build-missing-translations-20260801.csv

language | source_id | english_source | pages | aida_decision_required
de | 33b6dca29fd6ca3a | (2-passage air model with protective shroud and labyrinth; no certified IP rating claimed), | applications.html | Approve a persistent localized translation or explicitly classify the source as non-translatable.
de | fbc0739fca2a146c | (protective shroud and labyrinth for dusty environments; no certified IP rating claimed), | applications.html | Approve a persistent localized translation or explicitly classify the source as non-translatable.
de | fe3fdbb43cbbb86c | / BP-2P-0001 · 2-Passage Pneumatic Rotary Union | BP-2P-0001.html | Approve a persistent localized translation or explicitly classify the source as non-translatable.
de | 45a235ccb97ed538 | / BP-2P-30-0001 · 2-Passage Through-Bore Pneumatic Rotary Union (Ø30 mm Bore) | BP-2P-30-0001.html | Approve a persistent localized translation or explicitly classify the source as non-translatable.
de | d1679f6e7531ea56 | / BP-3P-S06-0001 · 3-Passage + 6-Circuit Pneumatic-Electric Rotary Union | BP-3P-S06-0001.html | Approve a persistent localized translation or explicitly classify the source as non-translatable.
de | f527b792e9f62b30 | / BP-4P-30-0001 · 4-Passage Through-Bore Pneumatic Rotary Union (Ø30 mm Bore) | BP-4P-30-0001.html | Approve a persistent localized translation or explicitly classify the source as non-translatable.
de | 1b73d214302a11de | / BP-1P-0003 — Single-Passage Pneumatic Rotary Union | BP-1P-0003.html | Approve a persistent localized translation or explicitly classify the source as non-translatable.
de | 5f28667d365c8154 | / BP-1P-0006 · 1-Inlet/6-Outlet Pneumatic Rotary Union (4 mm Orifice) | BP-1P-0006.html | Approve a persistent localized translation or explicitly classify the source as non-translatable.
de | dc80e63424602032 | / BP-2P-0002 · 2-Inlet/3-Outlet Pneumatic Rotary Union (4 mm Orifice) | BP-2P-0002.html | Approve a persistent localized translation or explicitly classify the source as non-translatable.
de | ccfb2a4000a811a2 | / BP-2P-08-0001 · Compact 2-Passage Pneumatic Rotary Union | BP-2P-08-0001.html | Approve a persistent localized translation or explicitly classify the source as non-translatable.
de | be86629376dd0d09 | / BP-2P-130-0001 · Heavy-Duty 2-Passage Pneumatic Rotary Union | BP-2P-130-0001.html | Approve a persistent localized translation or explicitly classify the source as non-translatable.
de | 5c97fe70e44072d5 | / BP-2P-16-0001 · 2-Passage Through-Bore Pneumatic Rotary Union (16 mm Bore) | BP-2P-16-0001.html | Approve a persistent localized translation or explicitly classify the source as non-translatable.
de | 6e52627d98f9ee20 | / BP-2P-50-0001 · Dust-Resistant 2-Passage Pneumatic Rotary Union | BP-2P-50-0001.html | Approve a persistent localized translation or explicitly classify the source as non-translatable.
de | 44cc98695777ac15 | / BP-2P-95-0001 · 2-Inlet/4-Outlet Pneumatic Rotary Union | BP-2P-95-0001.html | Approve a persistent localized translation or explicitly classify the source as non-translatable.
de | d5ed5decd751a0ef | / BP-3P-0004 · 3-Passage Pneumatic Rotary Union | BP-3P-0004.html | Approve a persistent localized translation or explicitly classify the source as non-translatable.
de | f558b8acc9af438c | / BP-3P-0006 · 3-Passage Pneumatic Rotary Union (G1/4) | BP-3P-0006.html | Approve a persistent localized translation or explicitly classify the source as non-translatable.
de | fb14a087fd7e82f5 | / BP-3P-0007 · Compact 3-Passage Pneumatic Rotary Union (4 mm Orifice) | BP-3P-0007.html | Approve a persistent localized translation or explicitly classify the source as non-translatable.
de | 49270950a2df7892 | / BP-8P-0001 · 8-Passage Pneumatic Rotary Union | BP-8P-0001.html | Approve a persistent localized translation or explicitly classify the source as non-translatable.
de | 090e2e00e616172a | ← Previous: Pneumatic Rotary Union Catalog Page 1 | products-p2.html | Approve a persistent localized translation or explicitly classify the source as non-translatable.
de | bd434fda6d2df8c6 | <a href="BP-2P-0001.html" class="product-link">BP-2P-0001</a> — 2-in-2-out, 6061 aluminum alloy body, FKM + Glyd Ring seal, max 1 MPa. Most common industrial model. | blog-seal-replacement.html | Approve a persistent localized translation or explicitly classify the source as non-translatable.
de | 7d81460ae144011e | <a href="BP-2P-50-0001.html" class="product-link">BP-2P-50-0001</a> — PTFE seal with O-ring and a protective shroud and labyrinth for dusty environments; no certified IP rating is currently claimed. | blog-seal-replacement.html | Approve a persistent localized translation or explicitly classify the source as non-translatable.
de | 1ea95f572ba6dc67 | <a href="BP-2P-50-0001.html">BP-2P-50-0001</a> for air; other media require written compatibility confirmation | application-textile-printing-converting.html | Approve a persistent localized translation or explicitly classify the source as non-translatable.
de | e9efcd087d40c495 | <a href="contact.html?request=3d-step&amp;model=BP-1P-0003&amp;product=BP-1P-0003%20%E2%80%94%20Single-Passage%20Pneumatic%20Rotary%20Union&amp;source=BP-1P-0003.html">3D STEP/IGES File (Request)</a> | BP-1P-0003.html | Approve a persistent localized translation or explicitly classify the source as non-translatable.
de | a78073ad634bbb10 | <a href="contact.html?request=3d-step&amp;model=BP-1P-0006&amp;product=BP-1P-0006%20%C2%B7%201-Inlet%2F6-Outlet%20Pneumatic%20Rotary%20Union%20(4%20mm%20Orifice)&amp;source=BP-1P-0006.html">3D STEP/IGES File (Request)</a> | BP-1P-0006.html | Approve a persistent localized translation or explicitly classify the source as non-translatable.
de | bdf381ceef61d47d | <a href="contact.html?request=3d-step&amp;model=BP-2P-0001&amp;product=BP-2P-0001%20%C2%B7%202-Passage%20Pneumatic%20Rotary%20Union&amp;source=BP-2P-0001.html">3D STEP/IGES File (Request)</a> | BP-2P-0001.html | Approve a persistent localized translation or explicitly classify the source as non-translatable.
de | 091c81aee5da5c31 | <a href="contact.html?request=3d-step&amp;model=BP-2P-0002&amp;product=BP-2P-0002%20%C2%B7%202-Inlet%2F3-Outlet%20Pneumatic%20Rotary%20Union%20(4%20mm%20Orifice)&amp;source=BP-2P-0002.html">3D STEP/IGES File (Request)</a> | BP-2P-0002.html | Approve a persistent localized translation or explicitly classify the source as non-translatable.
de | 7ff83beb71196170 | <a href="contact.html?request=3d-step&amp;model=BP-2P-08-0001&amp;product=BP-2P-08-0001%20%C2%B7%202-Passage%20Pneumatic%20Rotary%20Union&amp;source=BP-2P-08-0001.html">3D STEP/IGES File (Request)</a> | BP-2P-08-0001.html | Approve a persistent localized translation or explicitly classify the source as non-translatable.
de | 4020f8bd78b8f5b7 | <a href="contact.html?request=3d-step&amp;model=BP-2P-130-0001&amp;product=BP-2P-130-0001%20%C2%B7%202-Passage%20Pneumatic%20Rotary%20Union&amp;source=BP-2P-130-0001.html">3D STEP/IGES File (Request)</a> | BP-2P-130-0001.html | Approve a persistent localized translation or explicitly classify the source as non-translatable.
de | f51cc8c1348caa95 | <a href="contact.html?request=3d-step&amp;model=BP-2P-16-0001&amp;product=BP-2P-16-0001%20%C2%B7%202-Passage%20Through-Bore%20Pneumatic%20Rotary%20Union%20(16%20mm%20Bore)&amp;source=BP-2P-16-0001.html">3D STEP/IGES File (Request)</a> | BP-2P-16-0001.html | Approve a persistent localized translation or explicitly classify the source as non-translatable.
de | 9796382f81cb39f6 | <a href="contact.html?request=3d-step&amp;model=BP-2P-30-0001&amp;product=BP-2P-30-0001%20%C2%B7%202-Passage%20Through-Bore%20Pneumatic%20Rotary%20Union%20(%C3%9830%20mm%20Bore)&amp;source=BP-2P-30-0001.html">3D STEP/IGES File (Request)</a> | BP-2P-30-0001.html | Approve a persistent localized translation or explicitly classify the source as non-translatable.
de | a76ef0edc60dd833 | <a href="contact.html?request=3d-step&amp;model=BP-2P-50-0001&amp;product=BP-2P-50-0001%20%C2%B7%202-Passage%20Pneumatic%20Rotary%20Union&amp;source=BP-2P-50-0001.html">3D STEP/IGES File (Request)</a> | BP-2P-50-0001.html | Approve a persistent localized translation or explicitly classify the source as non-translatable.
de | 0d59b1f88f7df1c7 | <a href="contact.html?request=3d-step&amp;model=BP-2P-95-0001&amp;product=BP-2P-95-0001%20%C2%B7%202-Inlet%2F4-Outlet%20Pneumatic%20Rotary%20Union&amp;source=BP-2P-95-0001.html">3D STEP/IGES File (Request)</a> | BP-2P-95-0001.html | Approve a persistent localized translation or explicitly classify the source as non-translatable.
de | b7ae47351b9178bc | <a href="contact.html?request=3d-step&amp;model=BP-3P-0004&amp;product=BP-3P-0004%20%C2%B7%203-Passage%20Pneumatic%20Rotary%20Union&amp;source=BP-3P-0004.html">3D STEP/IGES File (Request)</a> | BP-3P-0004.html | Approve a persistent localized translation or explicitly classify the source as non-translatable.
de | a121051c670b7b43 | <a href="contact.html?request=3d-step&amp;model=BP-3P-S06-0001&amp;product=BP-3P-S06-0001%20%C2%B7%203-Passage%20%2B%206-Circuit%20Pneumatic-Electric%20Rotary%20Union&amp;source=BP-3P-S06-0001.html">3D STEP/IGES File (Request)</a> | BP-3P-S06-0001.html | Approve a persistent localized translation or explicitly classify the source as non-translatable.
de | 95ddbb42d4cda9bd | <a href="contact.html?request=3d-step&amp;model=BP-4P-30-0001&amp;product=BP-4P-30-0001%20%C2%B7%204-Passage%20Through-Bore%20Pneumatic%20Rotary%20Union%20(%C3%9830%20mm%20Bore)&amp;source=BP-4P-30-0001.html">3D STEP/IGES File (Request)</a> | BP-4P-30-0001.html | Approve a persistent localized translation or explicitly classify the source as non-translatable.
de | 9269a707502fcf93 | <a href="contact.html?request=3d-step&amp;model=BP-8P-0001&amp;product=BP-8P-0001%20%C2%B7%208-Passage%20Pneumatic%20Rotary%20Union&amp;source=BP-8P-0001.html">3D STEP/IGES File (Request)</a> | BP-8P-0001.html | Approve a persistent localized translation or explicitly classify the source as non-translatable.
de | a8119d172275209a | <a href="contact.html?request=verified-drawing&amp;model=BP-2P-30-0001">Request Verified Drawing</a> | BP-2P-30-0001.html | Approve a persistent localized translation or explicitly classify the source as non-translatable.
de | bf9c0964bfa19732 | <a href="contact.html?request=verified-drawing&amp;model=BP-2P-95-0001">Request Verified Drawing</a> | BP-2P-95-0001.html | Approve a persistent localized translation or explicitly classify the source as non-translatable.
de | 40f626ab64f43adc | <a href="contact.html">Request engineering review</a> | BP-2P-50-0001.html | Approve a persistent localized translation or explicitly classify the source as non-translatable.
de | 6bbdd4466352cd06 | <h3>BP-1P-0003 · Single-Passage</h3> <p>Single passage, threaded mount, 500 RPM. For simple single-line applications.</p> <div class="price">From $38</div> | BP-1P-0006.html;BP-2P-0001.html;BP-2P-0002.html | Approve a persistent localized translation or explicitly classify the source as non-translatable.
de | 385f58bce684aba1 | <h3>BP-1P-0006 — 1-Inlet/6-Outlet (G1/8)</h3> <p>1-in-6-out, 4mm orifice. For assembly stations distributing one air supply to 6 tools.</p> <div class="price">From $42</div> | BP-1P-0003.html | Approve a persistent localized translation or explicitly classify the source as non-translatable.
de | d817c7b74a1079a4 | <h3>BP-1P-0006 · 1-Inlet/6-Outlet (G1/8)</h3> <p>1-in-6-out, 4mm orifice, G1/8 thread. For distributing one air supply to 6 small tools.</p> <div class="price">From $42</div> | BP-3P-0007.html | Approve a persistent localized translation or explicitly classify the source as non-translatable.
de | 74ae2b9a4df1cb27 | <h3>BP-2P-0001 — 2-Passage (Flange)</h3> <p>Dual passage, flange mount, 1.0 MPa. For clamp + unclamp or gripper + vacuum.</p> <div class="price">From $55</div> | BP-1P-0003.html | Approve a persistent localized translation or explicitly classify the source as non-translatable.
de | c417e5e892465b1c | <h3>BP-2P-0001 · 2-Passage (Flange)</h3> <p>Dual passage, flange mount, 1.0 MPa, 500 RPM. No bore. Lower cost when through-bore is not needed.</p> <div class="price">From $55</div> | BP-2P-16-0001.html | Approve a persistent localized translation or explicitly classify the source as non-translatable.
de | cda917bae41482eb | <h3>BP-2P-0001 · 2-Passage (Flange)</h3> <p>Dual passage, flange mount, 1.0 MPa, 500 RPM. Standard version for clean environments at lower cost.</p> <div class="price">From $68</div> | BP-2P-50-0001.html | Approve a persistent localized translation or explicitly classify the source as non-translatable.
de | 8fa491c749caac9f | <h3>BP-2P-0001 · 2-Passage (Flange)</h3> <p>Dual passage, flange mount, 1.0 MPa, 500 RPM. Standard version for clean, low-pressure environments at lower cost.</p> <div class="price">From $68</div> | BP-2P-95-0001.html | Approve a persistent localized translation or explicitly classify the source as non-translatable.
de | 7e0bfb36824009ce | <h3>BP-2P-0001 · 2-Passage (Flange)</h3> <p>Dual passage, flange mount, 1.0 MPa. For applications where 2 channels are sufficient and flange rigidity is preferred.</p> <div class="price">From $68</div> | BP-3P-0006.html | Approve a persistent localized translation or explicitly classify the source as non-translatable.
de | 80ed98cd815eba61 | <h3>BP-2P-0001 · 2-Passage (Flange)</h3> <p>Dual passage, flange mount, 1.0 MPa. For applications where 2 channels are sufficient.</p> <div class="price">From $68</div> | BP-3P-0004.html | Approve a persistent localized translation or explicitly classify the source as non-translatable.
de | dae3173ee0460eb8 | <h3>BP-2P-0001 · 2-Passage (Flange)</h3> <p>Dual passage, flange mount, 1.0 MPa. For clamp + unclamp or gripper + vacuum.</p> <div class="price">From $55</div> | BP-1P-0006.html | Approve a persistent localized translation or explicitly classify the source as non-translatable.
de | e7a2e4da52897a7e | <h3>BP-2P-0001 · 2-Passage (Flange)</h3> <p>Dual passage, flange mount, 1.0 MPa. For general automation where 5 MPa is over-specified.</p> <div class="price">From $68</div> | BP-2P-130-0001.html | Approve a persistent localized translation or explicitly classify the source as non-translatable.
de | b200cbed54af6c4c | <h3>BP-2P-0001 · 2-Passage (Flange)</h3> <p>Dual passage, flange mount, 1.0 MPa. For simpler clamp + unclamp applications.</p> <div class="price">From $55</div> | BP-3P-S06-0001.html | Approve a persistent localized translation or explicitly classify the source as non-translatable.
de | 92db778017238b74 | <h3>BP-2P-0001 · 2-Passage (Flange)</h3> <p>Dual passage, flange mount, 200 RPM. For rigid machine-frame integration.</p> <div class="price">From $68</div> | BP-2P-0002.html;BP-2P-08-0001.html | Approve a persistent localized translation or explicitly classify the source as non-translatable.
de | f198cd03cfffd663 | <h3>BP-2P-0001 · 2-Passage</h3> <p>Dual passage, flange mount, 1.0 MPa. For simpler clamp + unclamp applications.</p> <div class="price">From $68</div> | BP-4P-30-0001.html;BP-8P-0001.html | Approve a persistent localized translation or explicitly classify the source as non-translatable.
de | ddc9a9536afd20b0 | <h3>BP-2P-0002 · 2-Inlet/3-Outlet (G1/8)</h3> <p>Dual passage, threaded mount, 1.5 MPa. For higher-pressure applications.</p> <div class="price">From $48</div> | BP-1P-0006.html | Approve a persistent localized translation or explicitly classify the source as non-translatable.
de | 14fc6d8866ccd63c | <h3>BP-2P-0002 · 2-Inlet/3-Outlet (G1/8)</h3> <p>Dual passage, threaded mount, 1.5 MPa. For higher-pressure or compact installations.</p> <div class="price">From $48</div> | BP-2P-0001.html | Approve a persistent localized translation or explicitly classify the source as non-translatable.
de | d1f42de3cd242202 | <h3>BP-2P-0002 · 2-Inlet/3-Outlet (G1/8)</h3> <p>Dual passage, threaded mount, 1.5 MPa. For higher-pressure or larger-flow applications.</p> <div class="price">From $48</div> | BP-2P-08-0001.html | Approve a persistent localized translation or explicitly classify the source as non-translatable.
de | df9026f053d469d2 | <h3>BP-2P-08-0001 · Compact 2-Passage (8mm)</h3> <p>Compact, M5 threaded, no flange. For small assemblies where space is extremely limited.</p> <div class="price">From $42</div> | BP-2P-30-0001.html | Approve a persistent localized translation or explicitly classify the source as non-translatable.
de | b6a3519c8a39fb0c | <h3>BP-2P-08-0001 · Compact 2-Passage (M5)</h3> <p>Compact M5 threaded, 200 RPM. For miniature automation cells.</p> <div class="price">From $42</div> | BP-2P-0002.html | Approve a persistent localized translation or explicitly classify the source as non-translatable.
de | 96588ebe77c02841 | <h3>BP-2P-08-0001 · Compact 2-Passage (M5)</h3> <p>Compact, M5 threaded, 2 passages. For ultra-small pneumatic fixtures where G1/8 is too large.</p> <div class="price">From $42</div> | BP-3P-0007.html | Approve a persistent localized translation or explicitly classify the source as non-translatable.
de | a6c8dbde7f9bd048 | <h3>BP-2P-16-0001 · 2-Passage Through-Bore (16mm)</h3> <p>16mm bore, flange mount, 200 RPM. Lighter and lower cost when 30mm bore is not needed.</p> <div class="price">From $58</div> | BP-2P-30-0001.html | Approve a persistent localized translation or explicitly classify the source as non-translatable.
de | 9d2719264b052984 | <h3>BP-2P-16-0001 · 2-Passage Through-Bore</h3> <p>Ø16mm bore, flange mount. For smaller cable-through applications.</p> <div class="price">From $78</div> | BP-8P-0001.html | Approve a persistent localized translation or explicitly classify the source as non-translatable.
de | 44cd02e9f6db575a | <h3>BP-2P-16-0001 · 2-Passage Through-Bore</h3> <p>Ø16mm bore, flange mount. For smaller cable-through or shaft-through applications.</p> <div class="price">From $78</div> | BP-4P-30-0001.html | Approve a persistent localized translation or explicitly classify the source as non-translatable.
de | ba01189eec6bde02 | <h3>BP-2P-30-0001 · 2-Passage Through-Bore (Ø30mm)</h3> <p>Larger 30mm bore, Ø76 mm body, deep groove ball bearing. For bigger cable bundles and radial loads.</p> <div class="price">From $72</div> | BP-2P-16-0001.html | Approve a persistent localized translation or explicitly classify the source as non-translatable.
de | bc11ca048b49a6ba | <h3>BP-2P-50-0001 — Protective Shroud + Labyrinth</h3> <p>Two-passage air model with a protective shroud and labyrinth for dusty environments; no certified IP rating is currently claimed.</p> <div class="price">From $85</div> | BP-1P-0003.html | Approve a persistent localized translation or explicitly classify the source as non-translatable.
de | cae65512b713d069 | <h3>BP-2P-50-0001 · Protective Shroud + Labyrinth</h3> <p>Two-passage air model with a protective shroud and labyrinth for dusty environments; no certified IP rating is currently claimed.</p> <div class="price">From $85</div> | BP-2P-0001.html;BP-2P-08-0001.html;BP-2P-130-0001.html;BP-2P-16-0001.html;BP-2P-30-0001.html;BP-3P-0004.html;BP-3P-0006.html;BP-8P-0001.html | Approve a persistent localized translation or explicitly classify the source as non-translatable.
de | 30d70534e6ca6b1a | <h3>BP-2P-50-0001 · Protective Shroud + Labyrinth</h3> <p>Two-passage air model with a protective shroud and labyrinth, rated to 1.0 MPa; no certified IP rating is currently claimed.</p> <div class="price">From $85</div> | BP-2P-95-0001.html | Approve a persistent localized translation or explicitly classify the source as non-translatable.
de | b06f827738224f52 | <h3>BP-3P-0004 — 3-Passage (Flange)</h3> <p>Triple passage, flange mount. For multi-function rotary tables and packaging machinery.</p> <div class="price">From $95</div> | BP-1P-0003.html | Approve a persistent localized translation or explicitly classify the source as non-translatable.
de | db9bde066fbe702b | <h3>BP-3P-0004 · 3-Passage (Flange)</h3> <p>Same 3 passages, flange mount, 1.0 MPa. For vibration-heavy applications where threaded mounts fatigue.</p> <div class="price">From $72</div> | BP-3P-0007.html | Approve a persistent localized translation or explicitly classify the source as non-translatable.
de | 98a8097fed3900c1 | <h3>BP-3P-0004 · 3-Passage (Flange)</h3> <p>Same 3 passages, flange mount, 1.0 MPa. For vibration-heavy applications where threaded mounts fatigue.</p> <div class="price">From $95</div> | BP-3P-0006.html | Approve a persistent localized translation or explicitly classify the source as non-translatable.
de | a84e0cb30efa87fa | <h3>BP-3P-0004 · 3-Passage (Flange)</h3> <p>Triple passage, flange mount, 1.0 MPa. For multi-function rotary tables needing 3 independent air lines.</p> <div class="price">From $95</div> | BP-2P-95-0001.html | Approve a persistent localized translation or explicitly classify the source as non-translatable.
de | e3796cd8d8a6bd1c | <h3>BP-3P-0004 · 3-Passage (Flange)</h3> <p>Triple passage, flange mount, 1.0 MPa. For multi-function rotary tables.</p> <div class="price">From $95</div> | BP-2P-130-0001.html | Approve a persistent localized translation or explicitly classify the source as non-translatable.
de | 0909e0fb4b9a2646 | <h3>BP-3P-0004 · 3-Passage (Flange)</h3> <p>Triple passage, flange mount, pneumatic only. Same 3 air lines without slip ring — lighter and lower cost.</p> <div class="price">From $95</div> | BP-3P-S06-0001.html | Approve a persistent localized translation or explicitly classify the source as non-translatable.
de | 1e8664da25774d15 | <h3>BP-3P-0004 · 3-Passage (Flange)</h3> <p>Triple passage, flange mount. For multi-function rotary tables and packaging machinery.</p> <div class="price">From $95</div> | BP-2P-0001.html;BP-2P-08-0001.html | Approve a persistent localized translation or explicitly classify the source as non-translatable.
de | aa9d81ec857e6543 | <h3>BP-3P-0004 · 3-Passage (Flange)</h3> <p>Triple passage, flange mount. For multi-function rotary tables needing 3 independent air lines.</p> <div class="price">From $95</div> | BP-2P-16-0001.html;BP-2P-50-0001.html | Approve a persistent localized translation or explicitly classify the source as non-translatable.
de | 526e817d40f7ce63 | <h3>BP-3P-0004 · 3-Passage</h3> <p>Triple passage, flange mount. For 3-function rotary tables without hollow bore.</p> <div class="price">From $95</div> | BP-4P-30-0001.html | Approve a persistent localized translation or explicitly classify the source as non-translatable.
de | 006127a85e2c1b84 | <h3>BP-3P-0004 · 3-Passage</h3> <p>Triple passage, flange mount. For 3-function rotary tables.</p> <div class="price">From $95</div> | BP-8P-0001.html | Approve a persistent localized translation or explicitly classify the source as non-translatable.
de | efa58fb6302adca9 | <h3>BP-3P-0006 · 3-Passage (G1/4)</h3> <p>Same 3 passages with G1/4 threaded ports for higher flow and direct hose connection.</p> <div class="price">From $78</div> | BP-3P-S06-0001.html | Approve a persistent localized translation or explicitly classify the source as non-translatable.
de | f6429d7a4d931de6 | <h3>BP-3P-0006 · 3-Passage (G1/4)</h3> <p>Same 3 passages, G1/4 thread, 6mm orifice. For higher flow requirements in compact installs.</p> <div class="price">From $78</div> | BP-3P-0007.html | Approve a persistent localized translation or explicitly classify the source as non-translatable.
de | d565e5b7973fee14 | <h3>BP-3P-0006 · 3-Passage (G1/4)</h3> <p>Same 3 passages, G1/4 threaded mount, 6mm orifice. For compact installs without flange machining.</p> <div class="price">From $78</div> | BP-3P-0004.html | Approve a persistent localized translation or explicitly classify the source as non-translatable.
de | 64c19f33d74c6f20 | <h3>BP-3P-0007 · Compact 3-Passage (4mm)</h3> <p>Same 3 passages with 4 mm orifice for higher flow rate applications.</p> <div class="price">From $75</div> | BP-3P-S06-0001.html | Approve a persistent localized translation or explicitly classify the source as non-translatable.
de | 8d85c57071b39341 | <h3>BP-3P-0007 · Compact 3-Passage (4mm)</h3> <p>Same 3 passages, G1/8 thread, 4mm orifice. For miniature pneumatic fixtures where space is critical.</p> <div class="price">From $75</div> | BP-3P-0006.html | Approve a persistent localized translation or explicitly classify the source as non-translatable.
de | fd22c0a98d0e5693 | <h3>BP-3P-0007 · Compact 3-Passage (4mm)</h3> <p>Same 3 passages, G1/8 threaded mount, 4mm orifice. For miniature pneumatic fixtures.</p> <div class="price">From $75</div> | BP-3P-0004.html | Approve a persistent localized translation or explicitly classify the source as non-translatable.
de | ca7a377dbf72c811 | <h3>BP-3P-0007 · Compact 3-Passage (4mm)</h3> <p>Triple passage, same 4mm orifice. For multi-function rotary tables.</p> <div class="price">From $78</div> | BP-1P-0006.html | Approve a persistent localized translation or explicitly classify the source as non-translatable.
de | 78bb808cda8b852f | <h3>BP-3P-0007 · Compact 3-Passage (4mm)</h3> <p>Triple passage, same 4mm orifice. For three independent inlet pressures.</p> <div class="price">From $78</div> | BP-2P-0002.html | Approve a persistent localized translation or explicitly classify the source as non-translatable.
de | f0fabd897f59c174 | <h3>BP-3P-S06-0001 · 3-Passage + 6-Circuit</h3> <p>Pneumatic-electric hybrid. For stations needing both air and electrical signal transfer.</p> <div class="price">From $145</div> | BP-2P-30-0001.html | Approve a persistent localized translation or explicitly classify the source as non-translatable.
de | c162dea0e3d5eec8 | <h3>BP-3P-S06-0001 · 3-Passage + 6-Circuit</h3> <p>Pneumatic-electric rotary joint. 3 air passages + 6 electrical circuits in one body.</p> <div class="price">From $145</div> | BP-4P-30-0001.html | Approve a persistent localized translation or explicitly classify the source as non-translatable.
de | 2a0fefd63ca0822b | <h3>BP-4P-30-0001 · 4-Passage Through-Bore (Ø30mm)</h3> <p>4 passages, same 30mm bore and Ø76 mm envelope. For complex automation stations.</p> <div class="price">From $125</div> | BP-2P-30-0001.html | Approve a persistent localized translation or explicitly classify the source as non-translatable.
de | d12fa3fc1f9765ff | <h3>BP-4P-30-0001 · 4-Passage Through-Bore</h3> <p>Ø30mm hollow bore, 4 passages, flange mount. For cable-through or shaft-through applications.</p> <div class="price">From $128</div> | BP-3P-S06-0001.html;BP-8P-0001.html | Approve a persistent localized translation or explicitly classify the source as non-translatable.
de | c05d633fdf2cc214 | <h3>BP-8P-0001 · 8-Passage (Flange)</h3> <p>8 passages, flange mount. For complex automation and multi-passage machinery.</p> <div class="price">From $165</div> | BP-2P-0001.html;BP-2P-0002.html;BP-2P-08-0001.html | Approve a persistent localized translation or explicitly classify the source as non-translatable.
de | f9c0d13dfe7b9be7 | <h3>BP-8P-0001 · 8-Passage (Flange)</h3> <p>8 passages, flange mount. For complex automation and packaging machinery.</p> <div class="price">From $165</div> | BP-1P-0006.html | Approve a persistent localized translation or explicitly classify the source as non-translatable.
de | 55d90087ab7a410b | <h3>BP-8P-0001 · 8-Passage</h3> <p>8 passages, flange mount, 1.0 MPa. For complex automation stations with many pneumatic functions.</p> <div class="price">From $165</div> | BP-2P-95-0001.html | Approve a persistent localized translation or explicitly classify the source as non-translatable.
de | 1514105c3d2c7f04 | <h3>BP-8P-0001 · 8-Passage</h3> <p>8 passages, flange mount, 200 RPM. For high-density multi-passage rotary systems.</p> <div class="price">From $165</div> | BP-4P-30-0001.html | Approve a persistent localized translation or explicitly classify the source as non-translatable.
de | 3657396a310990e2 | <h3>BP-8P-0001 · 8-Passage</h3> <p>8 passages, flange mount. For complex automation stations with many pneumatic functions.</p> <div class="price">From $165</div> | BP-2P-16-0001.html;BP-2P-50-0001.html | Approve a persistent localized translation or explicitly classify the source as non-translatable.
de | 7f929d88c24bf596 | <h3>BP-8P-0001 · 8-Passage</h3> <p>8 passages, flange mount. For complex multi-function rotary tables and packaging machinery.</p> <div class="price">From $165</div> | BP-2P-130-0001.html;BP-3P-0004.html;BP-3P-0006.html | Approve a persistent localized translation or explicitly classify the source as non-translatable.
de | f6928ad63f860493 | <img src="images/optimized/products/BP-2P-50-0001-1.webp" alt="BP-2P-50-0001 protective-shroud and labyrinth rotary joint" loading="lazy" width="500" height="500"> <span class="portal-date">May 2026</span> <strong>BP-2P-50-0001</strong> <small>Protective shroud and labyrinth for dusty environments; no certified IP rating claimed</small> | index.html | Approve a persistent localized translation or explicitly classify the source as non-translatable.
de | d71a8f75c2ddeb84 | <img src="images/optimized/products/BP-4P-30-0001/BP-4P-30-0001.webp" alt="BP-4P-30-0001 4-passage pneumatic rotary union" loading="lazy" width="500" height="500"> <span class="portal-date">June 2026</span> <strong>BP-4P-30-0001</strong> <small>4-channel flange mount rotary union with 30mm bore</small> | index.html | Approve a persistent localized translation or explicitly classify the source as non-translatable.
de | 83beb112ad2882b2 | <img src="images/optimized/products/BP-8P-0001-1.webp" alt="BP-8P-0001 8-passage pneumatic rotary union" loading="lazy" width="500" height="500"> <span class="portal-date">May 2026</span> <strong>BP-8P-0001</strong> <small>8-passages for high-channel pneumatic transfer</small> | index.html | Approve a persistent localized translation or explicitly classify the source as non-translatable.
de | b18387bfd1b5e45a | <span class="bp-rfq-quick-label">Phone / WhatsApp / WeChat</span> <span class="bp-rfq-quick-value"><a href="tel:+8618368425342">+86 183 6842 5342</a> · <a href="https://wa.me/8618368425342" target="_blank" rel="noopener noreferrer">WhatsApp</a></span> | contact.html | Approve a persistent localized translation or explicitly classify the source as non-translatable.
de | b7c3e11d66780f56 | <span class="highlight">Pneumatic Rotary Union</span> Manufacturer for OEM Machinery | index.html | Approve a persistent localized translation or explicitly classify the source as non-translatable.
de | 478c9079c89d522c | <strong>3+ independent inlet passages</strong> — BP-2P-95-0001 is a 2-in-4-out distributor, not a 4-in-4-out independent manifold. For 4 independent inlets, specify a custom multi-passage design | BP-2P-95-0001.html | Approve a persistent localized translation or explicitly classify the source as non-translatable.
de | 1f76dad06fe15ce8 | <strong>4 independent passages in one body:</strong> Clamp, unclamp, vacuum, and blow-off (or 4 separate air supplies) rotate on a single joint — replaces 4 separate unions or 2 two-passage joints | BP-4P-30-0001.html | Approve a persistent localized translation or explicitly classify the source as non-translatable.
de | a9fe3c05fa9fdb5b | <strong>6061 aluminum alloy body at 0.39 kg:</strong> Compact two-passage construction for small stepper- and servo-driven rotary equipment | BP-2P-08-0001.html | Approve a persistent localized translation or explicitly classify the source as non-translatable.
de | 58d2c241ddbed26e | <strong>6061 aluminum alloy body at 0.41 kg minimizes inertia:</strong> The lightweight aluminum construction reduces the rotating mass on small and medium welding positioners, improving indexing accuracy and motor load | BP-2P-16-0001.html | Approve a persistent localized translation or explicitly classify the source as non-translatable.
de | ded32c9bffd7be5a | <strong>6061 aluminum alloy body:</strong> 6061-T6 aluminum alloy with yield strength 276 MPa and density 2.70 g/cm³. The anodized surface provides corrosion resistance for intermittent water and coolant exposure. At 0.39 kg, the body is suitable for small stepper-motor-driven rotary tables where inertia matters. Not recommended for continuous immersion in aggressive coolant without additional surface treatment.<br><br><strong>PTFE composite seal:</strong> Polytetrafluoroethylene with glass fiber and graphite filler. Self-lubricating, chemically inert, and rated for -200°C to +260°C. The two-passage design uses two independent seal rings, one per channel, ensuring no cross-contamination between the two air circuits. FKM O-ring provides static sealing at the housing interface.<br><br><strong>M5 thread note:</strong> M5 × 0.8 metric fine thread provides a compact connection for 4 mm and 6 mm pneumatic tubing push-to-connect fittings. The small thread size limits maximum flow compared to G1/8 — verify your CFM requirement before specifying. For higher flow, upgrade to BP-2P-0002 (G1/8, 4mm orifice). | BP-2P-08-0001.html | Approve a persistent localized translation or explicitly classify the source as non-translatable.
de | b170cb40e8ca8dbf | <strong>6061 aluminum alloy body:</strong> 6061-T6 aluminum alloy with yield strength 276 MPa and density 2.70 g/cm³. The anodized surface provides corrosion resistance for intermittent water and coolant exposure. At 220 g, the body is one of the lightest multi-passage rotary joints in the Begapunk catalog, making it ideal for robot EOAT and small CNC axes. Not recommended for continuous immersion in aggressive coolant without additional surface treatment.<br><br><strong>PTFE composite seal:</strong> Polytetrafluoroethylene with glass fiber and graphite filler. Self-lubricating, chemically inert, and rated for -200°C to +260°C. The dual-inlet design uses independent seal rings per channel, ensuring no cross-contamination between the two inlet circuits. FKM O-ring provides static sealing at the housing interface.<br><br><strong>Deep groove ball bearing:</strong> Standard single-row deep groove ball bearing with steel races and rubber seals. Pre-lubricated for life. The bearing supports radial loads from the rotating manifold and maintains concentricity of the 4mm orifice passages. Replace bearing if axial play exceeds 0.05 mm. | BP-2P-0002.html | Approve a persistent localized translation or explicitly classify the source as non-translatable.
de | b23834848bb09b85 | <strong>6061 aluminum alloy body:</strong> 6061-T6 aluminum alloy with yield strength 276 MPa and density 2.70 g/cm³. The anodized surface provides corrosion resistance for intermittent water and coolant exposure. At 265 g, the body adds minimal load to small rotary mechanisms. Not recommended for continuous immersion in aggressive coolant or caustic washdown without additional surface treatment.<br><br><strong>PTFE composite seal:</strong> Polytetrafluoroethylene with glass fiber and graphite filler. Self-lubricating, chemically inert, and rated for -200°C to +260°C. The composite structure maintains structural integrity while providing a low friction coefficient (0.05–0.10 against aluminum) ideal for rotary seals in lightweight housings.<br><br><strong>Deep groove ball bearing:</strong> Standard single-row deep groove ball bearing (ISO 608 or equivalent) with steel races and rubber seals. Pre-lubricated for life. The bearing supports radial loads from the rotating manifold and maintains concentricity of the 4mm orifice passages. Replace bearing if axial play exceeds 0.05 mm. | BP-1P-0006.html | Approve a persistent localized translation or explicitly classify the source as non-translatable.
de | 7021e66e86607095 | <strong>6061 aluminum alloy body:</strong> 6061-T6 aluminum alloy with yield strength 276 MPa and excellent corrosion resistance when anodized. At 0.49 kg, the body keeps rotating mass low for compact rotary tables and packaging machinery where weight and envelope size matter. Anodizing thickness is 15–25 microns for corrosion protection in water and coolant environments. Not recommended for abrasive coolant or high-impact environments without additional protective coating.<br><br><strong>PTFE composite seal:</strong> Polytetrafluoroethylene with glass fiber and graphite filler. Self-lubricating, chemically inert, and rated for -200°C to +260°C. The composite structure provides structural integrity while maintaining the low friction coefficient (0.05–0.10 against steel) that makes PTFE ideal for rotary seals. FKM O-ring provides static sealing at the housing interface. One seal compound handles all compatible media, simplifying spare parts inventory.<br><br><strong>When to choose flange mount:</strong> For rigid stationary mounting on machine frames and rotary tables. The flange mount distributes load over a larger area than threaded mounts, providing better resistance to vibration and side loads. If your application requires frequent removal or has limited flange machining access, consider the threaded-mount BP-3P-0006 or BP-3P-0007. | BP-3P-0004.html | Approve a persistent localized translation or explicitly classify the source as non-translatable.
de | ed5a12ec8281d14e | <strong>6061 aluminum alloy body:</strong> 6061-T6 aluminum alloy with yield strength 276 MPa and excellent corrosion resistance when anodized. The 0.36 kg mass and Ø64 × 78 mm envelope make this one of the most compact 3-passage threaded joints available. Anodizing thickness is 15–25 microns for corrosion protection in water and coolant environments. Not recommended for abrasive coolant or high-impact environments without additional protective coating.<br><br><strong>PTFE composite seal:</strong> Polytetrafluoroethylene with glass fiber and graphite filler. Self-lubricating, chemically inert, and rated for -200°C to +260°C. The composite structure provides structural integrity while maintaining the low friction coefficient (0.05–0.10 against steel) that makes PTFE ideal for rotary seals. FKM O-ring provides static sealing at the housing interface. One seal compound handles all compatible media, simplifying maintenance.<br><br><strong>G1/4 thread advantage:</strong> BSP parallel (BSPP) per ISO 228-1 with 1.337 mm pitch. The G1/4 thread matches standard pneumatic fittings worldwide, eliminating adapter costs and leak points. The 6mm orifice provides 2.25× the flow area of a 4mm orifice, reducing pressure drop in vacuum and high-flow applications. For even smaller envelopes, the G1/8 variant BP-3P-0007 offers a 4mm orifice in a Ø78.9 × 63.9 mm body. | BP-3P-0006.html | Approve a persistent localized translation or explicitly classify the source as non-translatable.
de | c1b54e4163e812d4 | <strong>6061 aluminum alloy body:</strong> 6061-T6 aluminum alloy with yield strength 276 MPa and excellent corrosion resistance when anodized. The 0.39 kg mass and Ø78.9 × 63.9 mm envelope make this ideal for robot EOAT and desktop automation where every gram and millimeter matters. Anodizing thickness is 15–25 microns for corrosion protection. Not recommended for abrasive coolant or high-impact environments.<br><br><strong>PTFE composite seal:</strong> Polytetrafluoroethylene with glass fiber and graphite filler. Self-lubricating, chemically inert, and rated for -200°C to +260°C. The composite maintains low friction (0.05–0.10 against steel) while providing sealing performance for the specified inspection conditions. FKM O-ring provides static sealing at the housing interface.<br><br><strong>Deep groove ball bearing:</strong> Provides radial and axial support with ≤2 N·m idle torque. The bearing reduces seal side load and extends seal life from 6 months to 12+ months under rated conditions. Inspect bearing annually for play — replace if radial play exceeds 0.05 mm. The bearing is pre-lubricated and sealed for life under normal duty. | BP-3P-0007.html | Approve a persistent localized translation or explicitly classify the source as non-translatable.
de | e464f8a4fbfb0499 | <strong>6061 aluminum alloy body:</strong> 6061-T6 aluminum alloy with yield strength 276 MPa and hardness 95 HB. The anodized surface provides corrosion resistance for intermittent water and coolant exposure. At 0.39 kg, it keeps rotating inertia manageable on medium rotary tables. Not recommended for continuous abrasive coolant without additional surface hardening — specify hard anodizing (Type III, 25 μm) or stainless steel (304/316) for such environments.<br><br><strong>PTFE composite seal:</strong> Polytetrafluoroethylene with glass fiber and graphite filler. Self-lubricating, chemically inert, and rated for -200°C to +260°C. The composite structure provides structural integrity while maintaining the low friction coefficient (0.05–0.10 against aluminum) that makes PTFE ideal for rotary seals at 150 RPM. FKM O-ring provides static sealing at the housing interface.<br><br><strong>Deep groove ball bearing:</strong> Single-row deep groove ball bearing (6202 or equivalent) with steel shields and lithium grease lubrication. The bearing supports radial loads up to 5 N·m and axial loads up to 2 N·m. This is the key difference from plain-bearing joints — it allows side-mounted tooling, off-center fixtures, and cantilevered loads that would cause rapid seal wear in a sleeve-bearing design. Bearing life is rated at ≥8,000 hours under rated load. | BP-2P-30-0001.html | Approve a persistent localized translation or explicitly classify the source as non-translatable.
de | 738e9f42af90c403 | <strong>6061 aluminum alloy body:</strong> 6061-T6 aluminum alloy with yield strength 276 MPa and hardness 95 HB. The anodized surface provides corrosion resistance for intermittent water and coolant exposure. At 0.41 kg, it adds minimal rotating inertia to small indexing tables. Not recommended for continuous abrasive coolant without additional surface hardening — specify hard anodizing (Type III, 25 μm) for such environments.<br><br><strong>PTFE composite seal:</strong> Polytetrafluoroethylene with glass fiber and graphite filler. Self-lubricating, chemically inert, and rated for -200°C to +260°C. The composite structure provides structural integrity while maintaining the low friction coefficient (0.05–0.10 against aluminum) that makes PTFE ideal for rotary seals at 200 RPM. FKM O-ring provides static sealing at the housing interface.<br><br><strong>16mm bore utility:</strong> The through-bore allows routing of 4–6 mm pneumatic tubing, sensor cables, or a central vacuum line. This is the primary reason machine builders choose BP-2P-16-0001 over BP-2P-0001 (no bore) — the bore eliminates the need for a separate slip ring or vacuum swivel. | BP-2P-16-0001.html | Approve a persistent localized translation or explicitly classify the source as non-translatable.
de | a81278e1fc2a9601 | <strong>6061 aluminum alloy body:</strong> T6 temper aluminum with yield strength 276 MPa and excellent machinability. The hard-anodized surface layer (25–30 μm) provides wear resistance and corrosion protection for automation environments. At 0.41 kg, it is 60% lighter than an equivalent steel body, reducing inertia on indexing tables. Not recommended for continuous exposure to strong alkaline coolant without additional coating.<br><br><strong>PTFE + Graphite composite seal:</strong> Polytetrafluoroethylene with graphite filler provides self-lubricating properties and a low friction coefficient (0.08–0.12 against aluminum). The composite structure maintains seal integrity across air, water, coolant, and light hydraulic oil without swelling. Graphite improves thermal conductivity, preventing localized overheating at 200 RPM.<br><br><strong>PEEK seal option:</strong> For applications involving aggressive synthetic coolant or temperatures approaching +80°C, PEEK (Polyether Ether Ketone) offers higher mechanical strength and chemical resistance than PTFE. Specify PEEK at time of order for a 3-day additional lead time.<br><br><strong>Deep Groove Ball Bearing:</strong> Standard 6000-series bearing handles combined radial loads from hoses and axial loads from flange mounting. Rated for 8,000+ hours at 200 RPM under clean conditions. For dusty environments, specify sealed bearings or choose BP-2P-50-0001 series. | BP-3P-S06-0001.html | Approve a persistent localized translation or explicitly classify the source as non-translatable.
de | c7080f860838fbcf | <strong>6061 aluminum alloy body:</strong> T6 temper aluminum with yield strength 276 MPa and excellent machinability. The hard-anodized surface layer (25–30 μm) provides wear resistance and corrosion protection for industrial automation environments. At 0.85 kg for 8 passages, the body achieves a high channel density while maintaining flange rigidity. The 4-M5 flange bolt pattern matches common automation rotary table standards. For applications with heavy impact or vibration, a Grade 45 carbon steel flange insert is available as a custom option.<br><br><strong>PTFE composite seal:</strong> Polytetrafluoroethylene with glass fiber and graphite filler provides self-lubricating properties and a low friction coefficient (0.05–0.10 against aluminum). The composite structure maintains seal integrity across all 8 passages without cross-contamination. For 8-passage designs, seal alignment is critical — each passage has an independent seal ring machined to ±0.02 mm concentricity to ensure equal pressure distribution and prevent inter-passage leakage.<br><br><strong>When to specify high-temp or FDA options:</strong> For continuous operation above +80°C, specify a PEEK seal matrix rated to +150°C. For food-grade or pharmaceutical applications, specify 304/316 stainless steel body with FDA 21 CFR 177.2600 compliant seal. Both options add 5–7 days to lead time. | BP-8P-0001.html | Approve a persistent localized translation or explicitly classify the source as non-translatable.
de | 27eea51763f20a3f | <strong>6061 aluminum alloy body:</strong> T6 temper with yield strength 276 MPa and hardness 95 HB. The hard-anodized surface (25–30 μm thickness) creates a ceramic-like layer that resists wear from hose vibration and protects against corrosion from coolant mist. At 0.943 kg, the body is rigid enough for flange mounting on steel machine frames without flexing under 1 MPa internal pressure. For applications with heavy side loads or impact, a Grade 45 carbon steel shaft insert is available as a custom option.<br><br><strong>PTFE + Si3N4 ceramic seal:</strong> The PTFE matrix provides self-lubrication and chemical inertness, while the silicon nitride (Si3N4) ceramic filler adds extreme hardness (&gt;1500 HV) and thermal stability. This combination is specifically chosen for abrasive media — metal-particle coolant, hard water with calcium scale, or contaminated hydraulic oil — where a pure PTFE seal would wear rapidly. The ceramic particles act as micro-bearings, reducing friction and preventing seal groove scoring.<br><br><strong>When to specify pure PTFE instead:</strong> If your media is clean air or filtered water with no abrasive particles, the standard PTFE composite seal (without Si3N4) is sufficient and lower cost. The Si3N4 option adds 5–7 days lead time and is recommended only for abrasive or high-wear environments. Contact Begapunk engineering if you are unsure about media abrasiveness. | BP-4P-30-0001.html | Approve a persistent localized translation or explicitly classify the source as non-translatable.
de | 90221475287aaf79 | <strong>6061 aluminum alloy body:</strong> The formal engineering drawing identifies 6061 aluminum alloy as the body material | BP-2P-130-0001.html;BP-2P-95-0001.html | Approve a persistent localized translation or explicitly classify the source as non-translatable.
de | 725f475d04df94dc | <strong>6061 aluminum alloy body:</strong> The formal engineering drawing specifies 6061 aluminum alloy. The anodized surface supports corrosion resistance for intermittent water and coolant exposure.<br><br><strong>PTFE composite seal:</strong> The PTFE composite seal provides low friction and compatibility with the listed media within the approved 1 MPa / 10 bar pressure limit. FKM O-rings provide static sealing at the housing interfaces.<br><br><strong>Flange design:</strong> Use the official 2D drawing to verify the bolt pattern, port arrangement, mating dimensions, and tolerances before machining the equipment flange. | BP-2P-95-0001.html | Approve a persistent localized translation or explicitly classify the source as non-translatable.
de | ef8a72ca6609ad2d | <strong>6061 aluminum alloy body:</strong> The formal engineering drawing specifies 6061 aluminum alloy. The anodized surface supports corrosion resistance in water and coolant environments. Not recommended for abrasive coolant without additional protective coating.<br><br><strong>PTFE composite seal at 5 MPa:</strong> Polytetrafluoroethylene with glass fiber and graphite filler, structurally reinforced for high-pressure duty. The composite maintains a low friction coefficient while resisting extrusion at 5 MPa. FKM O-ring provides static sealing at the housing interface. For continuous hydraulic oil above 4 MPa, inspect the seal at an interval appropriate to the duty cycle. | BP-2P-130-0001.html | Approve a persistent localized translation or explicitly classify the source as non-translatable.
de | 390961e96ac23412 | <strong>6061 aluminum alloy body:</strong> The formal engineering drawing specifies 6061 aluminum alloy. The approximate product weight is 0.39 kg, supporting low rotating inertia in flange-mounted applications. The anodized surface provides corrosion resistance for intermittent water and coolant exposure. Not recommended for continuous immersion in aggressive coolant without additional surface treatment.<br><br><strong>PTFE composite seal:</strong> Polytetrafluoroethylene with glass fiber and graphite filler. Self-lubricating, chemically inert, and rated for -200°C to +260°C. The two-passage design uses two independent seal rings, one per channel, ensuring no cross-contamination between clamp and unclamp lines. FKM O-ring provides static sealing at the housing interface. | BP-2P-0001.html | Approve a persistent localized translation or explicitly classify the source as non-translatable.
de | 05f1c8b8f3a882a9 | <strong>6061 aluminum alloy construction:</strong> Approx. 0.39 kg body for low rotating inertia and corrosion resistance in pneumatic applications | BP-2P-0001.html | Approve a persistent localized translation or explicitly classify the source as non-translatable.
de | 1ee4bf0fc886b76b | <strong>8 passages in one body:</strong> Replaces 8 separate rotary unions or 4 two-passage joints, reducing plumbing complexity, leak points, and maintenance time by 60% | BP-8P-0001.html | Approve a persistent localized translation or explicitly classify the source as non-translatable.
de | 8b629a2727d0099b | <strong>Air duty in dusty environments:</strong> Inspect the protective shroud, labyrinth, mounting, hoses, and visible sealing area at intervals established for the actual contamination level and duty cycle | BP-2P-50-0001.html | Approve a persistent localized translation or explicitly classify the source as non-translatable.
de | 7a528c97f89caffb | <strong>Air is the standard public medium:</strong> Other media require written compatibility confirmation for the operating conditions. | BP-2P-50-0001.html | Approve a persistent localized translation or explicitly classify the source as non-translatable.
de | a5ebc9b0c5b13dd0 | <strong>Analytics data:</strong> Retained according to the current Google Analytics property configuration. | privacy.html | Approve a persistent localized translation or explicitly classify the source as non-translatable.
de | e8ff0a69fc71073c | <strong>Analytics provider:</strong> Google Analytics receives the analytics data described above only after consent. | privacy.html | Approve a persistent localized translation or explicitly classify the source as non-translatable.
de | 40b6b427690ff683 | <strong>Body:</strong> AL6061 aluminum (lightweight, anodized blue), Grade 45 carbon steel, 304 stainless steel, or 316 stainless steel | faq.html | Approve a persistent localized translation or explicitly classify the source as non-translatable.
de | d188f7fa3f6fbd90 | <strong>Body:</strong> The public configuration uses a 6061 aluminum alloy body. Confirm weight for the supplied configuration when designing the support structure.<br><br><strong>Seal and environmental design:</strong> The public seal description is a PTFE seal with O-ring. A protective shroud and labyrinth reduce direct particle exposure in dusty environments; no certified IP rating is currently claimed.<br><br><strong>Selection note:</strong> Air is the standard public medium. Other media, special materials, and certification requirements require written compatibility confirmation for the operating conditions. | BP-2P-50-0001.html | Approve a persistent localized translation or explicitly classify the source as non-translatable.
de | 68598568775cc391 | <strong>BP-2P-0001</strong><span>Two-passage flange, 1.0 MPa, 6061 aluminum alloy body with SS option. For packaging tables and actuation points.</span> | application-packaging-machinery.html | Approve a persistent localized translation or explicitly classify the source as non-translatable.
de | d4caf80386304655 | <strong>BP-2P-50-0001</strong> (2-in-2-out, for dusty environments): PTFE seal with O-ring, protective shroud and labyrinth; no certified IP rating currently claimed | blog-rotary-union-seal-types.html | Approve a persistent localized translation or explicitly classify the source as non-translatable.
de | f0ae1cd2e5ac4f13 | <strong>BP-2P-50-0001</strong><span>2-passage model with a protective-shroud and labyrinth design for dusty packaging and powder handling; no certified IP rating is currently claimed.</span> | application-steel-dusty-environments.html | Approve a persistent localized translation or explicitly classify the source as non-translatable.
de | da4d0a0e9475f956 | <strong>Business and technical information:</strong> Technical requirements and optional drawing files in the formats accepted by the form (PDF, STEP/STP, IGES/IGS, DWG, DXF, JPG/JPEG, or PNG), up to 10 MB. | privacy.html | Approve a persistent localized translation or explicitly classify the source as non-translatable.
de | 7f4e89b28df1e5d6 | <strong>Common mistake:</strong> Assuming a 2-passage joint can handle mixed media without verification. If channel A carries compressed air and channel B carries cutting coolant, you need to confirm seal material compatibility for both media — not just one. | blog-rotary-joint-selection.html | Approve a persistent localized translation or explicitly classify the source as non-translatable.
de | ee64ce035cb7a28a | <strong>Compact steel construction:</strong> Approx. 0.27 kg Grade 45 carbon steel body for handheld pneumatic tools and compact machine installations | BP-1P-0003.html | Approve a persistent localized translation or explicitly classify the source as non-translatable.
de | 6691cb67dd1698ae | <strong>Configuration-dependent weight:</strong> Confirm weight for the supplied configuration before designing the support structure. | BP-2P-50-0001.html | Approve a persistent localized translation or explicitly classify the source as non-translatable.
de | be35f076522a91c0 | <strong>Consent state</strong> — Stored under <code>begapunk_cookie_consent</code> in <code>localStorage</code>, including the choice, banner version, and timestamp. The site treats the record as expired after 365 days. | privacy.html | Approve a persistent localized translation or explicitly classify the source as non-translatable.
de | 98ffc34c4a92f028 | <strong>Continuous speed above 100 RPM</strong> — operation above the published speed limit requires written engineering confirmation for the complete operating conditions | BP-2P-50-0001.html | Approve a persistent localized translation or explicitly classify the source as non-translatable.
de | ed5c2eed3a7d861d | <strong>Continuous water immersion</strong> without surface treatment — Grade 45 carbon steel will rust; specify stainless steel or nickel-plated version | BP-1P-0003.html | Approve a persistent localized translation or explicitly classify the source as non-translatable.
de | a511f15b81d7bdbb | <strong>Direct submersion or pressure washing on the seal face</strong> — the protective shroud and labyrinth are intended for dusty environments; no certified IP rating is currently claimed | BP-2P-50-0001.html | Approve a persistent localized translation or explicitly classify the source as non-translatable.
de | ad03f4350cfe0510 | <strong>Documented mounting interfaces:</strong> The stator side uses 4 × M5 with 10 mm thread depth; the rotor side uses 6 × M5 with 8 mm thread depth. | BP-2P-50-0001.html | Approve a persistent localized translation or explicitly classify the source as non-translatable.
de | 22149c60f81a2f67 | <strong>Dusty or abrasive environments</strong> — no protective shroud or labyrinth; steel mill dust will contaminate the slip ring contacts and accelerate bearing wear; use BP-2P-50-0001 (protective shroud and labyrinth; no certified IP rating claimed) or add external bellows | BP-3P-S06-0001.html | Approve a persistent localized translation or explicitly classify the source as non-translatable.
de | c9376e42e51a413b | <strong>Dusty or abrasive environments</strong> — no protective shroud or labyrinth; use BP-2P-50-0001 (protective shroud and labyrinth; no certified IP rating claimed) or add external bellows | BP-1P-0003.html;BP-1P-0006.html;BP-2P-0001.html;BP-2P-0002.html;BP-2P-08-0001.html | Approve a persistent localized translation or explicitly classify the source as non-translatable.
de | f844532008450536 | <strong>Dusty or abrasive environments</strong> — this model has no protective shroud or labyrinth; abrasive particles can reach the seal area. Review BP-2P-50-0001, for which no certified IP rating is currently claimed. | BP-2P-130-0001.html | Approve a persistent localized translation or explicitly classify the source as non-translatable.
de | 5f8166385cab47dc | <strong>Dusty or abrasive environments</strong> — this model has no protective shroud or labyrinth. Review BP-2P-50-0001, for which no certified IP rating is currently claimed, or add a separately verified external protection solution. | BP-3P-0004.html;BP-3P-0006.html;BP-3P-0007.html | Approve a persistent localized translation or explicitly classify the source as non-translatable.
de | f00bbf193a02a602 | <strong>Dusty or abrasive environments</strong> (steel mill, foundry) — this model has no protective shroud or labyrinth. Review <a href="BP-2P-50-0001.html">BP-2P-50-0001</a>, for which no certified IP rating is currently claimed, or add a separately verified external protection solution. | BP-2P-16-0001.html | Approve a persistent localized translation or explicitly classify the source as non-translatable.
de | 9c9a2cac000c5e3f | <strong>Dusty or abrasive external environments</strong> — while the seal handles clean media, external steel dust or abrasive particles will contaminate the bearing and flange threads, causing seizure; use BP-2P-50-0001 (protective shroud and labyrinth; no certified IP rating claimed) or add external bellows and sealed bearing covers | BP-8P-0001.html | Approve a persistent localized translation or explicitly classify the source as non-translatable.
de | e9c6ccd8d0438c5f | <strong>Dusty or abrasive external environments</strong> — while the Si3N4 seal handles abrasive media, external steel dust will contaminate the bearing and flange threads; use BP-2P-50-0001 (protective shroud and labyrinth; no certified IP rating claimed) or add a protective shroud and bellows | BP-4P-30-0001.html | Approve a persistent localized translation or explicitly classify the source as non-translatable.
de | ac54804f5f11438d | <strong>Effective Date:</strong> June 11, 2026<br> <strong>Last Updated:</strong> July 31, 2026 | privacy.html | Approve a persistent localized translation or explicitly classify the source as non-translatable.
de | 0bd5870485314cb4 | <strong>Flange mount:</strong> Bolt-on flange with O-ring face seal — provides a rigid sealed connection; acceptance criteria depend on the application | faq.html | Approve a persistent localized translation or explicitly classify the source as non-translatable.
de | 0221a75d411c002a | <strong>Food-grade or medical cleanroom</strong> — materials and compliance documentation require separate written confirmation | BP-2P-50-0001.html | Approve a persistent localized translation or explicitly classify the source as non-translatable.
de | 884e15e3e728c61f | <strong>Google Analytics 4</strong> — After consent, GA4 records page and session activity, referral information, consent events, contact/download interactions, form attempts, and confirmed inquiry events. A confirmed inquiry event may include the inquiry type and requested product, but our code does not send your name, email address, company, country, free-text requirements, or attachment to GA4. Google Signals and advertising personalization are disabled. Analytics retention follows the current GA4 property configuration. <a href="https://policies.google.com/privacy" target="_blank" rel="noopener noreferrer">Google Privacy Policy</a> | privacy.html | Approve a persistent localized translation or explicitly classify the source as non-translatable.
de | 2aa8bc6115755c62 | <strong>Grade 45 carbon steel body:</strong> Chinese standard carbon steel (equivalent to AISI 1045). Yield strength 355 MPa, hardness 170–210 HB. Suitable for stationary mounting where rigidity and thread strength matter. Not recommended for continuous water exposure without surface treatment — specify nickel plating or stainless steel (304/316) for wet environments.<br><br><strong>PTFE composite seal:</strong> Polytetrafluoroethylene with glass fiber and graphite filler. Self-lubricating, chemically inert, and rated for -200°C to +260°C. The composite structure provides structural integrity while maintaining the low friction coefficient (0.05–0.10 against steel) that makes PTFE ideal for rotary seals. FKM O-ring provides static sealing at the housing interface. | BP-1P-0003.html | Approve a persistent localized translation or explicitly classify the source as non-translatable.
de | 138a93b8008ec82d | <strong>Heavy-duty or continuous operation:</strong> Set and document inspection, cleaning, and replacement intervals from the actual dust load, duty cycle, and supplied maintenance instructions | BP-2P-50-0001.html | Approve a persistent localized translation or explicitly classify the source as non-translatable.
de | 27eb705b3477834f | <strong>Hosting and email providers:</strong> The PHP form handler validates the request and uses PHPMailer to send it through authenticated SMTP to the configured Begapunk sales mailbox. The handler does not write inquiry fields or attachments to a website database. | privacy.html | Approve a persistent localized translation or explicitly classify the source as non-translatable.
de | 881c7eba633a3e2f | <strong>How to Select a Pneumatic Rotary Joint</strong> <span>5 parameters that prevent costly mistakes: passage count, pressure, RPM, media compatibility, and mounting type.</span> | BP-1P-0003.html;BP-1P-0006.html;BP-2P-0001.html;BP-2P-0002.html;BP-2P-08-0001.html;BP-2P-130-0001.html;BP-2P-16-0001.html;BP-2P-30-0001.html;BP-2P-50-0001.html;BP-2P-95-0001.html;BP-3P-0004.html;BP-3P-0006.html;BP-3P-0007.html;BP-3P-S06-0001.html;BP-4P-30-0001.html;BP-8P-0001.html | Approve a persistent localized translation or explicitly classify the source as non-translatable.
de | cc80299810c26240 | <strong>How to Select a Pneumatic Rotary Joint</strong><span>5 parameters that prevent costly mistakes: passage count, pressure, RPM, media compatibility, and mounting type.</span> | application-automation-rotary-tables.html;application-bottle-filling-capping.html;application-laser-tube-cutting.html;application-packaging-machinery.html;application-pneumatic-tools-hose-anti-twist.html;application-robot-end-of-arm-tooling.html | Approve a persistent localized translation or explicitly classify the source as non-translatable.
de | d377e0ca89a0d827 | <strong>Inquiry and contact information:</strong> Name, email address, company name, country, product interest, application details, technical requirements, inquiry type, and source-page information that you submit through the quote request form. | privacy.html | Approve a persistent localized translation or explicitly classify the source as non-translatable.
de | ad49f4ee7570a614 | <strong>Inquiry data:</strong> The current website handler does not create a database record. The email and any attachment remain in the sales mailbox according to operational, follow-up, warranty, and legal needs. | privacy.html | Approve a persistent localized translation or explicitly classify the source as non-translatable.
de | d7ea139c4d846515 | <strong>Integrated pneumatic-electric rotary joint:</strong> Air passages + electrical slip rings in one housing. Example: <a href="BP-3P-S06-0001.html">BP-3P-S06-0001</a> (3 air passages + 6 electrical circuits). A compact integrated design may be suitable where installation space is limited and the required passage count fits the available configuration. | application-automation-rotary-tables.html | Approve a persistent localized translation or explicitly classify the source as non-translatable.
de | f1c5f0cb7a6cf183 | <strong>Leak tolerance:</strong> Even a 0.01 MPa leak from the gripper channel into the vacuum channel reduces holding force by 15–20%. Begapunk multi-passage joints use mechanically isolated seal assemblies — each passage is a complete, independent sealing system. | application-robot-end-of-arm-tooling.html | Approve a persistent localized translation or explicitly classify the source as non-translatable.
de | 1ec3e6247fa918ab | <strong>Lightweight 6061 aluminum alloy body at 265 g:</strong> Low rotational inertia for small rotary tables and precision instrument turntables | BP-1P-0006.html | Approve a persistent localized translation or explicitly classify the source as non-translatable.
de | 97c4d33caa0ed86b | <strong>Material:</strong> Grade 45 carbon steel — spatter resistant and thermally stable | application-welding-positioners.html | Approve a persistent localized translation or explicitly classify the source as non-translatable.
de | 3f8cea40f2fc96a8 | <strong>Material:</strong> Grade 45 carbon steel or 304 SS — abrasion and spatter resistant | application-steel-dusty-environments.html | Approve a persistent localized translation or explicitly classify the source as non-translatable.
de | 1cb9b90bb298cb46 | <strong>Media:</strong> dry air; other media require written compatibility confirmation for the selected model and operating conditions | application-steel-dusty-environments.html | Approve a persistent localized translation or explicitly classify the source as non-translatable.
de | bd76e330c3952545 | <strong>Non-air service:</strong> Obtain written compatibility confirmation for the operating conditions before operation, then establish a written inspection, cleaning, and replacement plan | BP-2P-50-0001.html | Approve a persistent localized translation or explicitly classify the source as non-translatable.
de | aab16c2b2484d8b0 | <strong>Number of passages:</strong> 1-in-1-out, 2-in-2-out, 3-in-3-out, or custom multi-passage | faq.html | Approve a persistent localized translation or explicitly classify the source as non-translatable.
de | ba246dc61f430d51 | <strong>Order data:</strong> Retained as required by applicable tax, accounting, warranty, and commercial laws. | privacy.html | Approve a persistent localized translation or explicitly classify the source as non-translatable.
de | feb8d7acf5c9bfde | <strong>Pressure above 1 MPa</strong> — the PTFE seal and 6061 aluminum alloy body are rated to 1 MPa max; use BP-2P-0002 (1.5 MPa) or BP-2P-130-0001 (5 MPa) for higher pressure | BP-3P-0004.html;BP-3P-0006.html;BP-3P-0007.html | Approve a persistent localized translation or explicitly classify the source as non-translatable.
de | 5ca1b63ba04e401f | <strong>Pressure above 1.0 MPa</strong> — the 6061 aluminum alloy body and 4-M5 flange mount are rated for 1 MPa maximum; higher pressure requires a custom steel-body design with thicker wall sections and larger flange bolts | BP-8P-0001.html | Approve a persistent localized translation or explicitly classify the source as non-translatable.
de | 611eb95d2ad377dd | <strong>Pressure above 1.0 MPa</strong> — the 6061 aluminum alloy body and M5 port threads are rated for 1 MPa maximum; higher pressure requires BP-2P-0002 (1.5 MPa) or custom steel-body design | BP-3P-S06-0001.html | Approve a persistent localized translation or explicitly classify the source as non-translatable.
de | a76d438ce9a45cd5 | <strong>Protection:</strong> protective-shroud or labyrinth design for dusty environments; do not assume a certified IP rating without model-specific confirmation | application-steel-dusty-environments.html | Approve a persistent localized translation or explicitly classify the source as non-translatable.
de | 99cf2066179f397c | <strong>Protective shroud and labyrinth for dusty environments:</strong> The design reduces direct particle exposure at the seal area. No certified IP rating is currently claimed. | BP-2P-50-0001.html | Approve a persistent localized translation or explicitly classify the source as non-translatable.
de | 0341b2a4986ab580 | <strong>Rate-limit data:</strong> Recent attempt timestamps are evaluated within a 15-minute window in server temporary storage. | privacy.html | Approve a persistent localized translation or explicitly classify the source as non-translatable.
de | abfa19527285e172 | <strong>Rotary Joints for Dusty Environments: Application Guide</strong> <span>Environmental protection, contamination control, maintenance planning, and when to request separately confirmed protection for steel mills and foundries.</span> | BP-2P-50-0001.html | Approve a persistent localized translation or explicitly classify the source as non-translatable.
de | daaba62994748372 | <strong>Service planning:</strong> Determine spare parts, cleaning methods, and replacement procedures from the supplied configuration and written maintenance plan | BP-2P-50-0001.html | Approve a persistent localized translation or explicitly classify the source as non-translatable.
de | 04593034003fabaa | <strong>Shaft:</strong> Grade 45 carbon steel, 304 SS, or 316 SS | faq.html | Approve a persistent localized translation or explicitly classify the source as non-translatable.
de | 3427169a1f87c081 | <strong>Single-passage applications where a simpler joint is preferred</strong> — use BP-1P-0003 (0.27 kg, Grade 45 carbon steel) for a single air or fluid line | BP-2P-0001.html | Approve a persistent localized translation or explicitly classify the source as non-translatable.
de | 358e1cb3fa001222 | <strong>Single-passage applications</strong> — the 8.66 kg mass and two-passage cost are unnecessary; use BP-1P-0003 or BP-2P-0001 | BP-2P-130-0001.html | Approve a persistent localized translation or explicitly classify the source as non-translatable.
de | 6a309830de70380f | <strong>Technical information:</strong> IP address and request metadata that may be processed by the web server for delivery, security, and logging. The inquiry handler derives a one-way hash from the request IP address and keeps recent attempt timestamps in server temporary storage for a 15-minute rate-limit window. | privacy.html | Approve a persistent localized translation or explicitly classify the source as non-translatable.
de | ee3d320cb1ae4e7a | <strong>Technical Note:</strong> All pressure ratings and RPM specifications referenced in this article are based on Begapunk BP-series standard pneumatic rotary joints. Actual performance depends on operating conditions and maintenance practices. For applications outside standard ratings, consult factory engineering before specification. For general pneumatic system design guidance, refer to <a href="https://www.iso.org/standard/46511.html" target="_blank" rel="noopener noreferrer">ISO 4414:2010 Pneumatic fluid power — General rules and safety requirements for systems and their components</a>. | blog-rotary-joint-leaking.html | Approve a persistent localized translation or explicitly classify the source as non-translatable.
de | 75bebace671f984b | <strong>Technical Note:</strong> The formal engineering drawing lists a maximum pressure of 1 MPa / 10 bar, maximum speed of 200 RPM, 6061 aluminum alloy body, and -20°C to +80°C operating range. Actual performance depends on medium, temperature, duty cycle, installation, and maintenance. Consult Begapunk engineering for applications outside these limits. <strong>Last updated:</strong> July 12, 2026. | BP-2P-95-0001.html | Approve a persistent localized translation or explicitly classify the source as non-translatable.
de | 63fdac79b830d894 | <strong>Tip:</strong> Add one spare channel if your machine is likely to be upgraded later. It is cheaper to specify a 3-passage joint now than to replace a 2-passage joint in 18 months. | blog-rotary-joint-selection.html | Approve a persistent localized translation or explicitly classify the source as non-translatable.
de | c76a3920915bfb1a | <strong>Triple passage in a 0.49 kg package:</strong> Three independent air/fluid channels in a compact 6061 aluminum alloy body for multi-function rotary tables and packaging machinery | BP-3P-0004.html | Approve a persistent localized translation or explicitly classify the source as non-translatable.
de | 98275b42ec3f0d44 | <strong>Typical requirement:</strong> 2–3 passages at 0.3–0.6 MPa, ultra-compact threaded mount (often M5 or G1/8), lightweight 6061 aluminum alloy body, with integrated electrical slip ring options for combined pneumatic-electric EOAT designs. | applications.html | Approve a persistent localized translation or explicitly classify the source as non-translatable.
de | baa11574c5c33c3e | <strong>Typical requirement:</strong> 2–4 independent air passages at 0.3–0.6 MPa, 60–120 RPM indexing speed, with flange mount for anti-rotation stability. Multi-passage layouts prevent cross-contamination between clamp and vacuum circuits. | applications.html | Approve a persistent localized translation or explicitly classify the source as non-translatable.
de | 7952f242b9e5e358 | <strong>Typical requirement:</strong> 2–4 passages at 0.4–0.8 MPa, 5–60 RPM slow rotation, flange mount with IP65 dust protection, Grade 45 carbon steel or 304 SS body for weld spatter resistance, with heavy-duty anti-rotation bracket for vibration isolation. | applications.html | Approve a persistent localized translation or explicitly classify the source as non-translatable.
de | 18dd0e83004a03ef | <strong>Typical requirement:</strong> 2–4 passages at 0.4–1.0 MPa, 10–100 RPM, flange mount with IP65 dust protection, Grade 45 carbon steel or 304 SS body for impact resistance, with sealed bearings and external dust shields. 25-micron filtration minimum; 10-micron recommended. | applications.html | Approve a persistent localized translation or explicitly classify the source as non-translatable.
de | 48c4804201b36005 | <strong>Uploaded files:</strong> PHP processes an attachment from temporary upload storage for the SMTP message; the website code does not intentionally retain a separate server copy after the request. | privacy.html | Approve a persistent localized translation or explicitly classify the source as non-translatable.
de | 1b7ee2539fa24dc7 | ✅ Candidate configuration — protective shroud and labyrinth; no certified IP rating claimed | BP-2P-50-0001.html | Approve a persistent localized translation or explicitly classify the source as non-translatable.
de | a8a5984e35b8aa63 | ✅ Good — Grade 45 carbon steel body | BP-1P-0003.html | Approve a persistent localized translation or explicitly classify the source as non-translatable.
de | 0b6dfbcdd6219e91 | ✅ Inquiry Reviewed by Our Team | thank-you.html | Approve a persistent localized translation or explicitly classify the source as non-translatable.
de | 47e7bdbb24f8ba81 | ✅ Technical Support | thank-you.html | Approve a persistent localized translation or explicitly classify the source as non-translatable.
de | f4fd621c0518b60a | ❌ No certified IP rating is claimed | BP-2P-50-0001.html | Approve a persistent localized translation or explicitly classify the source as non-translatable.
de | 83bc01e0498a6237 | ❌ Not confirmed by the public specification | BP-2P-50-0001.html | Approve a persistent localized translation or explicitly classify the source as non-translatable.
de | 54829d1d3655c244 | ❌ Outside the published speed limit | BP-2P-50-0001.html | Approve a persistent localized translation or explicitly classify the source as non-translatable.
de | 7e743a067e3527c4 | 0.10–0.20 N·m (air) | BP-2P-50-0001.html | Approve a persistent localized translation or explicitly classify the source as non-translatable.
de | 7299ad6e182d698d | 1-inlet/6-outlet pneumatic rotary union with G1/8 ports, 4 mm orifice, 1 MPa operating pressure and 300 RPM rating for rotary air distribution. | BP-1P-0006.html | Approve a persistent localized translation or explicitly classify the source as non-translatable.
de | 1756c362c46b7fe6 | 1. Passage Count: Match Your Pneumatic Circuit, Not Your Wish List | blog-rotary-joint-selection.html | Approve a persistent localized translation or explicitly classify the source as non-translatable.
de | 194b2d18c17f5a6d | 2-inlet/3-outlet pneumatic rotary union with G1/8 ports, 4 mm orifice, 1 MPa operating pressure and 300 RPM rating for compact automation systems. | BP-2P-0002.html | Approve a persistent localized translation or explicitly classify the source as non-translatable.
de | eed065386eb09b10 | 2-inlet/4-outlet pneumatic rotary union with a 1 MPa pressure rating and 200 RPM speed rating for rotary fixtures and multi-outlet fluid distribution. | BP-2P-95-0001.html | Approve a persistent localized translation or explicitly classify the source as non-translatable.
de | 9a949a1feaa8dad1 | 2-passage pneumatic rotary union with flange mounting, 1 MPa operating pressure and 200 RPM rating for rotary tables, packaging and pneumatic clamping. | BP-2P-0001.html | Approve a persistent localized translation or explicitly classify the source as non-translatable.
de | 0e55750f9d479e22 | 2-passage rotary joint for pneumatic and light-fluid applications. PTFE composite seal, 6061 aluminum alloy body. Max 1 MPa / 10 bar, 162 mm outer diameter, 4.26 kg. Distributes 2 inlet supplies to 4 outlet ports for multi-actuator rotary tables. Lead time is confirmed for the selected model and order. | BP-2P-95-0001.html | Approve a persistent localized translation or explicitly classify the source as non-translatable.
de | 83920f5d4a03a5c5 | 2-passage through-bore pneumatic rotary union with a 16 mm bore, flange mounting, 1 MPa operating pressure and 200 RPM rating for rotary fixtures. | BP-2P-16-0001.html | Approve a persistent localized translation or explicitly classify the source as non-translatable.
de | 93ac35991d5ba26a | 2-passage through-bore pneumatic rotary union with a 30 mm bore, flange mounting, 1 MPa operating pressure and 150 RPM rating for OEM machinery. | BP-2P-30-0001.html | Approve a persistent localized translation or explicitly classify the source as non-translatable.
de | b14e03d807ffbb01 | 200K+ units produced | index.html | Approve a persistent localized translation or explicitly classify the source as non-translatable.
de | 19568c4c1cfe9c1a | 2D/3D | index.html | Approve a persistent localized translation or explicitly classify the source as non-translatable.
de | 00d2810600758fcd | 3-passage pneumatic rotary union with flange mounting, 1 MPa operating pressure and 200 RPM rating for indexing tables and automation equipment. | BP-3P-0004.html | Approve a persistent localized translation or explicitly classify the source as non-translatable.
de | 03977498cb9773e3 | 3-passage pneumatic rotary union with G1/4 ports, 6 mm orifice, 1 MPa operating pressure and 200 RPM rating for mid-size rotary fixtures. | BP-3P-0006.html | Approve a persistent localized translation or explicitly classify the source as non-translatable.
de | 78faac4a7b91730f | 3.1 Essential Local Storage (Always Active) | privacy.html | Approve a persistent localized translation or explicitly classify the source as non-translatable.
de | 81a25e587027b760 | 3D files may be provided after application review. Use the supplied model to verify clearance, port direction, mounting engagement, and shroud clearance before ordering. | BP-2P-50-0001.html | Approve a persistent localized translation or explicitly classify the source as non-translatable.
de | 44eaa8e65e5459b9 | 3D STEP or IGES files may be provided after the application requirements are reviewed. Use the supplied file to verify clearance, port direction, mounting engagement, and shroud clearance before ordering. Confirm the complete mounting dimensions against the supplied drawing before machining. | BP-2P-50-0001.html | Approve a persistent localized translation or explicitly classify the source as non-translatable.
de | 4bd1fc1b0cc7f75c | 4-passage pneumatic rotary union with a 30 mm through-bore, flange mounting, 1 MPa operating pressure and 200 RPM rating for OEM rotary equipment. | BP-4P-30-0001.html | Approve a persistent localized translation or explicitly classify the source as non-translatable.
de | a64e8aa75d1d577c | 5 parameters that prevent costly mistakes: passage count, pressure, RPM, media compatibility, and mounting type. | applications.html | Approve a persistent localized translation or explicitly classify the source as non-translatable.
de | fa5bb7f2929660bc | 6061 aluminum alloy | BP-1P-0006.html;BP-2P-0001.html;BP-2P-0002.html;BP-2P-130-0001.html;BP-2P-30-0001.html;BP-2P-50-0001.html;BP-2P-95-0001.html;BP-3P-0004.html;BP-3P-0006.html;BP-3P-0007.html;BP-3P-S06-0001.html;BP-4P-30-0001.html;BP-8P-0001.html;product-comparison.html;products.html | Approve a persistent localized translation or explicitly classify the source as non-translatable.
de | ab74ef16029c8f4f | 6061 aluminum alloy, Anodized | BP-3P-S06-0001.html | Approve a persistent localized translation or explicitly classify the source as non-translatable.
de | 0f699bf7ba1eba7d | 8 passages, flange mount, 200 RPM. For high-density multi-passage rotary systems. | BP-4P-30-0001.html | Approve a persistent localized translation or explicitly classify the source as non-translatable.
de | 92ace7d81d3c10f3 | 8 passages, flange mount. For complex automation and multi-passage machinery. | BP-2P-0001.html;BP-2P-0002.html;BP-2P-08-0001.html | Approve a persistent localized translation or explicitly classify the source as non-translatable.
de | c3b152f3d2af257f | 8-passage flange-mount rotary joint for pneumatic and light fluid applications. PTFE composite seal, 6061 aluminum alloy body. Lead time is confirmed for the selected model and order. Used on high-density multi-station indexing tables, packaging machinery, and complex pneumatic distribution systems where 8 independent air channels must rotate through a single compact interface. | BP-8P-0001.html | Approve a persistent localized translation or explicitly classify the source as non-translatable.
de | 52f7a3c61a4cd470 | 8-passage pneumatic rotary union with flange mounting, 1 MPa operating pressure and 200 RPM rating for multi-station automation and air distribution. | BP-8P-0001.html | Approve a persistent localized translation or explicitly classify the source as non-translatable.
de | 936238c5f51e44db | A 3-passage joint is specified for "gripper, vacuum, and blow-off." But the integrator routes vacuum and blow-off through the same channel to save a passage. The result: when blow-off pulses at 0.3 MPa, it back-feeds into the vacuum line, momentarily destroying holding force. Parts drop. The customer blames the gripper. <strong>Rule:</strong> Every pneumatic function gets its own independent passage. Vacuum, positive pressure, and blow-off must never share a channel. The cost of one extra passage is negligible compared to a dropped-part incident. | application-robot-end-of-arm-tooling.html | Approve a persistent localized translation or explicitly classify the source as non-translatable.
de | f4d9df1ad114cef3 | A machine builder needs three different air pressures for clamp, blow-off, and vacuum on a rotary table. They buy BP-2P-0002 and install regulators on each outlet. The problem: outlet 3 shares an inlet with outlet 1 or 2, so when the clamp line pressurizes, the blow-off line pressure fluctuates. The result is inconsistent part handling and dropped workpieces. <strong>Rule:</strong> BP-2P-0002 has 2 inlets feeding 3 outlets. For three truly independent pressure zones, use BP-3P-0007 (3-in-3-out) with separate inlet control for each passage. | BP-2P-0002.html | Approve a persistent localized translation or explicitly classify the source as non-translatable.
de | 152ff610d49ab8b1 | A rotary joint (also called rotary union or swivel joint) is a precision mechanical device used to transfer fluid — air, water, oil, coolant, or steam — from a stationary source to a rotating destination, or vice versa. Begapunk manufactures single-passage and multi-passage rotary unions for industrial automation, CNC machining, laser cutting, packaging, and other rotating machinery applications. | faq.html | Approve a persistent localized translation or explicitly classify the source as non-translatable.
de | 11878e459b5f2c94 | About Begapunk | Pneumatic Rotary Union Manufacturer | about.html | Approve a persistent localized translation or explicitly classify the source as non-translatable.
de | 9dd526d2147a0f10 | Air is the standard public medium. Other media require written compatibility confirmation for the operating conditions before selection or use. | BP-2P-50-0001.html | Approve a persistent localized translation or explicitly classify the source as non-translatable.
de | 657a73361974e66a | Air or vacuum | application-textile-printing-converting.html | Approve a persistent localized translation or explicitly classify the source as non-translatable.
de | e40577140dd2bdcc | Air service in dusty environments; protective shroud and labyrinth; no certified IP rating claimed | product-comparison.html | Approve a persistent localized translation or explicitly classify the source as non-translatable.
de | 0476a980c89cca8b | Air service is the standard public application. Other media require written compatibility confirmation for the operating conditions. | BP-2P-50-0001.html | Approve a persistent localized translation or explicitly classify the source as non-translatable.
de | c0798ab671207789 | Air Swivel for Pneumatic Tools &amp; Hoses | Begapunk | application-pneumatic-tools-hose-anti-twist.html | Approve a persistent localized translation or explicitly classify the source as non-translatable.
de | 6dd737ef0ceb68a9 | Air. Other media require written compatibility confirmation for the operating conditions. | BP-2P-50-0001.html | Approve a persistent localized translation or explicitly classify the source as non-translatable.
de | a94404b724cf012d | Always add one spare passage — replacing a 4-passage joint with a 5-passage joint costs 3× more than specifying it upfront | application-automation-rotary-tables.html | Approve a persistent localized translation or explicitly classify the source as non-translatable.
de | 6f0e3dee8f7832c6 | Answers about pneumatic rotary union media, pressure, speed, passage count, custom designs, installation, delivery and warranty. | faq.html | Approve a persistent localized translation or explicitly classify the source as non-translatable.
de | b6e80ce468495771 | Application to product-family comparison | applications.html | Approve a persistent localized translation or explicitly classify the source as non-translatable.
de | 4638b968457735a1 | Applications where leakage must be near-zero (Class 0) | blog-rotary-union-seal-types.html | Approve a persistent localized translation or explicitly classify the source as non-translatable.
de | 13bf60ceabe6b4f5 | At Begapunk, automation rotary tables account for roughly <strong>25% of our multi-passage rotary joint sales</strong>. The most frequent specification error is not the pressure or RPM — it is the passage count. Machine builders specify exactly the channels needed today, with no room for the sensor or gripper the customer adds 12 months later. | application-automation-rotary-tables.html | Approve a persistent localized translation or explicitly classify the source as non-translatable.
de | 78d400a6c3e2c1b1 | Available PDF technical drawings can be downloaded without signup. | thank-you.html | Approve a persistent localized translation or explicitly classify the source as non-translatable.
de | aedd32210cf364a3 | Avoid seven common rotary union installation mistakes involving alignment, piping loads, filtration, thread sealing, run-in and leak testing. | blog-rotary-joint-installation-mistakes.html | Approve a persistent localized translation or explicitly classify the source as non-translatable.
de | d35da1c55a1df7cd | Begapunk designs and manufactures single-passage, multi-passage, through-bore and custom pneumatic rotary unions for industrial automation equipment. | index.html | Approve a persistent localized translation or explicitly classify the source as non-translatable.
de | cbcdfb7c4c5ae02d | Begapunk is a specialized rotary joint (rotary union) manufacturer based in Ningbo, Zhejiang Province, China. We design and produce single-passage and multi-passage rotary unions for industrial automation, CNC machining, laser cutting, plastic extrusion, wind energy, and other rotating machinery applications. | about.html | Approve a persistent localized translation or explicitly classify the source as non-translatable.
de | 250a8e29d5c06130 | Begapunk privacy policy explaining website analytics, inquiry form processing, data use, retention, security, and user choices. | privacy.html | Approve a persistent localized translation or explicitly classify the source as non-translatable.
de | 5b59e7a40c9962d5 | Begapunk Rotary Joints | Custom Multi-Passage Rotary Unions | index.html | Approve a persistent localized translation or explicitly classify the source as non-translatable.
de | a962c52c0653aea3 | Begapunk's cumulative production has exceeded 200,000 rotary joints. Specification mismatches are a common and avoidable source of application problems. A joint rated for 1.0 MPa gets run at 1.2 MPa. A Glyd Ring seal gets used in a 1,000 RPM application when the spec sheet said 500 RPM max. These are preventable errors. | blog-rotary-joint-selection.html | Approve a persistent localized translation or explicitly classify the source as non-translatable.
de | cd284cb420842aa4 | BP-1P-0003 — Single-Passage Pneumatic Rotary Union | BP-1P-0003.html | Approve a persistent localized translation or explicitly classify the source as non-translatable.
de | 9f6252f99e76a55b | BP-1P-0003 · Single-Passage | BP-1P-0006.html;BP-2P-0001.html;BP-2P-0002.html;products.html | Approve a persistent localized translation or explicitly classify the source as non-translatable.
de | 47203fa331d58343 | BP-1P-0003 is a single-passage rotary joint designed for low-pressure pneumatic and light fluid transfer. The PTFE composite seal provides low friction torque (0.02–0.04 N·m) and chemical resistance across air, water, and coolant media. The Grade 45 carbon steel body offers rigidity and durable threaded connections for handheld tools and stationary mounting. | BP-1P-0003.html | Approve a persistent localized translation or explicitly classify the source as non-translatable.
de | e700ab5eaa84776f | BP-1P-0003 is designed for single-air-line applications where weight, simplicity, and cost matter more than multi-passage complexity. This model may be suitable for the listed applications when its passage count, mounting, medium, pressure, speed, and temperature limits match the machine requirements. | BP-1P-0003.html | Approve a persistent localized translation or explicitly classify the source as non-translatable.
de | 7a89f7c872b001f9 | BP-1P-0003 Single-Passage Pneumatic Rotary Union | Begapunk | BP-1P-0003.html | Approve a persistent localized translation or explicitly classify the source as non-translatable.
de | 3ceae08a92283dc5 | BP-1P-0003 single-passage pneumatic rotary union threaded 45 steel compact | products.html | Approve a persistent localized translation or explicitly classify the source as non-translatable.
de | 78241ef59d229837 | BP-1P-0003 single-passage pneumatic rotary union threaded mount 45 steel | BP-1P-0003.html | Approve a persistent localized translation or explicitly classify the source as non-translatable.
de | 14d44b67588d78a8 | BP-1P-0003 single-passage rotary joint: threaded mount, 1 MPa, 500 RPM, Grade 45 carbon steel body, PTFE composite seal. | BP-1P-0003.html | Approve a persistent localized translation or explicitly classify the source as non-translatable.
de | abd565a1dcff43a5 | BP-1P-0003 single-passage rotary joint: threaded mount, 1 MPa, 500 RPM, Grade 45 carbon steel body, PTFE composite seal. For pneumatic tools and small rotary tables. | BP-1P-0003.html | Approve a persistent localized translation or explicitly classify the source as non-translatable.
de | 9a14fc3b2de76e79 | BP-1P-0006 — 1-Inlet/6-Outlet (G1/8) | BP-1P-0003.html | Approve a persistent localized translation or explicitly classify the source as non-translatable.
de | ac948fbeaddd5160 | BP-1P-0006 · 1-Inlet/6-Outlet (G1/8) | BP-3P-0007.html;products-p2.html | Approve a persistent localized translation or explicitly classify the source as non-translatable.
de | 3cb0ad6fcc2a382a | BP-1P-0006 · 1-Inlet/6-Outlet Pneumatic Rotary Union (4 mm Orifice) | BP-1P-0006.html | Approve a persistent localized translation or explicitly classify the source as non-translatable.
de | 3321422c98f4ca80 | BP-1P-0006 1-Inlet/6-Outlet Pneumatic Rotary Union | Begapunk | BP-1P-0006.html | Approve a persistent localized translation or explicitly classify the source as non-translatable.
de | 7d1280d8cc67c13a | BP-1P-0006 1-inlet/6-outlet pneumatic rotary union G1/8 threaded 4mm orifice AL6061 | BP-1P-0006.html | Approve a persistent localized translation or explicitly classify the source as non-translatable.
de | ef26cf63dcc44236 | BP-1P-0006 1-inlet/6-outlet pneumatic rotary union with G1/8 thread. 4mm orifice, max 1 MPa, 300 RPM, 6061 aluminum alloy body, PTFE composite seal. | BP-1P-0006.html | Approve a persistent localized translation or explicitly classify the source as non-translatable.
de | 29d2a26e43439e63 | BP-1P-0006 1-inlet/6-outlet pneumatic rotary union with G1/8 thread. 4mm orifice, max 1 MPa, 300 RPM, 6061 aluminum alloy body, PTFE composite seal. Distributes one air supply to 6 outlets for assembly stations and rotary tables. | BP-1P-0006.html | Approve a persistent localized translation or explicitly classify the source as non-translatable.
de | bcf1bd37609637ea | BP-1P-0006 is a single-inlet, six-outlet rotary joint designed for low-pressure pneumatic distribution. The 4mm orifice provides balanced flow across all six outlets when supplied from a common inlet. The 6061 aluminum alloy body keeps weight at 265 g, while the deep-groove ball bearing supports smooth rotation up to 300 RPM. The PTFE composite seal provides chemical resistance across air, water, and coolant media with idle torque ≤0.15 N·m. | BP-1P-0006.html | Approve a persistent localized translation or explicitly classify the source as non-translatable.
de | 5580c38975f3039f | BP-2P-0001 — 2-Passage (Flange) | BP-1P-0003.html | Approve a persistent localized translation or explicitly classify the source as non-translatable.
de | 1f9bdbbbc03350ef | BP-2P-0001 · 2-Passage | BP-4P-30-0001.html;BP-8P-0001.html;products.html | Approve a persistent localized translation or explicitly classify the source as non-translatable.
de | 324e9db449dc8ffe | BP-2P-0001 · 2-Passage (Flange) | BP-1P-0006.html;BP-2P-0002.html;BP-2P-08-0001.html;BP-2P-130-0001.html;BP-2P-16-0001.html;BP-2P-50-0001.html;BP-2P-95-0001.html;BP-3P-0004.html;BP-3P-0006.html;BP-3P-S06-0001.html | Approve a persistent localized translation or explicitly classify the source as non-translatable.
de | aa2a0350250d0e1d | BP-2P-0001 · 2-Passage Pneumatic Rotary Union | BP-2P-0001.html | Approve a persistent localized translation or explicitly classify the source as non-translatable.
de | 22df3ab738f808f6 | BP-2P-0001 2-passage pneumatic rotary union | case-studies.html | Approve a persistent localized translation or explicitly classify the source as non-translatable.
de | 524cc025e99e475e | BP-2P-0001 2-Passage Pneumatic Rotary Union | Begapunk | BP-2P-0001.html | Approve a persistent localized translation or explicitly classify the source as non-translatable.
de | 1fe46a0446b1ba5b | BP-2P-0001 2-passage pneumatic rotary union flange mount AL6061 steel | BP-2P-0001.html | Approve a persistent localized translation or explicitly classify the source as non-translatable.
de | 27964175a6518cc7 | BP-2P-0001 2-passage pneumatic rotary union flange mount aluminum anodized | products.html | Approve a persistent localized translation or explicitly classify the source as non-translatable.
de | 8dbf09fc9c133209 | BP-2P-0001 2-passage pneumatic rotary union with flange mount. Max 1 MPa, 200 RPM, 6061 aluminum alloy body, PTFE seal. | BP-2P-0001.html | Approve a persistent localized translation or explicitly classify the source as non-translatable.
de | 93831f31e6a5c8f9 | BP-2P-0001 2-passage pneumatic rotary union with flange mount. Max 1 MPa, 200 RPM, 6061 aluminum alloy body, PTFE seal. For clamp + release and two-passage rotary tables. | BP-2P-0001.html | Approve a persistent localized translation or explicitly classify the source as non-translatable.
de | 2fe31e12c9f8fc4e | BP-2P-0001 is a two-passage flange-mounted rotary joint designed for independent two-channel pneumatic and light fluid transfer. The 6061 aluminum alloy body keeps the assembly light and corrosion resistant. The PTFE composite seal provides low friction and chemical resistance across air, water, and coolant media. Each passage is independently sealed — pressure in channel A does not affect channel B. | BP-2P-0001.html | Approve a persistent localized translation or explicitly classify the source as non-translatable.
de | e5ab3d8f36118a91 | BP-2P-0002 · 2-Inlet/3-Outlet (G1/8) | BP-1P-0006.html;BP-2P-0001.html;BP-2P-08-0001.html;products-p2.html | Approve a persistent localized translation or explicitly classify the source as non-translatable.
de | 6cee787e116a3f07 | BP-2P-0002 · 2-Inlet/3-Outlet Pneumatic Rotary Union (4 mm Orifice) | BP-2P-0002.html | Approve a persistent localized translation or explicitly classify the source as non-translatable.
de | 401c8d07e8693a24 | BP-2P-0002 2-Inlet/3-Outlet Pneumatic Rotary Union | Begapunk | BP-2P-0002.html | Approve a persistent localized translation or explicitly classify the source as non-translatable.
de | fa912ce49446e24c | BP-2P-0002 2-inlet/3-outlet pneumatic rotary union G1/8 threaded 4mm orifice AL6061 | BP-2P-0002.html | Approve a persistent localized translation or explicitly classify the source as non-translatable.
de | a0a191d3b051b504 | BP-2P-0002 2-inlet/3-outlet pneumatic rotary union with G1/8 thread. 4mm orifice, max 1 MPa, 300 RPM, 6061 aluminum alloy body, PTFE composite seal. | BP-2P-0002.html | Approve a persistent localized translation or explicitly classify the source as non-translatable.
de | 755d9d24dd6e4a7b | BP-2P-0002 2-inlet/3-outlet pneumatic rotary union with G1/8 thread. 4mm orifice, max 1 MPa, 300 RPM, 6061 aluminum alloy body, PTFE composite seal. For CNC and robotic automation. | BP-2P-0002.html | Approve a persistent localized translation or explicitly classify the source as non-translatable.
de | b683e49e5ea6375e | BP-2P-0002 is a dual-inlet, triple-outlet threaded rotary joint designed for compact multi-passage pneumatic distribution. The 4mm orifice provides balanced flow across all three outlets when supplied from two inlets. The 6061 aluminum alloy body keeps weight at 220 g, while the deep-groove ball bearing supports smooth rotation up to 300 RPM. The PTFE composite seal provides chemical resistance across air, water, and coolant media with idle torque ≤0.15 N·m. | BP-2P-0002.html | Approve a persistent localized translation or explicitly classify the source as non-translatable.
de | 9eec8eb84b636a9e | BP-2P-0002 is designed for compact multi-passage pneumatic applications where two independent air sources must rotate together. The threaded mount and 220 g weight make it ideal for robot arms and small machine tools. This model may be suitable for the listed applications when its passage count, mounting, medium, pressure, speed, and temperature limits match the machine requirements. | BP-2P-0002.html | Approve a persistent localized translation or explicitly classify the source as non-translatable.
de | 3d9936c041f0a461 | BP-2P-0002 uses BSP parallel (G) threads — G1/8 — with 4× M6 mounting holes on the rotor side and 4× M6 + 2× M8 on the stator side. Confirm your equipment has G1/8 female threads or appropriate adapters. <strong>Do not use NPT adapters</strong> — they add length and create stress concentrations that crack the 6061 aluminum alloy body under side load. Download the 2D drawing for exact dimensions, pitch (0.907 mm for G1/8), M6/M8 hole patterns, and tolerances. | BP-2P-0002.html | Approve a persistent localized translation or explicitly classify the source as non-translatable.
de | f3f6759c503e19a5 | BP-2P-08-0001 · Compact 2-Passage | products-p2.html | Approve a persistent localized translation or explicitly classify the source as non-translatable.
de | 80e7e69b67982330 | BP-2P-08-0001 · Compact 2-Passage (8mm) | BP-2P-30-0001.html | Approve a persistent localized translation or explicitly classify the source as non-translatable.
de | d2090f2c0b0b6b3f | BP-2P-08-0001 · Compact 2-Passage (M5) | BP-2P-0002.html;BP-3P-0007.html | Approve a persistent localized translation or explicitly classify the source as non-translatable.
de | 60e803fb6b7dd6fd | BP-2P-08-0001 · Compact 2-Passage Pneumatic Rotary Union | BP-2P-08-0001.html | Approve a persistent localized translation or explicitly classify the source as non-translatable.
de | d5b32173c5283a44 | BP-2P-08-0001 2-Passage Pneumatic Rotary Union | Begapunk | BP-2P-08-0001.html | Approve a persistent localized translation or explicitly classify the source as non-translatable.
de | 2e19ef8657f1bba0 | BP-2P-08-0001 2-passage pneumatic rotary union M5 threaded compact AL6061 | products-p2.html | Approve a persistent localized translation or explicitly classify the source as non-translatable.
de | 65e14c55a42a4b56 | BP-2P-08-0001 2-passage pneumatic rotary union threaded mount 45 steel | BP-2P-08-0001.html | Approve a persistent localized translation or explicitly classify the source as non-translatable.
de | 6e3079fc1f01ae4c | BP-2P-08-0001 2-passage pneumatic rotary union with M5 threaded mount. Max 1 MPa, 200 RPM, 6061 aluminum alloy body, PTFE seal. | BP-2P-08-0001.html | Approve a persistent localized translation or explicitly classify the source as non-translatable.
de | 78b447b107b8b548 | BP-2P-08-0001 2-passage pneumatic rotary union with M5 threaded mount. Max 1 MPa, 200 RPM, 6061 aluminum alloy body, PTFE seal. For miniature automation and small rotary tables. | BP-2P-08-0001.html | Approve a persistent localized translation or explicitly classify the source as non-translatable.
de | 917c0faf76f4e12c | BP-2P-08-0001 Compact 2-Passage Rotary Union | Begapunk | BP-2P-08-0001.html | Approve a persistent localized translation or explicitly classify the source as non-translatable.
de | 2987ecd4b2ecf4d9 | BP-2P-08-0001 is a two-passage M5 threaded rotary joint designed for miniature pneumatic applications. The M5 thread matches small metric pneumatic fittings common in European and Asian automation equipment. The 6061 aluminum alloy body has an approximate weight of 0.39 kg, making it suitable for small rotary tables driven by stepper motors. The PTFE composite seal provides chemical resistance across air, water, and coolant media. | BP-2P-08-0001.html | Approve a persistent localized translation or explicitly classify the source as non-translatable.
de | 4d1f0f7e4b83c551 | BP-2P-08-0001 is designed for miniature two-passage pneumatic applications where M5 metric fittings and compact dimensions are required. The 0.39 kg body and compact threaded mount suit small electronic and precision equipment. This model may be suitable when its passage count, mounting, medium, pressure, speed, and temperature limits match the machine requirements. | BP-2P-08-0001.html | Approve a persistent localized translation or explicitly classify the source as non-translatable.
de | db71bc901534de5a | BP-2P-130-0001 · Heavy-Duty 2-Passage Pneumatic Rotary Union | BP-2P-130-0001.html | Approve a persistent localized translation or explicitly classify the source as non-translatable.
de | ab00a3962f35d93f | BP-2P-130-0001 2-Passage Pneumatic Rotary Union | Begapunk | BP-2P-130-0001.html | Approve a persistent localized translation or explicitly classify the source as non-translatable.
de | 648ba67498c628b0 | BP-2P-130-0001 2-passage pneumatic rotary union flange mount heavy duty | BP-2P-130-0001.html | Approve a persistent localized translation or explicitly classify the source as non-translatable.
de | f6386092ebc15d00 | BP-2P-130-0001 heavy-duty 2-passage pneumatic rotary union: flange mount, 5 MPa, 80 RPM, 6061 aluminum alloy body, PTFE composite seal. | BP-2P-130-0001.html | Approve a persistent localized translation or explicitly classify the source as non-translatable.
de | b578f6e214673286 | BP-2P-130-0001 heavy-duty 2-passage pneumatic rotary union: flange mount, 5 MPa, 80 RPM, 6061 aluminum alloy body, PTFE composite seal. For hydraulic indexing tables and high-pressure clamping systems. | BP-2P-130-0001.html | Approve a persistent localized translation or explicitly classify the source as non-translatable.
de | d4f9fbc906f7e38d | BP-2P-130-0001 Heavy-Duty 2-Passage Rotary Union | Begapunk | BP-2P-130-0001.html | Approve a persistent localized translation or explicitly classify the source as non-translatable.
de | cbfcddc1e5076d2c | BP-2P-130-0001 is a heavy-duty two-passage rotary joint designed for high-pressure pneumatic and hydraulic applications. The PTFE composite seal is rated for 5 MPa continuous duty with low friction torque at 80 RPM. The 6061 aluminum alloy body supports large machine tool applications while limiting rotating mass. | BP-2P-130-0001.html | Approve a persistent localized translation or explicitly classify the source as non-translatable.
de | 9b3eb307c71bf0b5 | BP-2P-16-0001 · 2-Passage Through-Bore | BP-4P-30-0001.html;BP-8P-0001.html | Approve a persistent localized translation or explicitly classify the source as non-translatable.
de | 1fa047e4ab5362b4 | BP-2P-16-0001 · 2-Passage Through-Bore (16mm) | BP-2P-30-0001.html | Approve a persistent localized translation or explicitly classify the source as non-translatable.
de | a6bbc28e6a903231 | BP-2P-16-0001 · 2-Passage Through-Bore Pneumatic Rotary Union (16 mm Bore) | BP-2P-16-0001.html | Approve a persistent localized translation or explicitly classify the source as non-translatable.
de | 7fdd8c07e48a9c88 | BP-2P-16-0001 2-in-2-out (16mm Bore) rotary joint with flange mount. Max 1 MPa, 200 RPM, 6061 aluminum alloy body, PTFE seal. For CNC indexing tables and welding positioners. | BP-2P-16-0001.html | Approve a persistent localized translation or explicitly classify the source as non-translatable.
de | c459fe3f0e7cfa26 | BP-2P-16-0001 2-in-2-out (16mm Bore) rotary joint with flange mount. Max 1 MPa, 200 RPM, 6061 aluminum alloy body, PTFE seal. For CNC indexing tables, welding positioners, and packaging machinery. Download 2D drawing PDF. | BP-2P-16-0001.html | Approve a persistent localized translation or explicitly classify the source as non-translatable.
de | 379465780af08dc3 | BP-2P-16-0001 2-Passage Through-Bore Pneumatic Rotary Union (16 mm Bore) | Begapunk | BP-2P-16-0001.html | Approve a persistent localized translation or explicitly classify the source as non-translatable.
de | e0c71b3dd5d3c607 | BP-2P-16-0001 2-Passage Through-Bore Rotary Union | Begapunk | BP-2P-16-0001.html | Approve a persistent localized translation or explicitly classify the source as non-translatable.
de | d5c18acb7ce113ac | BP-2P-16-0001 is a two-passage rotary joint with a 16mm central bore, designed for low-pressure pneumatic and light fluid transfer on compact rotary equipment. The PTFE composite seal provides low friction torque and chemical resistance across air, water, and coolant media. The 6061 aluminum alloy body offers a strength-to-weight ratio ideal for indexing tables where rotating inertia affects positioning accuracy. | BP-2P-16-0001.html | Approve a persistent localized translation or explicitly classify the source as non-translatable.
de | e1810dbab10aca4d | BP-2P-30-0001 · 2-Passage Through-Bore (Ø30mm) | BP-2P-16-0001.html;products-p2.html | Approve a persistent localized translation or explicitly classify the source as non-translatable.
de | c530aa5bbc25f2ad | BP-2P-30-0001 · 2-Passage Through-Bore Pneumatic Rotary Union (Ø30 mm Bore) | BP-2P-30-0001.html | Approve a persistent localized translation or explicitly classify the source as non-translatable.
de | 77211a4ac6874697 | BP-2P-30-0001 2-in-2-out (Ø30mm) rotary joint with flange mount. Max 1 MPa, 150 RPM, 6061 aluminum alloy body, PTFE composite seal. For packaging turntables and welding stations. | BP-2P-30-0001.html | Approve a persistent localized translation or explicitly classify the source as non-translatable.
de | a48472c8bdc1953a | BP-2P-30-0001 2-in-2-out (Ø30mm) rotary joint with flange mount. Max 1 MPa, 150 RPM, 6061 aluminum alloy body, PTFE composite seal. For packaging turntables and welding stations. Download 2D drawing PDF. | BP-2P-30-0001.html | Approve a persistent localized translation or explicitly classify the source as non-translatable.
de | dd1e7baa4a0f6a4b | BP-2P-30-0001 2-passage pneumatic rotary union | case-studies.html | Approve a persistent localized translation or explicitly classify the source as non-translatable.
de | d84f67709da7c53e | BP-2P-30-0001 2-Passage Through-Bore Pneumatic Rotary Union (Ø30 mm Bore) | Begapunk | BP-2P-30-0001.html | Approve a persistent localized translation or explicitly classify the source as non-translatable.
de | b7ec5eb127ea68a7 | BP-2P-30-0001 2-Passage Through-Bore Rotary Union | Begapunk | BP-2P-30-0001.html | Approve a persistent localized translation or explicitly classify the source as non-translatable.
de | aa7c5904084dedf2 | BP-2P-30-0001 is a two-passage rotary joint with a 30mm central bore, designed for medium-duty pneumatic and fluid transfer on automation rotary equipment. The deep groove ball bearing supports radial loads up to 5 N·m, making it suitable for side-mounted tooling and off-center fixtures. The sealing configuration may be suitable for selected air, water, or coolant applications, subject to medium compatibility, temperature, pressure, speed, and the approved specification for the selected version. Pressure and leakage test conditions should be confirmed before ordering. | BP-2P-30-0001.html | Approve a persistent localized translation or explicitly classify the source as non-translatable.
de | f395d4eb7a749f0a | BP-2P-50-0001 — Protective Shroud + Labyrinth | BP-1P-0003.html | Approve a persistent localized translation or explicitly classify the source as non-translatable.
de | 14e41afe423601b0 | BP-2P-50-0001 · Dust-Resistant 2-Passage Pneumatic Rotary Union | BP-2P-50-0001.html | Approve a persistent localized translation or explicitly classify the source as non-translatable.
de | e465d1f8073ca668 | BP-2P-50-0001 · Protective Shroud + Labyrinth | BP-2P-0001.html;BP-2P-08-0001.html;BP-2P-130-0001.html;BP-2P-16-0001.html;BP-2P-30-0001.html;BP-2P-95-0001.html;BP-3P-0004.html;BP-3P-0006.html;BP-8P-0001.html;products.html | Approve a persistent localized translation or explicitly classify the source as non-translatable.
de | 4190324d6bb05a78 | BP-2P-50-0001 (protective shroud and labyrinth; no certified IP rating claimed) | blog-rotary-joint-selection.html | Approve a persistent localized translation or explicitly classify the source as non-translatable.
de | 39efed7e24e237d5 | BP-2P-50-0001 2-passage air rotary joint with a protective shroud and labyrinth design for dusty environments. No certified IP rating is currently claimed. | BP-2P-50-0001.html | Approve a persistent localized translation or explicitly classify the source as non-translatable.
de | 1a941e8370348f59 | BP-2P-50-0001 2-passage air rotary joint with protective shroud and labyrinth | products.html | Approve a persistent localized translation or explicitly classify the source as non-translatable.
de | f7489fe3d7aeca1c | BP-2P-50-0001 2-Passage Pneumatic Rotary Union | Begapunk | BP-2P-50-0001.html | Approve a persistent localized translation or explicitly classify the source as non-translatable.
de | f59eb0b25ca91dc8 | BP-2P-50-0001 Dust-Resistant 2-Passage Rotary Union | Begapunk | BP-2P-50-0001.html | Approve a persistent localized translation or explicitly classify the source as non-translatable.
de | b86cab0a9ad09d2b | BP-2P-50-0001 is a two-passage air rotary joint with a protective shroud and labyrinth design for dusty industrial environments. No certified IP rating is currently claimed. The mounting interfaces shown below are public reference values; confirm the complete mounting dimensions against the supplied drawing before machining. | BP-2P-50-0001.html | Approve a persistent localized translation or explicitly classify the source as non-translatable.
de | 005212ec6294414e | BP-2P-50-0001 protective-shroud and labyrinth rotary joint | index.html | Approve a persistent localized translation or explicitly classify the source as non-translatable.
de | 4d633103443da1c8 | BP-2P-50-0001 two-passage air rotary union with protective shroud and labyrinth | BP-2P-50-0001.html | Approve a persistent localized translation or explicitly classify the source as non-translatable.
de | c8c85921d55b8abd | BP-2P-95-0001 · 2-Inlet/4-Outlet | products.html | Approve a persistent localized translation or explicitly classify the source as non-translatable.
de | 943fc95ebb22bba8 | BP-2P-95-0001 · 2-Inlet/4-Outlet Pneumatic Rotary Union | BP-2P-95-0001.html | Approve a persistent localized translation or explicitly classify the source as non-translatable.
de | 02907bfc68fdd075 | BP-2P-95-0001 2-Inlet/4-Outlet Pneumatic Rotary Union | Begapunk | BP-2P-95-0001.html | Approve a persistent localized translation or explicitly classify the source as non-translatable.
de | e6ecbd7913a1374f | BP-2P-95-0001 2-inlet/4-outlet pneumatic rotary union 1 MPa large diameter | products.html | Approve a persistent localized translation or explicitly classify the source as non-translatable.
de | b55a55d7f3d5d8a6 | BP-2P-95-0001 2-inlet/4-outlet pneumatic rotary union flange mount heavy duty | BP-2P-95-0001.html | Approve a persistent localized translation or explicitly classify the source as non-translatable.
de | 4a690c2b4d7dd33b | BP-2P-95-0001 2-inlet/4-outlet pneumatic rotary union. Max 1 MPa / 10 bar, 200 RPM, 6061 aluminum alloy body, PTFE seal. For pneumatic clamping and multi-outlet fluid distribution. | BP-2P-95-0001.html | Approve a persistent localized translation or explicitly classify the source as non-translatable.
de | 7e5d5b072d7cd6ba | BP-2P-95-0001 2-inlet/4-outlet pneumatic rotary union. Max 1 MPa / 10 bar, 200 RPM, 6061 aluminum alloy body, PTFE seal. For pneumatic clamping and multi-outlet fluid distribution. Download 2D drawing PDF. | BP-2P-95-0001.html | Approve a persistent localized translation or explicitly classify the source as non-translatable.
de | 0fceb00ba075a318 | BP-2P-95-0001 is a 2-inlet/4-outlet pneumatic rotary union designed for pneumatic and light-fluid distribution. The formal drawing specifies a maximum pressure of 1 MPa, a maximum speed of 200 RPM, and an 6061 aluminum alloy body. The PTFE composite seal supports compatible air, water, coolant, and light-oil applications within those limits. | BP-2P-95-0001.html | Approve a persistent localized translation or explicitly classify the source as non-translatable.
de | 804455bd5069e343 | BP-3P-0004 — 3-Passage (Flange) | BP-1P-0003.html | Approve a persistent localized translation or explicitly classify the source as non-translatable.
de | d87c965c52ad810d | BP-3P-0004 · 3-Passage | BP-4P-30-0001.html;BP-8P-0001.html;products.html | Approve a persistent localized translation or explicitly classify the source as non-translatable.
de | 442507aa15c80a03 | BP-3P-0004 · 3-Passage (Flange) | BP-2P-0001.html;BP-2P-08-0001.html;BP-2P-130-0001.html;BP-2P-16-0001.html;BP-2P-50-0001.html;BP-2P-95-0001.html;BP-3P-0006.html;BP-3P-0007.html;BP-3P-S06-0001.html | Approve a persistent localized translation or explicitly classify the source as non-translatable.
de | 49fae11547b931e7 | BP-3P-0004 · 3-Passage Pneumatic Rotary Union | BP-3P-0004.html | Approve a persistent localized translation or explicitly classify the source as non-translatable.
de | 05002d0b21614b6f | BP-3P-0004 3-Passage Pneumatic Rotary Union | Begapunk | BP-3P-0004.html | Approve a persistent localized translation or explicitly classify the source as non-translatable.
de | 8d9d1afe322f1dc1 | BP-3P-0004 3-passage pneumatic rotary union flange mount AL6061 | BP-3P-0004.html | Approve a persistent localized translation or explicitly classify the source as non-translatable.
de | 33328e84a9ccda16 | BP-3P-0004 3-passage pneumatic rotary union flange mount blue anodized | products.html | Approve a persistent localized translation or explicitly classify the source as non-translatable.
de | 5665b1e987f22cc1 | BP-3P-0004 3-passage pneumatic rotary union with flange mount. 1 MPa, 200 RPM, 6061 aluminum alloy body, PTFE composite seal. | BP-3P-0004.html | Approve a persistent localized translation or explicitly classify the source as non-translatable.
de | 5852f1d9341d1e67 | BP-3P-0004 3-passage pneumatic rotary union with flange mount. 1 MPa, 200 RPM, 6061 aluminum alloy body, PTFE composite seal. For multi-function rotary tables and packaging machinery. | BP-3P-0004.html | Approve a persistent localized translation or explicitly classify the source as non-translatable.
de | 956202d033d76bd6 | BP-3P-0004 is a three-passage flange mount rotary joint designed for multi-function pneumatic and light fluid applications. The PTFE composite seal provides low friction torque and chemical resistance across air, water, oil, and coolant media. The 6061 aluminum alloy body at 0.49 kg keeps rotating mass low for compact rotary tables and packaging machinery. | BP-3P-0004.html | Approve a persistent localized translation or explicitly classify the source as non-translatable.
de | cb774b554629c77e | BP-3P-0006 · 3-Passage (G1/4) | BP-3P-0004.html;BP-3P-0007.html;BP-3P-S06-0001.html;products-p2.html | Approve a persistent localized translation or explicitly classify the source as non-translatable.
de | 7e2731e011425e89 | BP-3P-0006 · 3-Passage Pneumatic Rotary Union (G1/4) | BP-3P-0006.html | Approve a persistent localized translation or explicitly classify the source as non-translatable.
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
