caoguangcheng9-lgtm/begapunk-website/audit/geo-audit/claims-needing-evidence.csv

page | exact_claim | claim_type | risk_level | why_evidence_is_needed | suggested_evidence | action | manual_verification
about.html | Made in Ningbo, delivered worldwide. | business_metric | medium | 带数字的商业或技术陈述需要可追溯依据 | 内部记录、规格书或带日期的统计说明 | 保留前先建立证据索引；无法证明时弱化并说明口径 | 需要人工验证
about.html | Our factory covers 3,200 square meters with 28 CNC machines, 6 seal testing stations, and a dedicated R&D lab. | business_metric | medium | 带数字的商业或技术陈述需要可追溯依据 | 内部记录、规格书或带日期的统计说明 | 保留前先建立证据索引；无法证明时弱化并说明口径 | 需要人工验证
about.html | 1.5× rated pressure, 30 minutes, zero leakage pass. | business_metric | medium | 带数字的商业或技术陈述需要可追溯依据 | 内部记录、规格书或带日期的统计说明 | 保留前先建立证据索引；无法证明时弱化并说明口径 | 需要人工验证
about.html | Delivered first multi-channel (6-passage) rotary joint for wind turbine application. | business_metric | medium | 带数字的商业或技术陈述需要可追溯依据 | 内部记录、规格书或带日期的统计说明 | 保留前先建立证据索引；无法证明时弱化并说明口径 | 需要人工验证
about.html | 200,000 Units Milestone | business_metric | high | 企业规模、认证或绝对性能陈述会直接影响采购信任 | 证书、出货记录、客户/国家统计口径、测试报告 | 保留前先建立证据索引；无法证明时弱化并说明口径 | 需要人工验证
about.html | Cumulative production exceeded 200,000 units. | certification | high | 企业规模、认证或绝对性能陈述会直接影响采购信任 | 证书、出货记录、客户/国家统计口径、测试报告 | 保留前先建立证据索引；无法证明时弱化并说明口径 | 需要人工验证
about.html | Production Manager ISO 9001 Lead Auditor | certification | high | 企业规模、认证或绝对性能陈述会直接影响采购信任 | 证书、出货记录、客户/国家统计口径、测试报告 | 保留前先建立证据索引；无法证明时弱化并说明口径 | 需要人工验证
about.html | Tell us your requirements and we'll provide a quote within 24 hours. | business_metric | medium | 带数字的商业或技术陈述需要可追溯依据 | 内部记录、规格书或带日期的统计说明 | 保留前先建立证据索引；无法证明时弱化并说明口径 | 需要人工验证
application-automation-rotary-tables.html | The challenge is not just transferring air — it is keeping 4–8 independent channels from cross-contaminating while sharing a 30–50 mm diameter body. | technical_parameter | medium | 带数字的商业或技术陈述需要可追溯依据 | 内部记录、规格书或带日期的统计说明 | 保留前先建立证据索引；无法证明时弱化并说明口径 | 需要人工验证
application-automation-rotary-tables.html | Machine builders specify exactly the channels needed today, with no room for the sensor or gripper the customer adds 12 months later. | business_metric | medium | 带数字的商业或技术陈述需要可追溯依据 | 内部记录、规格书或带日期的统计说明 | 保留前先建立证据索引；无法证明时弱化并说明口径 | 需要人工验证
application-automation-rotary-tables.html | Indexing tables (60–120 RPM, stop-start) can use FKM seals; continuous rotation stations need PTFE | technical_parameter | medium | 工程参数需要型号、测试条件和最大/连续值定义 | 规格书、图纸、试验条件和批准人 | 保留前先建立证据索引；无法证明时弱化并说明口径 | 需要人工验证
application-automation-rotary-tables.html | Pressure: 0.3–0.8 MPa (clamping / actuation) / -0.04 to -0.08 MPa (vacuum) — derate 30% for continuous duty | technical_parameter | medium | 工程参数需要型号、测试条件和最大/连续值定义 | 规格书、图纸、试验条件和批准人 | 保留前先建立证据索引；无法证明时弱化并说明口径 | 需要人工验证
application-automation-rotary-tables.html | Bore: 6–16 mm depending on flow demand and station count | technical_parameter | medium | 带数字的商业或技术陈述需要可追溯依据 | 内部记录、规格书或带日期的统计说明 | 保留前先建立证据索引；无法证明时弱化并说明口径 | 需要人工验证
application-automation-rotary-tables.html | Clamping: 1 channel (clamp air, 0.3–0.6 MPa) | technical_parameter | medium | 工程参数需要型号、测试条件和最大/连续值定义 | 规格书、图纸、试验条件和批准人 | 保留前先建立证据索引；无法证明时弱化并说明口径 | 需要人工验证
application-automation-rotary-tables.html | Unclamping: 1 channel (release air, 0.2–0.4 MPa) | technical_parameter | medium | 工程参数需要型号、测试条件和最大/连续值定义 | 规格书、图纸、试验条件和批准人 | 保留前先建立证据索引；无法证明时弱化并说明口径 | 需要人工验证
application-automation-rotary-tables.html | Vacuum pickup: 1 channel (-0.04 to -0.08 MPa, dedicated vacuum seal) | technical_parameter | medium | 工程参数需要型号、测试条件和最大/连续值定义 | 规格书、图纸、试验条件和批准人 | 保留前先建立证据索引；无法证明时弱化并说明口径 | 需要人工验证
application-automation-rotary-tables.html | Blow-off: 1 channel (0.2–0.3 MPa, often pulsed) | technical_parameter | medium | 工程参数需要型号、测试条件和最大/连续值定义 | 规格书、图纸、试验条件和批准人 | 保留前先建立证据索引；无法证明时弱化并说明口径 | 需要人工验证
application-automation-rotary-tables.html | Sensor air: 1 channel (0.1–0.2 MPa for position verification) | technical_parameter | medium | 工程参数需要型号、测试条件和最大/连续值定义 | 规格书、图纸、试验条件和批准人 | 保留前先建立证据索引；无法证明时弱化并说明口径 | 需要人工验证
application-automation-rotary-tables.html | Adding a spare passage now is cheaper than replacing the entire joint in 18 months when the customer adds a new gripper or sensor. | business_metric | medium | 带数字的商业或技术陈述需要可追溯依据 | 内部记录、规格书或带日期的统计说明 | 保留前先建立证据索引；无法证明时弱化并说明口径 | 需要人工验证
application-automation-rotary-tables.html | Indexing tables (stop-start, 60–120 RPM): FKM seals are acceptable. | certification | high | 企业规模、认证或绝对性能陈述会直接影响采购信任 | 证书、出货记录、客户/国家统计口径、测试报告 | 保留前先建立证据索引；无法证明时弱化并说明口径 | 需要人工验证
application-automation-rotary-tables.html | Typical seal life: 6–10 months continuous duty. | business_metric | medium | 带数字的商业或技术陈述需要可追溯依据 | 内部记录、规格书或带日期的统计说明 | 保留前先建立证据索引；无法证明时弱化并说明口径 | 需要人工验证
application-automation-rotary-tables.html | Continuous rotation (100–500 RPM): PTFE composite seals are mandatory. | technical_parameter | medium | 工程参数需要型号、测试条件和最大/连续值定义 | 规格书、图纸、试验条件和批准人 | 保留前先建立证据索引；无法证明时弱化并说明口径 | 需要人工验证
application-automation-rotary-tables.html | FKM overheats and hardens within 2–3 weeks under continuous friction. | business_metric | medium | 带数字的商业或技术陈述需要可追溯依据 | 内部记录、规格书或带日期的统计说明 | 保留前先建立证据索引；无法证明时弱化并说明口径 | 需要人工验证
application-automation-rotary-tables.html | Best when space is limited and channel count is moderate. | certification | high | 企业规模、认证或绝对性能陈述会直接影响采购信任 | 证书、出货记录、客户/国家统计口径、测试报告 | 保留前先建立证据索引；无法证明时弱化并说明口径 | 需要人工验证
application-automation-rotary-tables.html | Best when high channel counts (8+ air + 12+ electrical) are needed. | business_metric | medium | 带数字的商业或技术陈述需要可追溯依据 | 内部记录、规格书或带日期的统计说明 | 保留前先建立证据索引；无法证明时弱化并说明口径 | 需要人工验证
application-automation-rotary-tables.html | A 30 mm bore rotary joint plus a 25 mm slip ring needs 60+ mm total radial space. | certification | high | 企业规模、认证或绝对性能陈述会直接影响采购信任 | 证书、出货记录、客户/国家统计口径、测试报告 | 保留前先建立证据索引；无法证明时弱化并说明口径 | 需要人工验证
application-automation-rotary-tables.html | Small indexing table (4–6 stations) Clamp, release, blow-off 2–3 passages, compact body, easy mounting, FKM seals acceptable BP-2P-0001 or BP-3P-0004 | certification | high | 企业规模、认证或绝对性能陈述会直接影响采购信任 | 证书、出货记录、客户/国家统计口径、测试报告 | 保留前先建立证据索引；无法证明时弱化并说明口径 | 需要人工验证
application-automation-rotary-tables.html | Multi-station carousel (8–16 stations) Several independent air lines 4–8 passages, low leakage, flange mount, anti-rotation support BP-4P-30-0001 or BP-8P-0001 | business_metric | medium | 带数字的商业或技术陈述需要可追溯依据 | 内部记录、规格书或带日期的统计说明 | 保留前先建立证据索引；无法证明时弱化并说明口径 | 需要人工验证
application-automation-rotary-tables.html | High-speed continuous rotary Continuous clamping and actuation PTFE seals, 100–500 RPM rated, low friction torque BP-2P-95-0001 (PTFE standard) or custom high-speed layout | technical_parameter | medium | 工程参数需要型号、测试条件和最大/连续值定义 | 规格书、图纸、试验条件和批准人 | 保留前先建立证据索引；无法证明时弱化并说明口径 | 需要人工验证
application-automation-rotary-tables.html | When the customer adds a sensor or a new gripper 12 months later, the entire rotary joint must be replaced — disassembling the table, re-routing hoses, and re-commissioning the machine. | certification | high | 企业规模、认证或绝对性能陈述会直接影响采购信任 | 证书、出货记录、客户/国家统计口径、测试报告 | 保留前先建立证据索引；无法证明时弱化并说明口径 | 需要人工验证
application-automation-rotary-tables.html | FKM (fluoroelastomer) seals are rated for < 200 RPM and work well on indexing tables with dwell periods. | technical_parameter | medium | 工程参数需要型号、测试条件和最大/连续值定义 | 规格书、图纸、试验条件和批准人 | 保留前先建立证据索引；无法证明时弱化并说明口径 | 需要人工验证
application-automation-rotary-tables.html | But on continuous-rotation stations at 300–500 RPM, FKM overheats and hardens within 2–3 weeks. | technical_parameter | medium | 工程参数需要型号、测试条件和最大/连续值定义 | 规格书、图纸、试验条件和批准人 | 保留前先建立证据索引；无法证明时弱化并说明口径 | 需要人工验证
application-automation-rotary-tables.html | Rule: Specify PTFE composite seals for any station above 200 RPM or with continuous rotation. | technical_parameter | medium | 工程参数需要型号、测试条件和最大/连续值定义 | 规格书、图纸、试验条件和批准人 | 保留前先建立证据索引；无法证明时弱化并说明口径 | 需要人工验证
application-automation-rotary-tables.html | Engineers specify a 40 mm bore rotary joint and a 35 mm slip ring, then discover they need 80 mm radial clearance — but the table hub only has 60 mm. | certification | high | 企业规模、认证或绝对性能陈述会直接影响采购信任 | 证书、出货记录、客户/国家统计口径、测试报告 | 保留前先建立证据索引；无法证明时弱化并说明口径 | 需要人工验证
application-automation-rotary-tables.html | The result: a last-minute custom design that delays delivery by 4–6 weeks. | business_metric | medium | 带数字的商业或技术陈述需要可追溯依据 | 内部记录、规格书或带日期的统计说明 | 保留前先建立证据索引；无法证明时弱化并说明口径 | 需要人工验证
application-automation-rotary-tables.html | Through-bore options (e.g., 30 mm bore on BP-4P-30-0001 ) allow wiring, shafts, or coolant lines to pass through the center — keeping the machine envelope clean and organized. | certification | high | 企业规模、认证或绝对性能陈述会直接影响采购信任 | 证书、出货记录、客户/国家统计口径、测试报告 | 保留前先建立证据索引；无法证明时弱化并说明口径 | 需要人工验证
application-automation-rotary-tables.html | But it must allow ±2 mm radial float for self-alignment. | technical_parameter | medium | 带数字的商业或技术陈述需要可追溯依据 | 内部记录、规格书或带日期的统计说明 | 保留前先建立证据索引；无法证明时弱化并说明口径 | 需要人工验证
application-automation-rotary-tables.html | Indexing tables (FKM seals): Replace every 8–10 months on continuous-duty lines | certification | high | 企业规模、认证或绝对性能陈述会直接影响采购信任 | 证书、出货记录、客户/国家统计口径、测试报告 | 保留前先建立证据索引；无法证明时弱化并说明口径 | 需要人工验证
application-automation-rotary-tables.html | Continuous rotation (PTFE seals): Replace every 10–12 months | certification | high | 企业规模、认证或绝对性能陈述会直接影响采购信任 | 证书、出货记录、客户/国家统计口径、测试报告 | 保留前先建立证据索引；无法证明时弱化并说明口径 | 需要人工验证
application-automation-rotary-tables.html | High-cycle lines (>200 RPM, 24/7): Replace every 6–8 months | certification | high | 企业规模、认证或绝对性能陈述会直接影响采购信任 | 证书、出货记录、客户/国家统计口径、测试报告 | 保留前先建立证据索引；无法证明时弱化并说明口径 | 需要人工验证
application-automation-rotary-tables.html | Adding a spare passage now is cheaper than replacing the entire joint in 18 months. | business_metric | medium | 带数字的商业或技术陈述需要可追溯依据 | 内部记录、规格书或带日期的统计说明 | 保留前先建立证据索引；无法证明时弱化并说明口径 | 需要人工验证
application-automation-rotary-tables.html | When the customer adds a sensor or a new gripper 12 months later, the entire rotary joint must be replaced. | certification | high | 企业规模、认证或绝对性能陈述会直接影响采购信任 | 证书、出货记录、客户/国家统计口径、测试报告 | 保留前先建立证据索引；无法证明时弱化并说明口径 | 需要人工验证
application-automation-rotary-tables.html | Another common error is using FKM seals on continuous-rotation stations above 200 RPM, causing overheating and seal hardening within weeks. | technical_parameter | medium | 工程参数需要型号、测试条件和最大/连续值定义 | 规格书、图纸、试验条件和批准人 | 保留前先建立证据索引；无法证明时弱化并说明口径 | 需要人工验证
application-bottle-filling-capping.html | And it must be replaceable in under 10 minutes because a filling line stoppage costs $5,000–$15,000 per hour. | certification | high | 企业规模、认证或绝对性能陈述会直接影响采购信任 | 证书、出货记录、客户/国家统计口径、测试报告 | 保留前先建立证据索引；无法证明时弱化并说明口径 | 需要人工验证
application-bottle-filling-capping.html | The most frequent challenge is not pressure or RPM — it is finding a compact layout that fits inside a 60–80 mm diameter carousel hub while handling 2–4 independent air functions. | technical_parameter | medium | 带数字的商业或技术陈述需要可追溯依据 | 内部记录、规格书或带日期的统计说明 | 保留前先建立证据索引；无法证明时弱化并说明口径 | 需要人工验证
application-bottle-filling-capping.html | Washdown chemicals corrode AL6061 and degrade FKM seals in 3–6 months — specify 316SS + FDA PTFE for food lines | business_metric | medium | 带数字的商业或技术陈述需要可追溯依据 | 内部记录、规格书或带日期的统计说明 | 保留前先建立证据索引；无法证明时弱化并说明口径 | 需要人工验证
application-bottle-filling-capping.html | Capping torque actuators need 6–10 mm bore; 3 mm bore cannot deliver consistent airflow for torque control | technical_parameter | medium | 带数字的商业或技术陈述需要可追溯依据 | 内部记录、规格书或带日期的统计说明 | 保留前先建立证据索引；无法证明时弱化并说明口径 | 需要人工验证
application-bottle-filling-capping.html | A filling line stoppage costs $5,000–$15,000/hour — design for < 10 minute joint replacement | certification | high | 企业规模、认证或绝对性能陈述会直接影响采购信任 | 证书、出货记录、客户/国家统计口径、测试报告 | 保留前先建立证据索引；无法证明时弱化并说明口径 | 需要人工验证
application-bottle-filling-capping.html | Steam sterilization (>120°C) destroys standard seals; specify high-temp PTFE or specialized composites | technical_parameter | medium | 工程参数需要型号、测试条件和最大/连续值定义 | 规格书、图纸、试验条件和批准人 | 保留前先建立证据索引；无法证明时弱化并说明口径 | 需要人工验证
application-bottle-filling-capping.html | Plan seal replacement every 6 months for food-grade lines regardless of visible wear (audit requirement) | certification | high | 企业规模、认证或绝对性能陈述会直接影响采购信任 | 证书、出货记录、客户/国家统计口径、测试报告 | 保留前先建立证据索引；无法证明时弱化并说明口径 | 需要人工验证
application-bottle-filling-capping.html | Pressure: 0.4–0.6 MPa (capping torque) / 0.2–0.4 MPa (gripper) / -0.04 to -0.08 MPa (vacuum hold-down) | technical_parameter | medium | 工程参数需要型号、测试条件和最大/连续值定义 | 规格书、图纸、试验条件和批准人 | 保留前先建立证据索引；无法证明时弱化并说明口径 | 需要人工验证
application-bottle-filling-capping.html | Bore: 6–10 mm for capping torque actuators; 4–6 mm for gripper circuits | technical_parameter | medium | 带数字的商业或技术陈述需要可追溯依据 | 内部记录、规格书或带日期的统计说明 | 保留前先建立证据索引；无法证明时弱化并说明口径 | 需要人工验证
application-bottle-filling-capping.html | Capping torque actuator: 0.4–0.6 MPa, needs stable pressure for repeatable torque | technical_parameter | medium | 工程参数需要型号、测试条件和最大/连续值定义 | 规格书、图纸、试验条件和批准人 | 保留前先建立证据索引；无法证明时弱化并说明口径 | 需要人工验证
application-bottle-filling-capping.html | Bottle gripper (clamp/unclamp): 0.2–0.4 MPa, 2 channels minimum | technical_parameter | medium | 工程参数需要型号、测试条件和最大/连续值定义 | 规格书、图纸、试验条件和批准人 | 保留前先建立证据索引；无法证明时弱化并说明口径 | 需要人工验证
application-bottle-filling-capping.html | Vacuum hold-down: -0.04 to -0.08 MPa, dedicated vacuum-rated seal | technical_parameter | medium | 工程参数需要型号、测试条件和最大/连续值定义 | 规格书、图纸、试验条件和批准人 | 保留前先建立证据索引；无法证明时弱化并说明口径 | 需要人工验证
application-bottle-filling-capping.html | Blow-off cleaning: 0.2–0.3 MPa, pulsed air — specify pulse-rated seal | technical_parameter | medium | 工程参数需要型号、测试条件和最大/连续值定义 | 规格书、图纸、试验条件和批准人 | 保留前先建立证据索引；无法证明时弱化并说明口径 | 需要人工验证
application-bottle-filling-capping.html | Steam sterilization (pharmaceutical): 316SS + high-temp PTFE or specialized composite seals rated for >120°C | certification | high | 企业规模、认证或绝对性能陈述会直接影响采购信任 | 证书、出货记录、客户/国家统计口径、测试报告 | 保留前先建立证据索引；无法证明时弱化并说明口径 | 需要人工验证
application-bottle-filling-capping.html | Design the rotary joint mounting for replacement in under 10 minutes: | certification | high | 企业规模、认证或绝对性能陈述会直接影响采购信任 | 证书、出货记录、客户/国家统计口径、测试报告 | 保留前先建立证据索引；无法证明时弱化并说明口径 | 需要人工验证
application-bottle-filling-capping.html | Capping head Torque support and pneumatic actuation Compact body, stable pressure, 6–10 mm bore BP-1P-0003 or BP-2P-0001 compact | technical_parameter | medium | 带数字的商业或技术陈述需要可追溯依据 | 内部记录、规格书或带日期的统计说明 | 保留前先建立证据索引；无法证明时弱化并说明口径 | 需要人工验证
application-bottle-filling-capping.html | Chlorine-based cleaning agents corrode aluminum within 3–6 months. | business_metric | medium | 带数字的商业或技术陈述需要可追溯依据 | 内部记录、规格书或带日期的统计说明 | 保留前先建立证据索引；无法证明时弱化并说明口径 | 需要人工验证
application-bottle-filling-capping.html | A 3 mm bore restricts airflow to ~15 L/min at 0.5 MPa. | technical_parameter | medium | 工程参数需要型号、测试条件和最大/连续值定义 | 规格书、图纸、试验条件和批准人 | 保留前先建立证据索引；无法证明时弱化并说明口径 | 需要人工验证
application-bottle-filling-capping.html | Rule: Specify 6–10 mm bore for capping torque circuits. | technical_parameter | medium | 带数字的商业或技术陈述需要可追溯依据 | 内部记录、规格书或带日期的统计说明 | 保留前先建立证据索引；无法证明时弱化并说明口径 | 需要人工验证
application-bottle-filling-capping.html | A 3 mm bore is only acceptable for small gripper circuits with low air demand. | certification | high | 企业规模、认证或绝对性能陈述会直接影响采购信任 | 证书、出货记录、客户/国家统计口径、测试报告 | 保留前先建立证据索引；无法证明时弱化并说明口径 | 需要人工验证
application-bottle-filling-capping.html | Standard PTFE seals are rated for -20°C to +120°C. | technical_parameter | medium | 工程参数需要型号、测试条件和最大/连续值定义 | 规格书、图纸、试验条件和批准人 | 保留前先建立证据索引；无法证明时弱化并说明口径 | 需要人工验证
application-bottle-filling-capping.html | Steam sterilization cycles at 121°C for 15–30 minutes exceed this limit. | certification | high | 企业规模、认证或绝对性能陈述会直接影响采购信任 | 证书、出货记录、客户/国家统计口径、测试报告 | 保留前先建立证据索引；无法证明时弱化并说明口径 | 需要人工验证
application-bottle-filling-capping.html | Rule: For steam sterilization applications, specify high-temperature PTFE composites or specialized seals rated for >150°C. | technical_parameter | medium | 工程参数需要型号、测试条件和最大/连续值定义 | 规格书、图纸、试验条件和批准人 | 保留前先建立证据索引；无法证明时弱化并说明口径 | 需要人工验证
application-bottle-filling-capping.html | Design the rotary joint for replacement in under 10 minutes: | certification | high | 企业规模、认证或绝对性能陈述会直接影响采购信任 | 证书、出货记录、客户/国家统计口径、测试报告 | 保留前先建立证据索引；无法证明时弱化并说明口径 | 需要人工验证
application-bottle-filling-capping.html | Food-grade FKM seals: Replace every 6 months (audit requirement) | certification | high | 企业规模、认证或绝对性能陈述会直接影响采购信任 | 证书、出货记录、客户/国家统计口径、测试报告 | 保留前先建立证据索引；无法证明时弱化并说明口径 | 需要人工验证
application-bottle-filling-capping.html | Food-grade PTFE seals: Replace every 10–12 months on continuous-duty lines | certification | high | 企业规模、认证或绝对性能陈述会直接影响采购信任 | 证书、出货记录、客户/国家统计口径、测试报告 | 保留前先建立证据索引；无法证明时弱化并说明口径 | 需要人工验证
application-bottle-filling-capping.html | Steam sterilization lines: Replace every 6 months regardless of visible wear (thermal fatigue) | certification | high | 企业规模、认证或绝对性能陈述会直接影响采购信任 | 证书、出货记录、客户/国家统计口径、测试报告 | 保留前先建立证据索引；无法证明时弱化并说明口径 | 需要人工验证
application-bottle-filling-capping.html | Stable pressure (0.2–0.6 MPa), clean air path, compact size for tight carousel envelopes, corrosion-resistant material (304/316 stainless steel or anodized AL6061), and easy maintenance access for fast seal replacement during line stoppages. | certification | high | 企业规模、认证或绝对性能陈述会直接影响采购信任 | 证书、出货记录、客户/国家统计口径、测试报告 | 保留前先建立证据索引；无法证明时弱化并说明口径 | 需要人工验证
application-bottle-filling-capping.html | Washdown chemicals (chlorine, caustic soda) corrode aluminum and degrade FKM within 3–6 months. | business_metric | medium | 带数字的商业或技术陈述需要可追溯依据 | 内部记录、规格书或带日期的统计说明 | 保留前先建立证据索引；无法证明时弱化并说明口径 | 需要人工验证
application-bottle-filling-capping.html | Another common error is undersizing the bore for capping torque actuators — a 3 mm bore cannot deliver enough airflow for consistent torque control. | technical_parameter | medium | 带数字的商业或技术陈述需要可追溯依据 | 内部记录、规格书或带日期的统计说明 | 保留前先建立证据索引；无法证明时弱化并说明口径 | 需要人工验证
application-cnc-pneumatic-clamping.html | Pressure: 0.4–0.8 MPa (clamping) — derate 30% for continuous machining duty | technical_parameter | medium | 工程参数需要型号、测试条件和最大/连续值定义 | 规格书、图纸、试验条件和批准人 | 保留前先建立证据索引；无法证明时弱化并说明口径 | 需要人工验证
application-cnc-pneumatic-clamping.html | Bore: 6–10 mm for standard clamps; 16–30 mm for large fixture plates | technical_parameter | medium | 带数字的商业或技术陈述需要可追溯依据 | 内部记录、规格书或带日期的统计说明 | 保留前先建立证据索引；无法证明时弱化并说明口径 | 需要人工验证
application-electronics-battery-test-fixtures.html | Pressure: 0.2–0.5 MPa (vacuum/gripper) — low-pressure precision control | technical_parameter | medium | 工程参数需要型号、测试条件和最大/连续值定义 | 规格书、图纸、试验条件和批准人 | 保留前先建立证据索引；无法证明时弱化并说明口径 | 需要人工验证
application-electronics-battery-test-fixtures.html | Bore: 3–6 mm for small grippers; 6–10 mm for larger actuators | technical_parameter | medium | 带数字的商业或技术陈述需要可追溯依据 | 内部记录、规格书或带日期的统计说明 | 保留前先建立证据索引；无法证明时弱化并说明口径 | 需要人工验证
application-laser-tube-cutting.html | Getting the specification right before production saves 3–6 weeks of rework. | business_metric | medium | 带数字的商业或技术陈述需要可追溯依据 | 内部记录、规格书或带日期的统计说明 | 保留前先建立证据索引；无法证明时弱化并说明口径 | 需要人工验证
application-laser-tube-cutting.html | Assist gas requires 6–10 mm minimum bore; 3 mm is only acceptable for small clamp circuits | certification | high | 企业规模、认证或绝对性能陈述会直接影响采购信任 | 证书、出货记录、客户/国家统计口径、测试报告 | 保留前先建立证据索引；无法证明时弱化并说明口径 | 需要人工验证
application-laser-tube-cutting.html | Derate pressure 30% for continuous duty: a 1.0 MPa joint should run at 0.7 MPa max (ISO 4414) | certification | medium | 工程参数需要型号、测试条件和最大/连续值定义 | 规格书、图纸、试验条件和批准人 | 保留前先建立证据索引；无法证明时弱化并说明口径 | 需要人工验证
application-laser-tube-cutting.html | FKM seals overheat above 200 RPM; specify PTFE for continuous rotating cutting heads | technical_parameter | medium | 工程参数需要型号、测试条件和最大/连续值定义 | 规格书、图纸、试验条件和批准人 | 保留前先建立证据索引；无法证明时弱化并说明口径 | 需要人工验证
application-laser-tube-cutting.html | Pressure: 0.4–0.8 MPa (assist gas) / 0.2–0.5 MPa (clamping) — derate 30% for continuous duty | technical_parameter | medium | 工程参数需要型号、测试条件和最大/连续值定义 | 规格书、图纸、试验条件和批准人 | 保留前先建立证据索引；无法证明时弱化并说明口径 | 需要人工验证
application-laser-tube-cutting.html | Bore: 6–10 mm typical for laser assist gas; 3 mm acceptable for small clamp circuits only | certification | high | 企业规模、认证或绝对性能陈述会直接影响采购信任 | 证书、出货记录、客户/国家统计口径、测试报告 | 保留前先建立证据索引；无法证明时弱化并说明口径 | 需要人工验证
application-laser-tube-cutting.html | Reference: ISO 4414:2010 recommends that maximum working pressure in pneumatic systems should not exceed 80% of the component rated pressure for continuous duty. | certification | high | 企业规模、认证或绝对性能陈述会直接影响采购信任 | 证书、出货记录、客户/国家统计口径、测试报告 | 保留前先建立证据索引；无法证明时弱化并说明口径 | 需要人工验证
application-laser-tube-cutting.html | Cutting head rotation Assist gas and blow-off Clean flow path, low leakage, 6–10 mm bore Custom multi-passage air rotary union | technical_parameter | medium | 带数字的商业或技术陈述需要可追溯依据 | 内部记录、规格书或带日期的统计说明 | 保留前先建立证据索引；无法证明时弱化并说明口径 | 需要人工验证
application-laser-tube-cutting.html | Coolant support Cutting fluid or mist Water-compatible seals, stainless steel body BP-2P-130-0001 (SS body, 5 MPa rated) | technical_parameter | medium | 工程参数需要型号、测试条件和最大/连续值定义 | 规格书、图纸、试验条件和批准人 | 保留前先建立证据索引；无法证明时弱化并说明口径 | 需要人工验证
application-laser-tube-cutting.html | A 3 mm bore restricts nitrogen flow to ~15 L/min at 0.6 MPa. | technical_parameter | medium | 工程参数需要型号、测试条件和最大/连续值定义 | 规格书、图纸、试验条件和批准人 | 保留前先建立证据索引；无法证明时弱化并说明口径 | 需要人工验证
application-laser-tube-cutting.html | Rule: Specify 6–10 mm bore for assist gas; 3 mm is only for small clamp circuits. | technical_parameter | medium | 带数字的商业或技术陈述需要可追溯依据 | 内部记录、规格书或带日期的统计说明 | 保留前先建立证据索引；无法证明时弱化并说明口径 | 需要人工验证
application-laser-tube-cutting.html | FKM (fluoroelastomer) seals are rated for < 200 RPM. | technical_parameter | medium | 工程参数需要型号、测试条件和最大/连续值定义 | 规格书、图纸、试验条件和批准人 | 保留前先建立证据索引；无法证明时弱化并说明口径 | 需要人工验证
application-laser-tube-cutting.html | A continuous rotating cutting head at 300–500 RPM generates enough heat to harden FKM within 2–3 weeks. | technical_parameter | medium | 工程参数需要型号、测试条件和最大/连续值定义 | 规格书、图纸、试验条件和批准人 | 保留前先建立证据索引；无法证明时弱化并说明口径 | 需要人工验证
application-laser-tube-cutting.html | Rule: Specify PTFE composite seals for any joint above 200 RPM. | technical_parameter | medium | 工程参数需要型号、测试条件和最大/连续值定义 | 规格书、图纸、试验条件和批准人 | 保留前先建立证据索引；无法证明时弱化并说明口径 | 需要人工验证
application-laser-tube-cutting.html | The anti-rotation tab must allow ±2 mm radial float for self-alignment. | technical_parameter | medium | 带数字的商业或技术陈述需要可追溯依据 | 内部记录、规格书或带日期的统计说明 | 保留前先建立证据索引；无法证明时弱化并说明口径 | 需要人工验证
application-laser-tube-cutting.html | Contaminants larger than the 0.02–0.05 mm seal gap embed in the PTFE and score the shaft. | technical_parameter | medium | 带数字的商业或技术陈述需要可追溯依据 | 内部记录、规格书或带日期的统计说明 | 保留前先建立证据索引；无法证明时弱化并说明口径 | 需要人工验证
application-laser-tube-cutting.html | Always run the joint at 0.2 MPa and 50 RPM for 5 minutes before applying full assist gas pressure. | technical_parameter | medium | 工程参数需要型号、测试条件和最大/连续值定义 | 规格书、图纸、试验条件和批准人 | 保留前先建立证据索引；无法证明时弱化并说明口径 | 需要人工验证
application-laser-tube-cutting.html | Assist gas lines typically run at 0.4–0.8 MPa (4–8 bar). | technical_parameter | medium | 工程参数需要型号、测试条件和最大/连续值定义 | 规格书、图纸、试验条件和批准人 | 保留前先建立证据索引；无法证明时弱化并说明口径 | 需要人工验证
application-laser-tube-cutting.html | Pneumatic clamping runs at 0.2–0.5 MPa. | technical_parameter | medium | 工程参数需要型号、测试条件和最大/连续值定义 | 规格书、图纸、试验条件和批准人 | 保留前先建立证据索引；无法证明时弱化并说明口径 | 需要人工验证
application-laser-tube-cutting.html | For continuous duty, derate the rated pressure by 30% per ISO 4414 guidelines. | certification | medium | 带数字的商业或技术陈述需要可追溯依据 | 内部记录、规格书或带日期的统计说明 | 保留前先建立证据索引；无法证明时弱化并说明口径 | 需要人工验证
application-laser-tube-cutting.html | RPM ranges from 60–300 for indexing chucks to 100–500 RPM for continuous rotating cutting heads. | technical_parameter | medium | 工程参数需要型号、测试条件和最大/连续值定义 | 规格书、图纸、试验条件和批准人 | 保留前先建立证据索引；无法证明时弱化并说明口径 | 需要人工验证
application-laser-tube-cutting.html | A 3 mm bore restricts nitrogen flow to ~15 L/min at 0.6 MPa — insufficient for most fiber laser cutting. | technical_parameter | medium | 工程参数需要型号、测试条件和最大/连续值定义 | 规格书、图纸、试验条件和批准人 | 保留前先建立证据索引；无法证明时弱化并说明口径 | 需要人工验证
application-laser-tube-cutting.html | Laser assist gas requires 6–10 mm minimum bore. | technical_parameter | medium | 带数字的商业或技术陈述需要可追溯依据 | 内部记录、规格书或带日期的统计说明 | 保留前先建立证据索引；无法证明时弱化并说明口径 | 需要人工验证
application-laser-tube-cutting.html | Another common error is using FKM seals above 200 RPM, which causes overheating and hardening within weeks. | technical_parameter | medium | 工程参数需要型号、测试条件和最大/连续值定义 | 规格书、图纸、试验条件和批准人 | 保留前先建立证据索引；无法证明时弱化并说明口径 | 需要人工验证
application-packaging-machinery.html | Packaging machinery runs at 60–200 RPM for 16–24 hours per shift. | technical_parameter | medium | 工程参数需要型号、测试条件和最大/连续值定义 | 规格书、图纸、试验条件和批准人 | 保留前先建立证据索引；无法证明时弱化并说明口径 | 需要人工验证
application-packaging-machinery.html | A rotary joint on a rotary sealing head or indexing table rotates 172,800 times per day at 120 RPM continuous duty. | technical_parameter | medium | 工程参数需要型号、测试条件和最大/连续值定义 | 规格书、图纸、试验条件和批准人 | 保留前先建立证据索引；无法证明时弱化并说明口径 | 需要人工验证
application-packaging-machinery.html | Standard seals rated for 5,000 hours fail in 6–8 weeks under this load. | business_metric | medium | 带数字的商业或技术陈述需要可追溯依据 | 内部记录、规格书或带日期的统计说明 | 保留前先建立证据索引；无法证明时弱化并说明口径 | 需要人工验证
application-packaging-machinery.html | The most frequent request is not for a catalog model — it is for a compact layout that fits a specific machine envelope, handles both vacuum and compressed air on independent channels, and can be replaced in under 10 minutes without disassembling the turret. | certification | high | 企业规模、认证或绝对性能陈述会直接影响采购信任 | 证书、出货记录、客户/国家统计口径、测试报告 | 保留前先建立证据索引；无法证明时弱化并说明口径 | 需要人工验证
application-packaging-machinery.html | A 120 RPM packaging line generates 172,800 rotations per day — specify high-cycle PTFE seals, not standard FKM | technical_parameter | medium | 工程参数需要型号、测试条件和最大/连续值定义 | 规格书、图纸、试验条件和批准人 | 保留前先建立证据索引；无法证明时弱化并说明口径 | 需要人工验证
application-packaging-machinery.html | Pressure: 0.3–0.6 MPa (clamp/actuation) / -0.04 to -0.08 MPa (vacuum) — 24/7 duty rated | technical_parameter | medium | 工程参数需要型号、测试条件和最大/连续值定义 | 规格书、图纸、试验条件和批准人 | 保留前先建立证据索引；无法证明时弱化并说明口径 | 需要人工验证
application-packaging-machinery.html | Bore: 4–8 mm for small stations; 6–10 mm for larger actuators | technical_parameter | medium | 带数字的商业或技术陈述需要可追溯依据 | 内部记录、规格书或带日期的统计说明 | 保留前先建立证据索引；无法证明时弱化并说明口径 | 需要人工验证
application-packaging-machinery.html | A line running 120 RPM continuous generates 172,800 rotations per day. | technical_parameter | medium | 工程参数需要型号、测试条件和最大/连续值定义 | 规格书、图纸、试验条件和批准人 | 保留前先建立证据索引；无法证明时弱化并说明口径 | 需要人工验证
application-packaging-machinery.html | Standard FKM seals rated for 5,000 hours will fail in 6–8 weeks. | business_metric | medium | 带数字的商业或技术陈述需要可追溯依据 | 内部记录、规格书或带日期的统计说明 | 保留前先建立证据索引；无法证明时弱化并说明口径 | 需要人工验证
application-packaging-machinery.html | Specify PTFE composite seals for any application above 200 RPM or continuous duty. | technical_parameter | medium | 工程参数需要型号、测试条件和最大/连续值定义 | 规格书、图纸、试验条件和批准人 | 保留前先建立证据索引；无法证明时弱化并说明口径 | 需要人工验证
application-packaging-machinery.html | Vacuum pickup: -0.04 to -0.08 MPa, requires dedicated vacuum-rated seal | technical_parameter | medium | 工程参数需要型号、测试条件和最大/连续值定义 | 规格书、图纸、试验条件和批准人 | 保留前先建立证据索引；无法证明时弱化并说明口径 | 需要人工验证
application-packaging-machinery.html | Sealing head actuation: 0.3–0.6 MPa, needs stable pressure for repeatable seal force | certification | high | 企业规模、认证或绝对性能陈述会直接影响采购信任 | 证书、出货记录、客户/国家统计口径、测试报告 | 保留前先建立证据索引；无法证明时弱化并说明口径 | 需要人工验证
application-packaging-machinery.html | Blow-off and cleaning air: 0.2–0.4 MPa, often pulsed — specify pulse-rated seal | technical_parameter | medium | 工程参数需要型号、测试条件和最大/连续值定义 | 规格书、图纸、试验条件和批准人 | 保留前先建立证据索引；无法证明时弱化并说明口径 | 需要人工验证
application-packaging-machinery.html | Pneumatic gripper control: 0.3–0.5 MPa, clamp + unclamp = 2 channels minimum | technical_parameter | medium | 工程参数需要型号、测试条件和最大/连续值定义 | 规格书、图纸、试验条件和批准人 | 保留前先建立证据索引；无法证明时弱化并说明口径 | 需要人工验证
application-packaging-machinery.html | Many packaging stations have limited envelope space — often < 50 mm radial clearance around the rotation axis. | certification | high | 企业规模、认证或绝对性能陈述会直接影响采购信任 | 证书、出货记录、客户/国家统计口径、测试报告 | 保留前先建立证据索引；无法证明时弱化并说明口径 | 需要人工验证
application-packaging-machinery.html | A packaging line at 120 RPM runs 172,800 rotations per day. | technical_parameter | medium | 工程参数需要型号、测试条件和最大/连续值定义 | 规格书、图纸、试验条件和批准人 | 保留前先建立证据索引；无法证明时弱化并说明口径 | 需要人工验证
application-packaging-machinery.html | Standard FKM seals rated for 5,000 hours fail in 6–8 weeks. | business_metric | medium | 带数字的商业或技术陈述需要可追溯依据 | 内部记录、规格书或带日期的统计说明 | 保留前先建立证据索引；无法证明时弱化并说明口径 | 需要人工验证
application-packaging-machinery.html | Rule: For continuous-duty packaging lines, specify PTFE composite seals and plan replacement at 60% of rated life (typically every 10–12 months for PTFE, every 6–8 months for FKM). | certification | high | 企业规模、认证或绝对性能陈述会直接影响采购信任 | 证书、出货记录、客户/国家统计口径、测试报告 | 保留前先建立证据索引；无法证明时弱化并说明口径 | 需要人工验证
application-packaging-machinery.html | The pressure differential (0.6 MPa air vs. | technical_parameter | medium | 工程参数需要型号、测试条件和最大/连续值定义 | 规格书、图纸、试验条件和批准人 | 保留前先建立证据索引；无法证明时弱化并说明口径 | 需要人工验证
application-packaging-machinery.html | -0.08 MPa vacuum) causes the seal lip to deform and extrude. | technical_parameter | medium | 工程参数需要型号、测试条件和最大/连续值定义 | 规格书、图纸、试验条件和批准人 | 保留前先建立证据索引；无法证明时弱化并说明口径 | 需要人工验证
application-packaging-machinery.html | Within 2 weeks, the vacuum side leaks air and the compressed air side loses pressure. | business_metric | medium | 带数字的商业或技术陈述需要可追溯依据 | 内部记录、规格书或带日期的统计说明 | 保留前先建立证据索引；无法证明时弱化并说明口径 | 需要人工验证
application-packaging-machinery.html | Design the rotary joint mounting so it can be replaced in under 10 minutes. | certification | high | 企业规模、认证或绝对性能陈述会直接影响采购信任 | 证书、出货记录、客户/国家统计口径、测试报告 | 保留前先建立证据索引；无法证明时弱化并说明口径 | 需要人工验证
application-packaging-machinery.html | Moisture causes AL6061 bodies to corrode internally within 6–12 months. | business_metric | medium | 带数字的商业或技术陈述需要可追溯依据 | 内部记录、规格书或带日期的统计说明 | 保留前先建立证据索引；无法证明时弱化并说明口径 | 需要人工验证
application-packaging-machinery.html | FKM seals: Replace every 6–8 months on continuous-duty lines | certification | high | 企业规模、认证或绝对性能陈述会直接影响采购信任 | 证书、出货记录、客户/国家统计口径、测试报告 | 保留前先建立证据索引；无法证明时弱化并说明口径 | 需要人工验证
application-packaging-machinery.html | PTFE seals: Replace every 10–12 months on continuous-duty lines | certification | high | 企业规模、认证或绝对性能陈述会直接影响采购信任 | 证书、出货记录、客户/国家统计口径、测试报告 | 保留前先建立证据索引；无法证明时弱化并说明口径 | 需要人工验证
application-packaging-machinery.html | Food-grade lines: Replace every 6 months regardless of visible wear (audit requirement) | certification | high | 企业规模、认证或绝对性能陈述会直接影响采购信任 | 证书、出货记录、客户/国家统计口径、测试报告 | 保留前先建立证据索引；无法证明时弱化并说明口径 | 需要人工验证
application-packaging-machinery.html | Each channel must have its own seal ring, and the vacuum side typically operates at -0.04 to -0.08 MPa while the air side runs at 0.3–0.6 MPa. | technical_parameter | medium | 工程参数需要型号、测试条件和最大/连续值定义 | 规格书、图纸、试验条件和批准人 | 保留前先建立证据索引；无法证明时弱化并说明口径 | 需要人工验证
application-packaging-machinery.html | A packaging line running 24/7 at 120 RPM generates 172,800 rotations per day. | technical_parameter | medium | 工程参数需要型号、测试条件和最大/连续值定义 | 规格书、图纸、试验条件和批准人 | 保留前先建立证据索引；无法证明时弱化并说明口径 | 需要人工验证
application-packaging-machinery.html | Standard duty seals rated for 5,000 hours will fail in 6–8 weeks under this load. | business_metric | medium | 带数字的商业或技术陈述需要可追溯依据 | 内部记录、规格书或带日期的统计说明 | 保留前先建立证据索引；无法证明时弱化并说明口径 | 需要人工验证
application-pneumatic-tools-hose-anti-twist.html | Over an 8-hour shift, that is 15–20 minutes of lost productivity per station. | business_metric | medium | 带数字的商业或技术陈述需要可追溯依据 | 内部记录、规格书或带日期的统计说明 | 保留前先建立证据索引；无法证明时弱化并说明口径 | 需要人工验证
application-pneumatic-tools-hose-anti-twist.html | Weight is critical — a 0.3 kg swivel on a 1.2 kg gun increases effective weight by 25%, raising the risk of repetitive strain injury over 6 months. | business_metric | medium | 带数字的商业或技术陈述需要可追溯依据 | 内部记录、规格书或带日期的统计说明 | 保留前先建立证据索引；无法证明时弱化并说明口径 | 需要人工验证
application-pneumatic-tools-hose-anti-twist.html | Thread matching matters — a G1/4 swivel on an NPT1/4 tool needs an adapter that adds 15 mm length and a leak point. | technical_parameter | medium | 带数字的商业或技术陈述需要可追溯依据 | 内部记录、规格书或带日期的统计说明 | 保留前先建立证据索引；无法证明时弱化并说明口径 | 需要人工验证
application-pneumatic-tools-hose-anti-twist.html | Weight is the #1 constraint for handheld tools — specify under 0.15 kg for 8-hour shift use to prevent repetitive strain | business_metric | medium | 带数字的商业或技术陈述需要可追溯依据 | 内部记录、规格书或带日期的统计说明 | 保留前先建立证据索引；无法证明时弱化并说明口径 | 需要人工验证
application-pneumatic-tools-hose-anti-twist.html | Thread mismatch (G1/4 swivel on NPT1/4 tool) creates a leak point and adds 15 mm length — always match thread standard | technical_parameter | medium | 带数字的商业或技术陈述需要可追溯依据 | 内部记录、规格书或带日期的统计说明 | 保留前先建立证据索引；无法证明时弱化并说明口径 | 需要人工验证
application-pneumatic-tools-hose-anti-twist.html | A swivel at the tool inlet eliminates hose coil memory, saving 15–20 minutes of lost productivity per shift | business_metric | medium | 带数字的商业或技术陈述需要可追溯依据 | 内部记录、规格书或带日期的统计说明 | 保留前先建立证据索引；无法证明时弱化并说明口径 | 需要人工验证
application-pneumatic-tools-hose-anti-twist.html | Pressure rating must be 20% above tool maximum working pressure to handle startup spikes — 1.0 MPa rated for 0.8 MPa tool | technical_parameter | medium | 工程参数需要型号、测试条件和最大/连续值定义 | 规格书、图纸、试验条件和批准人 | 保留前先建立证据索引；无法证明时弱化并说明口径 | 需要人工验证
application-pneumatic-tools-hose-anti-twist.html | Pressure: 0.5–0.8 MPa (standard assembly tools) / 0.3–0.5 MPa (precision micro-tools) — rated 20% above maximum | technical_parameter | medium | 工程参数需要型号、测试条件和最大/连续值定义 | 规格书、图纸、试验条件和批准人 | 保留前先建立证据索引；无法证明时弱化并说明口径 | 需要人工验证
application-pneumatic-tools-hose-anti-twist.html | Media: dry filtered air or oil-fog lubricated — specify for seal compatibility (ISO 8573-1 Class 1.2.1 or 1.4.1) | certification | medium | 带数字的商业或技术陈述需要可追溯依据 | 内部记录、规格书或带日期的统计说明 | 保留前先建立证据索引；无法证明时弱化并说明口径 | 需要人工验证
application-pneumatic-tools-hose-anti-twist.html | Bore: 6–10 mm for standard tools; 3–6 mm for precision micro-tools | technical_parameter | medium | 带数字的商业或技术陈述需要可追溯依据 | 内部记录、规格书或带日期的统计说明 | 保留前先建立证据索引；无法证明时弱化并说明口径 | 需要人工验证
application-pneumatic-tools-hose-anti-twist.html | Weight: <0.15 kg for handheld 8-hour shift use; <0.3 kg for occasional-use maintenance tools | certification | high | 企业规模、认证或绝对性能陈述会直接影响采购信任 | 证书、出货记录、客户/国家统计口径、测试报告 | 保留前先建立证据索引；无法证明时弱化并说明口径 | 需要人工验证
application-pneumatic-tools-hose-anti-twist.html | Adapters add 10–20 mm length, create a stress concentration point, and are the first fitting to crack under repeated side load. | certification | high | 企业规模、认证或绝对性能陈述会直接影响采购信任 | 证书、出货记录、客户/国家统计口径、测试报告 | 保留前先建立证据索引；无法证明时弱化并说明口径 | 需要人工验证
application-pneumatic-tools-hose-anti-twist.html | Dry air (ISO 8573-1 Class 1.2.1): Use standard FKM or NBR seals. | certification | medium | 带数字的商业或技术陈述需要可追溯依据 | 内部记录、规格书或带日期的统计说明 | 保留前先建立证据索引；无法证明时弱化并说明口径 | 需要人工验证
application-pneumatic-tools-hose-anti-twist.html | Seal life: 8–12 months on 8-hour shift duty. | business_metric | medium | 带数字的商业或技术陈述需要可追溯依据 | 内部记录、规格书或带日期的统计说明 | 保留前先建立证据索引；无法证明时弱化并说明口径 | 需要人工验证
application-pneumatic-tools-hose-anti-twist.html | Oil-fog lubricated (ISO 8573-1 Class 1.4.1): Use oil-compatible FKM or specialized NBR compounds. | certification | medium | 带数字的商业或技术陈述需要可追溯依据 | 内部记录、规格书或带日期的统计说明 | 保留前先建立证据索引；无法证明时弱化并说明口径 | 需要人工验证
application-pneumatic-tools-hose-anti-twist.html | The oil film reduces friction by 30–50%, extending seal life to 12–18 months. | certification | high | 企业规模、认证或绝对性能陈述会直接影响采购信任 | 证书、出货记录、客户/国家统计口径、测试报告 | 保留前先建立证据索引；无法证明时弱化并说明口径 | 需要人工验证
application-pneumatic-tools-hose-anti-twist.html | OSHA guidelines and ISO 11228-1 (Ergonomics — Manual handling) suggest that tools over 1.5 kg with awkward wrist angles increase the risk of musculoskeletal disorders. | certification | medium | 带数字的商业或技术陈述需要可追溯依据 | 内部记录、规格书或带日期的统计说明 | 保留前先建立证据索引；无法证明时弱化并说明口径 | 需要人工验证
application-pneumatic-tools-hose-anti-twist.html | 8-hour shift, high-frequency use: Swivel under 0.15 kg. | business_metric | medium | 带数字的商业或技术陈述需要可追溯依据 | 内部记录、规格书或带日期的统计说明 | 保留前先建立证据索引；无法证明时弱化并说明口径 | 需要人工验证
application-pneumatic-tools-hose-anti-twist.html | Begapunk BP-1P-0003 at 0.08 kg is ideal. | business_metric | medium | 带数字的商业或技术陈述需要可追溯依据 | 内部记录、规格书或带日期的统计说明 | 保留前先建立证据索引；无法证明时弱化并说明口径 | 需要人工验证
application-pneumatic-tools-hose-anti-twist.html | 4-hour shift, medium frequency: Swivel under 0.25 kg acceptable. | certification | high | 企业规模、认证或绝对性能陈述会直接影响采购信任 | 证书、出货记录、客户/国家统计口径、测试报告 | 保留前先建立证据索引；无法证明时弱化并说明口径 | 需要人工验证
application-pneumatic-tools-hose-anti-twist.html | Maintenance or occasional use: Up to 0.4 kg acceptable. | certification | high | 企业规模、认证或绝对性能陈述会直接影响采购信任 | 证书、出货记录、客户/国家统计口径、测试报告 | 保留前先建立证据索引；无法证明时弱化并说明口径 | 需要人工验证
application-pneumatic-tools-hose-anti-twist.html | A swivel mounted 50 mm from the grip adds more lever-arm torque than one mounted 20 mm away. | technical_parameter | medium | 带数字的商业或技术陈述需要可追溯依据 | 内部记录、规格书或带日期的统计说明 | 保留前先建立证据索引；无法证明时弱化并说明口径 | 需要人工验证
application-pneumatic-tools-hose-anti-twist.html | Assembly tightening gun (1–3 kg) Compressed air supply, anti-twist Weight <0.15 kg, thread match, low friction, G1/4 or NPT1/4 BP-1P-0003 (0.08 kg, 1.0 MPa) | technical_parameter | medium | 工程参数需要型号、测试条件和最大/连续值定义 | 规格书、图纸、试验条件和批准人 | 保留前先建立证据索引；无法证明时弱化并说明口径 | 需要人工验证
application-pneumatic-tools-hose-anti-twist.html | Pneumatic grinder or sander (2–5 kg) High-flow air supply, hose strain relief Flow capacity 400–800 L/min, thread match, vibration resistance BP-1P-0003 with 10 mm bore or BP-1P-0006 | certification | high | 企业规模、认证或绝对性能陈述会直接影响采购信任 | 证书、出货记录、客户/国家统计口径、测试报告 | 保留前先建立证据索引；无法证明时弱化并说明口径 | 需要人工验证
application-pneumatic-tools-hose-anti-twist.html | Precision micro-tool (0.5–1.5 kg) Low-pressure air, delicate handling Weight <0.1 kg, G1/8 or M12×1.0, minimal friction torque BP-1P-0003 with G1/8 option or custom micro-swivel | business_metric | medium | 带数字的商业或技术陈述需要可追溯依据 | 内部记录、规格书或带日期的统计说明 | 保留前先建立证据索引；无法证明时弱化并说明口径 | 需要人工验证
application-pneumatic-tools-hose-anti-twist.html | The adapter adds 15 mm length and creates a stress concentration. | certification | high | 企业规模、认证或绝对性能陈述会直接影响采购信任 | 证书、出货记录、客户/国家统计口径、测试报告 | 保留前先建立证据索引；无法证明时弱化并说明口径 | 需要人工验证
application-pneumatic-tools-hose-anti-twist.html | Within 3 weeks of daily use, the adapter cracks under side load from the twisting hose. | business_metric | medium | 带数字的商业或技术陈述需要可追溯依据 | 内部记录、规格书或带日期的统计说明 | 保留前先建立证据索引；无法证明时弱化并说明口径 | 需要人工验证
application-pneumatic-tools-hose-anti-twist.html | Within 4 weeks, the oil swells the seal, increasing friction torque from 0.02 N·m to 0.08 N·m. | business_metric | medium | 带数字的商业或技术陈述需要可追溯依据 | 内部记录、规格书或带日期的统计说明 | 保留前先建立证据索引；无法证明时弱化并说明口径 | 需要人工验证
application-pneumatic-tools-hose-anti-twist.html | An engineer specifies a 1.0 MPa rated swivel for a 0.6 MPa tool, which is correct for pressure. | technical_parameter | medium | 工程参数需要型号、测试条件和最大/连续值定义 | 规格书、图纸、试验条件和批准人 | 保留前先建立证据索引；无法证明时弱化并说明口径 | 需要人工验证
application-pneumatic-tools-hose-anti-twist.html | But the selected model weighs 0.35 kg. | business_metric | medium | 带数字的商业或技术陈述需要可追溯依据 | 内部记录、规格书或带日期的统计说明 | 保留前先建立证据索引；无法证明时弱化并说明口径 | 需要人工验证
application-pneumatic-tools-hose-anti-twist.html | On a 1.2 kg tightening gun, that is a 29% weight increase. | business_metric | medium | 带数字的商业或技术陈述需要可追溯依据 | 内部记录、规格书或带日期的统计说明 | 保留前先建立证据索引；无法证明时弱化并说明口径 | 需要人工验证
application-pneumatic-tools-hose-anti-twist.html | After 6 months of 8-hour shifts, three operators report wrist pain. | business_metric | medium | 带数字的商业或技术陈述需要可追溯依据 | 内部记录、规格书或带日期的统计说明 | 保留前先建立证据索引；无法证明时弱化并说明口径 | 需要人工验证
application-pneumatic-tools-hose-anti-twist.html | The swivel is replaced with a 0.08 kg model, and the complaints stop. | certification | high | 企业规模、认证或绝对性能陈述会直接影响采购信任 | 证书、出货记录、客户/国家统计口径、测试报告 | 保留前先建立证据索引；无法证明时弱化并说明口径 | 需要人工验证
application-pneumatic-tools-hose-anti-twist.html | For handheld tools, specify under 0.15 kg. | business_metric | medium | 带数字的商业或技术陈述需要可追溯依据 | 内部记录、规格书或带日期的统计说明 | 保留前先建立证据索引；无法证明时弱化并说明口径 | 需要人工验证
application-pneumatic-tools-hose-anti-twist.html | Mount the swivel as close to the tool body as possible — within 20–30 mm of the grip. | technical_parameter | medium | 带数字的商业或技术陈述需要可追溯依据 | 内部记录、规格书或带日期的统计说明 | 保留前先建立证据索引；无法证明时弱化并说明口径 | 需要人工验证
application-pneumatic-tools-hose-anti-twist.html | Avoid mounting the swivel at the end of a 50 mm extension — the extra length amplifies side load from the hose and increases the risk of fitting fatigue. | technical_parameter | medium | 带数字的商业或技术陈述需要可追溯依据 | 内部记录、规格书或带日期的统计说明 | 保留前先建立证据索引；无法证明时弱化并说明口径 | 需要人工验证
application-pneumatic-tools-hose-anti-twist.html | Best practice: Use a short, rigid nipple (20–30 mm) between the tool inlet and the swivel. | certification | high | 企业规模、认证或绝对性能陈述会直接影响采购信任 | 证书、出货记录、客户/国家统计口径、测试报告 | 保留前先建立证据索引；无法证明时弱化并说明口径 | 需要人工验证
application-pneumatic-tools-hose-anti-twist.html | 8-hour shift, 400–600 cycles/day: Replace every 8–10 months | certification | high | 企业规模、认证或绝对性能陈述会直接影响采购信任 | 证书、出货记录、客户/国家统计口径、测试报告 | 保留前先建立证据索引；无法证明时弱化并说明口径 | 需要人工验证
application-pneumatic-tools-hose-anti-twist.html | High-frequency line (2 shifts, 1,000+ cycles/day): Replace every 5–6 months | certification | high | 企业规模、认证或绝对性能陈述会直接影响采购信任 | 证书、出货记录、客户/国家统计口径、测试报告 | 保留前先建立证据索引；无法证明时弱化并说明口径 | 需要人工验证
application-pneumatic-tools-hose-anti-twist.html | Maintenance or occasional use: Inspect every 12 months, replace every 18–24 months | certification | high | 企业规模、认证或绝对性能陈述会直接影响采购信任 | 证书、出货记录、客户/国家统计口径、测试报告 | 保留前先建立证据索引；无法证明时弱化并说明口径 | 需要人工验证
application-pneumatic-tools-hose-anti-twist.html | Match the tool's rated supply pressure — typically 0.5–0.8 MPa for standard assembly tools and 0.3–0.5 MPa for precision micro-tools. | technical_parameter | medium | 工程参数需要型号、测试条件和最大/连续值定义 | 规格书、图纸、试验条件和批准人 | 保留前先建立证据索引；无法证明时弱化并说明口径 | 需要人工验证
application-pneumatic-tools-hose-anti-twist.html | Begapunk BP-1P-0003 is rated for 1.0 MPa, providing a 25% safety margin on a 0.8 MPa tool. | technical_parameter | medium | 工程参数需要型号、测试条件和最大/连续值定义 | 规格书、图纸、试验条件和批准人 | 保留前先建立证据索引；无法证明时弱化并说明口径 | 需要人工验证
application-pneumatic-tools-hose-anti-twist.html | For handheld tools used 8 hours per shift, the swivel should weigh under 0.15 kg to minimize operator fatigue and repetitive strain. | business_metric | medium | 带数字的商业或技术陈述需要可追溯依据 | 内部记录、规格书或带日期的统计说明 | 保留前先建立证据索引；无法证明时弱化并说明口径 | 需要人工验证
application-pneumatic-tools-hose-anti-twist.html | A 0.3 kg swivel on a 1.2 kg tightening gun increases effective weight by 25% — enough to raise the risk of wrist strain over a 6-month period. | business_metric | medium | 带数字的商业或技术陈述需要可追溯依据 | 内部记录、规格书或带日期的统计说明 | 保留前先建立证据索引；无法证明时弱化并说明口径 | 需要人工验证
application-pneumatic-tools-hose-anti-twist.html | Begapunk BP-1P-0003 weighs 0.08 kg, adding negligible load to the tool. | business_metric | medium | 带数字的商业或技术陈述需要可追溯依据 | 内部记录、规格书或带日期的统计说明 | 保留前先建立证据索引；无法证明时弱化并说明口径 | 需要人工验证
application-pneumatic-tools-hose-anti-twist.html | Engineers specify a G1/4 swivel for a tool with NPT1/4 inlet, then use a thread adapter that adds 15 mm length and creates a leak point. | technical_parameter | medium | 带数字的商业或技术陈述需要可追溯依据 | 内部记录、规格书或带日期的统计说明 | 保留前先建立证据索引；无法证明时弱化并说明口径 | 需要人工验证
application-robot-end-of-arm-tooling.html | If air hoses are routed externally, they twist, kink, and fatigue within 2–4 weeks. | business_metric | medium | 带数字的商业或技术陈述需要可追溯依据 | 内部记录、规格书或带日期的统计说明 | 保留前先建立证据索引；无法证明时弱化并说明口径 | 需要人工验证
application-robot-end-of-arm-tooling.html | Weight is critical — a 0.5 kg rotary joint on a 5 kg payload robot consumes 10% of the capacity. | business_metric | medium | 带数字的商业或技术陈述需要可追溯依据 | 内部记录、规格书或带日期的统计说明 | 保留前先建立证据索引；无法证明时弱化并说明口径 | 需要人工验证
application-robot-end-of-arm-tooling.html | Envelope is tight — the wrist may have only 40 mm radial clearance. | certification | high | 企业规模、认证或绝对性能陈述会直接影响采购信任 | 证书、出货记录、客户/国家统计口径、测试报告 | 保留前先建立证据索引；无法证明时弱化并说明口径 | 需要人工验证
application-robot-end-of-arm-tooling.html | Weight is the #1 constraint — a 0.5 kg joint on a 5 kg robot eats 10% of payload; specify under 0.2 kg for small robots | business_metric | medium | 带数字的商业或技术陈述需要可追溯依据 | 内部记录、规格书或带日期的统计说明 | 保留前先建立证据索引；无法证明时弱化并说明口径 | 需要人工验证
application-robot-end-of-arm-tooling.html | Pressure: 0.4–0.7 MPa (gripper actuation) / -0.05 to -0.08 MPa (vacuum) — derate 20% for continuous duty | technical_parameter | medium | 工程参数需要型号、测试条件和最大/连续值定义 | 规格书、图纸、试验条件和批准人 | 保留前先建立证据索引；无法证明时弱化并说明口径 | 需要人工验证
application-robot-end-of-arm-tooling.html | Media: dry filtered air, vacuum — oil-free for clean assembly (ISO 8573-1 Class 1.2.1 or better) | certification | medium | 带数字的商业或技术陈述需要可追溯依据 | 内部记录、规格书或带日期的统计说明 | 保留前先建立证据索引；无法证明时弱化并说明口径 | 需要人工验证
application-robot-end-of-arm-tooling.html | Mounting: compact flange or threaded — must fit within wrist envelope (typically 30–50 mm radial clearance) | certification | high | 企业规模、认证或绝对性能陈述会直接影响采购信任 | 证书、出货记录、客户/国家统计口径、测试报告 | 保留前先建立证据索引；无法证明时弱化并说明口径 | 需要人工验证
application-robot-end-of-arm-tooling.html | Bore: 4–8 mm for standard grippers; 3–6 mm for micro-parts and precision vacuum | technical_parameter | medium | 带数字的商业或技术陈述需要可追溯依据 | 内部记录、规格书或带日期的统计说明 | 保留前先建立证据索引；无法证明时弱化并说明口径 | 需要人工验证
application-robot-end-of-arm-tooling.html | Weight: <0.2 kg for small robots (5–10 kg payload); <0.5 kg for medium robots (20–50 kg payload) | business_metric | medium | 带数字的商业或技术陈述需要可追溯依据 | 内部记录、规格书或带日期的统计说明 | 保留前先建立证据索引；无法证明时弱化并说明口径 | 需要人工验证
application-robot-end-of-arm-tooling.html | Rotation angle: tested for ±360° oscillation at 30 cycles/minute to simulate real robot wrist motion | business_metric | medium | 带数字的商业或技术陈述需要可追溯依据 | 内部记录、规格书或带日期的统计说明 | 保留前先建立证据索引；无法证明时弱化并说明口径 | 需要人工验证
application-robot-end-of-arm-tooling.html | Small robots (5–10 kg payload): Rotary joint must weigh <0.2 kg. | business_metric | medium | 带数字的商业或技术陈述需要可追溯依据 | 内部记录、规格书或带日期的统计说明 | 保留前先建立证据索引；无法证明时弱化并说明口径 | 需要人工验证
application-robot-end-of-arm-tooling.html | A 0.5 kg joint consumes 5–10% of payload. | business_metric | medium | 带数字的商业或技术陈述需要可追溯依据 | 内部记录、规格书或带日期的统计说明 | 保留前先建立证据索引；无法证明时弱化并说明口径 | 需要人工验证
application-robot-end-of-arm-tooling.html | Medium robots (20–50 kg payload): Joint under 0.5 kg is acceptable, but lighter is better. | certification | high | 企业规模、认证或绝对性能陈述会直接影响采购信任 | 证书、出货记录、客户/国家统计口径、测试报告 | 保留前先建立证据索引；无法证明时弱化并说明口径 | 需要人工验证
application-robot-end-of-arm-tooling.html | Material choice: Aluminum-body joints (e.g., BP-2P-0001 at 0.12 kg) save 40–60% weight vs. | certification | high | 企业规模、认证或绝对性能陈述会直接影响采购信任 | 证书、出货记录、客户/国家统计口径、测试报告 | 保留前先建立证据索引；无法证明时弱化并说明口径 | 需要人工验证
application-robot-end-of-arm-tooling.html | Vacuum channel: -0.05 to -0.08 MPa, dedicated seal material (FKM or PTFE depending on duty cycle) | technical_parameter | medium | 工程参数需要型号、测试条件和最大/连续值定义 | 规格书、图纸、试验条件和批准人 | 保留前先建立证据索引；无法证明时弱化并说明口径 | 需要人工验证
application-robot-end-of-arm-tooling.html | Gripper channel: 0.4–0.7 MPa, independent seal assembly | technical_parameter | medium | 工程参数需要型号、测试条件和最大/连续值定义 | 规格书、图纸、试验条件和批准人 | 保留前先建立证据索引；无法证明时弱化并说明口径 | 需要人工验证
application-robot-end-of-arm-tooling.html | Blow-off channel: 0.2–0.3 MPa, often pulsed — must not back-feed into vacuum | technical_parameter | medium | 工程参数需要型号、测试条件和最大/连续值定义 | 规格书、图纸、试验条件和批准人 | 保留前先建立证据索引；无法证明时弱化并说明口径 | 需要人工验证
application-robot-end-of-arm-tooling.html | Leak tolerance: Even a 0.01 MPa leak from the gripper channel into the vacuum channel reduces holding force by 15–20%. | certification | high | 企业规模、认证或绝对性能陈述会直接影响采购信任 | 证书、出货记录、客户/国家统计口径、测试报告 | 保留前先建立证据索引；无法证明时弱化并说明口径 | 需要人工验证
application-robot-end-of-arm-tooling.html | Testing: Begapunk joints are tested for ±360° oscillation at 30 cycles/minute for 500,000 cycles to simulate real robot motion | business_metric | medium | 带数字的商业或技术陈述需要可追溯依据 | 内部记录、规格书或带日期的统计说明 | 保留前先建立证据索引；无法证明时弱化并说明口径 | 需要人工验证
application-robot-end-of-arm-tooling.html | Reference: ISO 9283 (Manipulating industrial robots — Performance criteria and related test methods) specifies that wrist repeatability should not be degraded by EOAT accessories. | certification | high | 企业规模、认证或绝对性能陈述会直接影响采购信任 | 证书、出货记录、客户/国家统计口径、测试报告 | 保留前先建立证据索引；无法证明时弱化并说明口径 | 需要人工验证
application-robot-end-of-arm-tooling.html | A high-friction rotary joint can introduce 0.1–0.3 mm position error at the tool center point. | certification | high | 企业规模、认证或绝对性能陈述会直接影响采购信任 | 证书、出货记录、客户/国家统计口径、测试报告 | 保留前先建立证据索引；无法证明时弱化并说明口径 | 需要人工验证
application-robot-end-of-arm-tooling.html | Small 6-axis robot (5–10 kg payload) Single gripper or vacuum cup Weight <0.2 kg, compact envelope, low friction torque, 2 passages BP-2P-0001 (0.12 kg, 2 passages) | technical_parameter | medium | 带数字的商业或技术陈述需要可追溯依据 | 内部记录、规格书或带日期的统计说明 | 保留前先建立证据索引；无法证明时弱化并说明口径 | 需要人工验证
application-robot-end-of-arm-tooling.html | Medium robot (20–50 kg payload) with dual gripper Clamp + release + vacuum + blow-off 3–4 passages, weight <0.5 kg, independent vacuum seal, flange mount BP-3P-0004 or BP-4P-30-0001 | business_metric | medium | 带数字的商业或技术陈述需要可追溯依据 | 内部记录、规格书或带日期的统计说明 | 保留前先建立证据索引；无法证明时弱化并说明口径 | 需要人工验证
application-robot-end-of-arm-tooling.html | Clean assembly (electronics, medical, food) Oil-free gripper and vacuum Oil-free air compatibility, stainless or anodized aluminum body, ISO 8573-1 Class 1.2.1 BP-2P-0001 with oil-free seal option or custom cleanroom design | certification | medium | 带数字的商业或技术陈述需要可追溯依据 | 内部记录、规格书或带日期的统计说明 | 保留前先建立证据索引；无法证明时弱化并说明口径 | 需要人工验证
application-robot-end-of-arm-tooling.html | Engineers select a rotary joint based on pressure (0.6 MPa) and passage count (3), then discover it weighs 0.8 kg. | technical_parameter | medium | 工程参数需要型号、测试条件和最大/连续值定义 | 规格书、图纸、试验条件和批准人 | 保留前先建立证据索引；无法证明时弱化并说明口径 | 需要人工验证
application-robot-end-of-arm-tooling.html | On a 5 kg payload robot, that is 16% of capacity gone — meaning the gripper can only handle 4.2 kg instead of 5 kg. | business_metric | medium | 带数字的商业或技术陈述需要可追溯依据 | 内部记录、规格书或带日期的统计说明 | 保留前先建立证据索引；无法证明时弱化并说明口径 | 需要人工验证
application-robot-end-of-arm-tooling.html | For small robots, specify under 0.2 kg. | business_metric | medium | 带数字的商业或技术陈述需要可追溯依据 | 内部记录、规格书或带日期的统计说明 | 保留前先建立证据索引；无法证明时弱化并说明口径 | 需要人工验证
application-robot-end-of-arm-tooling.html | For medium robots, under 0.5 kg. | business_metric | medium | 带数字的商业或技术陈述需要可追溯依据 | 内部记录、规格书或带日期的统计说明 | 保留前先建立证据索引；无法证明时弱化并说明口径 | 需要人工验证
application-robot-end-of-arm-tooling.html | Begapunk BP-2P-0001 weighs 0.12 kg — suitable for most small-to-medium wrists. | business_metric | medium | 带数字的商业或技术陈述需要可追溯依据 | 内部记录、规格书或带日期的统计说明 | 保留前先建立证据索引；无法证明时弱化并说明口径 | 需要人工验证
application-robot-end-of-arm-tooling.html | The result: when blow-off pulses at 0.3 MPa, it back-feeds into the vacuum line, momentarily destroying holding force. | certification | high | 企业规模、认证或绝对性能陈述会直接影响采购信任 | 证书、出货记录、客户/国家统计口径、测试报告 | 保留前先建立证据索引；无法证明时弱化并说明口径 | 需要人工验证
application-robot-end-of-arm-tooling.html | Within 3 months, the joint leaks and the gripper loses force. | certification | high | 企业规模、认证或绝对性能陈述会直接影响采购信任 | 证书、出货记录、客户/国家统计口径、测试报告 | 保留前先建立证据索引；无法证明时弱化并说明口径 | 需要人工验证
application-robot-end-of-arm-tooling.html | Rule: Specify the actual rotation pattern — oscillation angle, cycle rate, and dwell time — not just "360° rotation." Begapunk tests joints for ±360° oscillation at 30 cycles/minute to match real robot motion profiles. | business_metric | medium | 带数字的商业或技术陈述需要可追溯依据 | 内部记录、规格书或带日期的统计说明 | 保留前先建立证据索引；无法证明时弱化并说明口径 | 需要人工验证
application-robot-end-of-arm-tooling.html | Robot wrists have 30–50 mm radial clearance. | certification | high | 企业规模、认证或绝对性能陈述会直接影响采购信任 | 证书、出货记录、客户/国家统计口径、测试报告 | 保留前先建立证据索引；无法证明时弱化并说明口径 | 需要人工验证
application-robot-end-of-arm-tooling.html | Best practice: Use a flange mount with the air ports facing away from the wrist servo. | certification | high | 企业规模、认证或绝对性能陈述会直接影响采购信任 | 证书、出货记录、客户/国家统计口径、测试报告 | 保留前先建立证据索引；无法证明时弱化并说明口径 | 需要人工验证
application-robot-end-of-arm-tooling.html | Design tip: Use a flexible anti-rotation link (e.g., a short chain or spring-loaded pin) that allows ±3 mm radial float while preventing rotation. | technical_parameter | medium | 带数字的商业或技术陈述需要可追溯依据 | 内部记录、规格书或带日期的统计说明 | 保留前先建立证据索引；无法证明时弱化并说明口径 | 需要人工验证
application-robot-end-of-arm-tooling.html | Standard duty (8-hour shift, 30 cycles/min): Replace every 10–12 months | certification | high | 企业规模、认证或绝对性能陈述会直接影响采购信任 | 证书、出货记录、客户/国家统计口径、测试报告 | 保留前先建立证据索引；无法证明时弱化并说明口径 | 需要人工验证
application-robot-end-of-arm-tooling.html | High-cycle lines (24/7, 60 cycles/min): Replace every 6–8 months | certification | high | 企业规模、认证或绝对性能陈述会直接影响采购信任 | 证书、出货记录、客户/国家统计口径、测试报告 | 保留前先建立证据索引；无法证明时弱化并说明口径 | 需要人工验证
application-robot-end-of-arm-tooling.html | Clean assembly (electronics, medical): Replace every 8–10 months regardless of visible wear | certification | high | 企业规模、认证或绝对性能陈述会直接影响采购信任 | 证书、出货记录、客户/国家统计口径、测试报告 | 保留前先建立证据索引；无法证明时弱化并说明口径 | 需要人工验证
application-robot-end-of-arm-tooling.html | On a 6-axis robot with ±270° wrist rotation, external hoses fatigue and fail within 2–4 weeks. | business_metric | medium | 带数字的商业或技术陈述需要可追溯依据 | 内部记录、规格书或带日期的统计说明 | 保留前先建立证据索引；无法证明时弱化并说明口径 | 需要人工验证
application-robot-end-of-arm-tooling.html | Positive pressure (0.4–0.7 MPa for grippers) and vacuum (-0.05 to -0.08 MPa for suction cups) cannot share a channel — even a small leak between them destroys gripper force and vacuum holding power. | certification | high | 企业规模、认证或绝对性能陈述会直接影响采购信任 | 证书、出货记录、客户/国家统计口径、测试报告 | 保留前先建立证据索引；无法证明时弱化并说明口径 | 需要人工验证
application-robot-end-of-arm-tooling.html | For small robots (5–10 kg payload), the rotary union should weigh under 0.2 kg. | business_metric | medium | 带数字的商业或技术陈述需要可追溯依据 | 内部记录、规格书或带日期的统计说明 | 保留前先建立证据索引；无法证明时弱化并说明口径 | 需要人工验证
application-robot-end-of-arm-tooling.html | For medium robots (20–50 kg payload), under 0.5 kg is acceptable. | certification | high | 企业规模、认证或绝对性能陈述会直接影响采购信任 | 证书、出货记录、客户/国家统计口径、测试报告 | 保留前先建立证据索引；无法证明时弱化并说明口径 | 需要人工验证
application-robot-end-of-arm-tooling.html | Begapunk BP-2P-0001 weighs 0.12 kg — suitable for most small-to-medium robot wrists. | business_metric | medium | 带数字的商业或技术陈述需要可追溯依据 | 内部记录、规格书或带日期的统计说明 | 保留前先建立证据索引；无法证明时弱化并说明口径 | 需要人工验证
application-robot-end-of-arm-tooling.html | Begapunk joints are tested for ±360° oscillation at 30 cycles/minute to simulate real robot wrist motion. | business_metric | medium | 带数字的商业或技术陈述需要可追溯依据 | 内部记录、规格书或带日期的统计说明 | 保留前先建立证据索引；无法证明时弱化并说明口径 | 需要人工验证
application-robot-end-of-arm-tooling.html | Engineers select a rotary joint based on pressure and passage count, then discover it weighs 0.8 kg — consuming 16% of a 5 kg robot's payload. | business_metric | medium | 带数字的商业或技术陈述需要可追溯依据 | 内部记录、规格书或带日期的统计说明 | 保留前先建立证据索引；无法证明时弱化并说明口径 | 需要人工验证
application-steel-dusty-environments.html | Pressure: 0.4–1.0 MPa (actuation) — heavy-duty rated for shock loads | technical_parameter | medium | 工程参数需要型号、测试条件和最大/连续值定义 | 规格书、图纸、试验条件和批准人 | 保留前先建立证据索引；无法证明时弱化并说明口径 | 需要人工验证
application-steel-dusty-environments.html | Bore: 8–16 mm for large actuators; 6–10 mm for standard cylinders | technical_parameter | medium | 带数字的商业或技术陈述需要可追溯依据 | 内部记录、规格书或带日期的统计说明 | 保留前先建立证据索引；无法证明时弱化并说明口径 | 需要人工验证
application-textile-printing-converting.html | Pressure: 0.2–0.6 MPa (blow-off) / -0.04 to -0.08 MPa (vacuum) / 0.1–0.4 MPa (water) | technical_parameter | medium | 工程参数需要型号、测试条件和最大/连续值定义 | 规格书、图纸、试验条件和批准人 | 保留前先建立证据索引；无法证明时弱化并说明口径 | 需要人工验证
application-textile-printing-converting.html | Bore: 10–30 mm (roller shafts) — through-bore must match shaft diameter | technical_parameter | medium | 带数字的商业或技术陈述需要可追溯依据 | 内部记录、规格书或带日期的统计说明 | 保留前先建立证据索引；无法证明时弱化并说明口径 | 需要人工验证
application-textile-printing-converting.html | Seal: PTFE skeleton oil seal for >500 RPM roller applications | technical_parameter | medium | 工程参数需要型号、测试条件和最大/连续值定义 | 规格书、图纸、试验条件和批准人 | 保留前先建立证据索引；无法证明时弱化并说明口径 | 需要人工验证
application-vacuum-packaging-machines.html | Pressure: -0.06 to -0.09 MPa (vacuum) / 0.3–0.6 MPa (positive air) — low leakage critical | technical_parameter | medium | 工程参数需要型号、测试条件和最大/连续值定义 | 规格书、图纸、试验条件和批准人 | 保留前先建立证据索引；无法证明时弱化并说明口径 | 需要人工验证
application-vacuum-packaging-machines.html | Bore: 6–10 mm for vacuum; 4–8 mm for clamp/release air | technical_parameter | medium | 带数字的商业或技术陈述需要可追溯依据 | 内部记录、规格书或带日期的统计说明 | 保留前先建立证据索引；无法证明时弱化并说明口径 | 需要人工验证
application-welding-positioners.html | Pressure: 0.4–0.8 MPa (clamping) — derate 30% for continuous welding duty | technical_parameter | medium | 工程参数需要型号、测试条件和最大/连续值定义 | 规格书、图纸、试验条件和批准人 | 保留前先建立证据索引；无法证明时弱化并说明口径 | 需要人工验证
application-welding-positioners.html | Bore: 8–16 mm for large clamps; 6–10 mm for standard fixtures | technical_parameter | medium | 带数字的商业或技术陈述需要可追溯依据 | 内部记录、规格书或带日期的统计说明 | 保留前先建立证据索引；无法证明时弱化并说明口径 | 需要人工验证
applications.html | Typical requirement: 2–4 independent air passages at 0.3–0.6 MPa, 60–120 RPM indexing speed, with flange mount for anti-rotation stability. | technical_parameter | medium | 工程参数需要型号、测试条件和最大/连续值定义 | 规格书、图纸、试验条件和批准人 | 保留前先建立证据索引；无法证明时弱化并说明口径 | 需要人工验证
applications.html | Typical requirement: 1–3 passages at 0.4–0.8 MPa, compact threaded mount for tight turret envelopes, with quick-disconnect fittings for fast maintenance changeout. | certification | high | 企业规模、认证或绝对性能陈述会直接影响采购信任 | 证书、出货记录、客户/国家统计口径、测试报告 | 保留前先建立证据索引；无法证明时弱化并说明口径 | 需要人工验证
applications.html | Typical requirement: 2–4 passages at 0.4–1.0 MPa assist gas pressure, 100–500 RPM continuous rotation, with clean flow paths to prevent gas contamination. | technical_parameter | medium | 工程参数需要型号、测试条件和最大/连续值定义 | 规格书、图纸、试验条件和批准人 | 保留前先建立证据索引；无法证明时弱化并说明口径 | 需要人工验证
applications.html | Typical requirement: 2–3 passages at 0.3–0.6 MPa, flange mount for rigid fixture integration, with through-bore options for coolant or wiring passage. | technical_parameter | medium | 工程参数需要型号、测试条件和最大/连续值定义 | 规格书、图纸、试验条件和批准人 | 保留前先建立证据索引；无法证明时弱化并说明口径 | 需要人工验证
applications.html | Rotary filling turrets and capping heads in beverage and pharmaceutical lines rotate at 60–200 RPM while controlling pneumatic torque, vacuum hold-down, and bottle gripper actuation. | certification | high | 企业规模、认证或绝对性能陈述会直接影响采购信任 | 证书、出货记录、客户/国家统计口径、测试报告 | 保留前先建立证据索引；无法证明时弱化并说明口径 | 需要人工验证
applications.html | Typical requirement: 1–3 passages at 0.2–0.5 MPa, compact threaded mount for tight turret envelopes, with FDA-compatible seal options for food-grade applications. | technical_parameter | medium | 工程参数需要型号、测试条件和最大/连续值定义 | 规格书、图纸、试验条件和批准人 | 保留前先建立证据索引；无法证明时弱化并说明口径 | 需要人工验证
applications.html | Typical requirement: 2–3 passages at 0.3–0.6 MPa, ultra-compact threaded mount (often M5 or G1/8), lightweight AL6061 body, with integrated electrical slip ring options for combined pneumatic-electric EOAT designs. | technical_parameter | medium | 工程参数需要型号、测试条件和最大/连续值定义 | 规格书、图纸、试验条件和批准人 | 保留前先建立证据索引；无法证明时弱化并说明口径 | 需要人工验证
applications.html | Typical requirement: Single passage at 0.4–0.8 MPa, threaded mount (G1/4 or G1/8), compact body for handheld tool integration, with 360° free rotation and low torque drag so the operator does not feel resistance. | certification | high | 企业规模、认证或绝对性能陈述会直接影响采购信任 | 证书、出货记录、客户/国家统计口径、测试报告 | 保留前先建立证据索引；无法证明时弱化并说明口径 | 需要人工验证
applications.html | Each channel must be mechanically isolated with zero leakage tolerance. | certification | high | 企业规模、认证或绝对性能陈述会直接影响采购信任 | 证书、出货记录、客户/国家统计口径、测试报告 | 保留前先建立证据索引；无法证明时弱化并说明口径 | 需要人工验证
applications.html | Typical requirement: 2–3 passages (vacuum + release air + clamp), 0.05–0.1 MPa vacuum side / 0.4–0.6 MPa air side, 60–120 RPM turret speed, with flange mount for rigid turret integration and food-grade seal options. | technical_parameter | medium | 工程参数需要型号、测试条件和最大/连续值定义 | 规格书、图纸、试验条件和批准人 | 保留前先建立证据索引；无法证明时弱化并说明口径 | 需要人工验证
applications.html | Typical requirement: 2–4 passages at 0.4–0.8 MPa, 5–60 RPM slow rotation, flange mount with IP65 dust protection, 45# steel or 304 SS body for weld spatter resistance, with heavy-duty anti-rotation bracket for vibration isolation. | certification | high | 企业规模、认证或绝对性能陈述会直接影响采购信任 | 证书、出货记录、客户/国家统计口径、测试报告 | 保留前先建立证据索引；无法证明时弱化并说明口径 | 需要人工验证
applications.html | Typical requirement: 1–2 passages at 0.2–0.5 MPa, 100–500 RPM continuous rotation, through-bore for shaft passage, with 10-micron filtration and PTFE seals for fiber resistance. | certification | high | 企业规模、认证或绝对性能陈述会直接影响采购信任 | 证书、出货记录、客户/国家统计口径、测试报告 | 保留前先建立证据索引；无法证明时弱化并说明口径 | 需要人工验证
applications.html | Compact size is critical — test fixtures often have <50 mm clearance around the rotation axis. | certification | high | 企业规模、认证或绝对性能陈述会直接影响采购信任 | 证书、出货记录、客户/国家统计口径、测试报告 | 保留前先建立证据索引；无法证明时弱化并说明口径 | 需要人工验证
applications.html | Typical requirement: 2–3 passages at 0.1–0.4 MPa, 60–300 RPM, ultra-compact threaded mount (M5 or G1/8), with oil-free PTFE seals and optional integrated electrical circuits for signal transfer alongside pneumatic lines. | technical_parameter | medium | 工程参数需要型号、测试条件和最大/连续值定义 | 规格书、图纸、试验条件和批准人 | 保留前先建立证据索引；无法证明时弱化并说明口径 | 需要人工验证
applications.html | Standard joints fail within 2–3 months from dust ingress into bearings and seal faces. | certification | high | 企业规模、认证或绝对性能陈述会直接影响采购信任 | 证书、出货记录、客户/国家统计口径、测试报告 | 保留前先建立证据索引；无法证明时弱化并说明口径 | 需要人工验证
applications.html | Typical requirement: 2–4 passages at 0.4–1.0 MPa, 10–100 RPM, flange mount with IP65 dust protection, 45# steel or 304 SS body for impact resistance, with sealed bearings and external dust shields. | certification | high | 企业规模、认证或绝对性能陈述会直接影响采购信任 | 证书、出货记录、客户/国家统计口径、测试报告 | 保留前先建立证据索引；无法证明时弱化并说明口径 | 需要人工验证
applications.html | The best model depends on machine function, installation constraints, and operating conditions. | business_metric | medium | 带数字的商业或技术陈述需要可追溯依据 | 内部记录、规格书或带日期的统计说明 | 保留前先建立证据索引；无法证明时弱化并说明口径 | 需要人工验证
blog-rotary-joint-leaking.html | Check system pressure at the joint inlet (not at the compressor) — continuous pressure should not exceed 0.7 MPa for 1.0 MPa rated models | certification | high | 企业规模、认证或绝对性能陈述会直接影响采购信任 | 证书、出货记录、客户/国家统计口径、测试报告 | 保留前先建立证据索引；无法证明时弱化并说明口径 | 需要人工验证
blog-rotary-joint-leaking.html | seal material : FKM seals for < 200 RPM, PTFE for 300–600 RPM, specialized composites for > 600 RPM | technical_parameter | medium | 工程参数需要型号、测试条件和最大/连续值定义 | 规格书、图纸、试验条件和批准人 | 保留前先建立证据索引；无法证明时弱化并说明口径 | 需要人工验证
blog-rotary-joint-leaking.html | It applies to general-purpose models rated up to 1.0 MPa, including multi-channel configurations like BP-2P series and higher-pressure variants such as BP-2P-130 (5.0 MPa rated) and BP-2P-95 (10.0 MPa rated). | technical_parameter | medium | 工程参数需要型号、测试条件和最大/连续值定义 | 规格书、图纸、试验条件和批准人 | 保留前先建立证据索引；无法证明时弱化并说明口径 | 需要人工验证
blog-rotary-joint-leaking.html | Continuous operating pressure should not exceed 0.7 MPa for standard models (1.0 MPa rated / 1.5 MPa test). | certification | high | 企业规模、认证或绝对性能陈述会直接影响采购信任 | 证书、出货记录、客户/国家统计口径、测试报告 | 保留前先建立证据索引；无法证明时弱化并说明口径 | 需要人工验证
blog-rotary-joint-leaking.html | If your system runs at 0.9 MPa continuously, the seal lip experiences accelerated wear regardless of seal material quality. | certification | high | 企业规模、认证或绝对性能陈述会直接影响采购信任 | 证书、出货记录、客户/国家统计口径、测试报告 | 保留前先建立证据索引；无法证明时弱化并说明口径 | 需要人工验证
blog-rotary-joint-leaking.html | Reference: ISO 4414:2010 recommends maintaining pneumatic system pressure within 80% of component rated pressure for optimal seal life. | certification | high | 企业规模、认证或绝对性能陈述会直接影响采购信任 | 证书、出货记录、客户/国家统计口径、测试报告 | 保留前先建立证据索引；无法证明时弱化并说明口径 | 需要人工验证
blog-rotary-joint-leaking.html | FKM (Fluorocarbon) < 200 RPM General automation, indexing tables | technical_parameter | medium | 工程参数需要型号、测试条件和最大/连续值定义 | 规格书、图纸、试验条件和批准人 | 保留前先建立证据索引；无法证明时弱化并说明口径 | 需要人工验证
blog-rotary-joint-leaking.html | PTFE 300–600 RPM Continuous rotation, packaging lines | technical_parameter | medium | 工程参数需要型号、测试条件和最大/连续值定义 | 规格书、图纸、试验条件和批准人 | 保留前先建立证据索引；无法证明时弱化并说明口径 | 需要人工验证
blog-rotary-joint-leaking.html | Specialized composites > 600 RPM High-speed spindles (custom order) | technical_parameter | medium | 工程参数需要型号、测试条件和最大/连续值定义 | 规格书、图纸、试验条件和批准人 | 保留前先建立证据索引；无法证明时弱化并说明口径 | 需要人工验证
blog-rotary-joint-leaking.html | Running an FKM-sealed joint at 500 RPM generates excessive heat at the seal interface. | certification | high | 企业规模、认证或绝对性能陈述会直接影响采购信任 | 证书、出货记录、客户/国家统计口径、测试报告 | 保留前先建立证据索引；无法证明时弱化并说明口径 | 需要人工验证
blog-rotary-joint-leaking.html | If your application runs above 200 RPM, verify whether your joint uses PTFE seals. | technical_parameter | medium | 工程参数需要型号、测试条件和最大/连续值定义 | 规格书、图纸、试验条件和批准人 | 保留前先建立证据索引；无法证明时弱化并说明口径 | 需要人工验证
blog-rotary-joint-leaking.html | For continuous-duty applications above 200 RPM, specify PTFE seal configuration at order. | technical_parameter | medium | 工程参数需要型号、测试条件和最大/连续值定义 | 规格书、图纸、试验条件和批准人 | 保留前先建立证据索引；无法证明时弱化并说明口径 | 需要人工验证
blog-rotary-joint-leaking.html | Filter element: replace if pressure drop exceeds 0.05 MPa across the filter | certification | high | 企业规模、认证或绝对性能陈述会直接影响采购信任 | 证书、出货记录、客户/国家统计口径、测试报告 | 保留前先建立证据索引；无法证明时弱化并说明口径 | 需要人工验证
blog-rotary-joint-leaking.html | Continuous pressure > 0.7 MPa? | technical_parameter | medium | 工程参数需要型号、测试条件和最大/连续值定义 | 规格书、图纸、试验条件和批准人 | 保留前先建立证据索引；无法证明时弱化并说明口径 | 需要人工验证
blog-rotary-joint-leaking.html | Shaft bearing play exceeds 0.3 mm radial runout | certification | high | 企业规模、认证或绝对性能陈述会直接影响采购信任 | 证书、出货记录、客户/国家统计口径、测试报告 | 保留前先建立证据索引；无法证明时弱化并说明口径 | 需要人工验证
blog-rotary-joint-leaking.html | What reads 0.6 MPa at the compressor may be 0.8 MPa at the joint if the regulator is mislocated. | technical_parameter | medium | 工程参数需要型号、测试条件和最大/连续值定义 | 规格书、图纸、试验条件和批准人 | 保留前先建立证据索引；无法证明时弱化并说明口径 | 需要人工验证
blog-rotary-joint-leaking.html | For general pneumatic system design guidance, refer to ISO 4414:2010 Pneumatic fluid power — General rules and safety requirements for systems and their components . | certification | high | 企业规模、认证或绝对性能陈述会直接影响采购信任 | 证书、出货记录、客户/国家统计口径、测试报告 | 保留前先建立证据索引；无法证明时弱化并说明口径 | 需要人工验证
blog-rotary-joint-materials.html | AL6061 Dry air, water, water-based coolant, hydraulic oil (ISO VG 32) 1.0 MPa Weak acids OK. | certification | medium | 工程参数需要型号、测试条件和最大/连续值定义 | 规格书、图纸、试验条件和批准人 | 保留前先建立证据索引；无法证明时弱化并说明口径 | 需要人工验证
blog-rotary-joint-materials.html | 304 SS Steam, food-grade water, seawater (short-term), mild chemicals 1.5 MPa Excellent general resistance. | certification | high | 企业规模、认证或绝对性能陈述会直接影响采购信任 | 证书、出货记录、客户/国家统计口径、测试报告 | 保留前先建立证据索引；无法证明时弱化并说明口径 | 需要人工验证
blog-rotary-joint-materials.html | 316 SS Aggressive chemicals, seawater (continuous), food/pharma, urea 1.5 MPa Superior chloride resistance. | certification | high | 企业规模、认证或绝对性能陈述会直接影响采购信任 | 证书、出货记录、客户/国家统计口径、测试报告 | 保留前先建立证据索引；无法证明时弱化并说明口径 | 需要人工验证
blog-rotary-joint-materials.html | Brass Water, low-pressure air, non-ammonia environments 0.8 MPa Good in neutral water. | technical_parameter | medium | 工程参数需要型号、测试条件和最大/连续值定义 | 规格书、图纸、试验条件和批准人 | 保留前先建立证据索引；无法证明时弱化并说明口径 | 需要人工验证
blog-rotary-joint-materials.html | If your compressed air is dried to a dew point of -20°C or lower, and the machine runs in a standard factory environment, AL6061 is the correct material. | technical_parameter | medium | 工程参数需要型号、测试条件和最大/连续值定义 | 规格书、图纸、试验条件和批准人 | 保留前先建立证据索引；无法证明时弱化并说明口径 | 需要人工验证
blog-rotary-joint-materials.html | Even intermittently wet air will cause internal bore corrosion within 6–12 months. | business_metric | medium | 带数字的商业或技术陈述需要可追溯依据 | 内部记录、规格书或带日期的统计说明 | 保留前先建立证据索引；无法证明时弱化并说明口径 | 需要人工验证
blog-rotary-joint-materials.html | 304 stainless steel shows crevice corrosion within 3–6 months of seawater exposure. | certification | high | 企业规模、认证或绝对性能陈述会直接影响采购信任 | 证书、出货记录、客户/国家统计口径、测试报告 | 保留前先建立证据索引；无法证明时弱化并说明口径 | 需要人工验证
blog-rotary-joint-materials.html | In a coastal factory with salt-laden air, the timeline shortens to 2–3 months. | business_metric | medium | 带数字的商业或技术陈述需要可追溯依据 | 内部记录、规格书或带日期的统计说明 | 保留前先建立证据索引；无法证明时弱化并说明口径 | 需要人工验证
blog-rotary-joint-materials.html | We have test records showing 304 SS housings with visible corrosion after 90 days of marine exposure. | business_metric | medium | 带数字的商业或技术陈述需要可追溯依据 | 内部记录、规格书或带日期的统计说明 | 保留前先建立证据索引；无法证明时弱化并说明口径 | 需要人工验证
blog-rotary-joint-materials.html | Standard PTFE is inert but not FDA-certified. | certification | high | 企业规模、认证或绝对性能陈述会直接影响采购信任 | 证书、出货记录、客户/国家统计口径、测试报告 | 保留前先建立证据索引；无法证明时弱化并说明口径 | 需要人工验证
blog-rotary-joint-materials.html | A six-axis robot with three rotary joints on the wrist sees 660 g of added load with aluminum, versus 1.9 kg with stainless steel. | business_metric | medium | 带数字的商业或技术陈述需要可追溯依据 | 内部记录、规格书或带日期的统计说明 | 保留前先建立证据索引；无法证明时弱化并说明口径 | 需要人工验证
blog-rotary-joint-materials.html | Material Relative Housing Cost Seal Replacement (every 2 years) 6-Year Total Cost Failure Mode | certification | high | 企业规模、认证或绝对性能陈述会直接影响采购信任 | 证书、出货记录、客户/国家统计口径、测试报告 | 保留前先建立证据索引；无法证明时弱化并说明口径 | 需要人工验证
blog-rotary-joint-materials.html | AL6061 Low Every 3 months Highest total cost 24 | business_metric | medium | 带数字的商业或技术陈述需要可追溯依据 | 内部记录、规格书或带日期的统计说明 | 保留前先建立证据索引；无法证明时弱化并说明口径 | 需要人工验证
blog-rotary-joint-materials.html | 304 SS 3× baseline Every 12 months Moderate total cost 6 | business_metric | medium | 带数字的商业或技术陈述需要可追溯依据 | 内部记录、规格书或带日期的统计说明 | 保留前先建立证据索引；无法证明时弱化并说明口径 | 需要人工验证
blog-rotary-joint-materials.html | 316 SS 4× baseline Every 24 months Lowest total cost 3 | business_metric | medium | 带数字的商业或技术陈述需要可追溯依据 | 内部记录、规格书或带日期的统计说明 | 保留前先建立证据索引；无法证明时弱化并说明口径 | 需要人工验证
blog-rotary-joint-materials.html | AL6061 for dry air Air dew point > +10°C 304 SS | technical_parameter | medium | 工程参数需要型号、测试条件和最大/连续值定义 | 规格书、图纸、试验条件和批准人 | 保留前先建立证据索引；无法证明时弱化并说明口径 | 需要人工验证
blog-rotary-joint-materials.html | Aluminum for weight >600 RPM continuous 304 SS (fatigue limit) | technical_parameter | medium | 工程参数需要型号、测试条件和最大/连续值定义 | 规格书、图纸、试验条件和批准人 | 保留前先建立证据索引；无法证明时弱化并说明口径 | 需要人工验证
blog-rotary-joint-materials.html | Dry air, clean coolant, normal factory → AL6061, lowest cost, best performance | certification | high | 企业规模、认证或绝对性能陈述会直接影响采购信任 | 证书、出货记录、客户/国家统计口径、测试报告 | 保留前先建立证据索引；无法证明时弱化并说明口径 | 需要人工验证
blog-rotary-joint-materials.html | 316 SS and custom configurations ship in 3 weeks. | business_metric | medium | 带数字的商业或技术陈述需要可追溯依据 | 内部记录、规格书或带日期的统计说明 | 保留前先建立证据索引；无法证明时弱化并说明口径 | 需要人工验证
blog-rotary-joint-materials.html | AL6061 aluminum: BP-2P-0001 (2-in-2-out, flange, 1 MPa), BP-1P-0003 (1-in-1-out, threaded, 1 MPa), BP-3P-0004 (3-in-3-out, flange, 1 MPa) | technical_parameter | medium | 工程参数需要型号、测试条件和最大/连续值定义 | 规格书、图纸、试验条件和批准人 | 保留前先建立证据索引；无法证明时弱化并说明口径 | 需要人工验证
blog-rotary-joint-materials.html | 304 SS + AL6061 hybrid: BP-2P-130-0001 (2-in-2-out heavy duty, 5 MPa) | technical_parameter | medium | 工程参数需要型号、测试条件和最大/连续值定义 | 规格书、图纸、试验条件和批准人 | 保留前先建立证据索引；无法证明时弱化并说明口径 | 需要人工验证
blog-rotary-joint-materials.html | Dust-proof / harsh environment: BP-2P-50-0001 (IP65 rated, 1 MPa) | technical_parameter | medium | 工程参数需要型号、测试条件和最大/连续值定义 | 规格书、图纸、试验条件和批准人 | 保留前先建立证据索引；无法证明时弱化并说明口径 | 需要人工验证
blog-rotary-joint-selection.html | A joint rated for 1.0 MPa gets run at 1.2 MPa. | technical_parameter | medium | 工程参数需要型号、测试条件和最大/连续值定义 | 规格书、图纸、试验条件和批准人 | 保留前先建立证据索引；无法证明时弱化并说明口径 | 需要人工验证
blog-rotary-joint-selection.html | A Glyd Ring seal gets used in a 1,000 RPM application when the spec sheet said 500 RPM max. | technical_parameter | medium | 工程参数需要型号、测试条件和最大/连续值定义 | 规格书、图纸、试验条件和批准人 | 保留前先建立证据索引；无法证明时弱化并说明口径 | 需要人工验证
blog-rotary-joint-selection.html | It is cheaper to specify a 3-channel joint now than to replace a 2-channel joint in 18 months. | certification | high | 企业规模、认证或绝对性能陈述会直接影响采购信任 | 证书、出货记录、客户/国家统计口径、测试报告 | 保留前先建立证据索引；无法证明时弱化并说明口径 | 需要人工验证
blog-rotary-joint-selection.html | Single channel: BP-1P-0003 — threaded mount, compact, rated 1.0 MPa | technical_parameter | medium | 工程参数需要型号、测试条件和最大/连续值定义 | 规格书、图纸、试验条件和批准人 | 保留前先建立证据索引；无法证明时弱化并说明口径 | 需要人工验证
blog-rotary-joint-selection.html | Dual channel: BP-2P-0001 — flange mount, 1.0 MPa, AL6061 body | technical_parameter | medium | 工程参数需要型号、测试条件和最大/连续值定义 | 规格书、图纸、试验条件和批准人 | 保留前先建立证据索引；无法证明时弱化并说明口径 | 需要人工验证
blog-rotary-joint-selection.html | Operating Pressure: The "Max 1.0 MPa" Spec Is Misleading | technical_parameter | medium | 工程参数需要型号、测试条件和最大/连续值定义 | 规格书、图纸、试验条件和批准人 | 保留前先建立证据索引；无法证明时弱化并说明口径 | 需要人工验证
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
