caoguangcheng9-lgtm/begapunk-website/images/knowledge/ptfe-o-rings/supplier-thickness-report.png

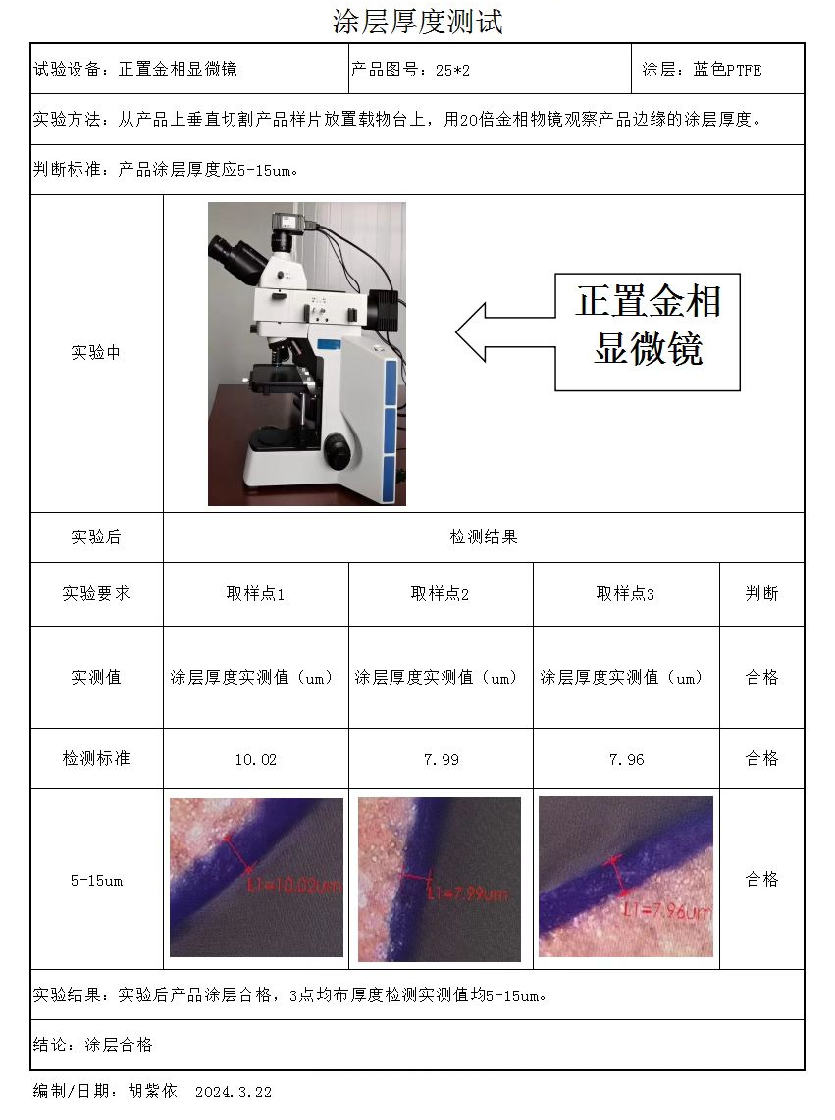
images/knowledge/ptfe-o-rings/supplier-thickness-report.png
