caoguangcheng9-lgtm/begapunk-website/downloads/BP-10P-0001.step

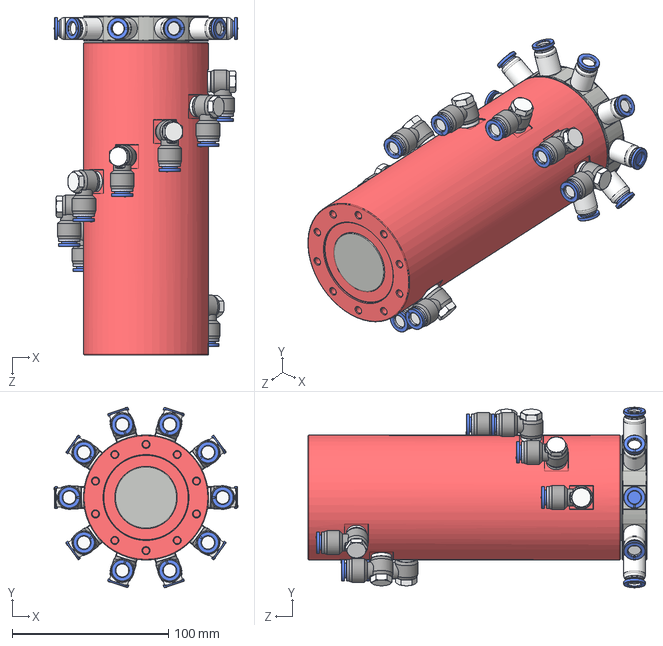
[picture p130: CAD file, 2026-10-07]
downloads/BP-10P-0001.step
117.5 x 115.8 x 217.0 mm
