caoguangcheng9-lgtm/begapunk-website/downloads/BP-2P-130-0001.step

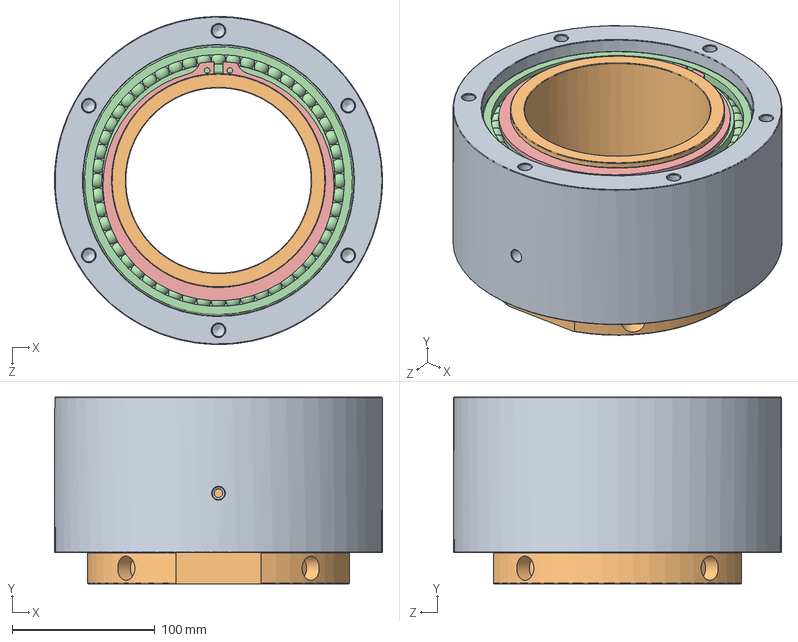
[picture p131: CAD file, 2026-09-02]
downloads/BP-2P-130-0001.step
230.0 x 131.0 x 230.0 mm
BP-2P-130-0001定子
BP-2P-130-0001转子
deep groove ball bearings gb_Rolling bearings 61834 GB 276-94
deep groove ball bearings gb_Rolling bearings 61830 GB 276-94
circlips for shaft--type b gb_GB_CONNECTING_PIECE_RINGS_CSB 150
