caoguangcheng9-lgtm/begapunk-website/downloads/BP-2P-30-0001.step

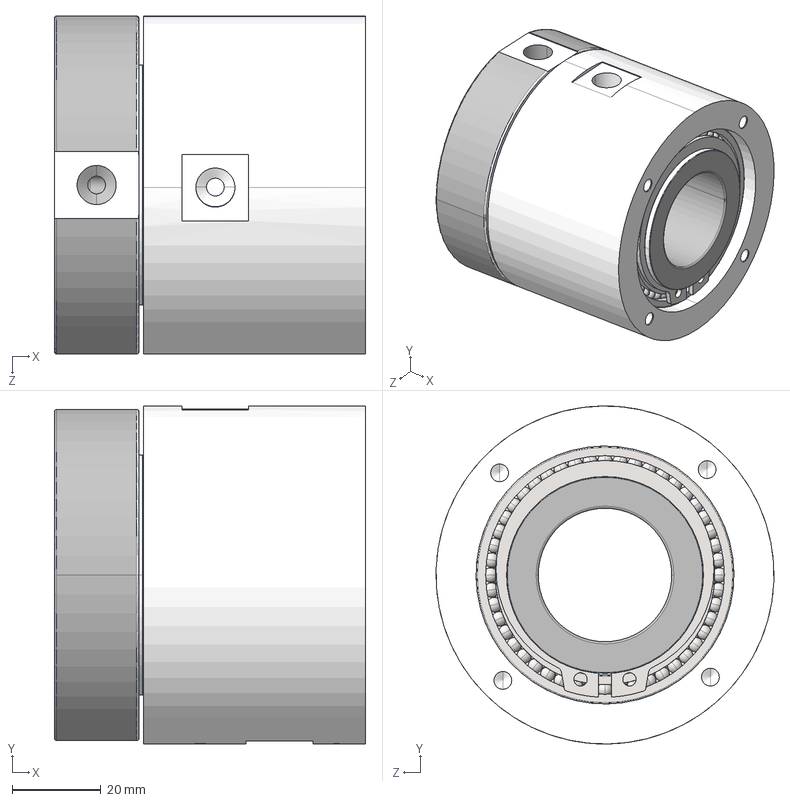
[picture p133: CAD file, 2026-09-02]
downloads/BP-2P-30-0001.step
70.0 x 76.0 x 76.0 mm
湖南中空30转子
湖南中空定子
deep groove ball bearings gb_Rolling bearings 61810 GB 276-94
deep groove ball bearings gb_Rolling bearings 61809 GB 276-94
circlips for shaft--type a large gb_GB_CONNECTING_PIECE_RING_RRA 45
