caoguangcheng9-lgtm/begapunk-website/downloads/BP-8P-0001.step

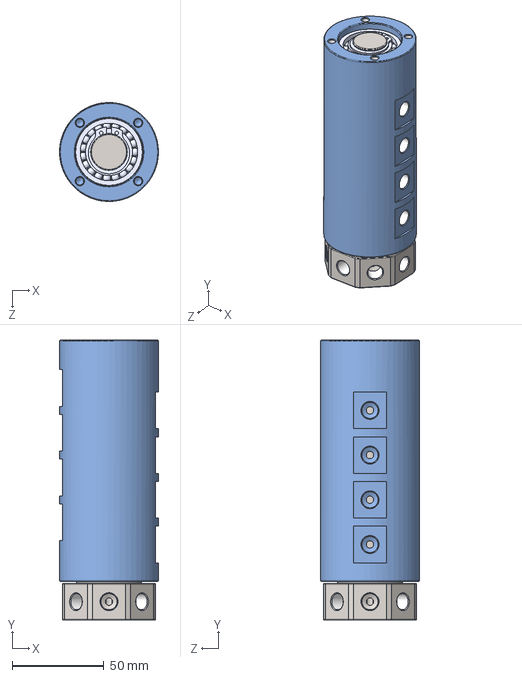
[picture p134: CAD file, 2026-09-02]
downloads/BP-8P-0001.step
54.0 x 152.8 x 54.0 mm
