caoguangcheng9-lgtm/begapunk-website/downloads/BP-3P-0007.step

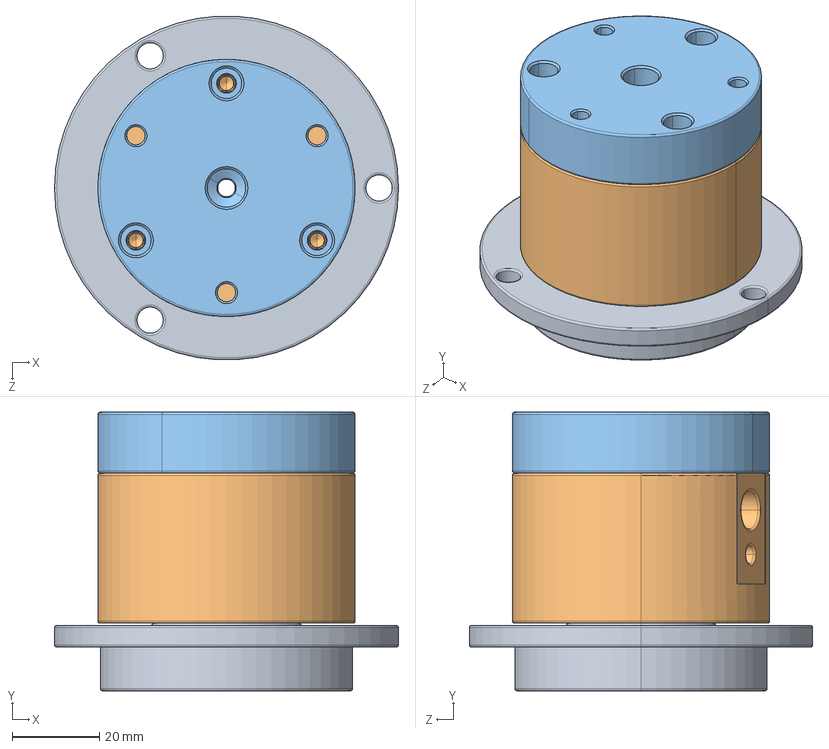
[picture p135: CAD file, 2026-09-02]
downloads/BP-3P-0007.step
78.9 x 63.9 x 78.8 mm
118粣
俋褲
裔赽
