caoguangcheng9-lgtm/begapunk-website/downloads/BP-1P-0006.step

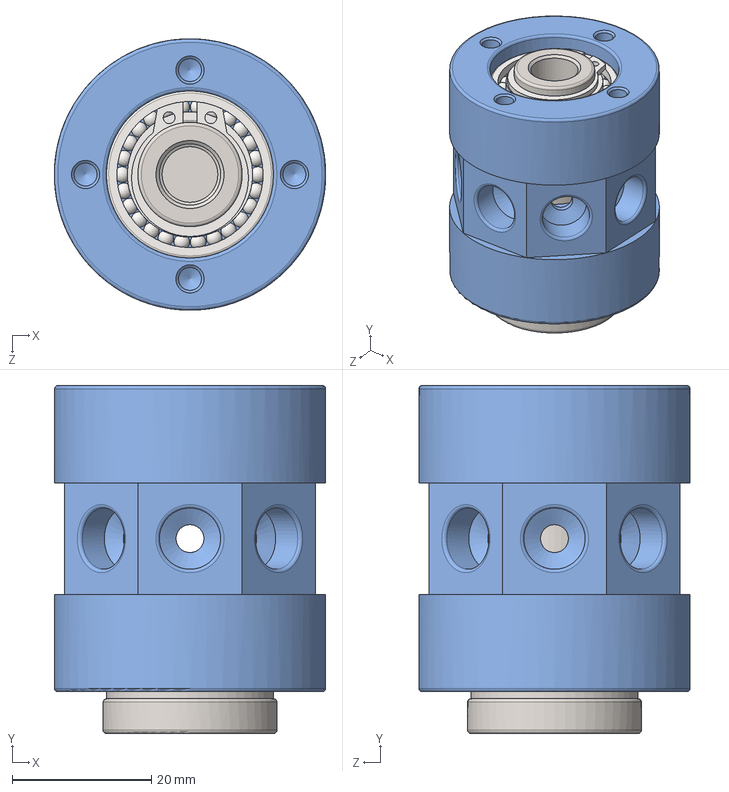
[picture p136: CAD file, 2026-09-02]
downloads/BP-1P-0006.step
39.0 x 50.0 x 39.0 mm
零件2
零件1
deep groove ball bearings gb_Rolling bearings 61804 GB 276-94
deep groove ball bearings gb_Rolling bearings 61802 GB 276-94
circlips for shaft--type a large gb_GB_CONNECTING_PIECE_RING_RRA 15
