caoguangcheng9-lgtm/begapunk-website/downloads/BP-2P-16-0001.step

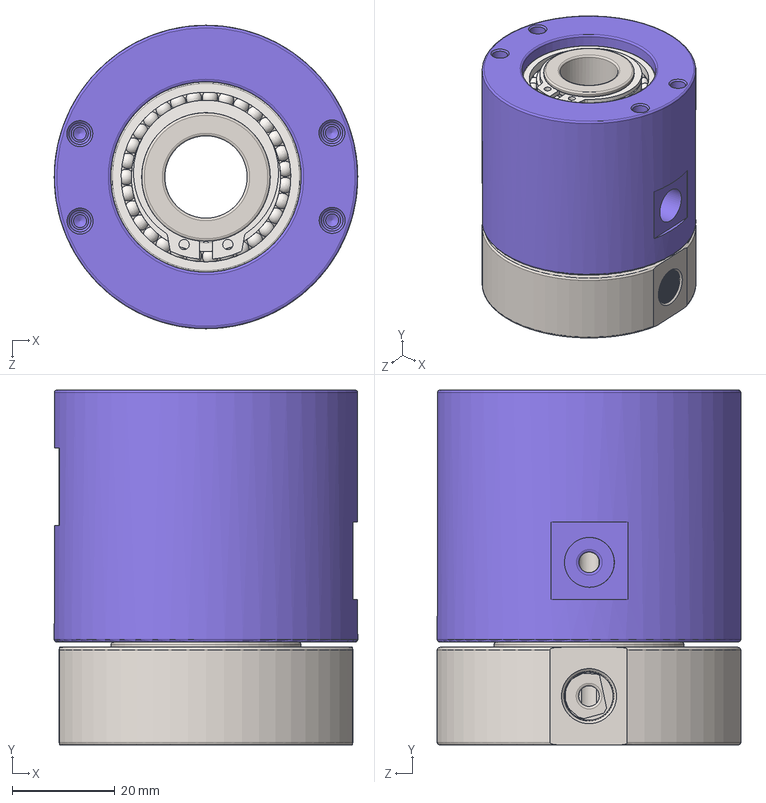
[picture p137: CAD file, 2026-09-02]
downloads/BP-2P-16-0001.step
59.0 x 69.0 x 59.0 mm
湖南中空16
零件3
deep groove ball bearings gb_Rolling bearings 61807 GB 276-94
deep groove ball bearings gb_Rolling bearings 61805 GB 276-94
circlips for shaft--type a large gb_GB_CONNECTING_PIECE_RING_RRA 25
o-rings series g gb_GB-T 3452.1 33.5x1.8-G x 4
hex socket set screws with cone point gb_GB_FASTENER_SCREWS_HSCP M5X4-N x 2
