caoguangcheng9-lgtm/begapunk-website/downloads/BP-3P-S06-0001.step

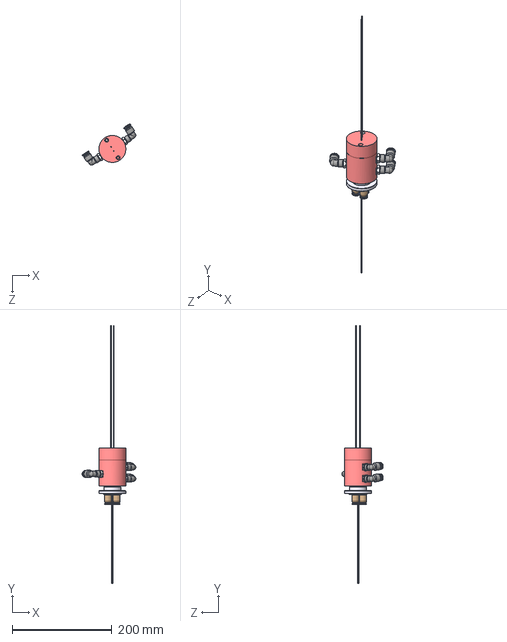
[picture p138: CAD file, 2026-09-02]
downloads/BP-3P-S06-0001.step
107.8 x 517.2 x 83.2 mm
