caoguangcheng9-lgtm/begapunk-website/downloads/BP-1P-0003.step

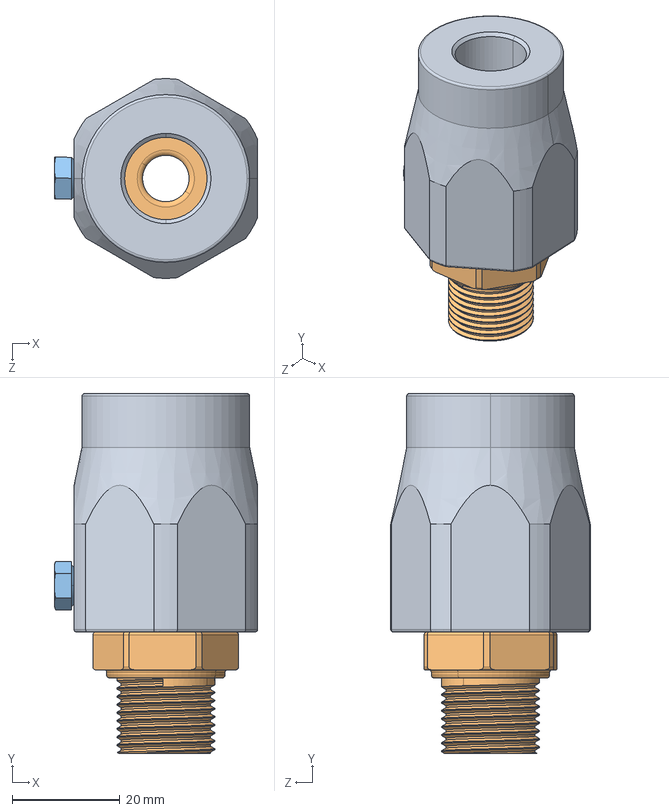
[picture p139: CAD file, 2026-09-02]
downloads/BP-1P-0003.step
37.7 x 66.7 x 37.0 mm
SJ10-06-001.step
SJ10-06-002.step
hexagon head bolts-full thread gb_GB_FASTENER_BOLT_STBAB A M5X10-N.step
