caoguangcheng9-lgtm/begapunk-website/downloads/BP-2P-95-0005.step

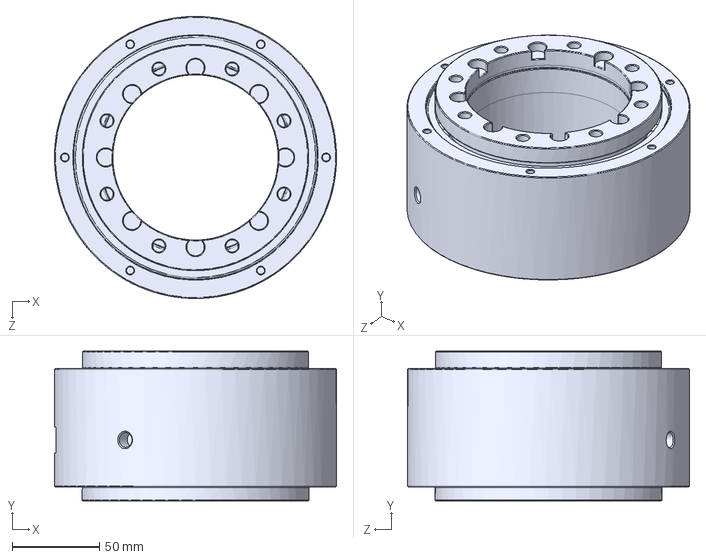
[picture p140: CAD file, 2026-09-02]
downloads/BP-2P-95-0005.step
162.0 x 86.0 x 161.9 mm
