caoguangcheng9-lgtm/begapunk-website/downloads/BP-2P-50-0001.step

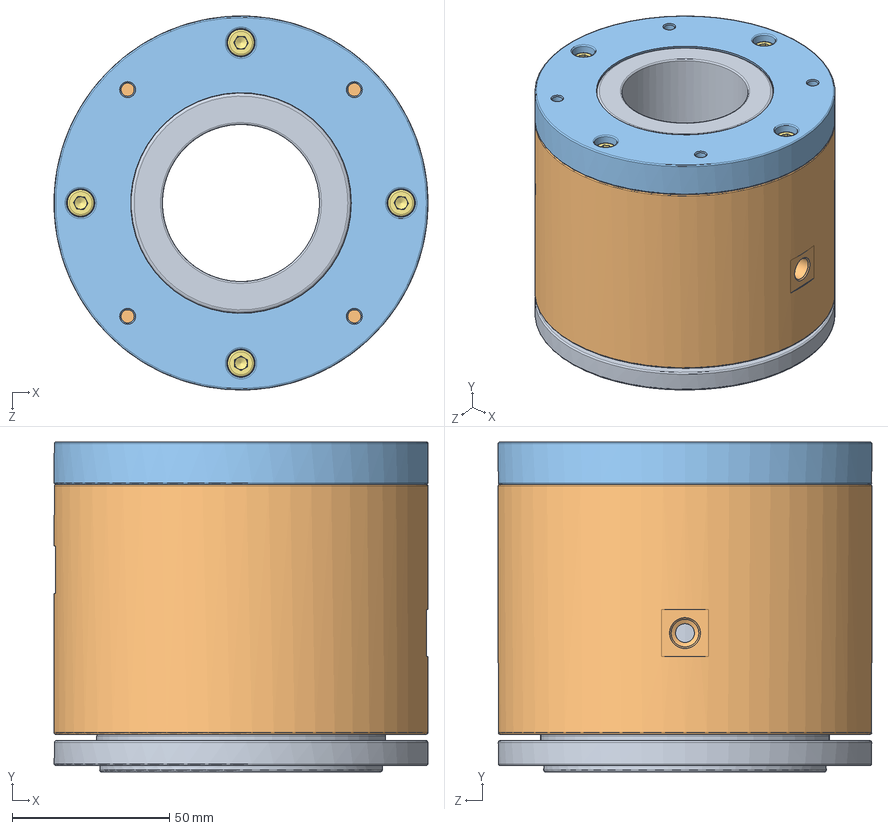
[picture p141: CAD file, 2026-09-02]
downloads/BP-2P-50-0001.step
119.0 x 105.0 x 118.9 mm
零件1
零件12
零件13
circlips for shaft--type a large gb_GB_CONNECTING_PIECE_RING_RRA 70
deep groove ball bearings gb_Rolling bearings 61817 GB 276-94
deep groove ball bearings gb_Rolling bearings 61814 GB 276-94
hexagon socket head cap screws gb_GB_FASTENER_SCREWS_HSHCS M5X12-C x 4
