caoguangcheng9-lgtm/begapunk-website/downloads/BP-2P-08-0001.step

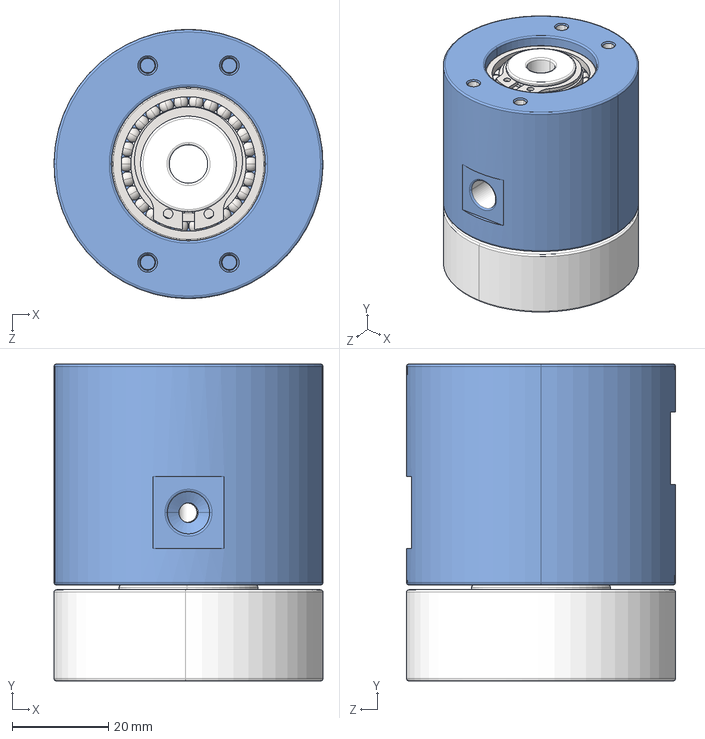
[picture p142: CAD file, 2026-09-02]
downloads/BP-2P-08-0001.step
56.0 x 66.0 x 56.0 mm
