caoguangcheng9-lgtm/begapunk-website/downloads/BP-4P-30-0001.step

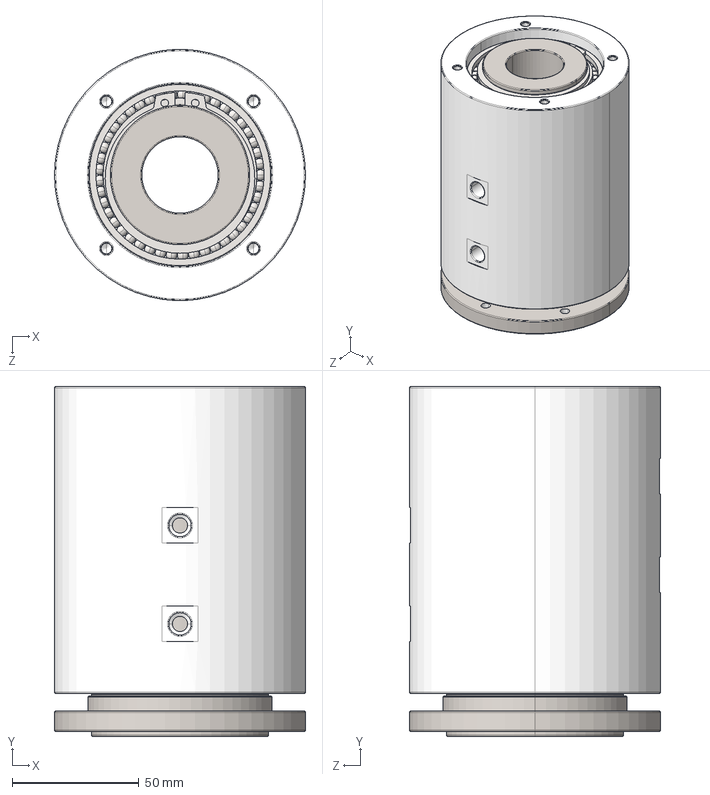
[picture p143: CAD file, 2026-09-02]
downloads/BP-4P-30-0001.step
99.0 x 138.0 x 99.0 mm
錨璃1
deep groove ball bearings gb_Rolling bearings 61813 GB 276-94
deep groove ball bearings gb_Rolling bearings 61811 GB 276-94
錨璃2
circlips for shaft--type a large gb_GB_CONNECTING_PIECE_RING_RRA 55
