caoguangcheng9-lgtm/begapunk-website/downloads/BP-2P-0002.step

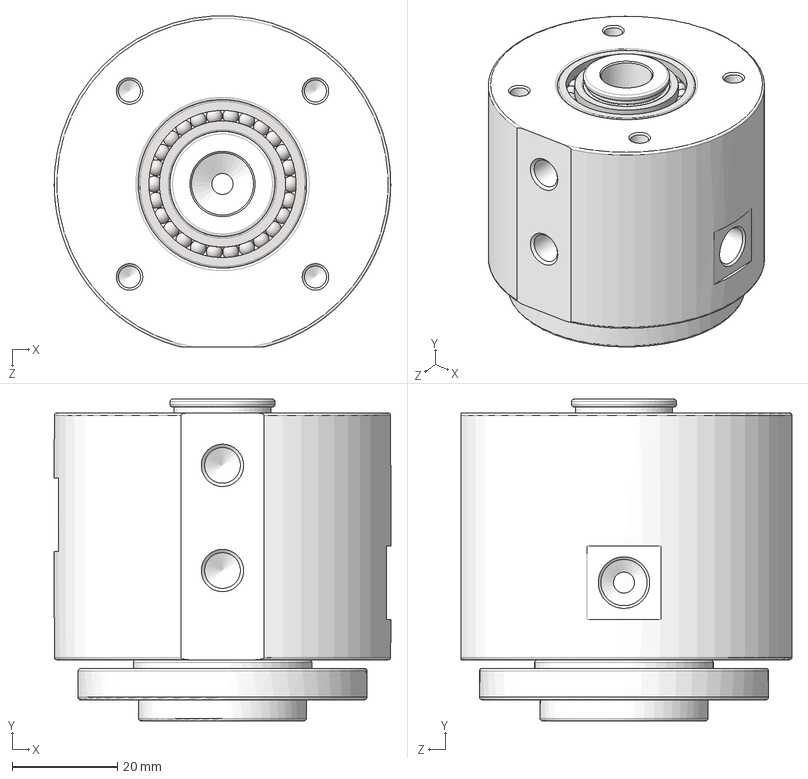
[picture p144: CAD file, 2026-09-02]
downloads/BP-2P-0002.step
64.0 x 61.2 x 62.9 mm
Áã¼þ1
Áã¼þ5
deep groove ball bearings gb(Rolling bearings 61806 GB 276-94)
deep groove ball bearings gb(Rolling bearings 61804 GB 276-94)
