caoguangcheng9-lgtm/begapunk-website/downloads/BP-3P-0006.step

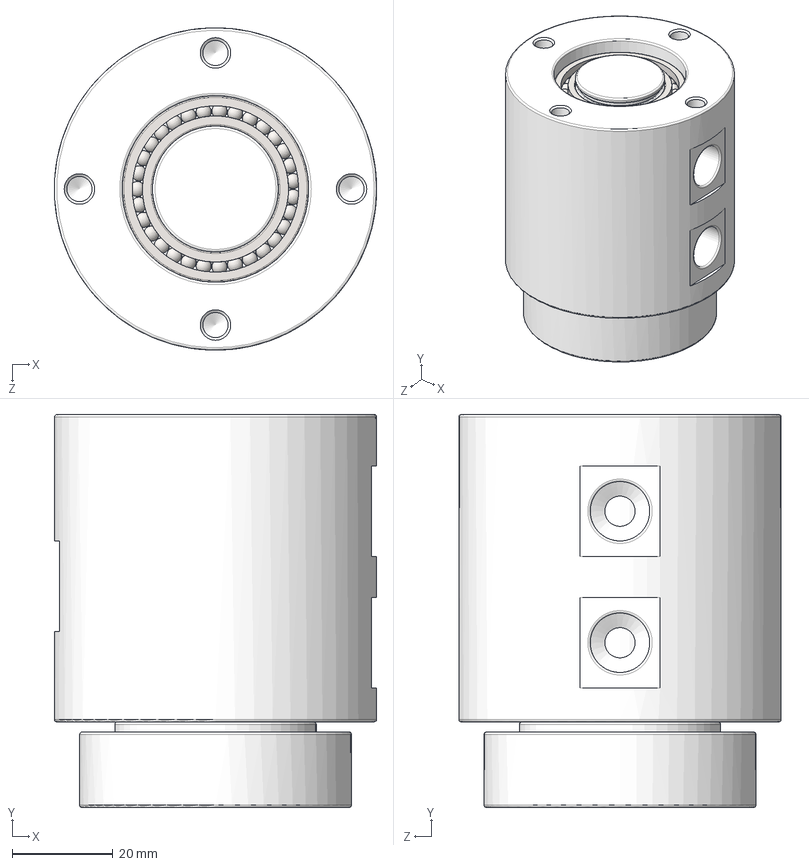
[picture p145: CAD file, 2026-09-02]
downloads/BP-3P-0006.step
64.0 x 78.0 x 64.0 mm
Áã¼þ1
Áã¼þ2
deep groove ball bearings gb(Rolling bearings 61807 GB 276-94)-1
deep groove ball bearings gb(Rolling bearings 61805 GB 276-94)-1
