caoguangcheng9-lgtm/begapunk-website/audit/manufacturing-quality/anodizing-surface-treatment-20260808.md

# Manufacturing & Quality — Anodizing Evidence Record

- Date: 2026-08-08
- Public page: `manufacturing-quality.html` and the `de/`, `ja/`, `ru/` localized editions
- Scope: rotor hard anodizing, stator-housing color anodizing, low-speed O-ring running-surface context, and one photographed coating-thickness reading
- Source authority: owner-provided manufacturing photographs and owner-confirmed construction details

## Approved factual scope

1. The pictured construction uses a hard-anodized aluminum rotor and a color-anodized stator housing.
2. Hard anodizing is described as supporting surface hardness, wear protection, and corrosion protection. For low-speed dynamic O-ring sealing, it may help reduce direct aluminum-surface scratching and groove-wear risk.
3. The stator housing may use a technically available anodized color selected for machine styling or identification, subject to physical-sample approval and normal variation from alloy, preparation, geometry, and process lot.
4. The coating-thickness instrument in the supplied photograph visibly reads `51.7 μm` at the pictured point on one rotor sample.
5. The assembly and batch photographs document visible manufacturing, handling, assembly, and packaging-preparation states only.

## Evidence limits carried into public copy

- `51.7 μm` is a single-part, single-point photographed reading. It is not represented as a whole-part distribution, a batch average, a fixed tolerance, or a specification applying to every model.
- The reading does not by itself prove instrument calibration, wear life, corrosion duration, surface hardness, O-ring life, leakage performance, or test acceptance.
- The photographs do not establish passage count, pressure rating, test result, customer identity, order identity, shipment approval, or in-service performance.
- No MIL Type III compliance, fixed hardness, salt-spray duration, exact RAL/Pantone match, zero wear, maintenance-free operation, or quantified life improvement is claimed.
- Final performance also depends on post-treatment surface roughness, O-ring material, lubrication, media, pressure, speed, alignment, temperature, duty cycle, and contamination.
- Coating build-up must be accounted for in post-treatment dimensions, fits, grooves, ports, and mounting interfaces.

## Photograph-to-claim mapping

| Public asset | Safe use | Not established |
| --- | --- | --- |
| `rotor-stator-anodizing-close-up` | Visible dark rotor and blue stator-housing finish; construction overview | Process certification, performance, exact color |
| `color-anodized-stator-batch` | Batch of blue-finished stator housings on a production rack | Active anodizing process, lot acceptance, color tolerance |
| `hard-anodized-rotor-thickness-check` | Visible `51.7 μm` display value at the pictured point | Whole-part or batch uniformity, calibration, life or corrosion rating |
| `assembled-pneumatic-rotary-union` | Assembled rotary union with air fittings | Passage count, pressure, leakage, PASS result |
| `assembled-rotary-union-batch` | Multiple assembled units prepared for packaging | Customer order, completed inspection, shipment release |

## Public derivatives

All public derivatives were re-encoded without EXIF or ICC metadata. Original attachment files were not modified.

| File | Dimensions | SHA-256 |
| --- | ---: | --- |
| `assembled-pneumatic-rotary-union.jpg` | 720×1280 | `E9663F92D7B335A8F9BB7D6872E1597CB7048D9D7CCD3911207DCB6597400EF3` |
| `assembled-pneumatic-rotary-union.webp` | 720×1280 | `B4B7F0147C4A34DF2231FCC4ED82E2FE606B0415725BCEA265A06C92BF7A357C` |
| `assembled-rotary-union-batch.jpg` | 576×1280 | `BB1377CB75F2B53D238B95D02CC742AC08562A0FEF91C2BFEE9FB5679F849BDD` |
| `assembled-rotary-union-batch.webp` | 576×1280 | `A473830A5B4C28F088B571FAE2A4994DE192E423B6709AF65375D08A903B6BDE` |
| `color-anodized-stator-batch.jpg` | 720×1280 | `458956AB17D18A9F8EB01AD4FAEB959EBFC87360E050FE26D0A159081C7D76CE` |
| `color-anodized-stator-batch.webp` | 720×1280 | `AF28D014E663937C6907BD973E92B84ADC3E2E115BBCD4F05015BEF4BFE9CCF9` |
| `hard-anodized-rotor-thickness-check.jpg` | 720×1280 | `3EA5D93686202923DE59191FDBBF0D5DD6DEB03932C753DAC297926F83FDF6EA` |
| `hard-anodized-rotor-thickness-check.webp` | 720×1280 | `0B17D98E8330CAE9A04A99F7059B0E4B0C9D8A7CC502AC079B8BFEBC25AE6F09` |
| `rotor-stator-anodizing-close-up.jpg` | 720×1280 | `16AC65D8875A97F7FED5E267FE0BCAF0308476312075B50C632C6FBB81F7B7C7` |
| `rotor-stator-anodizing-close-up.webp` | 720×1280 | `A05388BA4A5B561F1709BC63F6210C121B1BCBF1E699E7B9F721F278664704C7` |

## Localization terminology

- German: `harteloxierter Rotor`, `farbeloxiertes Statorgehäuse`, `Schichtdicke`
- Japanese: `硬質アルマイト処理ロータ`, `カラーアルマイト処理ステータハウジング`, `アルマイト皮膜厚さ`
- Russian: `ротор с твёрдым анодированием`, `корпус статора с цветным анодированием`, `толщина анодного покрытия`

Localized pages use native industrial terminology and repeat the single-point evidence boundary. They are recorded as editorial work in progress until fresh browser rendering can be reviewed.

## Localization maintenance state

The four public HTML editions are hand-localized and covered by `i18n:refresh-metadata`, `i18n:verify`, localized SEO files, search indexes, `llms.txt`, and the multilingual sitemap. They are intentionally recorded as `inProgress` until native editorial and fresh browser-render review are complete.

Do not run a full `npm run i18n:build` as a regeneration step yet. The translation source catalog and caches also predate the two hand-localized application-case pages already present in this branch. Before the next full localized rebuild, ingest those pending pages and this page into `i18n/source-catalog.json`, the language caches, and editorial mappings. This maintenance limit does not affect the current hand-authored pages or the verified production package.
