caoguangcheng9-lgtm/begapunk-website/audit/manufacturing-quality/stator-machining-process-20260808.md

# Stator machining process audit — 2026-08-08

## Scope

This change adds one stator-manufacturing module to the existing Manufacturing & Quality page in English, German, Japanese and Russian. It does not create a new public URL, alter navigation, change product specifications, or change the established rotor and production leak-testing claims.

Evidence source: Begapunk factory confirmation supplied by the project owner on 2026-08-08.

## Owner-confirmed process facts

- Standard stator-housing material: 6061 aluminum; 7075 aluminum is an option only when specified by the customer.
- Machining: 4-axis turn-mill machining in two setups, including reverse and reclamp.
- Inspection after machining: dimensional sample inspection.
- Finishing: external color anodizing; color is controlled against the approved sample.
- Approximate color-anodizing thickness: about 0.005 mm (approximately 5 µm).
- Coating control: supplier coating check followed by Begapunk incoming sample inspection.
- Machining tolerances account for expected coating growth.
- After final assembly, every finished rotary union and every passage enters the existing 100% production leak-testing process.

The approximately 5 µm stator color-anodizing statement is separate from the photographed 51.7 µm single-point reading in the existing hard-anodized rotor section. The latter remains explicitly limited to one photographed part at one measured point and is not presented as a batch specification.

## Evidence boundary

The three images document billet preparation, a turn-mill machining scene and stator housings before anodizing. They do not establish a customer order, a specific product model, complete process capability, batch-wide coating thickness, certification, service life, or final product performance. The process text relies on the project owner's factory confirmation, not on inferences from the photographs alone.

## Public image preparation

| Public file | Source | Public dimensions | Public SHA-256 | Processing and metadata result |
| --- | --- | ---: | --- | --- |
| `stator-cut-billets-4x5.jpg` | `E:\Downloads\Screenshot_2026-08-08-15-42-43-801_com.tencent.mm.jpg` (`1D8BC53ED9B6C023A9CF3C8E5876F9535DFEC6A309253A1C72FA21296FE0EC4F`) | 864×1080 | `D89ACE1AAB2C41611D6B4DBA8894AA7C31249BD651F30AE2A061C8DAB04FA441` | Source crop `left=0, top=280, width=1080, height=1350`; interface controls and progress UI excluded by cropping; metadata scan clear. |
| `stator-cut-billets-4x5.webp` | Same source and crop | 864×1080 | `AE83D66AA68EBDED3A5ACD43B4270205ED52581EB9259DA2CE1772B437F85D78` | WebP re-encode; metadata scan clear. |
| `stator-turn-mill-machining-4x5.jpg` | `E:\Downloads\1786173182858.jpg` (`346C096709104C766ECF756A338ED61BE071B40813C763766BBE84756BDBE7C3`) | 864×1080 | `E0894F3744B1FEB2053BDCDA66CFB4AB2EB52131C2483866E8356E952194288F` | Source crop `left=1220, top=0, width=2240, height=2800`; workpiece, clamping area and tool turret retained; bottom device/date watermark excluded by cropping; metadata scan clear. |
| `stator-turn-mill-machining-4x5.webp` | Same source and crop | 864×1080 | `758DDEA8E20406399A3795037258F23BF154DD8704B92B502DFF3D3F18797526` | WebP re-encode; metadata scan clear. |
| `stator-before-anodizing-4x5.jpg` | `E:\Downloads\wx_camera_1670911851858.jpg` (`9CD3BF6D60D75BD1C1BBB326FEE3975E0737FA023066A861720C89C9B62BC4E8`) | 864×1080 | `C3C41D7C3563854E4EBE3A49CB397342D0D953538ADE9E841F449A8589E31E24` | Crop only to 4:5 around the stator housings; re-encoded without EXIF, GPS, XMP, IPTC or ICC. |
| `stator-before-anodizing-4x5.webp` | Derived from the cropped JPG | 864×1080 | `80B722BD2B796F7C2474D27CC299E3E425ED9591F83F1437EB42AE58A5AB6117` | WebP re-encode; metadata scan clear. |

All six public files are 864×1080 (4:5). No original download image was copied into the repository, overwritten or published directly. No generative or content-altering image operation was used. The existing before-anodizing JPG/WebP pair was verified and kept byte-for-byte unchanged.

## Four-language implementation

| Language | Approved module heading | Editorial status |
| --- | --- | --- |
| English | From Aluminum Billet to Color-Anodized Stator Housing | Source copy implemented |
| German | Vom Aluminium-Rohling zum farbeloxierten Statorgehäuse | `inProgress` pending native-language final acceptance |
| Japanese | アルミ丸棒材からカラーアルマイト処理済みステータハウジングまで | `inProgress` pending native-language final acceptance |
| Russian | От алюминиевой заготовки до корпуса статора с цветным анодированием | `inProgress` pending native-language final acceptance |

The German, Japanese and Russian module copy is stored in the existing editorial mapping files so a future localized metadata refresh does not replace the reviewed wording. Search records for `manufacturing-quality.html` include localized stator-machining, turn-mill, 6061/7075, color-anodizing and manufacturing-process concepts.

## Verification record

- `npm run i18n:verify`: PASS, 220 localized/source pages.
- `npm run products:validate`: PASS, 16 models across four languages.
- `npm run quality:source`: PASS.
- `npm run images:verify`: PASS, including all six new public image variants.
- `npm run claims:verify`: PASS after adding a narrowly scoped allowance for the approved Manufacturing & Quality link to the existing 100% production leak-testing evidence page.
- `npm run quality`: PASS; release validation reported 221 HTML files, 669 release files and 24 verified public downloads.
- New billet and turn-mill crops were generated directly from the original source photographs, not from prior public derivatives.
- Generated image dimensions and metadata scan: PASS; no EXIF, GPS, XMP, IPTC or ICC detected.
- Canonical, hreflang, JSON-LD, local-link and search-index validation: PASS.
- Browser, local HTTP, English: PASS at 1440, 1180, 1024, 900, 768, 430 and 390 CSS pixels.
- Browser, local HTTP, German/Japanese/Russian: PASS at 1440 and 390 CSS pixels.
- Browser module checks: exactly three loaded images, four process steps, localized headings, `object-fit: contain`, correct natural dimensions and no image stretching.
- Responsive layout: three equal-height 4:5 cards at 1440/1180; two columns with the third card centered at matching column width at 1024/900/768; one column at 430/390. No horizontal overflow after allowing the long Russian leak-testing CTA to wrap below 700 px.
- Mobile navigation: PASS in all four languages at 390 px; localized labels, open/close, Escape focus return and scrollable menu verified. Header remains above the floating CTA.
- The leak-testing process link was followed successfully in all four languages.
- Browser console errors: 0.
- Existing hard-anodized rotor module and its 51.7 µm single-part, single-point evidence boundary remain present and separate from the stator process.
- `catalog-project/`: not modified or staged.
- Commit/push/deployment: not performed.

The module is technically and visually verified. German, Japanese and Russian editorial status remains `inProgress` until the project's separate native-language acceptance step is completed.

## Final 4:5 revalidation

- Revalidated the public module on `http://127.0.0.1:8899/` after replacing the first two landscape derivatives with the approved 864×1080 (4:5) crops.
- English responsive checks passed at 1440, 1180, 1024, 900, 768, 430 and 390 CSS pixels. The gallery is three columns above 1100 px, two columns with a centered third card from 701–1100 px, and one column at 700 px and below.
- German, Japanese and Russian checks passed at 1440 and 390 CSS pixels. Each localized page loaded three 864×1080 images with `object-fit: contain`, localized captions and zero horizontal overflow.
- The English mobile menu was exercised at 390 px: open/close, Escape focus return, scroll-to-final-link and header-over-floating-CTA stacking all passed.
- The stator-module link to `production-inspection-testing.html` was followed successfully and resolved to the existing production leak-testing page.
- Browser console errors: 0.
- Representative evidence is stored in `audit/manufacturing-quality/screenshots-stator-4x5/`, including English 1440/1024/900/390 views, English mobile menu states, and German/Japanese/Russian 1440/390 module views.
- The four obsolete landscape derivatives were deleted only after repository references reached zero.
- No product parameters, server files or production content were changed. No staging, commit, push or deployment was performed.
