caoguangcheng9-lgtm/begapunk-website/audit/localization/2026-11-09-operations-engineering-title-review.md

# Operations and Engineering Manager title review

reviewedAt: 2026-11-09T04:39:45.982Z
reviewedByRole: AI-assisted technical and target-market semantic reviewer
reviewMethod: Reviewed the five-language homepage and About-page changes that replace the founder wording for GuangCheng Cao with the approved Operations & Engineering Manager title and replace the Organization founder node with an employee Person. Checked the visible team-card title, localized schema jobTitle, Person ID, worksFor relation, existing social profile reference and absence of founder fields. This is AI-assisted review and does not claim native-speaker or human sign-off.
reviewType: ai-assisted-target-market-semantic-review
semanticReviewPerformed: true
nativeSpeakerReviewPerformed: false
page: index.html and about.html in English, German, French, Japanese and Russian
language: en, de, fr, ja, ru
referenceUrls: ["https://schema.org/employee","https://schema.org/Person"]
referenceAccessDates: ["2026-11-09","2026-11-09"]
terminologyDecisions: ["EN uses Operations & Engineering Manager.","DE uses Betriebs- und Engineering-Manager.","FR uses Responsable opérations et ingénierie.","JA uses オペレーション・エンジニアリング責任者.","RU uses Менеджер по операциям и инженерии.","GuangCheng Cao remains the employee name; no Owner, CEO, Managing Director or Legal Representative title is introduced."]
searchIntentDecisions: ["The title now describes an operations and engineering function without asserting a founder or corporate-registration role.","The Person entity remains linked to the Organization through worksFor while the company LinkedIn profile remains an Organization brand reference."]
unresolvedIssues: []
blockingIssues: []
reviewedArtifactPaths: ["de/index.html","de/about.html","fr/index.html","fr/about.html","ja/index.html","ja/about.html","ru/index.html","ru/about.html"]
reviewedArtifactTransitions: [{"path":"de/index.html","beforeSemanticSha256":"473cede81d1f6b8aa86ee1ee5b3e9ad47b5de48c4297bd46452a3bc311f92a96","afterSemanticSha256":"95013caefb50aef016ee59e7b0f8a68e3f94bff5486a1d803d974bd25ecf8c3a","beforeMechanicalSha256":"6a48335ebfd10a2c06bfb9a28744ec16366eeb66b2dec664f993f00fc69a5c47","afterMechanicalSha256":"4072d0400ed7b826330cc2a3d050ce4b43862bca3f915f074c099d5370fba59a"},{"path":"de/about.html","beforeSemanticSha256":"e84190293cecc22ac9c7bca9525d35d975a39bf1e2d6c02dd58ed9dfe65cb309","afterSemanticSha256":"572fc0915be1c1f352f3416ba116bf2742d598b4d8bb0e490547a805d91c68e4","beforeMechanicalSha256":"5f3fc7492a058b1fd2b0bc330e74653c61dcadcfc0c350e9b6d169d08765fbee","afterMechanicalSha256":"d0894c11f293d7c3a43be5a72681b734b97e34558d7f6e92051464cb4da49a2a"},{"path":"fr/index.html","beforeSemanticSha256":"475381b9dd19f118e79c0b342247be74d5f551da3eccb19ebb6b1a3ab9d7d6e5","afterSemanticSha256":"e8f0bf731317b861c9398c4c642270ad4d98c0ebb198a44464b0d435bc01ff39","beforeMechanicalSha256":"5886aabac58a56323e83595e47b92b4b4564b57282b5ef4117098b3cb11f6c49","afterMechanicalSha256":"4b171422b49c9102791764ac7cb9a89a83f43a98e1f1989fc51f39f63c3b2329"},{"path":"fr/about.html","beforeSemanticSha256":"f5c136cc3acdb82d5c8b0c6fe9f094f1700291507cdae7977475bd6c2a9d214f","afterSemanticSha256":"403e490177416d25948d2177f801f7d542ff3c9506a15e7774256dbc140d7c46","beforeMechanicalSha256":"405e49a12ebd426653443ad23f3a032e90a18c9d4f75c43c70379bff6028a351","afterMechanicalSha256":"fb2ec507a700eb4421c006bb8e4a1a21452de2f1e6132ca18bcdeb5ff1d3280c"},{"path":"ja/index.html","beforeSemanticSha256":"b36a9277ec4d415df44110456ea4d2ec67bb71cdc505484d43a990a4d82ddcd0","afterSemanticSha256":"7a25a379cabf41ec54c995ae2af9bdb0587bf43416a46746418ca911c92e0a08","beforeMechanicalSha256":"828b8913a6400a5d1cfdcb0985784f0113031c5eb9516df0fc73d9208c196d3d","afterMechanicalSha256":"f624916a01bb36ac916d9f70abbad4942bb0bf5c0320ec007834a413019d0b04"},{"path":"ja/about.html","beforeSemanticSha256":"acf6eb0be81f389b76060a5c68fa61dabf6fe0e83700a080b5858e45cd7a3c6c","afterSemanticSha256":"768f2447045d27dfdcd00ecbe0ce848f5e7e160b055ec8a9e7132d9e06dc9646","beforeMechanicalSha256":"dfbec1ad1e6206a6e4f0b75d466a69d413ccf6b5c4041a1c580c0b7bce9fe509","afterMechanicalSha256":"1f48a4123ea7cb96041ef18fd76018c73f38cfeca8ebbd3fc680db3eafd81aeb"},{"path":"ru/index.html","beforeSemanticSha256":"d9d8e6bf338a579bf02b1827ca6527aa55e4b882f7f232bc7419a5bde74ea142","afterSemanticSha256":"5b1237d7c1213be51cdd948ba6c5328b67234ed4e2d38bca6e467ed17e0880e3","beforeMechanicalSha256":"9360e3a0a2a21d950331af67dd8479d54a922f9fc1067e3cb055010cb31d8551","afterMechanicalSha256":"9180deb53fa43a96a9f252ec2871900f53620c2762a95e206b02ef9688014fc4"},{"path":"ru/about.html","beforeSemanticSha256":"d0d738fd5d08e408e462bd3cd5777dc83de729a175a4c25a9ac227bd29ab4c1b","afterSemanticSha256":"d5f78b50ceacd0c7d064e29f39bb84d04b06dcc291202a52ae825561bb466dab","beforeMechanicalSha256":"8bd02c493741b6562785323f9af2db9d844331c931f119f99608b496bf94c1d9","afterMechanicalSha256":"062c97d6c664e7af605c6ecb4bdda7e1ce65b6d395aba94f163d7f4e079890ed"}]

## Result

No blocking semantic issue was identified. The same title and Person schema boundary is used across all five languages.
