caoguangcheng9-lgtm/begapunk-website/audit/manufacturing-quality/screenshots-stator-4x5/de-manufacturing-quality-390-module.png

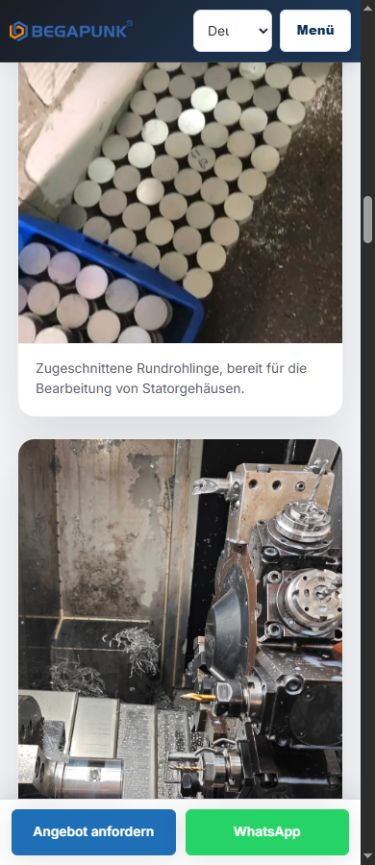
audit/manufacturing-quality/screenshots-stator-4x5/de-manufacturing-quality-390-module.png
