caoguangcheng9-lgtm/begapunk-website/audit/manufacturing-quality/screenshots-stator-4x5/en-manufacturing-quality-390-menu-open.png

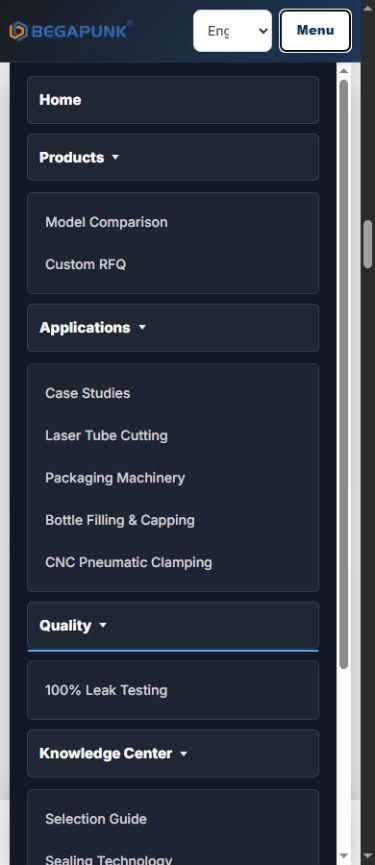
audit/manufacturing-quality/screenshots-stator-4x5/en-manufacturing-quality-390-menu-open.png
