caoguangcheng9-lgtm/begapunk-website/audit/manufacturing-quality/screenshots-stator-4x5/ru-manufacturing-quality-1440-module.png

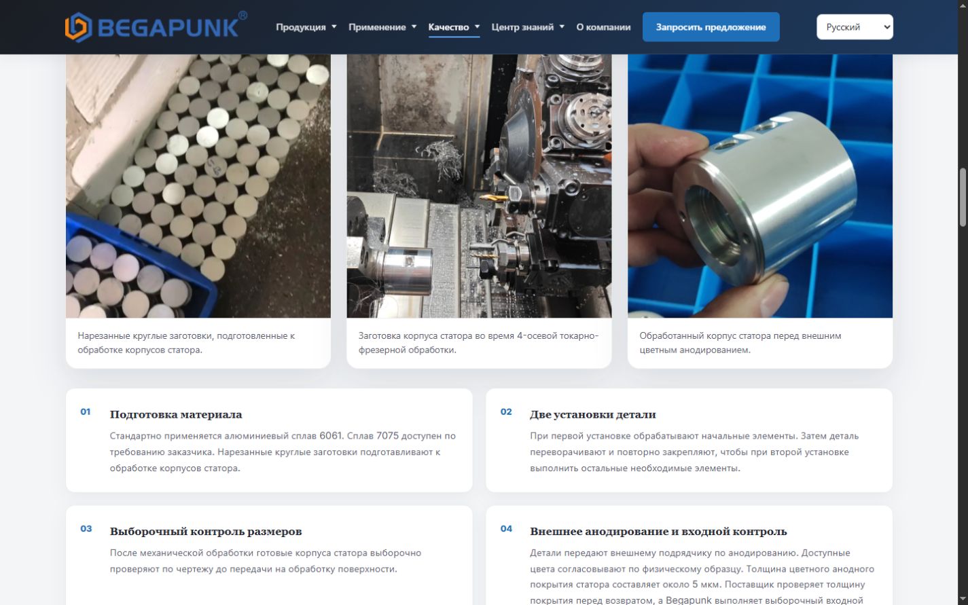
audit/manufacturing-quality/screenshots-stator-4x5/ru-manufacturing-quality-1440-module.png
