caoguangcheng9-lgtm/begapunk-website/images/cases/bp-2p-95-pneumatic-chuck/bp-2p-95-chuck-assembly-overview.jpg

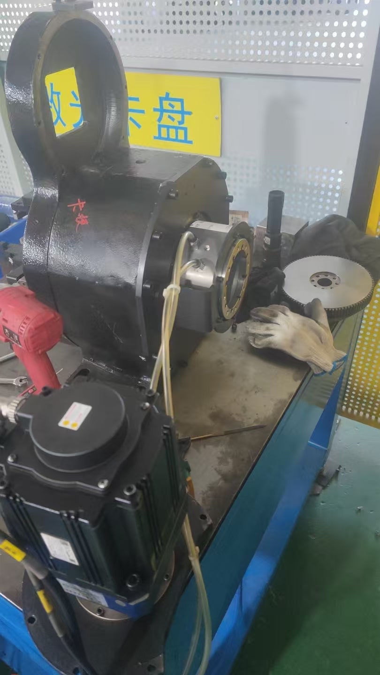
images/cases/bp-2p-95-pneumatic-chuck/bp-2p-95-chuck-assembly-overview.jpg
