caoguangcheng9-lgtm/begapunk-website/images/manufacturing-quality/anodizing/assembled-pneumatic-rotary-union.jpg

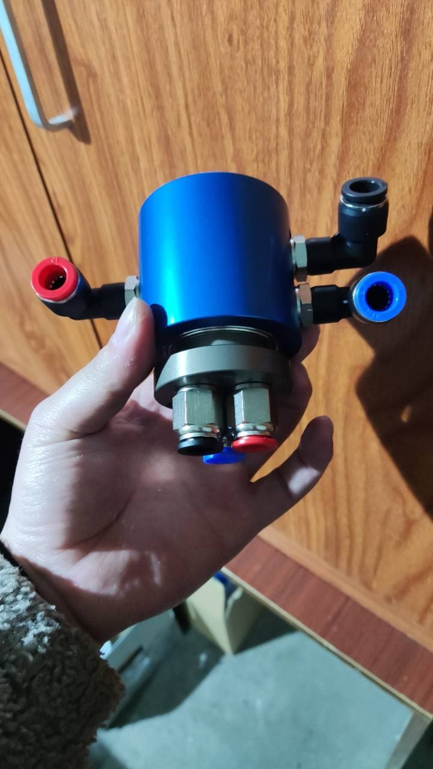
images/manufacturing-quality/anodizing/assembled-pneumatic-rotary-union.jpg
