caoguangcheng9-lgtm/begapunk-website/images/manufacturing-quality/anodizing/assembled-rotary-union-batch.jpg

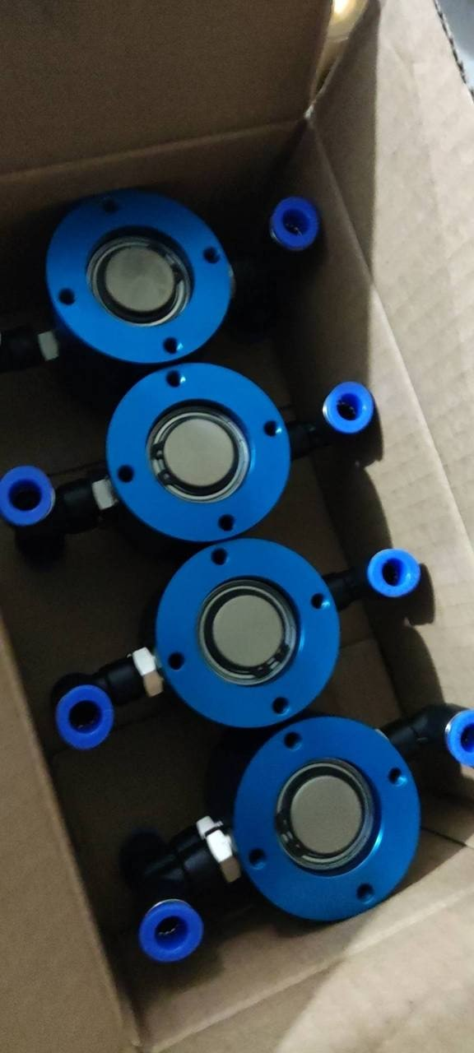
images/manufacturing-quality/anodizing/assembled-rotary-union-batch.jpg
