caoguangcheng9-lgtm/begapunk-website/images/manufacturing-quality/anodizing/color-anodized-stator-batch.jpg

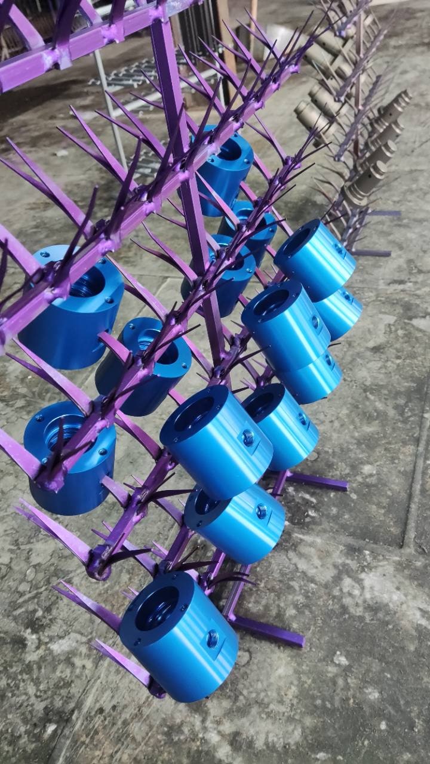
images/manufacturing-quality/anodizing/color-anodized-stator-batch.jpg
