caoguangcheng9-lgtm/begapunk-website/images/manufacturing-quality/anodizing/hard-anodized-rotor-thickness-check.jpg

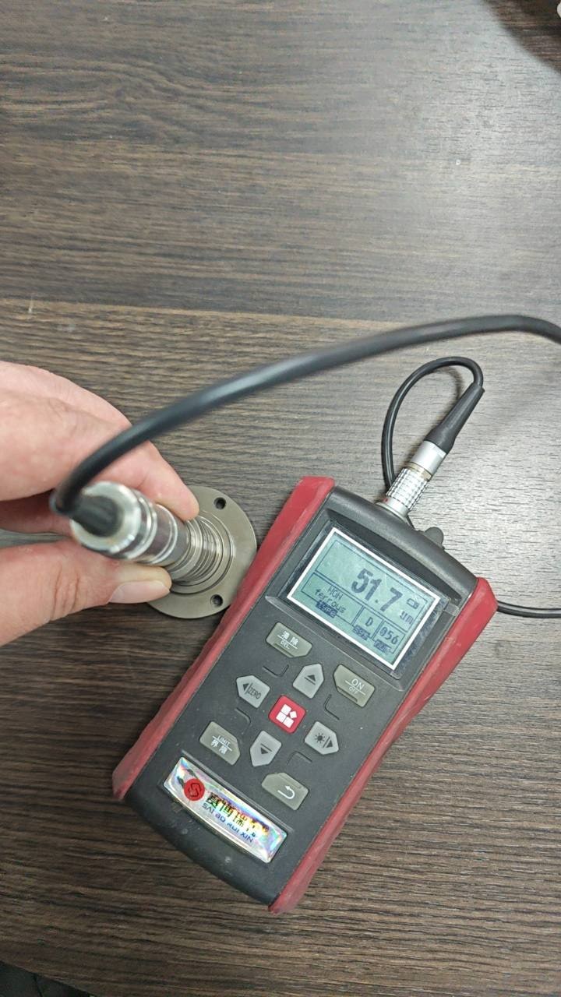
images/manufacturing-quality/anodizing/hard-anodized-rotor-thickness-check.jpg
