caoguangcheng9-lgtm/begapunk-website/images/manufacturing-quality/anodizing/rotor-stator-anodizing-close-up.jpg

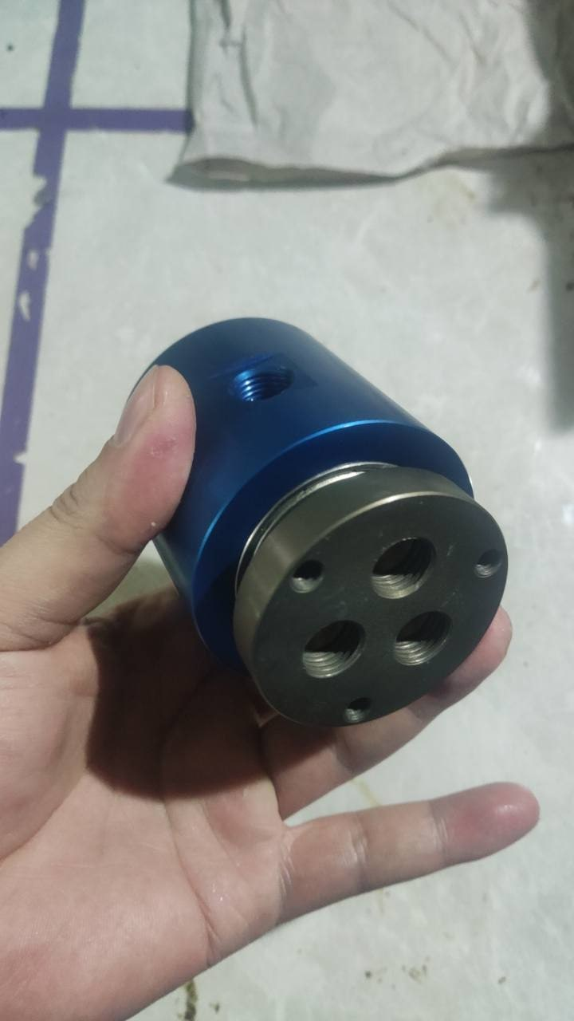
images/manufacturing-quality/anodizing/rotor-stator-anodizing-close-up.jpg
