caoguangcheng9-lgtm/begapunk-website/images/manufacturing-quality/production-inspection/assembled-units-in-inspection-queue.jpg

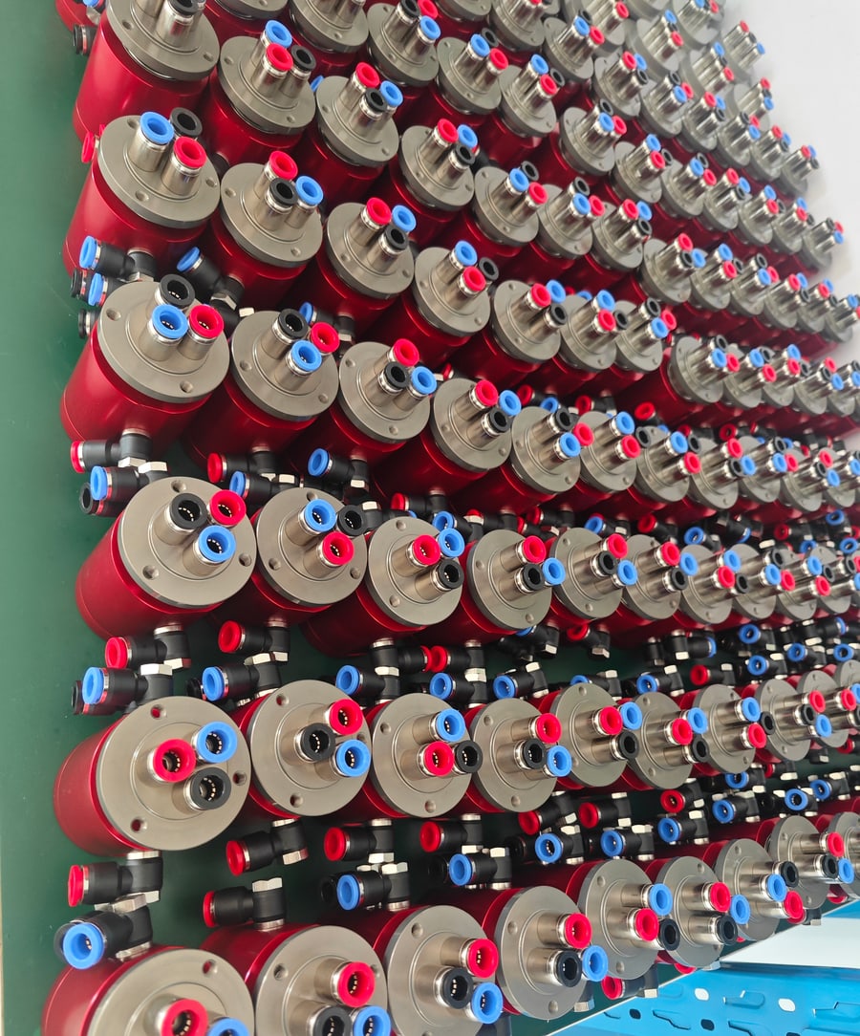
images/manufacturing-quality/production-inspection/assembled-units-in-inspection-queue.jpg
