caoguangcheng9-lgtm/begapunk-website/images/manufacturing-quality/production-inspection/rotary-unions-awaiting-inspection.jpg

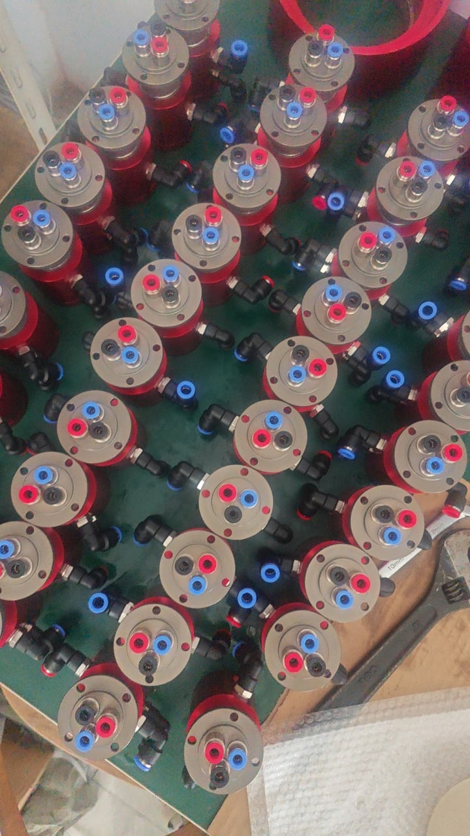
images/manufacturing-quality/production-inspection/rotary-unions-awaiting-inspection.jpg
