caoguangcheng9-lgtm/begapunk-website/images/manufacturing-quality/stator-machining/stator-before-anodizing-4x5.jpg

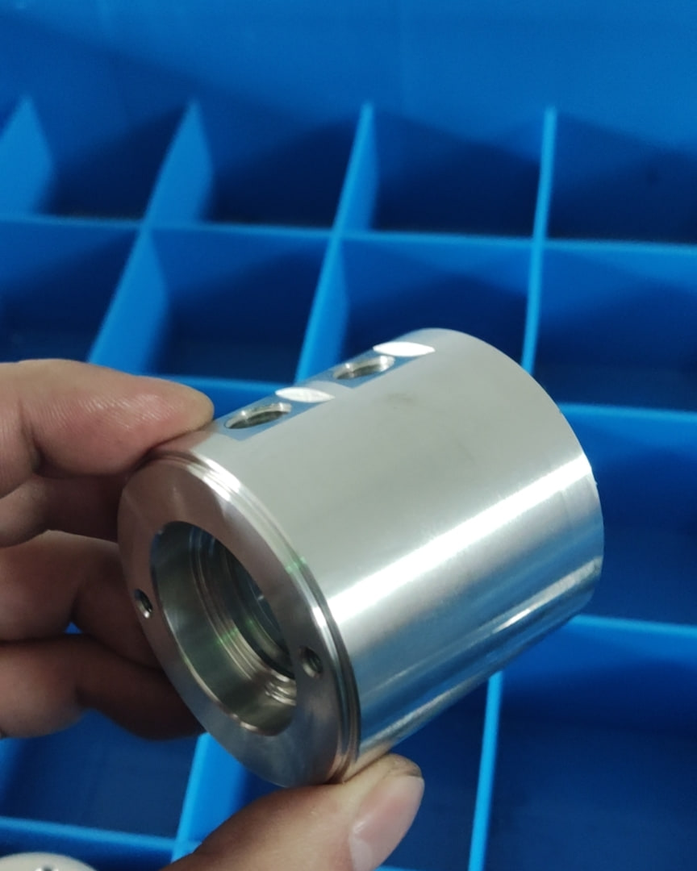
images/manufacturing-quality/stator-machining/stator-before-anodizing-4x5.jpg
