caoguangcheng9-lgtm/begapunk-website/images/manufacturing-quality/stator-machining/stator-cut-billets-4x5.jpg

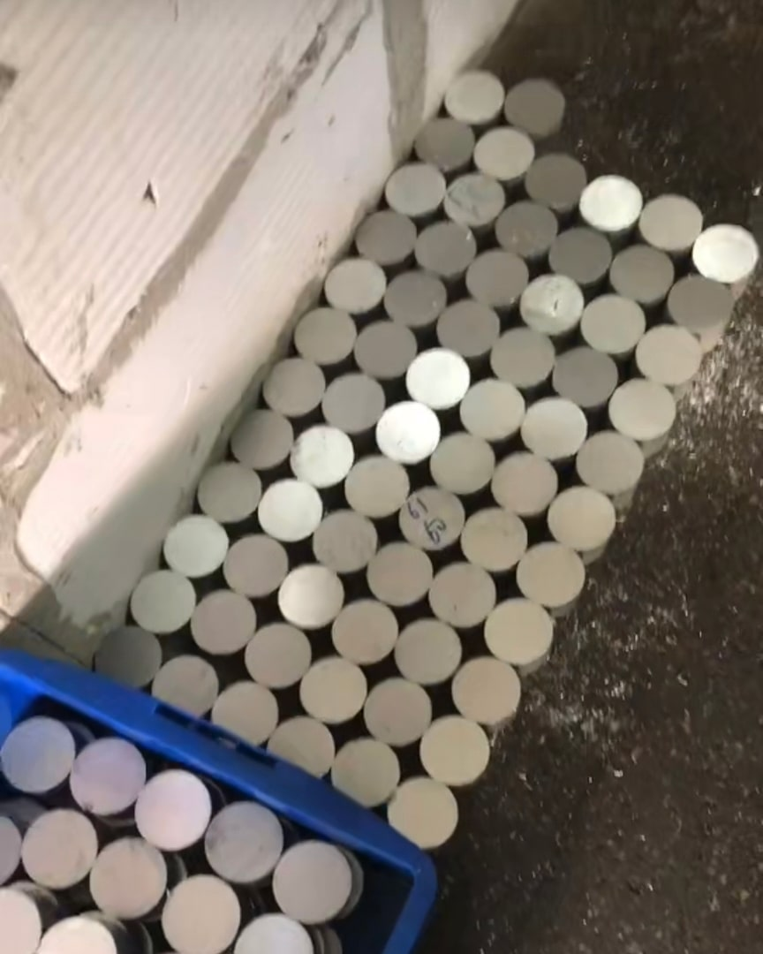
images/manufacturing-quality/stator-machining/stator-cut-billets-4x5.jpg
