caoguangcheng9-lgtm/begapunk-website/audit/technical-repairs/phase-1d/js-syntax-validation.csv

page | script_location | original_error | repair_method | syntax_check | remaining_warning
blog-rotary-joint-selection.html | inline script at end of body, original lines 600-635; error line 619 | SyntaxError: Unexpected token ',' at orphaned ', 2000);' callback tail | Reconstructed the complete guarded menu logic and copyLink function using the site's intact article implementation; retained header scroll only where originally present; added Clipboard rejection fallback and stable two-second feedback restoration. | pass: Node vm.Script parse and browser load console | No user-facing Copy Link button exists in the current DOM; the restored function was verified through a temporary browser test button and no visible button was added in this phase.
blog-rotary-joint-materials.html | inline script at end of body, original lines 593-628; error line 612 | SyntaxError: Unexpected token ',' at orphaned ', 2000);' callback tail | Reconstructed the complete guarded menu logic and copyLink function using the site's intact article implementation; retained header scroll only where originally present; added Clipboard rejection fallback and stable two-second feedback restoration. | pass: Node vm.Script parse and browser load console | No user-facing Copy Link button exists in the current DOM; the restored function was verified through a temporary browser test button and no visible button was added in this phase.
blog-threaded-vs-flange.html | inline script at end of body, original lines 580-615; error line 599 | SyntaxError: Unexpected token ',' at orphaned ', 2000);' callback tail | Reconstructed the complete guarded menu logic and copyLink function using the site's intact article implementation; retained header scroll only where originally present; added Clipboard rejection fallback and stable two-second feedback restoration. | pass: Node vm.Script parse and browser load console | No user-facing Copy Link button exists in the current DOM; the restored function was verified through a temporary browser test button and no visible button was added in this phase.
blog-rotary-union-seal-types.html | inline script at end of body, original lines 661-683; error line 667 | SyntaxError: Unexpected token ',' at orphaned ', 2000);' callback tail | Reconstructed the complete guarded menu logic and copyLink function using the site's intact article implementation; retained header scroll only where originally present; added Clipboard rejection fallback and stable two-second feedback restoration. | pass: Node vm.Script parse and browser load console | No user-facing Copy Link button exists in the current DOM; the restored function was verified through a temporary browser test button and no visible button was added in this phase.
