caoguangcheng9-lgtm/begapunk-website/audit/geo-remediation/phase-1c-a2/unverified-context-labels.csv

page | section | exact_label | numeric_claim | evidence_status | risk | recommended_future_action
application-automation-rotary-tables.html | Preventive replacement schedule | High-cycle lines (>200 RPM, 24/7) | >200 RPM; 24/7 | unverified; requires engineering records or authoritative industry evidence | medium: retained context may be interpreted as a verified operating threshold or representative duty profile | Confirm the label against product test records, customer application records, or a relevant authoritative source; qualify or remove it if evidence is unavailable.
application-pneumatic-tools-hose-anti-twist.html | Preventive replacement schedule | High-frequency line (2 shifts, 1,000+ cycles/day) | 2 shifts; 1,000+ cycles/day | unverified; requires engineering records or authoritative industry evidence | medium: retained context may be interpreted as a verified operating threshold or representative duty profile | Confirm the label against product test records, customer application records, or a relevant authoritative source; qualify or remove it if evidence is unavailable.
application-pneumatic-tools-hose-anti-twist.html | Preventive replacement schedule | 8-hour shift, 400–600 cycles/day | 8-hour shift; 400–600 cycles/day | unverified; requires engineering records or authoritative industry evidence | medium: retained context may be interpreted as a verified operating threshold or representative duty profile | Confirm the label against product test records, customer application records, or a relevant authoritative source; qualify or remove it if evidence is unavailable.
application-robot-end-of-arm-tooling.html | Preventive replacement schedule | Standard duty (8-hour shift, 30 cycles/min) | 8-hour shift; 30 cycles/min | unverified; requires engineering records or authoritative industry evidence | medium: retained context may be interpreted as a verified operating threshold or representative duty profile | Confirm the label against product test records, customer application records, or a relevant authoritative source; qualify or remove it if evidence is unavailable.
application-robot-end-of-arm-tooling.html | Preventive replacement schedule | High-cycle lines (24/7, 60 cycles/min) | 24/7; 60 cycles/min | unverified; requires engineering records or authoritative industry evidence | medium: retained context may be interpreted as a verified operating threshold or representative duty profile | Confirm the label against product test records, customer application records, or a relevant authoritative source; qualify or remove it if evidence is unavailable.
