caoguangcheng9-lgtm/begapunk-website/images/manufacturing-quality/production-inspection/individual-passage-test-pass.jpg

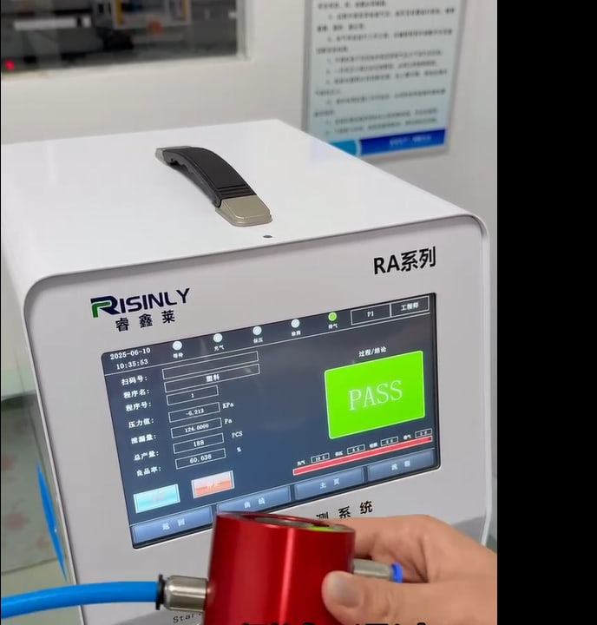
images/manufacturing-quality/production-inspection/individual-passage-test-pass.jpg
