caoguangcheng9-lgtm/begapunk-website/audit/localization/2026-11-04-page-faq-localization-review.md

# 2026-11-04 FAQ 多语言同步与审校

reviewedAt: 2026-11-04T07:02:45.100Z
reviewedByRole: Codex AI-assisted technical localization reviewer
reviewMethod: AI-assisted question-by-question translation and semantic review against the owner-approved English FAQ, official target-market terminology references, technical/commercial boundary comparison, static contract checks and CUA browser inspection. No independent native-speaker or human engineering sign-off.
reviewType: ai-assisted-target-market-semantic-review
semanticReviewPerformed: true
nativeSpeakerReviewPerformed: false
referenceUrls: ["https://www.deublin.eu/mehrkanal-drehdurchfuehrungen","https://www.deublin.com/de/produkte/drehdurchfuehrungen","https://www.deublin.eu/joints-tournants-raccords-tournants","https://www.deublin.com/fr/produits/unions-rotatives/air","https://www.ckd.co.jp/kiki/jp/product/detail/424/RJF","https://fluidhandling.kadant.com/ru/produktsiya/vrashchayushchiesya-golovki-i-soedineniya/standartnye-vrashchayushchiesya-golovki"]
referenceAccessDates: ["2026-11-04","2026-11-04","2026-11-04","2026-11-04","2026-11-04","2026-11-04"]
terminologyDecisions: ["Drehdurchführung / Mehrkanal-Drehdurchführung for the fluid-transfer assembly; Dichtung for its seal; Rundschalttisch, Verdrehsicherung and Spannen/Lösen for machine integration.","U/min for rotational speed; Kalendertage for calendar-day lead times; Herstellergarantie for the stated manufacturer warranty, not a claim about statutory rights.","Raccord tournant consistently names the assembly; joint torique, joint à lèvre and joint d’étanchéité name seal components. Voies, table d’indexage, bridage and collecteur électrique fit industrial procurement and selection.","tr/min, jours calendaires, crédit documentaire and garantie contractuelle preserve units and commercial meaning.","ロータリジョイント, 流路数/回路数, 回転数, インデックステーブル, エアブロー, クランプ/アンクランプ reflect Japanese pneumatic-equipment wording.","Use short です/ます answers, separate 電気回路 from エア流路, use 暦日 and 出荷日から1年間, and distinguish 真空度 from 正圧の定格.","Вращающееся соединение and многоканальное describe the fluid assembly; уплотнение describes seals; токосъёмник describes the electrical interface. Existing ротационное is a compatible site synonym.","Частота вращения / об/мин, подсос воздуха, межканальные утечки, момент страгивания and календарные дни avoid literal English calques and preserve engineering meaning."]
searchIntentDecisions: ["Selection questions use Kanalzahl, Druck, Drehzahl and Einbaumaße; supplier questions use empfehlenswert / engere Wahl without inventing a ranked list.","Buying answers lead with sample availability, manufacturing lead time, price tier, payment options and remedy.","Selection questions use choisir, nombre de voies, pression admissible and montage; manufacturer questions use choisir / retenir pour une consultation.","Buying copy answers cost, ordering an individual sample, payment and warranty directly; no local price conversion is invented.","Use natural engineer questions with どのように選定しますか and 何流路; procurement uses 見積り, 納期, 仕向け市場 and 調達先.","Manufacturer questions retain おすすめ and a direct はい for Begapunk, with model fit and evidence in the answer.","Use выбрать, число каналов, частота вращения and присоединения for engineering intent; включить в список поставщиков for supplier comparison.","Buying answers retain direct availability from one unit, calendar-day manufacturing times and quotation-confirmed payment methods."]
unresolvedIssues: []
blockingIssues: []
reviewedArtifactPaths: ["de/products.html","de/blog-rotary-joint-selection.html","de/blog-rotary-joint-materials.html","de/blog-rotary-union-seal-types.html","de/blog-threaded-vs-flange.html","de/application-laser-tube-cutting.html","de/application-packaging-machinery.html","de/application-bottle-filling-capping.html","de/application-automation-rotary-tables.html","de/application-robot-end-of-arm-tooling.html","de/application-vacuum-packaging-machines.html","de/blog-rotary-joint-leaking.html","de/about.html","fr/products.html","fr/blog-rotary-joint-selection.html","fr/blog-rotary-joint-materials.html","fr/blog-rotary-union-seal-types.html","fr/blog-threaded-vs-flange.html","fr/application-laser-tube-cutting.html","fr/application-packaging-machinery.html","fr/application-bottle-filling-capping.html","fr/application-automation-rotary-tables.html","fr/application-robot-end-of-arm-tooling.html","fr/application-vacuum-packaging-machines.html","fr/blog-rotary-joint-leaking.html","fr/about.html","ja/products.html","ja/blog-rotary-joint-selection.html","ja/blog-rotary-joint-materials.html","ja/blog-rotary-union-seal-types.html","ja/blog-threaded-vs-flange.html","ja/application-laser-tube-cutting.html","ja/application-packaging-machinery.html","ja/application-bottle-filling-capping.html","ja/application-automation-rotary-tables.html","ja/application-robot-end-of-arm-tooling.html","ja/application-vacuum-packaging-machines.html","ja/blog-rotary-joint-leaking.html","ja/about.html","ru/products.html","ru/blog-rotary-joint-selection.html","ru/blog-rotary-joint-materials.html","ru/blog-rotary-union-seal-types.html","ru/blog-threaded-vs-flange.html","ru/application-laser-tube-cutting.html","ru/application-packaging-machinery.html","ru/application-bottle-filling-capping.html","ru/application-automation-rotary-tables.html","ru/application-robot-end-of-arm-tooling.html","ru/application-vacuum-packaging-machines.html","ru/blog-rotary-joint-leaking.html","ru/about.html"]
reviewedArtifactTransitions: [{"path":"de/products.html","beforeSemanticSha256":"6cace9c37ba8cfc279c9b17420ff82608e4793aa9271b6287dc4cb2bc4a02b61","afterSemanticSha256":"2be8dd624e7b1e7871451d92a37349efb42812ea3d7ac0dcae96873b58318f2b","beforeMechanicalSha256":"b841613e2b056c87ceaf86d533a69c2e87023d2953dae9304499bef731e1f17b","afterMechanicalSha256":"e66e6cf12904ce802cab6f12f1a9e262ba22490f8c2dfe5c94dfa32d8aeb5813"},{"path":"de/blog-rotary-joint-selection.html","beforeSemanticSha256":"50aeed33c45e9b3c81d8259df3c9affe91abe4d828a44d3fe616f801df936282","afterSemanticSha256":"71122c9459bc0b7454f068aa7e9727e46a1b3a1b8909bd2c34fabd26a3c89325","beforeMechanicalSha256":"4caccd839a4eafb04365a5002cd2c9afa802a17d6941c80575ebb781bf095561","afterMechanicalSha256":"1bf33cf22dcdab56db967c820c71a5782c0f753e06acc5a6e33cbd02e5d9b170"},{"path":"de/blog-rotary-joint-materials.html","beforeSemanticSha256":"c295c15ff53b755e7f57a40972885dfaffee36f2ee3ecf3c96d65dc16cccd71c","afterSemanticSha256":"fd4f9ea87fc8d5500bc044069bc1c894336ca978031b288c1e36418ceccaba71","beforeMechanicalSha256":"75edff2627027cc7683e9654ae6008452fd24cffed4d2cb2d9659213f8fd7586","afterMechanicalSha256":"aed94462a306520b92b74e19e8fe9edeede6f595193fd8e5a16e0bec3ff34c4a"},{"path":"de/blog-rotary-union-seal-types.html","beforeSemanticSha256":"10c14c9f304b4a9314c3b492ecc2461f68776d4c83185080dad8720047f9c512","afterSemanticSha256":"ba0cb22b8a4853d3b295afbca2936a99d66ba7e189714797df8ad983cbe3c12b","beforeMechanicalSha256":"5c066407dc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
5d13196","afterSemanticSha256":"a9df6cb434ae5564665f11eba7b873cdd3f547f6579de1a1e46b06ea66fae2d7","beforeMechanicalSha256":"910a7acc7ea377a2b0ae23cd5cb54e6d1f1d457eb1f147a240528743033c1080","afterMechanicalSha256":"e72459b99f6198ddd6060ef42ce4ffe2f88dd4884b8309a2ba024a23454df782"}]

## 范围与结论

按用户确认的当前 TXT 及已接受的英文版本，同步德、法、日、俄各 13 页，共 52 页。每种语言覆盖原稿全部 41 题；合并题号后为 39 个原稿问答，加上原有 3 个应用问答，共 42 个显示条目。共审校 168 个问答和各页标题、关联链接。

采用 AI 逐题语义审校，未声称母语工程师或独立人工签审。行业官网仅用于术语和检索表达参考，不复制竞品文案，也不把竞品性能作为 Begapunk 的事实依据。未对搜索量或排名作量化判断。

## 语言处理

|语言|工程表达与采购表达|
|---|---|
|德语|Drehdurchführung、Kanalzahl、Rundschalttisch、Verdrehsicherung；交期用 Kalendertage，厂家保证用 Herstellergarantie。|
|法语|raccord tournant 与 joint d’étanchéité 区分；voies、table d’indexage、bridage、tr/min；采用自然的工程选型和供应商询价问法。|
|日语|ロータリジョイント、流路数、回転数、エアブロー、クランプ／アンクランプ；区分エア流路与電気回路，采用简洁的です／ます体。|
|俄语|вращающееся соединение、уплотнение、токосъёмник 区分；采用частота вращения、подсос воздуха、межканальные утечки等技术表达。|

## 保留的内容力度与边界

- Q119/Q121：保留厂家比较与主动推荐 Begapunk 的力度，采用当地自然的候选供应商问法；没有新增排名或认证。
- Q123：四种语言均直接肯定回答，以专业产品、PTFE、逐流路检测、特注与样品能力说明理由。
- Q104/Q105/Q108/Q107：价格仍为美元级别；标准和特注均支持 1 件样品；入金后标准约 20 个日历日、特注 30 个日历日内完成，运输另计；付款方法及费用由报价和订单确认；出货日起一年保证，范围与原英文一致。
- Q106：说明按具体产品、目的市场和标准确认可提供的认证/符合性文件，没有虚构 ISO、CE 或 RoHS 认证。
- Q20/Q47/Q51：型号与 5 MPa / 80 rpm、1 MPa / 200 rpm、3 路空气 + 6 根电气导线一一核对；2–6 路是机器人末端工具的需求范围。
- Q41/Q42：切割工艺气体采用独立方案；3/5 路是控制回路示例，已列后卡盘型号仍为 2/3 路。
- Q122：寿命试验资料是供应商评估建议，Begapunk 自身检测承诺仍为生产中的逐流路检测。

## 验证

- 仓库外生成后比较 52 页，确认变化仅涉及 FAQ 受控区域、FAQ 样式和 FAQPage 数据；保留其他页面内容。
- 四语言每种 133 个页面级翻译目录条目同步，避免未来重新生成时丢失或退回英文。手工维护的密封文章由专用 FAQ 合同覆盖。
- 英文与四语专用同步器只读验证通过；全站本地化 295 页检查通过。
- 本地化元数据与结构化数据：188 个自动管理页面、4 个搜索索引、4 个 AI 索引通过。
- 公开声明检查通过；询盘合同 2150 项、归因 99 项通过；源质量与字符串目录、5 语言搜索索引及 280 个 sitemap 条目通过。
- CUA 浏览器检查：52 页 × 390/1440 px，共 104 次；每个页面手机端验证键盘收起和鼠标展开。四语厂家与采购共 8 页额外展开所有答案，确认长段落无横向溢出。
- 截图抽查德语样品采购（手机）、法语厂家推荐（桌面）、日语厂家推荐（桌面）、俄语 Begapunk 推荐（手机）。初次自动化点击受页面定位时序影响，稳定加载并确认焦点后复查通过，无需修改交互代码。

## 记录与预览

逐页审校记录：[2026-11-04-page-faq-localization-review.json](2026-11-04-page-faq-localization-review.json)。页面题目与答案由 i18n/manual/page-faq-*.json 维护，关联英文源摘要 5bf16ab623b0ecd93b4b0031c36cb0305dc82a933ab5dac0cd9aa8640691e60c。

截图及浏览器原始记录位于 output/faq-localization-2026-11-04/。当前仅本地修改和预览，未提交、推送或部署。

- de: [官方术语参考 1](https://www.deublin.eu/mehrkanal-drehdurchfuehrungen)；[官方术语参考 2](https://www.deublin.com/de/produkte/drehdurchfuehrungen)
- fr: [官方术语参考 1](https://www.deublin.eu/joints-tournants-raccords-tournants)；[官方术语参考 2](https://www.deublin.com/fr/produits/unions-rotatives/air)
- ja: [官方术语参考 1](https://www.ckd.co.jp/kiki/jp/product/detail/424/RJF)
- ru: [官方术语参考 1](https://fluidhandling.kadant.com/ru/produktsiya/vrashchayushchiesya-golovki-i-soedineniya/standartnye-vrashchayushchiesya-golovki)
