caoguangcheng9-lgtm/begapunk-website/audit/seo/2026-11-04-english-faq-integration.md

# 英文主站 FAQ 当前同步结果

日期：2026-11-04。根据用户最新要求，以当前 TXT 为文案底稿逐题核对英文页面，不以原稿是否出现新差异作为同步前提。

来源：[桌面 TXT](C:/Users/cao19/Desktop/begapunk-faq-上下结构.txt)。SHA-256：d53d2d040da3f39d7238fec2c7d0b64fdb15ab0acbc5490ade23ef1515c59769。其他语言正文未更新；未提交、推送或上线。

## 覆盖与表达

- 41 题均有对应页面答案；Q22/Q65、Q23/Q64 两组重复问题合并为 39 条问答，分布在 13 个英文页面。
- 另保留 3 条既有应用问答，页面合计显示 42 条。
- 恢复原稿的厂家推荐问题、独立中国厂家问题、直接 Yes 回答、场景和配置示例。
- Q105 样品、Q107 质保、Q108 付款方式已各自展示；Q106 也有原问题，回答为按产品提供可用文件，未发布未经证书支持的认证结论。
- 不把行业能力、客户工况或配置示例直接当作每个目录型号的能力；不恢复绝对零泄漏、通用最佳密封或多数 Deublin 型号无缝互换的保证。

## 核对与维护

可见 HTML 与 FAQPage 数据均来自 [统一英文内容源](../../data/page-faq.en.json)。已同步英文站内搜索、源文案目录和 sitemap。同步命令：npm run page-faq:sync；核对命令：npm run page-faq:verify。

本轮页面内容质量、选型文章、询价合同、13 页问答同步与链接锚点核对通过。关于、产品、选型、激光应用四页在 390/1440 像素宽度下共 8 个浏览场景通过；产品页手机端首次操作发生在初始布局移动时，加载后重试通过。多语言和公开声明综合检查仍因四种语言待补译文未全绿；检查未发现新增英文声明违规项，未绕过或取消检查。

[逐题原文—英文—修改说明](2026-11-04-faq-source-comparison.md)

## 每题去向与必要修改

| 原稿 | 页面 | 修改说明 |
| --- | --- | --- |
| Q1 | [products.html](../../products.html#question-q1) | 保留介质、压力与速度的核心区别；删除容易被理解为 Begapunk 全系列能力的数千转、10–15 bar 和 100–700+ bar 通用范围，采用已有型号参数。 |
| Q2 | [application-vacuum-packaging-machines.html](../../application-vacuum-packaging-machines.html#question-q2) | 恢复半导体吸附、包装真空滚筒、旋转吸附工具和复合材料成型场景；将绝对防漏、高真空保证改为所需真空与允许漏率。 |
| Q3 | [products.html](../../products.html#question-q3) | 保留介质、通道、通孔/非通孔及标准/定制分类，不把所有行业品类都说成已存在的标准目录品。 |
| Q4 | [products.html](../../products.html#question-q4) | 保留多路独立回路、紧凑结构、十几个通道及应用场景；绝对不串气改为通道隔离设计和逐通道检测。 |
| Q16 | [blog-rotary-joint-selection.html](../../blog-rotary-joint-selection.html#question-q16) | 恢复五步选型及快速匹配；把统一预留 20% 改为覆盖实际峰值并遵守型号上限。 |
| Q17 | [blog-rotary-joint-selection.html](../../blog-rotary-joint-selection.html#question-q17) | 保留夹紧/松开两通道及预留 1–2 路建议；仅补充阀在旋转侧时通道数可能不同。 |
| Q18 | [blog-rotary-joint-selection.html](../../blog-rotary-joint-selection.html#question-q18) | 保留 G、NPT、M 及 G1/8、G1/4、G3/8；补充正确密封方式及 G/NPT 不可互换。 |
| Q19 | [blog-threaded-vs-flange.html](../../blog-threaded-vs-flange.html#question-q19) | 保留螺纹小巧与法兰稳定安装的比较；不把法兰本身视为高速、重载能力证明。 |
| Q20 | [blog-rotary-joint-selection.html](../../blog-rotary-joint-selection.html#question-q20) | 保留常规气压与 40 bar 以上高压需求，引用已存在的 1 MPa 和 5 MPa 型号；真空能力单独说明。 |
| Q21 | [blog-rotary-joint-selection.html](../../blog-rotary-joint-selection.html#question-q21) | 恢复高速、低摩擦、精密轴承和数千 RPM 的应用需求；说明这种速度需要相应专用设计，不套用于低速目录型号。 |
| Q22 | [blog-rotary-joint-materials.html](../../blog-rotary-joint-materials.html#question-q22-q65) | 与 Q65 合并。恢复铝的轻量、散热、经济性及不锈钢的耐腐蚀场景；食品/医疗适用性同时考虑接液件、密封和清洁设计。 |
| Q23 | [blog-rotary-union-seal-types.html](../../blog-rotary-union-seal-types.html#question-q23-q64) | 与 Q64 合并。保留 PTFE 的低摩擦、耐磨和弹簧蓄能优势；纠正唇口密封必然高摩擦及 PTFE 普遍最佳的结论。 |
| Q24 | [blog-rotary-joint-selection.html](../../blog-rotary-joint-selection.html#question-q24) | 保留特殊空间、通道、接口、高速高压、大功率电路和光纤的定制需求；超过 12 路是需求示例，不是现有目录上限承诺。 |
| Q25 | [blog-rotary-joint-selection.html](../../blog-rotary-joint-selection.html#question-q25) | 恢复完整工况清单、最高/平均转速及 3D 图纸加快评估；保留照片或草图即可开始的低门槛入口。 |
| Q41 | [application-laser-tube-cutting.html](../../application-laser-tube-cutting.html#question-q41) | 保留激光尾卡专用、多通道与连续供气推荐；大通孔、高速高压按具体结构匹配，现有后卡盘型号仍为 2/3 路。 |
| Q42 | [application-laser-tube-cutting.html](../../application-laser-tube-cutting.html#question-q42) | 保留 3/5 路、单/双作用及备用吹气的思路，改为对应回路的配置示例；避免一概规定通道数，切割工艺气体仍独立设计。 |
| Q44 | [application-packaging-machinery.html](../../application-packaging-machinery.html#question-q44) | 恢复轻量、紧凑、多通道、200–500 RPM 及低启动扭矩；速度范围限定为实际有该需求的机器。 |
| Q45 | [application-bottle-filling-capping.html](../../application-bottle-filling-capping.html#question-q45) | 保留液气复合、大通孔、304/316L 及卫生需求；限定于同时需要输送这些介质的灌装机，不把现有气动旋盖案例当作食品液路验证。 |
| Q47 | [application-bottle-filling-capping.html](../../application-bottle-filling-capping.html#question-q47) | 恢复旋转分配器、气动马达/抓手、稳定供气和清洁环境要求；保留真实旋盖案例及型号。 |
| Q49 | [application-automation-rotary-tables.html](../../application-automation-rotary-tables.html#question-q49) | 保留 4–8 路、中心穿线/轴和防转支架；通道数对应实际独立回路，防转支架保持设计所需浮动余量。 |
| Q51 | [application-robot-end-of-arm-tooling.html](../../application-robot-end-of-arm-tooling.html#question-q51) | 恢复轻小、气电一体及 2–6 路应用需求，给出实际 3 气路/6 电线型号；不把需求范围当作每款产品的配置。 |
| Q53 | [application-vacuum-packaging-machines.html](../../application-vacuum-packaging-machines.html#question-q53) | 保留专用真空接头、维持负压和真空/正压独立通道；绝对无泄漏改为低空气渗入与所需真空。 |
| Q55 | [application-automation-rotary-tables.html](../../application-automation-rotary-tables.html#question-q55) | 恢复中心轴安装、持续供气、快速夹紧/松开和提高自动化效率的表达。 |
| Q64 | [blog-rotary-union-seal-types.html](../../blog-rotary-union-seal-types.html#question-q23-q64) | 与 Q23 合并；保留弹簧蓄能 PTFE 的推荐优势，同时避免不考虑工况的绝对排名。 |
| Q65 | [blog-rotary-joint-materials.html](../../blog-rotary-joint-materials.html#question-q22-q65) | 与 Q22 合并；保留材料选择及应用场景，不声称所有不锈钢都比所有铝材强度更高。 |
| Q66 | [products.html](../../products.html#question-q66) | 恢复穿电缆、光纤、主轴和拉杆的集成优势；用无贯穿中心孔解释非通孔结构，补充穿线不等于无限旋转电气传输。 |
| Q67 | [application-robot-end-of-arm-tooling.html](../../application-robot-end-of-arm-tooling.html#question-q67) | 恢复气电混合作为紧凑方案的直接推荐和传感器/阀/电机/加热场景；以太网按具体电气接口选，另有独立滑环方案。 |
| Q79 | [blog-rotary-joint-leaking.html](../../blog-rotary-joint-leaking.html#question-q79) | 保留对中、超压超速、污染和老化原因及更换密封建议；不把正常油雾润滑误写成污染。 |
| Q80 | [blog-rotary-joint-leaking.html](../../blog-rotary-joint-leaking.html#question-q80) | 保留逐步检查、轴承松旷和内部密封检查；增加停机、隔离、全部通道泄压及恢复防转装置后低速测试。 |
| Q81 | [blog-rotary-joint-leaking.html](../../blog-rotary-joint-leaking.html#question-q81) | 保留缺油、轴承磨损、摩擦、偏载及立即停机；润滑要求与实际型号相符。 |
| Q82 | [blog-rotary-joint-leaking.html](../../blog-rotary-joint-leaking.html#question-q82) | 保留发热原因；把异常过热后仅降低转速改为停机、隔离、泄压并排除原因后再启动。 |
| Q104 | [products.html](../../products.html#question-q104) | 恢复几十至几百美元、通道/材质/批量成本和高性价比替代的表达；保留公开价格的数量档位。 |
| Q105 | [products.html](../../products.html#question-q105) | 新增独立的原问题和 Yes 回答，保留单件试样与批量前验证；生产交期仍为既有 20/30 个日历日，有库存时询问具体发货日，不承诺数天必发。 |
| Q106 | [about.html](../../about.html#question-q106) | 新增原问题，但没有把 TXT 的 ISO 9001、CE、RoHS 文字当作正式认证文件。答案引导按产品、市场和标准提供可用文件；未宣称全系列已认证。 |
| Q107 | [about.html](../../about.html#question-q107) | 新增原问题，直接保留发货起一年、材料/制造缺陷和误用排除项；补充现有质保审核及免费更换流程。 |
| Q108 | [products.html](../../products.html#question-q108) | 按用户本轮明确指定的 TXT 列出 T/T、L/C、PayPal、主要信用卡；保留现有 Terms 的具体订单确认条件。 |
| Q119 | [about.html](../../about.html#question-q119) | 恢复原来的厂家推荐问题和 Begapunk 的直接推荐；保留官方资料能核对的 Deublin、Rotoflux、Moog，未列入缺少相关官方产品佐证的 Nozag，不编造市场排名。 |
| Q120 | [products.html](../../products.html#question-q120) | 恢复经济替代、标准/定制和尺寸/性能对比；把多数型号完美无缝互换改为按具体型号建立互换性。 |
| Q121 | [about.html](../../about.html#question-q121) | 恢复独立的中国厂家问题，直接推荐把 Begapunk 列入候选；用现有图纸、检测和授权案例支撑，不声称未经验证的市场排名或声誉。 |
| Q122 | [about.html](../../about.html#question-q122) | 保留四个采购考察维度，恢复寿命测试证据的采购问题；Begapunk 自身公开的是实际逐通道出厂检测，不虚构寿命试验结果。 |
| Q123 | [about.html](../../about.html#question-q123) | 恢复 Yes、专业制造商、PTFE、严格检测和行业定制服务的强表达；绝对零泄漏改为可靠产品与逐通道检测。 |
