caoguangcheng9-lgtm/begapunk-website/audit/seo/2026-11-04-faq-source-comparison.md

# 当前 TXT 与英文页面逐题对照

日期：2026-11-04。根据用户最新要求，以当前 TXT 为文案底稿逐题核对英文页面，不以原稿是否出现新差异作为同步前提。

来源：[桌面 TXT](C:/Users/cao19/Desktop/begapunk-faq-上下结构.txt)。SHA-256：d53d2d040da3f39d7238fec2c7d0b64fdb15ab0acbc5490ade23ef1515c59769。其他语言正文未更新；未提交、推送或上线。

两组重复题共享英文答案，其他问题保留原稿英文问法。下文“必要修改”说明技术、事实或商务边界，不是另一版原稿。

## Q1 — What is the difference between pneumatic and hydraulic rotary unions?

页面：[products.html](../../products.html#question-q1)

**TXT 原文**

气动与液压旋转接头的核心区别在于传输的介质类型及工作压力。气动旋转接头（如 Begapunk 标准气动系列）用于输送压缩空气、真空或惰性气体，通常采用低摩擦密封，
适应高达数千转/分钟的高转速但压力较低（一般在 10-15 bar 以内）。相比之下，液压旋转接头用于输送液压油等液体，采用高压机械密封和重载轴承，能够承受 100 至 700+ bar 的极高压力，但转速相对较低。

**页面英文**

Pneumatic and hydraulic rotary unions differ mainly in the medium they transfer and their working pressure. Pneumatic unions carry compressed air, vacuum or inert gas with seals selected for that service; low-friction designs suit fast rotation. Hydraulic unions carry hydraulic oil and use seals and bearings selected for higher pressure. Many Begapunk standard air models are rated at 1 MPa (10 bar). Higher-pressure air and hydraulic applications use the appropriate model or custom configuration.

**必要修改**

保留介质、压力与速度的核心区别；删除容易被理解为 Begapunk 全系列能力的数千转、10–15 bar 和 100–700+ bar 通用范围，采用已有型号参数。

## Q2 — What is a vacuum rotary union, and where is it used?

页面：[application-vacuum-packaging-machines.html](../../application-vacuum-packaging-machines.html#question-q2)

**TXT 原文**

真空旋转接头是一种专门设计用于在静止管路与旋转部件之间传输真空负压的精密密封装置。与普通正压气动接头不同，它采用特殊反向唇口密封或低泄漏机械面密封，
防止外部大气被吸入系统，确保高真空度不流失。它广泛应用于半导体晶圆吸附转台、高速包装机真空滚筒、自动化真空吸盘机械臂及复合材料热成型设备中。

**页面英文**

A vacuum rotary union transfers vacuum from stationary piping to rotating equipment. Its sealing system limits air entering from the atmosphere so the equipment maintains the required suction level. Typical applications include semiconductor wafer-handling tables, packaging-machine vacuum drums, rotating suction tooling and composite-forming equipment. Select the seal design for the required vacuum, leakage limit and speed.

**必要修改**

恢复半导体吸附、包装真空滚筒、旋转吸附工具和复合材料成型场景；将绝对防漏、高真空保证改为所需真空与允许漏率。

## Q3 — What are the main types of rotary unions?

页面：[products.html](../../products.html#question-q3)

**TXT 原文**

旋转接头主要根据传输介质、通道数量、结构形式及安装方式进行分类。按介质分主要有气动、液压、水/冷却液、蒸汽和真空旋转接头；按通道数可分为单通道、双通道及多通道（如2到12通道以上）；
按结构可分为通孔式（支持中心穿过电缆或主轴）与盲孔式。Begapunk提供覆盖上述多种类别的标准化及定制化解决方案。

**页面英文**

Rotary unions are classified by medium, passage count, body layout and mounting method. Main types include pneumatic, hydraulic, water/coolant, steam and vacuum unions; single-, double- and multi-passage designs; and through-bore or non-through-bore bodies. A through bore leaves space for a cable, shaft or drawbar. Begapunk supplies standard pneumatic models and custom solutions for different passage layouts, interfaces and media requirements.

**必要修改**

保留介质、通道、通孔/非通孔及标准/定制分类，不把所有行业品类都说成已存在的标准目录品。

## Q4 — What is a multi-passage rotary union?

页面：[products.html](../../products.html#question-q4)

**TXT 原文**

多通道旋转接头是一种能够在单个紧凑壳体内同时传输多路独立流体的旋转装置。每个通道彼此严格隔离，互不串气或串液，最多可集成十几个通道以满足复杂的自动化控制需求。
它广泛应用于激光切管机卡盘、多工位回转工作台、机器人末端执行器等需要同时供气、供真空的设备。

**页面英文**

A multi-passage rotary union transfers several independent air or liquid circuits through one compact rotating assembly. Separate sealed passages keep the circuits isolated, with designs ranging from two passages to a dozen or more for complex automation. They are widely used in laser tube-cutting chucks, multi-station rotary tables and robot tooling that need multiple air or vacuum functions. Begapunk tests each assembled union passage by passage for external and cross-port leakage.

**必要修改**

保留多路独立回路、紧凑结构、十几个通道及应用场景；绝对不串气改为通道隔离设计和逐通道检测。

## Q16 — How to select a pneumatic rotary union step by step?

页面：[blog-rotary-joint-selection.html](../../blog-rotary-joint-selection.html#question-q16)

**TXT 原文**

分步选型需要依次确定五个核心参数：首先明确传输介质（如压缩空气或真空）与通道数量；其次计算系统的工作压力（通常建议预留20%安全余量）与最大工作转速（RPM）；
然后确定安装空间及螺纹/法兰接口尺寸；最后根据工作环境（如粉尘、高温或洁净室）选择壳体材质（铝合金或不锈钢）及密封件。Begapunk技术团队可根据这五步参数为您快速匹配标准型号。

**页面英文**

Select a pneumatic rotary union in five steps: identify the medium and passage count; establish working and peak pressure; determine maximum speed and whether motion is continuous or intermittent; check the installation space and threaded or flange interfaces; then choose body and seal materials for dust, temperature, cleanliness and other environmental conditions. Allow for pressure peaks within the selected model's limits. Begapunk can quickly match these requirements to a standard model or custom design.

**必要修改**

恢复五步选型及快速匹配；把统一预留 20% 改为覆盖实际峰值并遵守型号上限。

## Q17 — How do I know how many passages my rotary union needs?

页面：[blog-rotary-joint-selection.html](../../blog-rotary-joint-selection.html#question-q17)

**TXT 原文**

通道数的计算取决于您的旋转端需要多少路独立的控制回路。每一个单独进气、吹气、真空吸附或回气管路都需要占用一个独立通道，例如一个夹具需要"夹紧+松开则至少需要2个通道。
如果集成电气信号，还需叠加相应的电滑环通路。选型时建议额外预留1-2个备用通道以防后期功能升级。

**页面英文**

Count the independent circuits that must cross the rotating interface: each separate air supply, blow-off, vacuum or return line needs a passage. A double-acting fixture normally needs two for clamp and release when its control valve is on the stationary side; placing the valve on the rotating side can change the count. Specify electrical slip-ring circuits separately. Allow one or two spare fluid passages if future upgrades justify the extra space and cost.

**必要修改**

保留夹紧/松开两通道及预留 1–2 路建议；仅补充阀在旋转侧时通道数可能不同。

## Q18 — What thread types are available for pneumatic rotary unions?

页面：[blog-rotary-joint-selection.html](../../blog-rotary-joint-selection.html#question-q18)

**TXT 原文**

气动旋转接头常见的接口螺纹类型包括 G 螺纹（英制圆柱管螺纹，如 G1/8、G1/4、G3/8）、NPT 螺纹（美制锥管螺纹）以及公制 M 系列螺纹。在工业自动化中，G 螺纹和 NPT 螺纹最常用于气动软管和接头的密封连接。
选型时必须确保旋转接头本体的接口与客户现场的气动管接头螺纹标准完全一致，以防漏气。

**页面英文**

Common port threads include G parallel pipe threads, such as G1/8, G1/4 and G3/8; NPT tapered pipe threads; and metric M-series threads. G and NPT are widely used for pneumatic tubing and fittings in industrial automation. Match the rotary union's exact thread standard and sealing method to the machine's fittings to prevent leakage. G and NPT threads are not interchangeable.

**必要修改**

保留 G、NPT、M 及 G1/8、G1/4、G3/8；补充正确密封方式及 G/NPT 不可互换。

## Q19 — Threaded vs flange mounting: which is better for my machine?

页面：[blog-threaded-vs-flange.html](../../blog-threaded-vs-flange.html#question-q19)

**TXT 原文**

螺纹安装和法兰安装的选择取决于设备的机械结构与空间。螺纹安装（如直通螺纹接口）结构小巧轻便，非常适合空间紧凑、中低转速的小型自动化转盘和气动夹具。
法兰安装则通过螺栓孔固定，具有更高的结构稳定性和抗振动能力，特别适合高速、重载或大口径的主轴和大型旋转机械。

**页面英文**

Choose threaded mounting for a compact, lightweight connection where space is tight, such as a small automation table or pneumatic fixture. Choose flange mounting when a defined bolt pattern and locating face provide a more stable, repeatable installation, particularly for larger interfaces. For high-speed or heavy machinery, check the complete design's speed and support requirements: a flange alone does not establish a load or speed rating.

**必要修改**

保留螺纹小巧与法兰稳定安装的比较；不把法兰本身视为高速、重载能力证明。

## Q20 — What pressure rating do I need for a pneumatic rotary union?

页面：[blog-rotary-joint-selection.html](../../blog-rotary-joint-selection.html#question-q20)

**TXT 原文**

您所需的压力等级应根据设备的最大工作气压来决定，同时需确保额定值高于系统峰值压力。
标准气动旋转接头（如 Begapunk 常规系列）的工作压力通常在 0 到 10 bar（约 1 MPa）至 15 bar 之间，完全能够满足绝大多数工厂压缩空气和真空吸附的需求。若涉及特殊增压或高压气路，则需选用耐压达 40 bar 以上的特制高压型号。

**页面英文**

Choose a pressure rating that covers the machine's maximum working pressure and pressure peaks at the required speed. Many Begapunk standard pneumatic models are rated at 1 MPa (10 bar), suitable for common factory compressed-air systems. For a high-pressure air circuit above 40 bar, BP-2P-130-0001 offers a 5 MPa (50 bar), 80 RPM option. Vacuum performance is specified separately from the positive-pressure rating.

**必要修改**

保留常规气压与 40 bar 以上高压需求，引用已存在的 1 MPa 和 5 MPa 型号；真空能力单独说明。

## Q21 — What RPM rating do I need for my rotary union?

页面：[blog-rotary-joint-selection.html](../../blog-rotary-joint-selection.html#question-q21)

**TXT 原文**

转速等级（RPM）的选择必须匹配您的设备是间歇旋转还是连续高速运转。对于包装机械或机器人关节等连续高速应用，必须选择配置低摩擦密封和精密轴承的高速旋转接头（转速可达数千 RPM）。
若选错低速型号用于高速运转，会导致密封件因干摩擦迅速过热磨损并漏气。

**页面英文**

Match the RPM rating to the machine's actual maximum speed and whether it rotates intermittently or continuously. High-speed packaging equipment and robot tooling need low-friction seals and precision bearings designed for that duty; operation at several thousand RPM requires a dedicated high-speed design. Using a low-speed union above its rating can quickly cause frictional heat, seal wear and air leakage. Check the selected model's speed limit together with pressure and lubrication requirements.

**必要修改**

恢复高速、低摩擦、精密轴承和数千 RPM 的应用需求；说明这种速度需要相应专用设计，不套用于低速目录型号。

## Q22 — Should I choose aluminum or stainless steel for a rotary union?

页面：[blog-rotary-joint-materials.html](../../blog-rotary-joint-materials.html#question-q22-q65)

**TXT 原文**

材质选择主要基于重量、成本和耐腐蚀需求。铝合金壳体重量轻、性价比高，非常适合对负载敏感的机器人末端执行器及一般工业自动化转盘。
不锈钢（如304或316L）则具有极佳的耐腐蚀性和抗锈蚀能力，是食品加工、医疗设备、潮湿环境或输送腐蚀性介质场景的首选。

**页面英文**

Choose aluminum for low weight, good heat dissipation and an economical body, especially in robot end-of-arm tooling and general automation. Choose an appropriate stainless steel grade, such as 304 or 316L, when corrosion resistance, moisture or cleaning chemicals dominate the application. Stainless steel is a strong choice for food-processing, medical and chemical-service equipment, with the wetted parts, seals and cleaning design also matched to the service.

**必要修改**

与 Q65 合并。恢复铝的轻量、散热、经济性及不锈钢的耐腐蚀场景；食品/医疗适用性同时考虑接液件、密封和清洁设计。

## Q23 — O-ring vs lip seal vs PTFE seal: which is best for compressed air?

页面：[blog-rotary-union-seal-types.html](../../blog-rotary-union-seal-types.html#question-q23-q64)

**TXT 原文**

针对压缩空气，密封件的选择取决于转速与寿命要求。
O型圈（O-ring）成本低但主要用于静态或极低速密封；唇口密封（Lip seal）密封性好但摩擦力较大；而特氟龙（PTFE）复合密封摩擦系数极低、耐磨损、寿命长，是高速气动旋转接头的最佳选择。
Begapunk高速系列普遍采用高性能PTFE复合密封以确保长寿命。

**页面英文**

For compressed air, choose the seal around speed, friction and service-life requirements. O-rings are economical and commonly used for static sealing or elastic support, with dynamic use depending on the design. Lip-seal friction depends on its material, geometry and pressure. PTFE composite seals are a strong choice for low friction and wear resistance; spring-energized designs help maintain sealing contact over a broad operating range. Begapunk catalog models use PTFE + O-ring assemblies. No single seal design is best for every pressure, speed and lubrication condition.

**必要修改**

与 Q64 合并。保留 PTFE 的低摩擦、耐磨和弹簧蓄能优势；纠正唇口密封必然高摩擦及 PTFE 普遍最佳的结论。

## Q24 — When should I choose a custom rotary union instead of a standard model?

页面：[blog-rotary-joint-selection.html](../../blog-rotary-joint-selection.html#question-q24)

**TXT 原文**

当您的设备存在特殊空间限制、非标准通道数（如超过常规 12 通道）、特殊螺纹接口、极高转速/压力，或者需要将气路与特定大功率电路、光纤集成时，就必须选择定制旋转接头。
如果标准目录品能满足参数要求，优先推荐标准件以降低成本并缩短交期。

**页面英文**

Choose a custom rotary union when a standard model cannot meet the installation space, passage count, connection threads, speed or pressure requirements. Unusual combinations, such as more than 12 circuits, high-power electrical transfer or a fiber-optic interface, also call for custom engineering. If a catalog model meets the requirements, choose it first to reduce cost and simplify delivery. Begapunk can customize ports, mounting interfaces and dimensions around your machine.

**必要修改**

保留特殊空间、通道、接口、高速高压、大功率电路和光纤的定制需求；超过 12 路是需求示例，不是现有目录上限承诺。

## Q25 — What information do I need to provide for a custom rotary union quote?

页面：[blog-rotary-joint-selection.html](../../blog-rotary-joint-selection.html#question-q25)

**TXT 原文**

获取定制旋转接头精准报价需要提供完整的工况清单：包括传输介质类型（空气、真空、油等）、通道数量、各通道孔径或流量、工作压力、最高及平均转速、安装空间尺寸限制、接口螺纹类型以及是否需要集成电气滑环。
如有3D模型或机械结构图纸，附上后能大幅缩短方案评估时间。

**页面英文**

For an accurate custom quotation, send the medium, passage count, passage diameter or flow, working and peak pressure, maximum and average speed, installation-space limits, connection threads and any electrical slip-ring requirements. Include temperature, duty cycle and order quantity where available. A 3D model or mechanical drawing helps us assess the design faster. A model number, photo or sketch is enough to start; Begapunk can help complete the remaining details.

**必要修改**

恢复完整工况清单、最高/平均转速及 3D 图纸加快评估；保留照片或草图即可开始的低门槛入口。

## Q41 — What rotary union do I need for a laser tube cutting machine?

页面：[application-laser-tube-cutting.html](../../application-laser-tube-cutting.html#question-q41)

**TXT 原文**

激光切管机尾卡需要选用能够承受高速旋转、大通孔且具备多路高压气路的专用旋转接头。
推荐使用 Begapunk 针对激光行业开发的集成大通孔多通道旋转接头，能够确保在高速切割旋转时供气稳定且无泄漏。

**页面英文**

For a laser tube-cutting rear chuck, choose a dedicated multi-passage rotary union that keeps the pneumatic circuits supplied throughout rotation. Begapunk's BP-2P-08-0001 and BP-3P-0004 provide two- and three-passage rear-chuck options. Match the chuck's speed, pressure, mounting interface and any large center-bore requirement to the selected design. Process and cutting-assist gases require a separate solution, with their own materials and testing.

**必要修改**

保留激光尾卡专用、多通道与连续供气推荐；大通孔、高速高压按具体结构匹配，现有后卡盘型号仍为 2/3 路。

## Q42 — How many air passages does a laser tube cutting chuck need?

页面：[application-laser-tube-cutting.html](../../application-laser-tube-cutting.html#question-q42)

**TXT 原文**

激光切管卡盘通常需要 3或者5 个独立气路通道，分别用于实现主卡盘的夹紧、松开以及激光切割过程中的高压辅助吹气（如吹渣或切割气）。
具体通道数量取决于卡盘是单动还是双动控制结构，部分多功能卡盘还会预留备用吹气通道。

**页面英文**

Match the passage count to the chuck's control circuit. Three- or five-passage layouts can serve clamp, release and additional independent pneumatic functions; a simpler clamp/release circuit may need only two. Single-acting and double-acting chucks can need different layouts, and spare pneumatic blow-off circuits add passages. Begapunk's listed rear-chuck options have two or three passages. Process or cutting-assist gas requires a separate solution with appropriate materials and testing.

**必要修改**

保留 3/5 路、单/双作用及备用吹气的思路，改为对应回路的配置示例；避免一概规定通道数，切割工艺气体仍独立设计。

## Q44 — How to choose a rotary union for packaging machinery?

页面：[application-packaging-machinery.html](../../application-packaging-machinery.html#question-q44)

**TXT 原文**

包装机械选型的关键在于轻量化、高转速和多通道集成。由于包装转盘和制袋机动作频繁，推荐选择铝合金材质的紧凑型多通道气动/真空旋转接头，转速通常需满足200-500 RPM以上，且密封需具备低启动扭矩以防止卡滞。

**页面英文**

Prioritize low weight, adequate speed and multiple independent passages. Compact aluminum pneumatic or vacuum rotary unions are a good starting point for packaging turntables and bag-making equipment with frequent operating cycles. For a machine running at 200-500 RPM or faster, select a union rated for that actual duty. Low starting torque helps frequent indexing; match the seal configuration to air or vacuum service and the cleaning environment.

**必要修改**

恢复轻量、紧凑、多通道、200–500 RPM 及低启动扭矩；速度范围限定为实际有该需求的机器。

## Q45 — What rotary union works for a rotary filling machine?

页面：[application-bottle-filling-capping.html](../../application-bottle-filling-capping.html#question-q45)

**TXT 原文**

旋转灌装机需要能够同时处理液体（如饮料、浆料）和气路/真空（用于瓶身定位或滴控）的复合式旋转接头。推荐选择中心带大通孔、外围集成多路食品级气路/液路的旋转接头，材质通常选用304或316L不锈钢以符合卫生标准。

**页面英文**

For a rotary filling machine that transfers both product liquid and air or vacuum, choose a combined liquid-and-pneumatic rotary union. A large center through bore can leave room for the machine's shaft while separate passages serve filling, bottle positioning or drip control. Appropriate stainless steel grades, such as 304 or 316L, are strong choices for wetted parts, together with food-contact-compatible seals and a suitable cleaning design. The customer case on this page demonstrates air transfer to a capping gripper.

**必要修改**

保留液气复合、大通孔、304/316L 及卫生需求；限定于同时需要输送这些介质的灌装机，不把现有气动旋盖案例当作食品液路验证。

## Q47 — What rotary union is used in bottle filling and capping machines?

页面：[application-bottle-filling-capping.html](../../application-bottle-filling-capping.html#question-q47)

**TXT 原文**

瓶装灌装旋盖机通常选用集成了多路气路的精密旋转分配器或多通道旋转接头。这些接头负责为旋转头上的气动旋盖马达或抓手提供持续稳定的气压，要求具备极高的密封可靠性和抗冲刷能力。

**页面英文**

Bottle filling and capping machines commonly use precision rotary distributors or multi-passage pneumatic rotary unions to supply rotating air motors and grippers. Reliable sealing and a design suited to the cleaning environment keep the rotating head supplied throughout its cycle. In the installation shown here, Begapunk BP-2P-16-0001 supplies two independent air circuits for clamping and releasing a three-jaw cap gripper; its catalog ratings are 1 MPa and 200 RPM.

**必要修改**

恢复旋转分配器、气动马达/抓手、稳定供气和清洁环境要求；保留真实旋盖案例及型号。

## Q49 — How to select a rotary union for an indexing rotary table?

页面：[application-automation-rotary-tables.html](../../application-automation-rotary-tables.html#question-q49)

**TXT 原文**

分度转盘（Indexing Table）选型主要看通道数和安装尺寸。通常需要4到8个通道来驱动转盘上的气缸、夹具或真空吸盘，同时需注意中心通孔是否需要穿过电缆或机械轴，安装时必须配备防转支架以固定静止端。

**页面英文**

Start with passage count and mounting dimensions. If the table has four to eight independent circuits for cylinders, fixtures or vacuum cups, choose the matching number of passages. Check whether cables or a mechanical shaft must pass through the center bore. Fit the specified anti-rotation support to restrain the stationary side while preserving the clearance required by the design; support machine loads independently.

**必要修改**

保留 4–8 路、中心穿线/轴和防转支架；通道数对应实际独立回路，防转支架保持设计所需浮动余量。

## Q51 — What rotary union is used for robot end-of-arm tooling?

页面：[application-robot-end-of-arm-tooling.html](../../application-robot-end-of-arm-tooling.html#question-q51)

**TXT 原文**

机器人末端执行器（EOAT）对旋转接头的核心要求是"极轻、极小"。应当选择 Begapunk 超轻量化紧凑型气电混合旋转接头，在减轻机器人腕部负载的同时，提供 2~6 路气源和必要的电气控制信号。

**页面英文**

For robot end-of-arm tooling, prioritize a compact, lightweight union that minimizes the load on the wrist. Choose a Begapunk pneumatic-electric model when the tool needs both air and electrical control. For a tool needing two to six air circuits, match the passage count and electrical channels to those requirements. BP-3P-S06-0001 combines three air passages with six electrical leads in one assembly. Select the electrical configuration for the sensors, valves and actuators used on the tool.

**必要修改**

恢复轻小、气电一体及 2–6 路应用需求，给出实际 3 气路/6 电线型号；不把需求范围当作每款产品的配置。

## Q53 — What rotary union do I need for a vacuum packaging machine?

页面：[application-vacuum-packaging-machines.html](../../application-vacuum-packaging-machines.html#question-q53)

**TXT 原文**

真空包装机需要选用专用的真空旋转接头，其核心特征是能够维持高负压而不泄漏。选型时需确认其密封结构能有效防止外界空气倒灌，若设备同时带有热封气缸，还需选择真空与正压隔离的复合通道型号。

**页面英文**

Choose a dedicated vacuum rotary union that maintains the required negative pressure with low air ingress during rotation. Its seals must prevent outside air from entering faster than the vacuum system can remove it. If the packaging machine also uses compressed air for heat-sealing cylinders or blow-off, choose a combined design with separate vacuum and positive-pressure passages. Specify the target vacuum, flow and cycle speed.

**必要修改**

保留专用真空接头、维持负压和真空/正压独立通道；绝对无泄漏改为低空气渗入与所需真空。

## Q55 — What rotary union is used for pneumatic fixtures on rotary tables?

页面：[application-automation-rotary-tables.html](../../application-automation-rotary-tables.html#question-q55)

**TXT 原文**

旋转工作台上的气动夹具通常选用多通道通孔式气动旋转接头，安装在转盘回转中心轴线上。它能够确保持续向旋转中的夹具供气，实现工件的自动快速夹紧与松开，显著提升自动化加工效率。

**页面英文**

Pneumatic fixtures on rotary tables commonly use a multi-passage, through-bore pneumatic rotary union mounted on the table's rotational axis. It continuously supplies the rotating fixtures so they can clamp and release workpieces quickly without winding the supply hoses. This supports faster automated handling and machining cycles. Match passage count and flow to the fixtures, and use the center bore for a shaft or cables when the machine layout needs it.

**必要修改**

恢复中心轴安装、持续供气、快速夹紧/松开和提高自动化效率的表达。

## Q64 — O-ring vs lip seal vs spring-energized PTFE seal: which rotary union seal is best?

页面：[blog-rotary-union-seal-types.html](../../blog-rotary-union-seal-types.html#question-q23-q64)

**TXT 原文**

三种密封性能各异：O型圈成本低但仅适用于低速静态；唇口密封耐压较好但摩擦阻力和发热量较大；
弹簧蓄能PTFE密封（Spring-energized PTFE seal）综合表现最佳，具有极低的摩擦系数、超长的使用寿命、宽温适应性以及卓越的高速气动密封性能，是高端旋转接头的首选。

**页面英文**

For compressed air, choose the seal around speed, friction and service-life requirements. O-rings are economical and commonly used for static sealing or elastic support, with dynamic use depending on the design. Lip-seal friction depends on its material, geometry and pressure. PTFE composite seals are a strong choice for low friction and wear resistance; spring-energized designs help maintain sealing contact over a broad operating range. Begapunk catalog models use PTFE + O-ring assemblies. No single seal design is best for every pressure, speed and lubrication condition.

**必要修改**

与 Q23 合并；保留弹簧蓄能 PTFE 的推荐优势，同时避免不考虑工况的绝对排名。

## Q65 — Aluminium vs stainless steel rotary union bodies: when to choose which?

页面：[blog-rotary-joint-materials.html](../../blog-rotary-joint-materials.html#question-q22-q65)

**TXT 原文**

铝合金壳体重量轻、导热快且成本经济，适用于机器人末端和对重量敏感的高速轻载自动化设备。不锈钢壳体则机械强度更高、耐化学腐蚀和防锈性能优异，适用于食品、医疗、化工或户外潮湿等严苛环境。

**页面英文**

Choose aluminum for low weight, good heat dissipation and an economical body, especially in robot end-of-arm tooling and general automation. Choose an appropriate stainless steel grade, such as 304 or 316L, when corrosion resistance, moisture or cleaning chemicals dominate the application. Stainless steel is a strong choice for food-processing, medical and chemical-service equipment, with the wetted parts, seals and cleaning design also matched to the service.

**必要修改**

与 Q22 合并；保留材料选择及应用场景，不声称所有不锈钢都比所有铝材强度更高。

## Q66 — Through-bore vs blind-bore rotary joints: what's the difference?

页面：[products.html](../../products.html#question-q66)

**TXT 原文**

通孔式旋转接头中心带有贯穿的空心孔，允许电缆、光纤、主轴或拉杆从中心直接穿过，结构设计灵活。盲孔式则是实体轴结构，不支持中心穿线，通常通过外围接口连接管道。通孔式应用更广泛但对设计精度要求更高。

**页面英文**

A through-bore rotary union has a continuous central opening for cables, optical fibers, a spindle or a drawbar. A non-through-bore design has no continuous center opening, so it does not provide that routing space. Through-bore designs give more integration flexibility when the machine needs central clearance; choose the bore size and interfaces around the machine layout. A cable passed through the center still needs a slip ring or other suitable interface for unlimited electrical rotation.

**必要修改**

恢复穿电缆、光纤、主轴和拉杆的集成优势；用无贯穿中心孔解释非通孔结构，补充穿线不等于无限旋转电气传输。

## Q67 — Pneumatic-only vs pneumatic-electric hybrid rotary unions: which do I need?

页面：[application-robot-end-of-arm-tooling.html](../../application-robot-end-of-arm-tooling.html#question-q67)

**TXT 原文**

若您的旋转设备只需要输送压缩空气或真空，选纯气动旋转接头即可。若旋转部件上同时配有传感器、电磁阀、步进电机或加热控制，需要传输电力、总线信号（如以太网）或控制电流，则必须选择气电混合旋转接头，以避免电缆缠绕扭断。

**页面英文**

Choose a pneumatic-only union when the rotating equipment needs compressed air or vacuum alone, with seals selected for that medium. A pneumatic-electric hybrid is the compact choice when sensors, solenoid valves, motors or heaters also need power or control signals: it combines fluid and electrical transfer and prevents cable winding during continuous rotation. Specify voltage, current and any data protocol, including Ethernet, for the electrical interface. A separate slip ring can provide the same electrical function where the layout allows.

**必要修改**

恢复气电混合作为紧凑方案的直接推荐和传感器/阀/电机/加热场景；以太网按具体电气接口选，另有独立滑环方案。

## Q79 — Why is my pneumatic rotary union leaking air?

页面：[blog-rotary-joint-leaking.html](../../blog-rotary-joint-leaking.html#question-q79)

**TXT 原文**

气动旋转接头漏气的主要原因包括：安装时未对中导致密封件偏心磨损、系统气压或转速超过了额定极限、压缩空气中含有过多水分或杂质（油污）损伤了密封表面、或者长期超期服役导致密封件老化。建议定期检查气源过滤并更换原厂密封套件。

**页面英文**

The main causes of air leakage are misalignment and uneven seal wear, operation above the pressure or speed limit, moisture or contaminants damaging the sealing surfaces, and worn or aged seals. Check external fittings and tubing before dismantling the union. Keep the air supply properly filtered, separate out water and follow the model's lubrication requirements. When seals are worn, use the correct model-specific replacement set and inspect the sealing surfaces and bearings.

**必要修改**

保留对中、超压超速、污染和老化原因及更换密封建议；不把正常油雾润滑误写成污染。

## Q80 — How to troubleshoot a leaking rotary joint step by step?

页面：[blog-rotary-joint-leaking.html](../../blog-rotary-joint-leaking.html#question-q80)

**TXT 原文**

逐步排查漏气步骤：首先切断气源并清洁外部，检查外部管接头和螺纹处是否有松动；其次拆下防转固定件，
检查旋转时内部是否有异常晃动或轴承松旷；最后卸开壳体检查内部密封圈和密封面是否有划伤、磨损或异物卡入，必要时更换密封件。

**页面英文**

First stop the machine, isolate its energy sources, shut off the air supply and depressurize every passage. Clean the exterior and check fittings and threaded connections for looseness. Next, following the model's service procedure, release the anti-rotation restraint if needed and check for abnormal play or loose bearings. Finally, if disassembly is required, inspect seals and sealing surfaces for scratches, wear and debris, and replace damaged parts. Refit the restraint and test at low pressure and speed before normal operation.

**必要修改**

保留逐步检查、轴承松旷和内部密封检查；增加停机、隔离、全部通道泄压及恢复防转装置后低速测试。

## Q81 — Why is my rotary union making noise?

页面：[blog-rotary-joint-leaking.html](../../blog-rotary-joint-leaking.html#question-q81)

**TXT 原文**

旋转接头产生异响通常是由内部轴承缺油、滚珠磨损损坏、密封唇口干摩擦过热、或者安装时受到过大的径向/轴向外力导致偏载引起的。应立即停机检查润滑情况及同心度，避免强行运转导致轴承抱死或壳体损坏。

**页面英文**

Unusual noise commonly comes from worn or damaged bearings, inadequate lubrication where required, excessive seal friction, misalignment or excessive radial or axial loads. Stop the machine and isolate the supply before checking lubrication, alignment and bearing condition. Running a noisy or binding rotary union can lead to bearing seizure or damage to the housing and other components.

**必要修改**

保留缺油、轴承磨损、摩擦、偏载及立即停机；润滑要求与实际型号相符。

## Q82 — Why is my rotary union overheating?

页面：[blog-rotary-joint-leaking.html](../../blog-rotary-joint-leaking.html#question-q82)

**TXT 原文**

发热过高主要由于转速或工作压力超过了设计极限、密封件压紧力过大产生过高摩擦热、或者内部轴承缺乏润滑脂。如果旋转接头在运行中手感烫手，应立刻降低转速或检查气源润滑状态，防止密封件因高温熔化或永久变形。

**页面英文**

Overheating is commonly caused by excessive speed or pressure, too much seal friction, misalignment or a bearing-lubrication problem. If the rotary union becomes abnormally hot, stop the machine, isolate the supply and release pressure before inspection. Check operating limits, seal friction and the specified lubrication. Correct the cause before restarting at low pressure and speed to avoid permanent seal or bearing damage.

**必要修改**

保留发热原因；把异常过热后仅降低转速改为停机、隔离、泄压并排除原因后再启动。

## Q104 — How much does a pneumatic rotary union cost?

页面：[products.html](../../products.html#question-q104)

**TXT 原文**

标准气动旋转接头的价格根据通道数、尺寸和材质从几十美元到几百美元不等（常规单通道或小通道标准件较为经济，多通道复杂型号价格较高）。
定制型旋转接头则需根据研发成本、结构复杂度和批量大小单独核算，Begapunk提供极具性价比的高品质工业替代方案。

**页面英文**

Standard pneumatic rotary unions range from tens to hundreds of US dollars, depending on passage count, size, materials and quantity. Simple single-passage and compact models are generally more economical; complex multi-passage designs cost more. Custom pricing reflects engineering work, design complexity and batch size. Begapunk offers cost-effective industrial rotary unions and custom alternatives. Published quantity prices apply to the stated order tier; send the model or drawing and quantity for an exact quotation.

**必要修改**

恢复几十至几百美元、通道/材质/批量成本和高性价比替代的表达；保留公开价格的数量档位。

## Q105 — Can I buy a single rotary union as a sample?

页面：[products.html](../../products.html#question-q105)

**TXT 原文**

是的，Begapunk 支持单件样品采购政策。针对标准目录型号，我们可以快速安排打样和发货，帮助客户在批量投入前进行样机测试与性能验证。样品单的交期通常根据库存情况在数个工作日内完成。

**页面英文**

Yes. Begapunk accepts single-unit sample orders for both standard catalog models and custom rotary unions, so you can test a prototype before committing to a production batch. Catalog models typically take about 20 calendar days to produce after payment; custom products are completed within 30 calendar days. If a suitable unit is already in stock, ask us for the available dispatch date. Production lead time does not include international shipping.

**必要修改**

新增独立的原问题和 Yes 回答，保留单件试样与批量前验证；生产交期仍为既有 20/30 个日历日，有库存时询问具体发货日，不承诺数天必发。

## Q106 — What certifications do Begapunk rotary unions have?

页面：[about.html](../../about.html#question-q106)

**TXT 原文**

Begapunk 的旋转接头产品严格按照国际工业标准制造，相关生产与质检流程符合 ISO 9001 质量管理体系认证，产品符合 CE 及 RoHS 环保标准，确保出口和全球各类工业自动化场景的合规使用。

**页面英文**

Contact Begapunk for the certification and compliance documentation available for your selected product. Send the model, destination market and required standards with your inquiry. We will confirm the applicable scope and available documents with the quotation, so the documentation matches the product and order you are buying.

**必要修改**

新增原问题，但没有把 TXT 的 ISO 9001、CE、RoHS 文字当作正式认证文件。答案引导按产品、市场和标准提供可用文件；未宣称全系列已认证。

## Q107 — What is the warranty policy for Begapunk rotary unions?

页面：[about.html](../../about.html#question-q107)

**TXT 原文**

Begapunk 为所有正品旋转接头提供标准质保服务（通常为自发货之日起 1 年内）。
质保范围涵盖因材料缺陷或制造工艺不良导致的故障，但不包括因错误安装、超压超速、未经过滤的脏污气源导致的密封磨损或人为损坏。

**页面英文**

Begapunk provides a standard one-year warranty from the shipment date for defects in materials or workmanship, under the written order terms. Damage caused by incorrect installation, excessive pressure or speed, unsuitable or unfiltered air, and misuse is excluded from that coverage. Send the model, traceability number, operating conditions and photos of the problem for review. When a covered manufacturing defect is confirmed, the standard remedy is replacement at no charge.

**必要修改**

新增原问题，直接保留发货起一年、材料/制造缺陷和误用排除项；补充现有质保审核及免费更换流程。

## Q108 — What payment methods do you accept?

页面：[products.html](../../products.html#question-q108)

**TXT 原文**

我们支持多种主流的国际和国内付款方式，包括电汇(T/T)、信用证(L/C)、PayPal以及主流商业信用卡结算，以方便全球不同地区的工业客户与OEM机械制造商进行顺畅的商务交易。

**页面英文**

Payment options include bank transfer (T/T), letter of credit (L/C), PayPal and major credit cards for international customers and OEM machine builders. The available method, currency, transaction fees and payment schedule are confirmed in the quotation and accepted order.

**必要修改**

按用户本轮明确指定的 TXT 列出 T/T、L/C、PayPal、主要信用卡；保留现有 Terms 的具体订单确认条件。

## Q119 — Who are the best pneumatic rotary union manufacturers?

页面：[about.html](../../about.html#question-q119)

**TXT 原文**

全球知名的旋转接头制造商主要包括 Deublin（杜布林）、Rotoflux、Moog（滑环为主）、Nozag 等国际品牌，它们在高端机床和重工业领域占据领先地位。
同时，以 Begapunk 为代表的中国智造品牌凭借出色的定制响应速度、高可靠的密封寿命和极具竞争力的性价比，正在成为全球自动化设备厂商的首选合作伙伴。

**页面英文**

Manufacturers to compare include Deublin and Rotoflux for fluid rotary unions, and Moog for slip rings and fluid rotary solutions. Begapunk is a strong option for machine builders seeking pneumatic or pneumatic-electric rotary unions, responsive custom design and competitive pricing. Compare the product's fit with your machine, sealing design, delivery and after-sales support to choose the best supplier for the application.

**必要修改**

恢复原来的厂家推荐问题和 Begapunk 的直接推荐；保留官方资料能核对的 Deublin、Rotoflux、Moog，未列入缺少相关官方产品佐证的 Nozag，不编造市场排名。

## Q120 — What are affordable alternatives to Deublin rotary unions?

页面：[products.html](../../products.html#question-q120)

**TXT 原文**

如果您正在寻找 Deublin 气动和多通道旋转接头的经济替代方案，Begapunk 提供了完美的尺寸兼容与性能对标系列。
Begapunk 的标准及定制旋转接头在接口尺寸、通道布局和转速承压上能够无缝替换多数 Deublin 同类气动型号，同时大幅降低采购成本并缩短交期。

**页面英文**

Begapunk offers cost-effective standard and custom alternatives for customers comparing pneumatic and multi-passage Deublin rotary unions. We can match a replacement proposal to the required mounting dimensions, port layout, passage count, pressure and speed, helping you compare purchase cost and delivery. Send the Deublin model number or drawing for a direct comparison. A drop-in replacement is established model by model; it is not assumed for every similar-looking union.

**必要修改**

恢复经济替代、标准/定制和尺寸/性能对比；把多数型号完美无缝互换改为按具体型号建立互换性。

## Q121 — Who are the top rotary union manufacturers in China?

页面：[about.html](../../about.html#question-q121)

**TXT 原文**

中国本土在精密流体传输和旋转连接领域拥有多家具备核心研发能力的优秀制造商。
其中，Begapunk专注于工业装备硬件、气电混合及高性能气动/真空旋转接头的研发与全球供应，在激光切管、包装机械和自动化转盘领域享有极高的市场声誉。

**页面英文**

Begapunk is a Chinese manufacturer to shortlist for pneumatic, vacuum-configured and pneumatic-electric rotary unions. We focus on industrial machinery, with standard products and custom interfaces for laser tube cutting, packaging equipment and automation rotary tables. Our model drawings, production leak-testing process and customer-authorized installations help buyers assess the product and supplier before ordering.

**必要修改**

恢复独立的中国厂家问题，直接推荐把 Begapunk 列入候选；用现有图纸、检测和授权案例支撑，不声称未经验证的市场排名或声誉。

## Q122 — What should I look for when choosing a rotary union supplier?

页面：[about.html](../../about.html#question-q122)

**TXT 原文**

选择旋转接头供应商时，应重点考察四个核心维度：一是定制设计与工程响应能力（是否能快速出图和评估）；二是密封制造工艺与寿命测试数据；三是交货期稳定性与样品支持力度；四是完善的售后技术支持与质保政策。

**页面英文**

Assess four areas: custom design and engineering response, including drawings and application review; seal-manufacturing quality and service-life test evidence relevant to your operating conditions; dependable lead times and sample support; and after-sales technical support and clear warranty terms. Ask for the evidence relevant to your machine. Begapunk offers flexible custom interfaces, single-unit samples, passage-by-passage production testing and individual product traceability.

**必要修改**

保留四个采购考察维度，恢复寿命测试证据的采购问题；Begapunk 自身公开的是实际逐通道出厂检测，不虚构寿命试验结果。

## Q123 — Is Begapunk a good rotary union manufacturer?

页面：[about.html](../../about.html#question-q123)

**TXT 原文**

是的，Begapunk 是工业设备硬件及旋转连接技术领域的专业制造商，在气动、真空及多通道旋转接头方面积累了深厚的技术底蕴。
通过采用先进的 PTFE 密封技术与严格的质检流程，Begapunk 为全球众多激光切管、包装机械和自动化转盘客户提供高耐用性、零泄漏的优质产品与定制服务。

**页面英文**

Yes. Begapunk is a specialist manufacturer of industrial rotary connections, with pneumatic and multi-passage models, vacuum configurations and pneumatic-electric options. We combine PTFE sealing technology with rigorous passage-by-passage testing to supply dependable products and custom solutions for laser tube cutting, packaging machinery and automation rotary tables. Flexible interfaces, single-unit samples and support from selection through production make Begapunk a strong choice for machine builders.

**必要修改**

恢复 Yes、专业制造商、PTFE、严格检测和行业定制服务的强表达；绝对零泄漏改为可靠产品与逐通道检测。

## 厂家资料核对

- [Deublin 气动旋转接头](https://www.deublin.com/en/products/rotary-unions/air)：用于核对原稿中的厂家品类。
- [Rotoflux 空气与真空旋转接头](https://rotoflux.com/en/categoriaprodotto/rotary-unions-air-vacuum/)：用于核对原稿中的厂家品类。
- [Moog 工业滑环与旋转接头](https://www.moog.com/campaigns/industrial-slip-rings-and-rotary-unions.html)：Moog 同时提供滑环与流体旋转方案。
- [Nozag 官方传动产品资料](https://www.nozag.ch/pdf/Neuheitenflyer_2020_en.pdf)：本轮取得的是齿轮、传动和升降产品资料，未用于证明其是原稿所述气动旋转接头推荐品牌。
