caoguangcheng9-lgtm/begapunk-website/audit/technical-repairs/phase-1d/phase-1d-js-repair-report.md

# Begapunk Phase 1D JavaScript Repair Report

## Scope

- Starting commit: `3a018164b9e75efc661d7553bff8cf185b8ea952`
- Branch: `geo-phase-1d-js-repair`
- Formal pages changed: 4
- Pages or assets deleted: 0
- Push/deployment: none

## Root Cause

Each page retained a valid menu/header prefix and the tail of a previously complete copy-link implementation, but the opening portion of that function had been removed. The remaining standalone `, 2000);`, closing callback, fallback branch, and references to `btn`/`url` made the entire inline script syntactically invalid. Because parsing failed before execution, otherwise valid menu and header handlers in the same block also never ran.

The repair did not merely delete the orphaned line. It reconstructed a complete function so the surviving fallback and temporary feedback behavior again form a coherent feature, while also making Clipboard API rejection explicit and safe.

## Reference Implementation

- Reference page: `blog-rotary-joint-leaking.html`
- Reference location: final inline script, lines 595-636 at the starting commit.
- Basis: it uses the same `mobileToggle`, `mainNav`, `.header`, Clipboard API, textarea fallback, `Copied` feedback, and two-second restoration pattern.
- DOM differences: the first three repaired pages use `mainNav.active` and retain header scrolling; `blog-rotary-union-seal-types.html` uses `mainNav.mobile-open` and did not previously contain header-scroll behavior. None of the four pages currently contains an overlay or a user-facing Copy Link button, so neither was added.

## Per-page Repair

| Page | Original location | Before | After | Header scroll |
|---|---|---|---|---|
| `blog-rotary-joint-selection.html` | 600-635; error near 619 | Orphaned copy callback tail | Reconstructed guarded menu, header scroll, and complete copy function | Pass |
| `blog-rotary-joint-materials.html` | 593-628; error near 612 | Orphaned copy callback tail | Reconstructed guarded menu, header scroll, and complete copy function | Pass |
| `blog-threaded-vs-flange.html` | 580-615; error near 599 | Orphaned copy callback tail | Reconstructed guarded menu, header scroll, and complete copy function | Pass |
| `blog-rotary-union-seal-types.html` | 661-683; error near 667 | Orphaned copy callback tail | Reconstructed guarded `mobile-open` menu and complete copy function | Not applicable by original design |

## JavaScript Validation

- Modified inline scripts parsed by Node `vm.Script`: 4 / 4.
- Remaining `Unexpected token` errors: 0.
- Orphaned `, 2000);` fragments: 0.
- Browser page-load syntax/runtime errors after final repair: 0.
- Details: `js-syntax-validation.csv`.

## Browser Functional Acceptance

### Desktop

- All four pages loaded with their article content, title, H1, images, and links intact.
- Broken images: 0.
- Horizontal layout overflow: 0 pages.
- The three applicable pages added header shadow below the scroll threshold and removed it at the top.

### Mobile menu

- Viewport: 390 x 844.
- Pages passed: 4 / 4.
- Each page completed three open/close cycles.
- Navigation state, button `active` state, and `aria-expanded` remained synchronized; final state was closed.
- No overlay or Escape handler existed in the target DOM/baseline, so none was invented.

### Copy Link

- The current pages do not contain a visible Copy Link button. To avoid changing visible content, the function was tested with a temporary browser-only button that was removed after each test.
- Pages passed: 4 / 4.
- A real click copied the current local page URL, displayed `Copied`, tolerated a rapid second click, and restored `Copy Link` after approximately two seconds.
- Clipboard/API failure paths are explicit: fallback is attempted and unrecoverable failure is logged rather than silently swallowed.

## Regression Protection

- Visible page body text: unchanged on all four pages.
- `title`, meta description, and H1: unchanged.
- JSON-LD: unchanged on all four pages; all site JSON-LD remains parseable.
- Product Schema: unchanged across the site.
- Product parameters, company data, certification claims, and delivery content: unchanged.
- HTML: pass (51 pages).
- JSON-LD: pass (57 blocks).
- Local links/images/downloads: pass (0 broken).
- Sitemap: unchanged; 48 URLs.
- Existing fact conflicts: 17, unchanged.
- Other pre-existing formal files: hash-unchanged.
- Deleted files: 0.

No page, image, PDF, or download file was deleted. No page正文 or SEO content was modified.
