caoguangcheng9-lgtm/begapunk-website/audit/technical-repairs/deployment-ga4-20260714-1448.md

# Begapunk GA4 production deployment - 2026-07-14

## Deployment identity

- Production content commit: `7e33e7f` (`Fix GA4 consent and lead tracking`)
- Branch: `release-phase-2b-predeploy-repair`
- Deployment completed: 2026-07-14 14:48 Asia/Tokyo (13:48 server time, UTC+8)
- Production document root: `/www/wwwroot/47.252.73.192`
- Release archive: `/www/releases/ga4-20260714-144643-7e33e7f/begapunk-ga4-20260714-142847-7e33e7f.zip`
- Release directory: `/www/releases/ga4-20260714-144643-7e33e7f`
- Release archive SHA-256: `851A84A5E301A14C46D4DFF2DE95BC12CA07F40140D00DC634F0AAE63AD94FEF`

## Rollback material

- Full production-root backup: `/www/backups/begapunk-ga4-20260714-144643.tar.gz`
- Backup size: 24 MB
- Backup SHA-256: `18FF080E7E11D262FE312808F4969EC5C88BE660D0A9CEB2C322E43A6197E5D5`
- The backup was created before any production file was replaced.

## Production files deployed

- `contact.html`
- `privacy.html`
- `js/analytics.js`

Production-only `.env`, `PHPMailer/`, `.well-known/`, all other document-root files, and server configuration were not changed. The untracked local `catalog-project/` workspace was not staged or modified.

## Deployed file hashes

- `contact.html`: `C9A016BAF2B6A30C6BCF58ECA93DF9CA39C3A7D1F123C96DA68E72540E2B6417`
- `privacy.html`: `E1223411679F22DBC445D0CBAB85F31CCD52034134EB315CE1F198623495A6D0`
- `js/analytics.js`: `194CF07C57C4412989E0BA172BE226BE584E3B2FA0DE6E6B1E522E32F09B6885`

All three live files retain owner/group `www:www` and mode `0644`.

## Verification results

- The server release archive SHA-256 matched the local package.
- The three extracted staging-file hashes matched the local source files.
- The three live production-file hashes matched the local source files after atomic replacement.
- Nginx configuration syntax test passed.
- Live `contact.html`, `privacy.html`, `js/analytics.js`, homepage, products page, and thank-you page returned HTTP 200.
- Public response hashes for all three deployed files matched the local source files.
- Inquiry endpoint GET health check returned the expected HTTP 405 response.
- Production consent behavior passed: GA4 was not loaded before consent; default analytics consent was denied; accepting loaded `G-D4FZF37Z07` once; declining disabled GA and cleared GA cookies; resetting restored the choice banner.
- Opening `thank-you.html` directly did not emit `generate_lead`.
- A confirmed inquiry-success signal emitted exactly one `generate_lead` event.
- Production browser checks reported no JavaScript page errors.
- A real POST form test returned HTTP 200 and `{"success":true,"message":"Email sent successfully."}`. The submitted content was clearly marked `[TEST]`; mailbox receipt confirmation is pending.

## Rollback outline

If rollback is required, extract the full backup outside the live root, restore the three files listed above to `/www/wwwroot/47.252.73.192`, preserve `www:www` ownership and `0644` mode, then repeat the Nginx and public-response checks.
