caoguangcheng9-lgtm/begapunk-website/audit/technical-repairs/release-phase-2b/phase-2b-repair-report.md

# Begapunk Release Phase 2B 修复记录

## 定位结论

Node 对 51 个 HTML 页面的 54 个内联脚本及 2 个本地 JavaScript 文件进行解析，确认两个页面存在同型语法错误：

- `blog-rotary-joint-installation-mistakes.html`：修复前第 515 行
- `blog-seal-replacement.html`：修复前第 999 行

完整错误为 `SyntaxError: Unexpected token ','`。两处均位于页面底部内联脚本，根因是 `copyLink(btn, url)` 函数前半段被截断，只保留了 `, 2000);`、Promise 回调尾部和 fallback 分支。

源文件与第一版发布包对应文件 SHA-256 一致，因此不是构建或复制差异。修复按站内正常同型页面恢复缺失函数结构，没有删除功能。

## 第一版漏检原因

第一版静态 HTML 验证器解析 HTML 和 JSON-LD，但没有把普通内联脚本送入 JavaScript 解析器。51 页面 HTTP 200 只证明文件可访问，不会捕获脚本编译失败。浏览器代表页抽样发现了安装文章的错误，但没有逐页隔离检查控制台，因此未识别 `blog-seal-replacement.html` 的同型错误。

## 修改边界

仅修改上述两个页面的损坏内联脚本，并新增本目录审计资料。未修改页面正文、产品参数、PDF、图片、title、meta description、H1、JSON-LD、CSS、sitemap、robots.txt、llms.txt、PHP 业务逻辑或 17 组事实冲突。

## PHP 状态

本机未发现可信 PHP 运行时。替代静态检查通过，但未完成原生 PHP 语法验证；正式部署前仍需在服务器运行 `php -l`。
