caoguangcheng9-lgtm/begapunk-website/downloads/BP-10P-0001.pdf

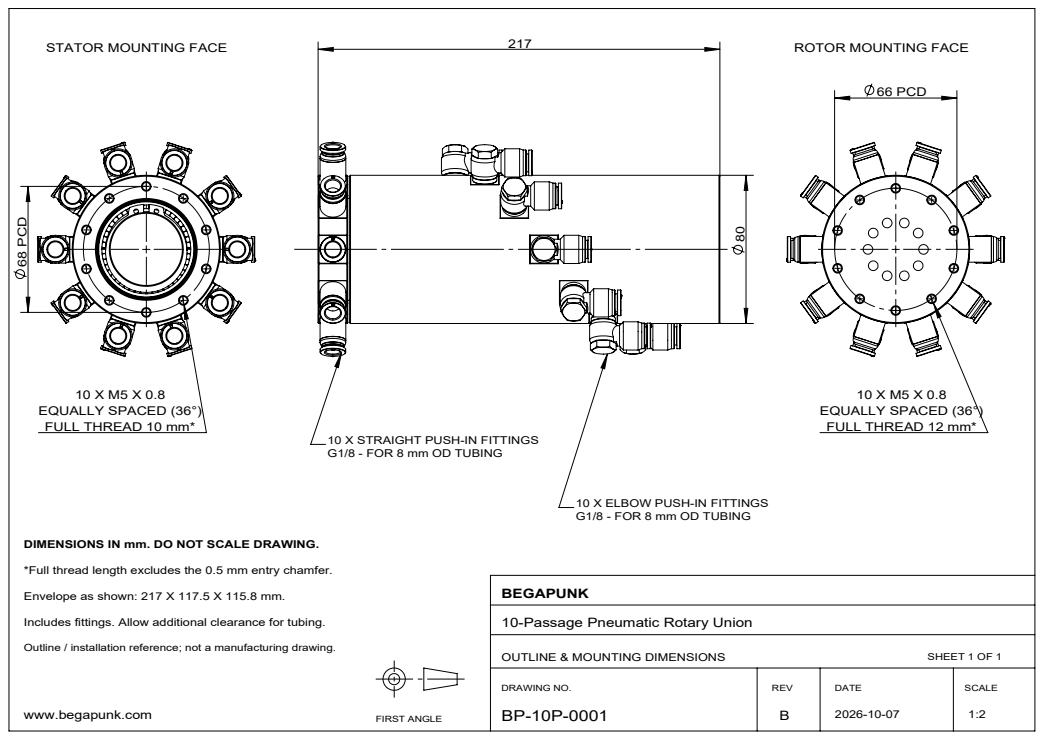
[picture p172: page 1]
68 PCD; 66 PCD; STATOR MOUNTING FACE; ROTOR MOUNTING FACE; OUTLINE & MOUNTING DIMENSIONS; SHEET 1 OF 1; DRAWING NO. BP-10P-0001; REV B; DATE; SCALE; 1:2 FIRST ANGLE

EQUALLY SPACED (36°)
FULL THREAD 10 mm*

FULL THREAD 12 mm*

10 X STRAIGHT PUSH-IN FITTINGS
G1/8 - FOR 8 mm OD TUBING

10 X ELBOW PUSH-IN FITTINGS

DIMENSIONS IN mm. DO NOT SCALE DRAWING.
*Full thread length excludes the 0.5 mm entry chamfer.
Envelope as shown: 217 X 117.5 X 115.8 mm.
Includes fittings. Allow additional clearance for tubing.

BEGAPUNK
10-Passage Pneumatic Rotary Union

Outline / installation reference; not a manufacturing drawing.

www.begapunk.com
