caoguangcheng9-lgtm/begapunk-website/downloads/BP-2P-95-0005.pdf

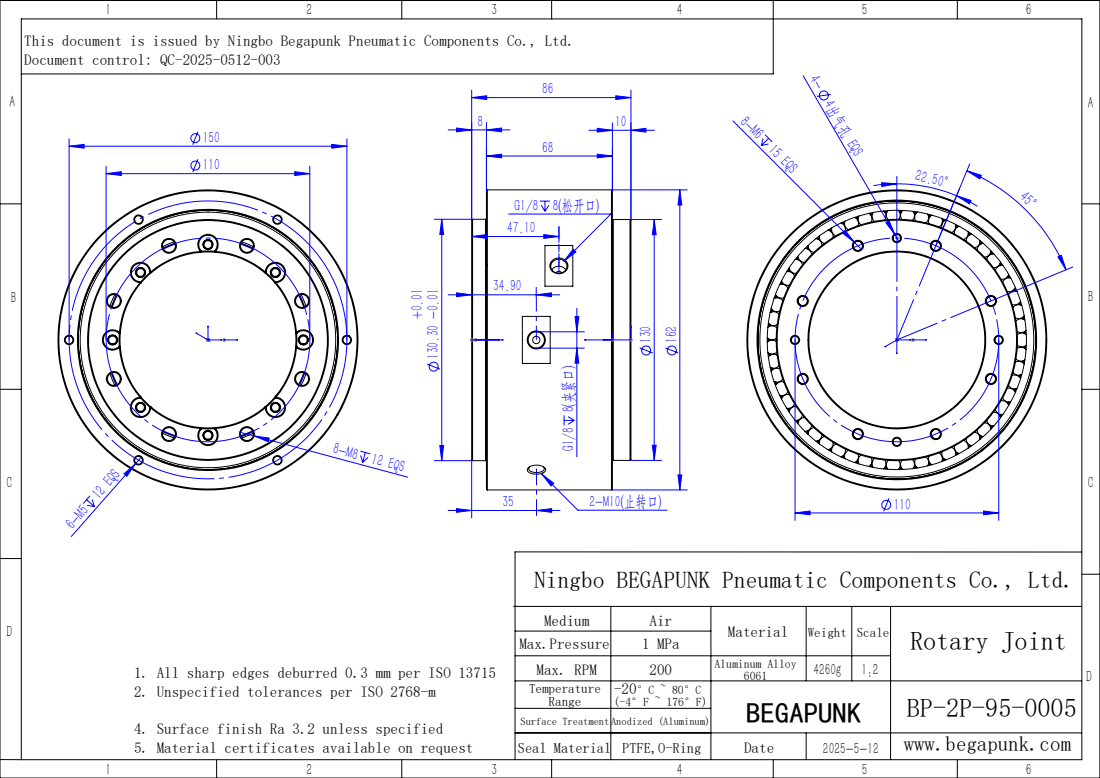
[picture p174: page 1]
12 EQS; 8-M8 12 EQS; G1/8 8(夹紧口); G1/8 8(松开口); 2-M10(止转口); 4出气孔 EQS; 15 EQS

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

Ningbo BEGAPUNK Pneumatic Components Co., Ltd.

Medium | Air | Material | Weight | Scale | Rotary Joint
Max.Pressure | 1 MPa
Max. RPM | 200 | Aluminum Alloy 6061 | 4260g | 1:2
Temperature Range | -20°C ~ 80°C (-4°F ~ 176°F) | BEGAPUNK | | | BP-2P-95-0005

1. All sharp edges deburred 0.3 mm per ISO 13715
2. Unspecified tolerances per ISO 2768-m

Surface Treatment Anodized (Aluminum)
Seal Material | PTFE,O-Ring | Date | 2025-5-12 | | www.begapunk.com

4. Surface finish Ra 3.2 unless specified
5. Material certificates available on request
