caoguangcheng9-lgtm/begapunk-website/downloads/BP-1P-0003.pdf

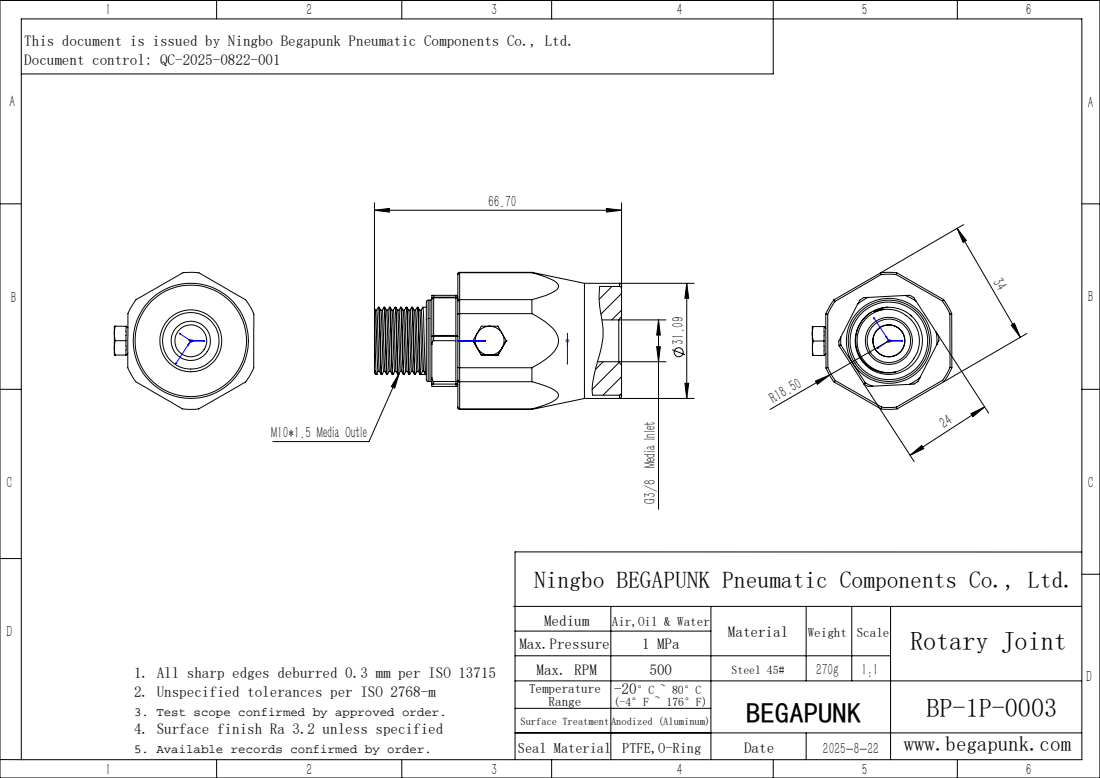
[picture p175: page 1]
G3/8 Media Inlet; M10*1.5 Media Outle

This document is issued by Ningbo Begapunk Pneumatic Components Co., Ltd. Document control: QC-2025-0822-001

Ningbo BEGAPUNK Pneumatic Components Co., Ltd.

Medium | Air,Oil & Water | Material | Weight | Scale | Rotary Joint
Max.Pressure | 1 MPa
Max. RPM | 500 | Steel 45# | 270g | 1:1
Temperature Range | -20°C ~ 80°C (-4°F ~ 176°F) | BEGAPUNK | | | BP-1P-0003

1. All sharp edges deburred 0.3 mm per ISO 13715
2. Unspecified tolerances per ISO 2768-m
3. Test scope confirmed by approved order.
4. Surface finish Ra 3.2 unless specified
5. Available records confirmed by order.

Surface Treatment Anodized (Aluminum)
Seal Material | PTFE,O-Ring | Date | 2025-8-22 | | www.begapunk.com
