caoguangcheng9-lgtm/begapunk-website/downloads/BP-1P-0006.pdf

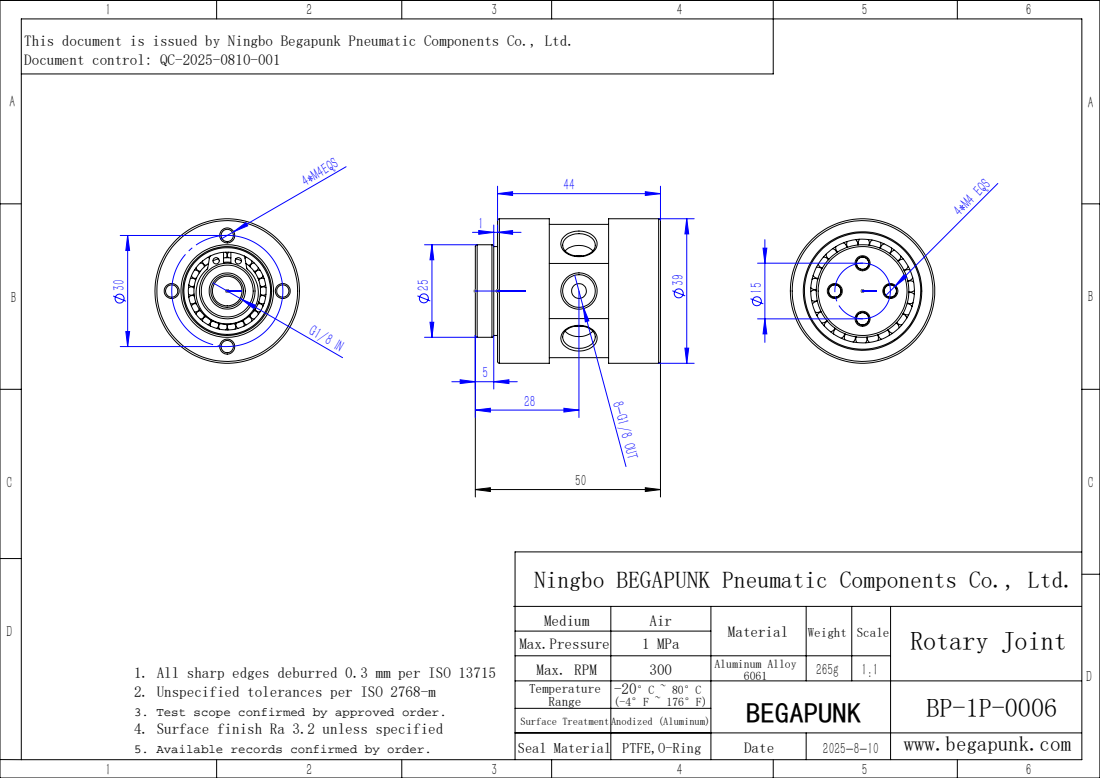
[picture p176: page 1]
4*M4EQS; 8-G1/8 OUT; 4*M4 EQS

This document is issued by Ningbo Begapunk Pneumatic Components Co., Ltd. Document control: QC-2025-0810-001

Ningbo BEGAPUNK Pneumatic Components Co., Ltd.

Medium | Air | Material | Weight | Scale | Rotary Joint
Max.Pressure | 1 MPa
Max. RPM | 300 | Aluminum Alloy 6061 | 265g | 1:1
Temperature Range | -20°C ~ 80°C (-4°F ~ 176°F) | BEGAPUNK | | | BP-1P-0006

1. All sharp edges deburred 0.3 mm per ISO 13715
2. Unspecified tolerances per ISO 2768-m
3. Test scope confirmed by approved order.
4. Surface finish Ra 3.2 unless specified
5. Available records confirmed by order.

Surface Treatment Anodized (Aluminum)
Seal Material | PTFE,O-Ring | Date | 2025-8-10 | | www.begapunk.com
