caoguangcheng9-lgtm/begapunk-website/downloads/BP-2P-0002.pdf

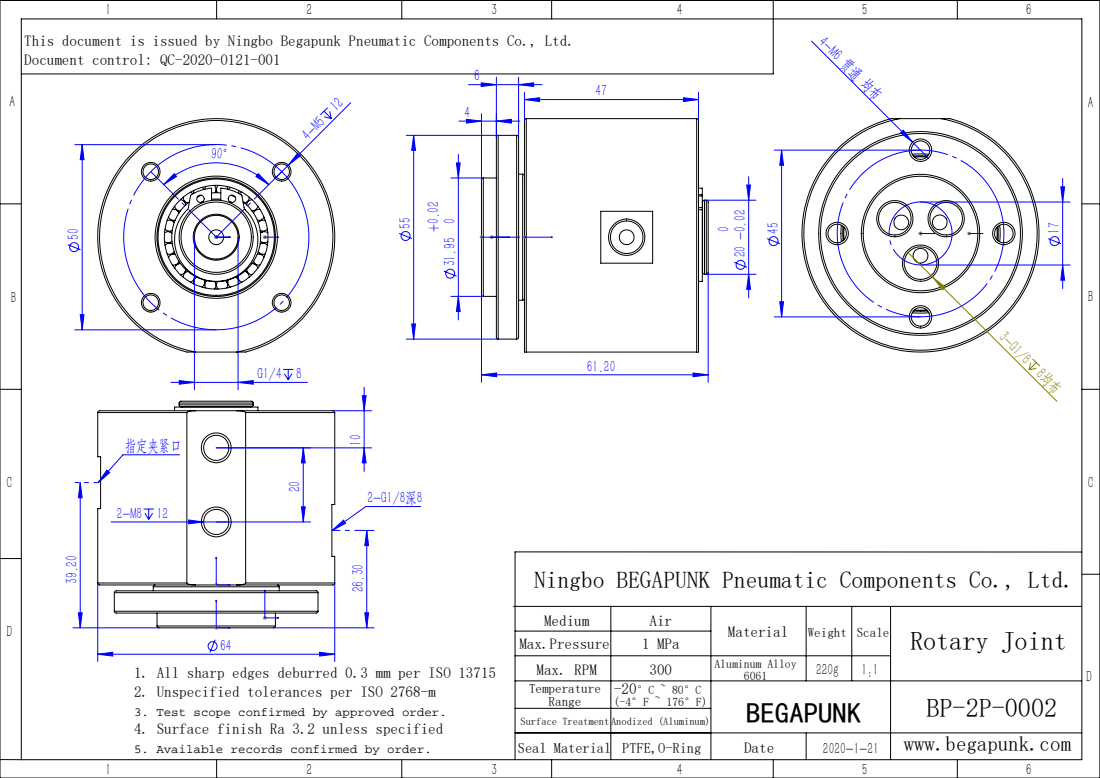
[picture p178: page 1]
指定夹紧口; Aluminum Alloy 6061; Max. RPM

This document is issued by Ningbo Begapunk Pneumatic Components Co., Ltd. Document control: QC-2020-0121-001

Ningbo BEGAPUNK Pneumatic Components Co., Ltd.

Medium | Air | Material | Weight | Scale | Rotary Joint
Max.Pressure | 1 MPa
Temperature Range | -20°C ~ 80°C (-4°F ~ 176°F) | BEGAPUNK | BP-2P-0002

1. All sharp edges deburred 0.3 mm per ISO 13715
2. Unspecified tolerances per ISO 2768-m
3. Test scope confirmed by approved order.
4. Surface finish Ra 3.2 unless specified
5. Available records confirmed by order.

Surface Treatment Anodized (Aluminum)
Seal Material | PTFE,O-Ring | Date | 2020-1-21 | www.begapunk.com
