caoguangcheng9-lgtm/begapunk-website/downloads/BP-2P-50-0001.pdf

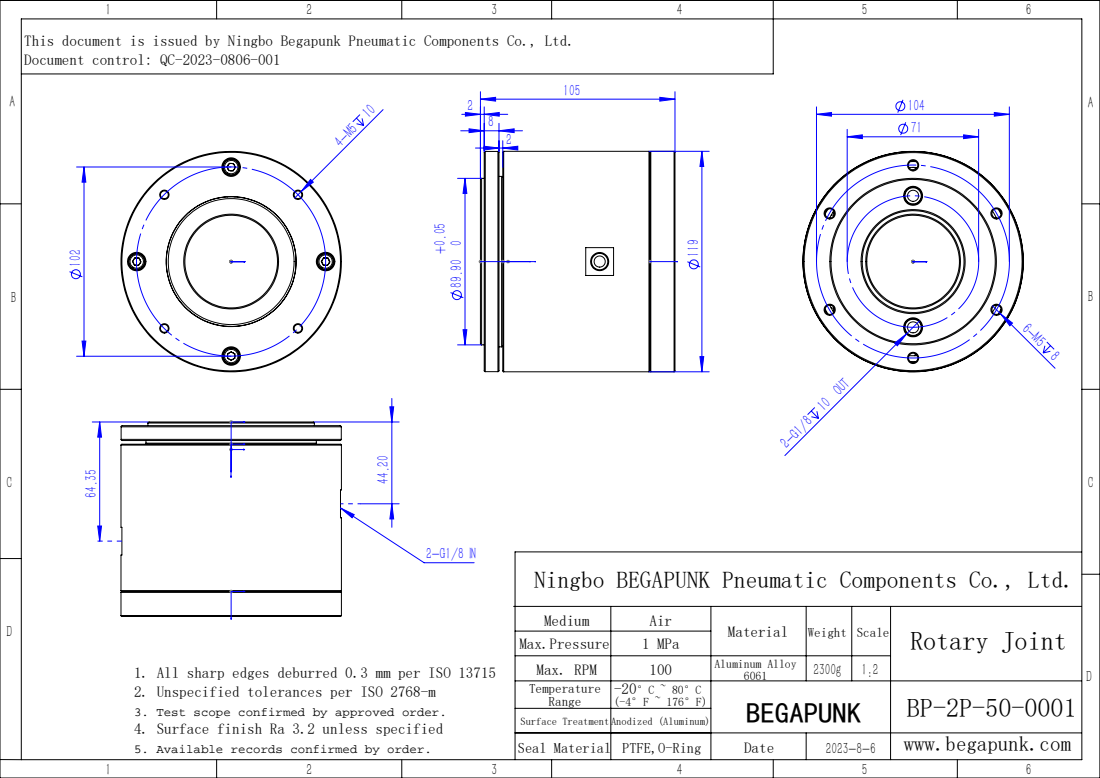
[picture p181: page 1]
10 OUT

This document is issued by Ningbo Begapunk Pneumatic Components Co., Ltd. Document control: QC-2023-0806-001

Ningbo BEGAPUNK Pneumatic Components Co., Ltd.

Medium | Air | Material | Weight | Scale | Rotary Joint
Max.Pressure | 1 MPa
Max. RPM | 100 | Aluminum Alloy 6061 | 2300g | 1:2
Temperature Range | -20°C ~ 80°C (-4°F ~ 176°F) | BEGAPUNK | | | BP-2P-50-0001

1. All sharp edges deburred 0.3 mm per ISO 13715
2. Unspecified tolerances per ISO 2768-m
3. Test scope confirmed by approved order.
4. Surface finish Ra 3.2 unless specified
5. Available records confirmed by order.

Surface Treatment Anodized (Aluminum)
Seal Material | PTFE,O-Ring | Date | 2023-8-6 | | www.begapunk.com
