caoguangcheng9-lgtm/begapunk-website/downloads/BP-3P-0006.pdf

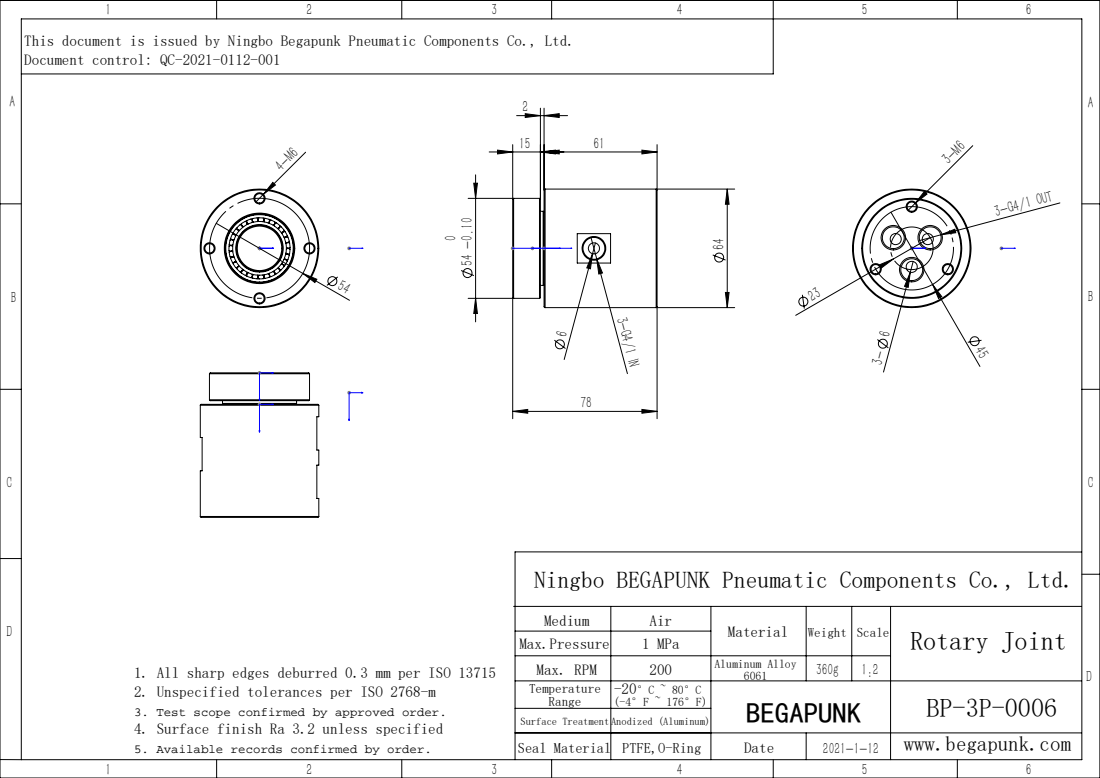
[picture p183: page 1]
3-G4/1 OUT

This document is issued by Ningbo Begapunk Pneumatic Components Co., Ltd. Document control: QC-2021-0112-001

Ningbo BEGAPUNK Pneumatic Components Co., Ltd.

Medium | Air | Material | Weight | Scale | Rotary Joint
Max.Pressure | 1 MPa
Max. RPM | 200 | Aluminum Alloy 6061 | 360g | 1:2
Temperature Range | -20°C ~ 80°C (-4°F ~ 176°F) | BEGAPUNK | | | BP-3P-0006

1. All sharp edges deburred 0.3 mm per ISO 13715
2. Unspecified tolerances per ISO 2768-m
3. Test scope confirmed by approved order.
4. Surface finish Ra 3.2 unless specified
5. Available records confirmed by order.

Surface Treatment Anodized (Aluminum)
Seal Material | PTFE,O-Ring | Date | 2021-1-12 | | www.begapunk.com
