caoguangcheng9-lgtm/begapunk-website/downloads/BP-8P-0001.pdf

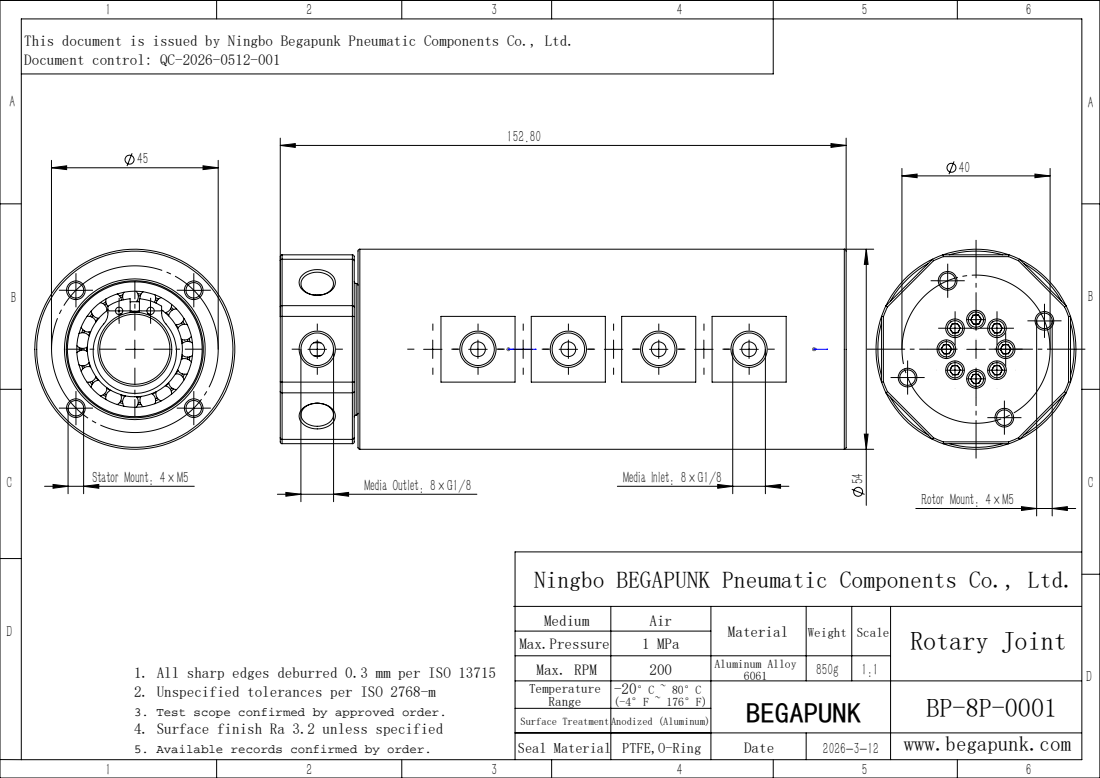
[picture p186: page 1]
Stator Mount: 4×M5; Media Inlet: 8×G1/8; Media Outlet: 8×G1/8; Rotor Mount: 4×M5

This document is issued by Ningbo Begapunk Pneumatic Components Co., Ltd. Document control: QC-2026-0512-001

Ningbo BEGAPUNK Pneumatic Components Co., Ltd.

Medium | Air | Material | Weight | Scale | Rotary Joint
Max.Pressure | 1 MPa
Max. RPM | 200 | Aluminum Alloy 6061 | 850g | 1:1
Temperature Range | -20°C ~ 80°C (-4°F ~ 176°F) | BEGAPUNK | | | BP-8P-0001

1. All sharp edges deburred 0.3 mm per ISO 13715
2. Unspecified tolerances per ISO 2768-m
3. Test scope confirmed by approved order.
4. Surface finish Ra 3.2 unless specified
5. Available records confirmed by order.

Surface Treatment Anodized (Aluminum)
Seal Material | PTFE,O-Ring | Date | 2026-3-12 | | www.begapunk.com
