caoguangcheng9-lgtm/begapunk-website/(commit log)

2026-06-02 Initial commit: upload Begapunk website source
    [BP-1P-0003_参数表.xlsx, Begapunk_A4_Horizontal_R2000.dxf, Begapunk_A4_Horizontal_Template.dxf]
2026-06-04 Improve contact page as rotary joint RFQ
2026-06-04 Add application landing pages
2026-06-21 Audit: add initial GEO assessment reports
    [claims-needing-evidence.csv, duplicate-content-groups.csv, site-inventory.csv]
2026-06-21 Audit: document pre-GEO workspace baseline
    [workspace-file-classification.csv]
2026-06-21 GEO Phase 1A: fix schema and catalog indexing issues
    [phase-1-changed-pages.csv, phase-1-high-risk-claims.csv]
2026-06-21 GEO Phase 1B: adjudicate claims and prepare evidence review
    [cross-page-fact-conflicts.csv, root-claims-adjudication.csv]
2026-06-21 GEO Phase 1C-A: remove unsupported absolute claims
    [phase-1c-a-changes.csv, rejected-phase-1b-drafts.csv]
2026-06-21 GEO Phase 1C-A.1: preserve engineering meaning and verify rendering
    [semantic-loss-review.csv, visible-content-flag-review.csv]
2026-06-21 GEO Phase 1C-A.2: restore contextual maintenance guidance
    [phase-1c-a2-changes.csv, pre-existing-js-errors.csv, unverified-context-labels.csv]
2026-06-21 Fix broken inline scripts on technical articles
    [js-syntax-validation.csv, phase-1d-js-changes.csv]
2026-06-21 Audit product fact conflicts for manual resolution
    [product-fact-conflicts.csv]
2026-06-23 Fix final pre-deployment JavaScript error
    [js-repair-evidence.csv, php-static-review.csv, sensitive-candidate-review.csv, unknown-files-review.csv]
2026-07-12 Fix product parameters to match approved drawings
    [catalog-data.csv]
2026-07-17 Finalize performance and case studies repairs
2026-07-17 Fix local and production language switching
2026-07-27 Fix PowerShell deployment tag command
2026-07-30 Harden public claims and release safeguards
    [BP-1P-0003_参数表.xlsx, Begapunk_A4_Horizontal_R2000.dxf, Begapunk_A4_Horizontal_Template.dxf]
2026-07-31 [Hardening] Establish AI-ready website quality foundation (#6)
    * Hardening AI-ready website quality foundation
    * Fix release checksum line ending handling
    ---------
    [Begapunk_A4_Horizontal_R2000.dxf, Begapunk_A4_Horizontal_Template.dxf]
2026-07-31 Establish Aida-Codex human relay collaboration model (#7)
2026-08-01 Improve pre-deployment localization quality (#20)
    [i18n-build-missing-translations-20260801.csv, localization-glossary-20260801.csv]
2026-08-07 Add BP-2P-95 pneumatic chuck application case draft
2026-08-07 Integrate BP-2P-95 pneumatic chuck application case
2026-08-07 Rework four-language case center with verified installations
2026-08-07 Align laser tube application pages with verified models
2026-08-28 Finalize multilingual buyer experience and inquiry flow
2026-08-30 Add bar/psi to drawing-backed product pressure copy and resync pages.
    Keep first-view specs, JSON-LD, search, and long-form bodies on the same localized pressure string.
2026-08-30 Sync i18n catalog coverage and hydraulic metadata for deploy.
    Harvest missing translations from localized HTML, publish the bottle-capping search record, and keep laser WebPage descriptions on BP-2P-08-0001 and BP-3P-0004.
2026-08-30 Keep drawing-backed JSON-LD and check laser copy on the visible application entry.
    Restores generated product structured data for BP-2P-08-0001 and BP-3P-0004 so metadata verify matches the i18n renderer.
2026-08-30 Restore drawing-backed long-form copy on BP-2P-08-0001 and BP-3P-0004.
    Keeps generated JSON-LD from the i18n renderer while putting laser/chuck facts back in the visible application entry.
2026-08-30 Keep catalog filter codes on channel while labels stay Passage/Weg/流路/проход.
2026-09-01 Add Rotary Joints keyword coverage across hub pages and multilingual SEO
    Update title, meta, H1, and og/twitter on index, products, product-comparison and applications to include the Rotary Joint(s) synonym (union first). Sync localized SEO translations for de/ja/ru and regenerate source catalog and search index. Align applications CollectionPage structured-data name.
2026-09-01 Add related-model internal links on top content pages
    Add contextual 'Related models' links from high-traffic application pages and blog posts to the specific product pages they describe, so authority and readers flow to commercial product pages. Sync multilingual SEO and regenerate catalog and search index.
2026-09-01 Sync related-model internal links to localized pages
    Add the multilanguage versions of the related-model internal links on application pages and blog posts, using the approved de/ja/ru wording, and regenerate the localized search indexes.
2026-09-02 feat: public STEP download for BP-3P-0004 + SEO/GEO signals
    - Allow reviewed STEP files as public downloads (PDF+STEP allowlist)
    - BP-3P-0004 (en/de/ja/ru): replace Request STEP File with Download 3D Model (.step)
    - Add Product JSON-LD '3D CAD model' (STEP AP214) property
    - Add localized meta-description download hook
    - Include all approved engineering files (PDF+STEP) in sitemap.xml
    - Update generation/validation scripts to be data-driven on public-step presence
    - Add AI-assisted review record for the localized change
    [BP-3P-0004.step]
2026-09-02 feat: one-page catalog, public STEP downloads, and four-model bulk prices
    [BP-1P-0003.step, BP-1P-0006.step, BP-2P-0001.step, BP-2P-0002.step, BP-2P-08-0001.step, BP-2P-130-0001.step, BP-2P-16-0001.step, BP-2P-30-0001.step]
2026-09-03 test: require current product catalog link
2026-09-03 chore: remove non-public source artifacts
    [BP-1P-0003_参数表.xlsx, Begapunk_A4_Horizontal_R2000.dxf, Begapunk_A4_Horizontal_Template.dxf]
2026-09-18 Unify multilingual footers and improve product discovery
    Preserve mobile footer disclosures across five languages, add catalog selection paths, align leakage-guide titles, and improve three English search landing pages. Reconcile localized review evidence against the deployed baseline.
    Validation: 59 local release gates and 570 responsive navigation checks passed. Canonical Linux and production delivery/release evidence remain separate gates. Excludes pending legacy PDF routing changes.
2026-10-07 Publish BP-10P-0001 and multilingual air hose twisting guide
    [BP-10P-0001.step]
2026-10-23 Correct BP-2P-08 mounting specifications and surface ten-passage model
2026-10-24 Clarify two-passage bore selection and CNC pneumatic criteria
2026-10-31 Add a manual repair path for a release that lost manifest integrity
    There was no sanctioned way to undo a hotfix applied directly to a release
    directory. That left the deploy permanently blocked, because the workflow
    correctly refuses to switch away from a rollback target whose manifest no
    longer verifies.
    This workflow is manual-only, takes a required reason, restores the handler
    from the backup taken before the hotfix, and proves the manifest verifies
    again before reporting MANIFEST_OK. It touches exactly one file and cannot
    be triggered by a push.
    Gates are unchanged: audit:policy:verify still reports 16 controls and 58
    gate references aligned.
